martinasobotkova5/my_data_projects/README.md

# my_data_projects
## List of my projects
- Spotify music
- Hockey scrapping
- E6 – infiltrace do zmrzlé zeminy: revize schématu, výpočty a výkresy (`e6_frozen_infiltration/`)
- E7 – zatěžovací zkoušky při mrznutí a tání: dvě varianty, rám, cela PETG-CF (`e7_frost_heave_load/`)
