martinasobotkova5/my_data_projects/e7_frost_heave_load/README.md

# E7: zatěžovací zkoušky zeminy při mrznutí a tání

Vzorek ⌀100 × 100 mm (vnitřní) v plné cele z PETG-CF vytištěné 3D tiskem v jednom kuse, v truhlicovém mrazáku z E6 s programovatelným regulátorem. V obou variantách je **stejný vzorek** (nenasycený písek) a stejná cela. Varianta A má přitížení **závažím** (ocelové kotouče, max. 25 kPa) a měří tlaky uvnitř písku. Varianta B je **bez zatížení** a měří zdvih, sednutí a deformace po vrstvách mezi mrznutím a táním.

## ★ Aktuální návrh: varianta C, měření deformace 1 + 2 (výkresy V01–V05)

**Statika, CR850 a postup (9. 11. 2026):** rám ověřen na únosnost (rezerva > 20×), rozhoduje stabilita → podélníky 320 mm, nohy ±140 (`vypocty.md` §17); datalogger CR850 – plán kanálů §18; rizika měření a postup přípravy, vložení a výměny vzorku v `postup_zkousky.md` (nové tištěné pomůcky P09 středicí víčko, P10 stěrka, P11 parkovací vidlice); poptávka rámu u ENPRAG v `poptavka_ramu.md`.

**Revize B3 (9. 11. 2026):** celý rám z hliníkových T-profilů drážka 8 řezaných na délku – 2 podélníky 40×40, příčka 40×80 (nese 3 podložky G10), 2 sloupy 40×80, horní příčník 40×80 s jediným otvorem ⌀14; pouzdro ložiska visí pod příčníkem, spoje úhelníky a vkládací T-matice. Laserem řezané desky L01/L02 odpadly. Výkresy profilů T01–T04 ve `vyroba/vykresy`.

**Revize B2 (27. 10. 2026):** sestava jen z koupených, laserem řezaných a 3D tištěných dílů (bez obrábění) – objednávka po obchodech a postup sestavení v `objednavka.md`, výrobní list V06, DXF v `vyroba/laser`, STL v `vyroba/tisk`.

**Revize B (27. 10. 2026, podle posudku měření `E7_review.pdf`):** cela tištěná vcelku ⌀240 × 200 s izolací (+40 mm stěna a dno z nízké výplně,
3 podložky G10 v kapsách dna → mrznutí shora), LVDT a referenční terčík kamery na sloupku z Invaru, vodicí tyč z Invaru v kluzném pouzdře
igus drylin, laser pod 66° vedle horního příčníku, 200 mm od povrchu (DOE253 3,1°/31°: čáry po 11,9 mm, 111 mm dlouhé, bez stínu límce), RPi 5 v boxu kamery (snímky podle hodin NTP),
čidlo vzduchu 109 povinně, ventilátor, SHT45, vážení cely. Mezera pod příčníkem 200 → 160 mm, celková výška beze změny.
Pt100 jde ze stejné strany jako TDR a nasedá uprostřed přímo nad horní tyčku (bod M v jednom místě, povrch volný).
Rozhodnuto 9. 11. 2026: nasycení vzorku Sr = 0,5 (θ ≈ 0,19) → zdvih nanejvýš desítky µm, měří se hlavně sednutí při tání; Pt100 osa 3,5 mm nad horní tyčkou, hrot 30 mm od stěny. Výpočty §15 v `vypocty.md`,
simulace `src/sim_thaw.py` (`--bare` = původní cela pro srovnání), nákup `purchase_list.md` / `nakup_cidel.md`.

| list | obsah |
|---|---|
| **V01** | sestava C: Al rám jen vede mrtvou váhu na částečném pístu ⌀50, volný povrch, tabulka zatížení, díly |
| **V02** | měření deformace: (1) kamera + vícečárový laser 11 čar → mapa výšek **celého povrchu**, (2) LVDT na zátěži; vyhodnocení a postup |
| **V03** | tištěná cela ⌀160 s bodem M (CS645, vlákno, Pt100 v mezikruží mimo laser) |
| **V04** | čidla ke koupi, zapojení CR850, ceny (≈ 1,3–2,1 tis. €) |
| **V05** | rig C v mrazáku, kontrola výšky |

- Žádné tlakové snímače ani kotvy – zatížení je známá mrtvá váha, deformace se měří jen (1) a (2).
- 3D: `3d/E7_V01_variant_C.step` (+ díly `3d/parts_V01_variant_C/`), `3d/E7_V03_cell.step`, `3d/E7_V05_freezer_layout.step`; CAD cely `cad/E7_V04_cell.dxf`.
- Starší varianty A a B: `vykresy/archiv/`, `3d/archiv/` (kapitoly 1a–8 níže popisují i je).

Regenerace výkresů: `cd src && python vykresy_c.py` (aktuální sada), `python vykresy.py` (archiv).

| soubor | obsah |
|---|---|
| `vykresy/E7_drawings.pdf` | 9 listů A3, anglicky (V09 = varianta C, kombinace): V01 přehled A a B · V02 A s víkem na táhlech · V03 A s Al rámem · V04 tištěná cela + bod M · V05 B s kotvami · V06 B otevřený povrch (kamera + laser) · V07 čidla a CR1000 · V08 mrazák |
| `cad/E7_V04_cell.dxf` | **CAD výkres cely ⌀160 se všemi kótami** (DXF, kóty jako DIMENSION, vrstvy OUTLINE/DIM/SENSOR…; tisk A3 1 : 1,5) + PDF/PNG náhled |
| `3d/*.step` | 3D sestavy pro Onshape: varianta A, varianta B, samotná cela, obě v mrazáku (+ STL a PNG náhledy) |
| `vypocty.md` | zatížení, očekávané deformace, rozlišení LVDT, teplotní chyba stojanu, napětí v cele, závaží |
| `src/params.py` | všechny rozměry a předpoklady |
| `src/sensors.py` | výběr čidel a plán kanálů (varianta C: CR850, §18 v `vypocty.md`) |
| `src/vykresy.py`, `src/vypocty.py`, `src/model3d.py`, `src/render3d.py` | generátory |

> Kapitoly 2–3 a 6–8 popisují i starší řešení varianty A (závaží, vícekroužková/plná cela); aktuální návrh je v kap. 1a–1c, 4a, 5, 5a a na výkresech V01–V08.

Regenerace: `cd src && python cad_cell.py && python vykresy.py && python vypocty.py > ../vypocty.md && python model3d.py && python render3d.py`

---

### 3D animace mrznutí a tání (web/)

`web/E7_thaw_3d.html` – hýbající se 3D model sestavy C (otevřít v prohlížeči): teplota na řezu vzorkem a na volném
povrchu kolem pístu, fronta tání (0 °C), podíl ledu, zdvih povrchu a pístu (zvětšeně), pohled kamery RPi.
Data z `src/sim_thaw.py` (osově souměrné vedení tepla, entalpická metoda; vlastnosti písku a cely odhadnuté, viz hlavička
skriptu). Program: +10 °C → 0 h vzduch −10 °C → 24 h vzduch +10 °C. Výsledek modelu: vzorek zmrzne za ≈ 9 h, roztaje
≈ 9 h po přepnutí na +10 °C; píst (Al, ≈ 95 J/K) zpožďuje tání písku pod sebou. Zdvih = jen 9 % objemu ledu → horní odhad.
Znovu vytvořit: `python src/sim_thaw.py` (šablona `web/thaw_3d_template.html`).

## 1. Dvě varianty

| | **A – konstantní přitížení** (E7-V01) | **B – bez zatížení** (E7-V05) |
|---|---|---|
| vzorek | nenasycený písek ⌀100 × 100 (Sr ≈ 0,3–0,5) | **stejný** |
| cela | plná, 3D tisk PETG-CF v jednom kuse, PTFE fólie 0,5 mm + silikonový tuk | **stejná** |
| zatížení | **závaží** 5–25 kPa (ocelové kotouče ⌀150 na nosné desce s vodicí tyčí) | **žádné** – jen lehká horní deska PETG-CF (≈ 0,08 kPa) |
| co se měří | tlaky uvnitř písku, u dna a na stěně; LVDT kontrolují, že se vzorek nehýbe | zdvih při mrznutí, sednutí při tání, nevratná deformace za cyklus, poměrné deformace 4 vrstev po 25 mm |
| snímače posunu | 2× LVDT ±10 mm s pružinou | 6× LVDT ±5 mm s **volným jádrem**: S1–S3 na horní desce, E1–E3 na kotvách v hloubce 25/50/75 mm |
| rám | lehký 40×40, sloupy 410 mm, příčka s lineárním ložiskem | **žádný** – jen 3 Invarové sloupky a Al můstek s LVDT |
| termistory | T1–T5 v písku, Ttop, Tbot, Tw, Tframe, Tair | T1–T5 v písku, Ttop, Tbot, Tstand, Tair |
| **bod M** | **TDR + Pt100 + optické čidlo (FBG)** v jednom místě | **stejně** |

Obě varianty sdílejí základovou desku, Al distanční kus, mezikus G10, podstavec s porézním kamenem, tištěnou celu, termistory T1–T5 a bod M (TDR + Pt100 + optické čidlo). Výsledky A a B jsou tak přímo srovnatelné: rozdíl je jen v přitížení.

**Proč závaží (A):**
- Gravitace dává přesně konstantní přitížení. Nezávisí na posunu vzorku ani na smrštění rámu v mrazu.
- Není potřeba siloměr ani dotahování. Rám jen vede tyč a nese LVDT, takže nic nezatěžuje.
- Do 25 kPa je to 20 kg, tedy 3 plné a 1 poloviční kotouč (výška 126 mm). To se do mrazáku vejde.

## 1a. Varianta A-min – zjednodušená varianta A s nehybným víkem (E7-V02, `vypocty.md` §9)

Stejný písek a stejná tištěná cela jako A. Vzorek je nahoře **pevně sevřený**, takže se nemůže zvednout ani posunout; při mrznutí se měří tlak, který přitom vznikne. TDR, teplotní čidlo a optické vlákno už v laboratoři máte – jsou v bodě M a v ceně nejsou.

**Sestava (zdola nahoru):**
1. Al deska 230 × 230 × 20 na vaně mrazáku; nese 3 táhla a sloupek LVDT.
2. PB1 zapuštěný do tištěného dna cely (dno 26 mm).
4. **Tištěná cela ⌀160 podle vašeho výkresu** (Column_one_body_version_1, kap. 1c) – plášť s 10 % výplní je zároveň izolace, Kaiflex ani G10 už nejsou potřeba.
5. Písek ⌀100 × 100: bod M v hloubce 36–54 mm (TDR CS645 + optické vlákno + Pt100), PV1 na ose v hloubce 75 mm (pod TDR), volitelně T1 (20 mm) a T2 (80 mm).
6. Plný Al píst ⌀99,5 × 40 – zajede do límce cely (34 mm volného místa nad pískem).
7. **Ocelové víko ⌀240 × 15 na 3 nerezových táhlech M10** (r 92, 45/165/285°, vně těla ⌀160).
8. **Středový šroub M16 × 1,5 s pojistnou maticí:** dotáhnout, až PV1 ukáže ≈ 5 kPa (dosednutí), a zajistit. Pak se už nic nehýbe.
9. Jeden LVDT na víku (na sloupku v rohu desky) – dokládá, že se víko opravdu nepohnulo.

**Je to opravdu nehybné? (`vypocty.md` §9)**
- Při 1 MPa (horní mez) se táhla protáhnou o ≈ 49 µm a víko prohne o ≈ 60 µm → píst se posune o ≈ 0,1 mm. Při 200 kPa jen ≈ 20 µm.
- Nerezová táhla a vnitřní sestava se při ochlazení o 20 K zkrátí skoro stejně (rozdíl ≈ 16 µm), takže teplota sama vzorek nestlačí ani neuvolní.
- Napětí: táhla 45 MPa, víko ≈ 70 MPa – velká rezerva.

**Co odpadá proti variantě A:** rám, závaží, nosná deska, vodicí tyč, kulička, terčík, Invarové sloupky, druhý LVDT, 4 ze 6 tlakových snímačů, porézní kameny, podstavec a oba multiplexery.

**Co je potřeba koupit (EUR bez DPH, orientačně):**

| tag | měří | typ | ks | cena | zdroj ceny | CR1000 |
|---|---|---|---|---|---|---|
| PV1, PB1 | tlak v písku a u dna | **TML PDA-PA 500 kPa** (⌀6,5 × 1 mm), PV1 na disku ⌀20 × 2 | 2 | 1 200–2 000 | odhad – poptat Althen / Elkome | DIFF1, DIFF2, BrFull, VX1 |
| LVDT | kontrola, že se víko nehýbe | **RDP DCTH400AG** (±10 mm) | 1 | 581 | web: Elkome 581 € | SE9 |
| | zdroj pro LVDT | zdroj na DIN lištu | 1 | 40–80 | odhad | – |
| T1, T2, Tair | teplota 20/80 mm, vzduch – **volitelně** | **Campbell 109SS-L** | 3 | 540–780 | odhad | SE11–13, Therm109, VX3 |
| | mechanika | cela, fólie, izolace, Al díly, víko, táhla, šroub, sloupek | – | 340–690 | odhad | – |
| | **celkem** | | | **≈ 2 700–4 100 € (≈ 68–103 tis. Kč)** | | |

Bez termistorů T1/T2/Tair je to ≈ 2 200–3 400 €.

**Už máte (bez ceny):** TDR Campbell CS645 s reflektometrem, Pt100 (37 mm) a optické vlákno v bodě M a datalogger CR1000.

- **Rozsah tlakových snímačů:** při zamezeném zdvihu může tlak v písku překročit 200 kPa, proto PDA-PA 500 kPa (rozsah ověřit u TML – řada má 200 kPa až 3 MPa). Rozlišení na CR1000 je i tak ≈ 0,2 kPa.
- **Ceny jsou orientační.** Výrobci (TML, Campbell) ceny nezveřejňují; „web“ = cena nalezená u prodejce v říjnu 2026. Před objednávkou poptat TML přes Althen Sensors nebo Elkome, Campbell přes Campbell Scientific Europe, RDP přes Elkome.

**Zdroje cen:**
- [Elkome – RDP DCTH400AG, 581 €](https://shop.elkome.com/en/sensors/lvdt-sensors/lvdtanturi)
- [Bestech – TML PDA-PA (parametry, rozsah 2–30 bar, bez ceny)](https://www.bestech.com.au/product/pda-pa-waterproof-miniature-pressure-gauge/)
- [Campbell Scientific – 109SS (cena po přihlášení)](https://www.campbellsci.com/order/109)

## 1b. Varianta A-rám – nehybný píst v rámu z Al profilů (E7-V03, `vypocty.md` §10)

Stejný vzorek, cela, čidla a bod M jako A-min. Rozdíl je jen v tom, co drží píst: místo víka na táhlech je to **rám z Al profilů**.

**Sestava:**
- Al deska 260 × 200 × 25 na 3 stavitelných nožkách, 2 sloupy 40×80 × 245 mm (osově 220 mm), příčník 80×80 × 260 mm; spoje šrouby do čela profilů, žádné úhelníky.
- Uvnitř stejně jako A-min: tištěná cela ⌀160 s PB1 ve dně, písek s bodem M a PV1, Al píst ⌀99,5 × 40.
- Na pístu Al sloupek ⌀40 × 51 a **vložka POM-C ⌀40 × 8**, nad ní šroub M16 × 1,5 v příčníku s pojistnou maticí a ručním kolem.
- LVDT stojí na sloupku pod úhlem 300° (mimo sloupy rámu i kanál cely) a měří přímo horní okraj pístu.

**Jak to funguje:** šroubem se píst dotáhne, až PV1 ukáže ≈ 5 kPa, a matice se zajistí. Rám pak píst drží na místě a při mrznutí se měří tlak (PV1, PB1), teplota a nezamrzlá voda (bod M). LVDT ukazuje, že se píst nepohnul.

**Je to nehybné?**
- Při 1 MPa: příčník 18 µm, sloupy 13 µm, sloupek + POM 36 µm, spoje profilů 10–80 µm → celkem ≈ 0,08–0,15 mm. Při 200 kPa pětkrát méně. Rozhodují spoje – šrouby do čela dotáhnout momentem.
- **Teplota:** Al sloupy se v mrazu zkrátí víc než vnitřní sestava (písek má menší roztažnost) a bez úpravy by vzorek stlačily falešným tlakem několika desítek kPa. Vložka POM-C 8 mm (roztažnost ≈ 110·10⁻⁶ 1/K) to vyrovná na ≈ 0 µm (`vypocty.md` §10). Odhad roztažnosti zmrzlého písku ověří slepá zkouška s Al náhradou vzorku.

**Srovnání s A-min:**

| | A-rám | A-min (táhla) |
|---|---|---|
| co drží píst | rám 40×80 + 80×80, šroub | ocelové víko na 3 táhlech M10 |
| posun pístu při 1 MPa | ≈ 0,08–0,15 mm | ≈ 0,11 mm |
| teplotní chyba (20 K) | ≈ 0 (vložka POM-C) | ≈ 16 µm |
| přístup ke vzorku | otevřené boky, šroub shora | víko se musí sundat |
| mechanika | ≈ 385–780 € | ≈ 340–690 € |
| čidla ke koupi | 2 360–3 440 € (stejná) | 2 360–3 440 € |
| **celkem** | **≈ 2 750–4 220 € (≈ 69–106 tis. Kč)** | **≈ 2 700–4 130 €** |

Čidla ke koupi jsou stejná jako v A-min (2× TML PDA-PA, LVDT RDP DCTH400AG se zdrojem, volitelně 3× 109SS-L); TDR, teplotní čidlo, optické vlákno a CR1000 už máte. Ceny jsou orientační – viz kap. 1a.

## 1c. Tištěná cela A – podle výkresu Column_one_body_version_1 (E7-V04, `vypocty.md` §11)

Podle výkresu M. Vrány (23. 6. 2026) a náčrtu čidel:

- **Tělo** ⌀160 × 130 mm, nahoře **límec** ⌀106 (stěna 3 mm) do výšky 160 mm, **dutina** ⌀100, dno 26 mm (zaoblení dna ⌀10).
- **Písek** 100 mm (z = 26–126), nad ním 34–35 mm pro píst.
- **Boční kanál** 13 mm široký ve výšce 67,5–94,5 mm – vede jím TDR a optické vlákno.
- Plášť s 10 % výplní je zároveň tepelná izolace (tisk PrusaSlicer, MK4S, ≈ 600 g, 21 h).

**Bod M (vaše čidla):**
- **TDR Campbell CS645** vodorovně kanálem: 3 tyčky ⌀3,2 × 75 mm (naměřeno 77), rozteč 8,9 mm, hlava 19 mm v kanálu; hlava vyplňuje kanál (horní hrana ≈ 66 mm pod límcem), tyčky jsou symetricky uprostřed kanálu, tj. v hloubce ≈ 36 / 45 / 54 mm pod povrchem písku. Tyčky procházejí osou vzorku.
- **Optické vlákno** vodorovně v úrovni horní tyčky, hrot 37,5 mm od stěny.
- **Pt100** svisle shora, 37 mm (25 mm kov), 15 mm od osy – kabel vede drážkou pod pístem a otvorem ⌀4 ve stěně.
- Všechna tři tedy měří vrstvu 35–55 mm pod povrchem. **Otevřené:** měří Pt100 ve špičce, nebo po celé délce (poznámka 7. 7. 26)?

**Co se kvůli tomu změnilo ve variantě A:** PV1 je přesunutý do hloubky 75 mm (TDR prochází osou v 36–54 mm), G10 a Kaiflex odpadly, táhla jsou na r 92 (vně těla ⌀160), vložka POM-C v rámu je 8 mm.

**Doporučení k tisku (`vypocty.md` §11):**
- pod dutinou (z 0–26) **100 % výplň** – dno nese celý tlak z mrznutí; 10 % gyroid by se při ≈ 1–2 MPa promáčkl;
- kolem dutiny stěnu **≈ 5 mm (≈ 8 perimetrů)** – samotná 3mm stěna má při 200 kPa ≈ 3 MPa, při 1 MPa ≈ 17 MPa obvodového napětí;
- uvnitř epoxid + PTFE sprej + silikonový tuk (tření o stěnu).
- Otvory: PV1 kabel ⌀3,5 (z = 51, 90°), PB1 drážka ve dně + otvor ⌀3,5 (288°), Pt100 kabel ⌀4 (z ≈ 125, 0°), volitelně T1/T2 ⌀2.

## 1d. Varianta C – kombinace A + B: mrtvá váha na částečném pístu, volný povrch, kamera (E7-V09, `vypocty.md` §14)

Spojuje hliníkový rám z varianty A a kameru s laserem z varianty B. Zatížení je **gravitační a konstantní**: celá zátěž leží na písku a s povrchem se volně pohybuje nahoru (zdvih) i dolů (tání).

- **Rám** (deska 260 × 200 × 25, sloupy 40×80 × 326, příčník 80×80) zátěž **jen vede**: kuličkové pouzdro LM12UU v příčníku drží tyč ⌀12 svisle, nic nezamyká. Tření < 0,05 kPa.
- **Částečný píst** Al ⌀50 × 20 uprostřed (25 % plochy) přes kuličku ⌀8 nese tyč, nosnou desku a ocelové kotouče ⌀120 nad příčníkem (volný zdvih ±25 mm). Pevná část ≈ 0,6 kg ≈ 3 kPa; 5 / 10 / 15 / 20 / 25 kPa = 1 / 2 / 3 / 4 / 5 kg (0–4 kotouče po 1 kg + doladění).
- **Volný povrch:** mezikruží 25 mm kolem pístu nic nezatěžuje.
- **Kamera** (RPi HQ, vyhřívaný box) visí pod příčníkem na straně −y, skloněná o 27°; **čárový laser** z +y pod 45° promítá jednu čáru napříč: límec – volný písek – píst – volný písek – límec. V jednom snímku je tak zdvih zatížené části (horní plocha pístu) i volného povrchu, límec je reference.
- **Tlak pod patkou:** PV1 na ose v hloubce 75 mm, PB1 ve dně. **Bod M** jako dřív, Pt100 přesunut do mezikruží (r 37,5). Volitelně LVDT na nosné desce.
- Výška sestavy ≈ 520 mm nad spodkem desky (mrazák ≈ 650 – změřit).
- 3D: `3d/E7_V09_variant_C_combined.step` (+ díly v `3d/parts_V09_variant_C_combined/`).

## 2. Přitížení závažím (varianta A, E7-V01, `vypocty.md` §7)

**Sestava shora dolů:**
- vodicí tyč ⌀16 v lineárním kuličkovém ložisku v příčce rámu (jen vedení, žádná síla);
- ocelové kotouče ⌀150 se středovým otvorem ⌀18: plný 36 mm ≈ 4,92 kg, poloviční 18 mm ≈ 2,46 kg;
- nosná deska ⌀150 × 10 (1,39 kg) s pevně spojenou tyčí ⌀16 × 230 (0,36 kg);
- tepelný mezikus G10 ⌀60 × 10;
- kulička v kuželových sedlech a píst s porézním kamenem (≈ 1 kg, zvážit).

Pevná část (píst, nosná deska, tyč) ≈ 2,75 kg ≈ **3,4 kPa**, to je nejmenší možné přitížení.

| přitížení [kPa] | celkem [kg] | plné kotouče | poloviční | doladit [kg] |
|---|---|---|---|---|
| 5 | 4,0 | 0 | 0 | 1,25 |
| 10 | 8,0 | 1 | 0 | 0,33 |
| 15 | 12,0 | 1 | 1 | 1,88 |
| 20 | 16,0 | 2 | 1 | 0,96 |
| 25 | 20,0 | 3 | 1 | 0,04 |

**Postup:** všechno, co leží na vzorku, zvážit na váze (±10 g ≈ ±0,01 kPa) a doladit tenkými kotouči nebo podložkami. Kotouče pokládat na nosnou desku pomalu, bez rázu.

**Tepelná setrvačnost:**
- Závaží 20 kg má tepelnou kapacitu ≈ 8,7 kJ/K, vzorek jen ≈ 1,6 kJ/K. Časová konstanta je ≈ 5,5 h.
- Program regulátoru mění teplotu jen o ≈ 0,1 K/h, takže závaží za vzduchem zaostává jen o ≈ 0,6 K.
- G10 mezikus omezí tok tepla ze závaží do pístu. Volitelně obalit kotouče izolací 10 mm. Teplotu závaží logovat (Tw).

**Kdy závaží nestačí:** nad ≈ 25 kPa (max. ≈ 50 kPa = 40 kg) roste výška i tepelná hmota. Pro 50–200 kPa je náhradou předepnutá pružina se šroubem a siloměrem (ISO 10243, 20 nebo 80 N/mm), viz historie repozitáře.

## 3. Tlaky uvnitř vzorku (varianta A)

| značka | co měří | umístění | čidlo |
|---|---|---|---|
| PV1 | svislé napětí v písku | na ose, hloubka 40 mm | TML PDA-PA 200 kPa vlepený do nerezového disku ⌀20 × 2 mm |
| PH1 | radiální napětí v písku (volitelné) | r 25, hloubka 62 mm, disk na výšku | totéž |
| PB1 | svislé napětí u dna | v patce, lícem s porézním kamenem, r 25 | TML PDA-PA v pouzdře ⌀8, zapuštěný |
| PW1–PW3 | boční tlak na stěnu | v kroužcích, hloubky ≈ 20 / 42 / 64 mm | TML PDA-PA v pouzdře ⌀8, lícem s vnitřní stěnou |

O kolik tlak při mrznutí vzroste nad přitížení, tolik vytváří led v pórech.

**Proč TML PDA-PA:**
- Jako jediný miniaturní snímač má podle katalogu kompenzaci do −10 °C (provoz −20 … +70 °C). Je to destička ⌀6,5 × 1 mm, 0,8 mV/V, 350 Ω.
- Kyowa BEC-A (⌀30 mm) je alternativa jen pro jednu buňku. Tloušťku a teplotní rozsah se nepodařilo potvrdit.
- TML KDE/KDF (⌀50 mm) jsou na vzorek ⌀100 mm příliš velké.
- Údaje jsou z katalogových stránek podle vyhledávání. Datasheety jsem nemohl otevřít, před objednáním ověřit.

**Zásady z literatury** (Weiler & Kulhawy 1982; Labuz & Theroux 2005, doi:10.1520/GTJ12089; Talesnick 2005):
- **Málo malých inkluzí:** poměr průměr/tloušťka ≥ 10 a průměr / d50 ≥ 20 (disk ⌀20 v písku d50 0,3 mm → ≈ 65). Proto jen 2 vložené disky a ostatní snímače v lícu stěny a dna.
- **Kalibrace v písku:** ve stejném písku a cele, pod známým přitížením 5–25 kPa (závaží), zatížení i odlehčení, při +10 a −10 °C.
- **Teplota:** u každého snímače termistor a korekce nuly podle teploty. Zeng et al. (2022, doi:10.6052/1000-0879-21-231) ukázali při cyklech mrznutí a tání teplotní posun a degradaci miniaturních buněk.
- **Led na snímačích:** snímače utěsnit silikonem nebo epoxidem.
- **Sání v nenasyceném písku:** tenziometry v mrazu zamrznou. Před zmrazením změřit sání (tenziometr nebo filtrační papír) a pak ho odhadovat z teploty (Clapeyron) nebo z obsahu nezamrzlé vody (TDR).

## 4. Cela – plná, 3D tisk z PETG-CF (obě varianty, E7-V04)

- **Tvar:** trubka ⌀117/101, výška 125 mm, patka ⌀150 × 8 se zaoblením R4, tištěno nastojato v jednom kuse. Nad vzorkem zůstává 25 mm pro píst (A) nebo horní desku (B).
- **Vnitřek:** stěna utěsněná tenkou vrstvou epoxidu, pak PTFE fólie 0,5 mm (spoj natupo na 180°) a silikonový tuk → vnitřní ⌀100.
- **Termistory:** 5 nálitků 8 × 10 mm s otvorem ⌀1,7 v hloubkách 10/30/50/70/90 mm pod úhly 0/72/144/216/288°. Hroty v obou variantách na r 40 mm (mimo bod M a tyčky kotev).
- **Snímače na stěně PW1–3:** pouzdra ⌀8 v nálitcích, líc se snímačem zarovnaný s fólií (fólie má v těch místech výřezy ⌀8). Ve variantě B jsou volitelné.
- **Izolace:** Kaiflex 25 mm (vnější r 83,5) s výřezy pro nálitky. Vejde se mezi sloupy rámu A (r 90) i dovnitř Invarových sloupků B (r 100).
- **Bod M:** jeden širší nálitek 34 × 22 mm v hloubce 54 mm pod úhlem 108° pro TDR, Pt100 a optické čidlo (kap. 4a).
- **Cela není přišroubovaná**, jen leží patkou na podstavci. Tření pak stěnu tlačí, ale netrhá vrstvy tisku od sebe.

**Tření o stěnu (`vypocty.md` §5):** u plné cely odnese část přitížení stěna. To vícekroužková cela řešila, plná cela ne, proto je fólie s tukem povinná.

| rozhraní | μ | σv u dna / na povrchu |
|---|---|---|
| PTFE fólie + silikonový tuk | ≈ 0,05 | 0,89–0,92 |
| PTFE fólie nasucho | ≈ 0,10 | 0,79–0,85 |
| bez fólie (písek–PETG) | ≈ 0,5 | 0,30–0,45 |

- **A:** PV1 (40 mm) a PB1 (dno) vyhodnocovat jako profil σv(z), ne jako jednu hodnotu. Rozdíl mezi nimi přímo ukáže tření.
- **B:** přitížení je nulové, takže tření je malé. Zmrzlá horní vrstva ale může přimrznout ke stěně a brzdit zdvih. PTFE má ze všech běžných materiálů nejmenší adhezi ledu.

## 4a. Bod M – TDR, Pt100 a optické čidlo ve stejném místě (obě varianty, E7-V04 detail M, `vypocty.md` §8)

Všechna tři čidla vstupují vodorovně **jedním nálitkem** ve stěně cely, rovnoběžně, a měří stejnou vrstvu písku ve stejném okamžiku promrzání. Poloha je v obou variantách stejná: **hloubka 54 mm pod povrchem, r ≈ 25 mm, úhel 108°** (mezi termistory T2 a T3, mimo kotvy B a tlakové snímače A; kolize zkontrolované v 3D).

| čidlo | provedení | poloha v bodě M | měří | připojení |
|---|---|---|---|---|
| **TDR** | mini 3-tyčková sonda, nerez ⌀1,6 × 40 mm, tyčky nad sebou po 5 mm (hloubky 49/54/59), epoxidová hlava v nálitku | od stěny (r 50) po r 10 | objemová vlhkost, ve zmrzlém stavu **nezamrzlá voda** | koax → SDMX50SP → **TDR200** (SDM C1–C3) |
| **Pt100** | 1/10 DIN, 4vodičové, plášť ⌀3, element 10 mm u hrotu | 12 mm vedle roviny TDR, element r 20–30 | referenční teplota (±0,03 °C při 0 °C) | **4WPB100** → MUX-1 (BrHalf4W) |
| **optické čidlo** | FBG (Braggova mřížka) v nerezové kapiláře ⌀1, mřížka 10 mm u hrotu (bez vlivu deformace) | 12 mm na druhé straně, mřížka r 20–30 | teplota optickou cestou | vlákno ven z mrazáku → interrogátor (HBM FS22 / Luna si155 [ověřit]) na PC |

- **Proč takhle:** kovový plášť Pt100 a kapilára FBG jsou 12 mm od tyček TDR, tj. mimo jeho citlivý objem (≈ 1–1,5× rozteč 5 mm). Přitom všechna tři čidla leží ve stejné hloubce a ve stejném pásu ±12 mm.
- **Co z toho vznikne:**
  - Pt100 je **teplotní reference**: v cele přes ni zkalibrujete FBG i termistor T3 (ledový bod při tání);
  - TDR proti teplotě Pt100 dá **křivku nezamrzlé vody θu(T)**, tedy charakteristiku mrznutí písku;
  - totéž ve variantě A (přitížení 25 kPa) a B (bez zatížení) → vliv přitížení na mrznutí ve stejném bodě.
- **TDR v malém vzorku:** tyčky 40 mm jsou na hranici (dvojí doba běhu jen ≈ 0,5–0,8 ns). Rozlišení vlhkosti je i tak ≈ 0,005, ale je potřeba průměrovat průběhy a sondu kalibrovat přímo v tomto písku. Campbell CS645 (75 mm) je na ⌀100 příliš dlouhá.
- **Montáž:** tyčky TDR a Pt100/FBG se zasunou otvory ve stěně a ve fólii do už uloženého písku (nebo se písek ukládá kolem nich). Hlava TDR zalepená v nálitku, Pt100 a FBG utěsněné silikonem.
- **Optické čidlo:** předpokládám teplotní FBG. Pokud máte jiný typ (fluorescenční sonda, např. Opsens OTG-F s analogovým výstupem do CR1000, nebo distribuované měření DTS), poloha zůstane stejná, změní se jen průměr otvoru a připojení.

## 5. Varianta B – posuny a deformace mezi mrznutím a táním (E7-V05, `vypocty.md` §1–4)

**Sestava (aktualizováno – stejná tištěná cela ⌀160 a bod M jako varianta A):**
- **Cela:** tištěné tělo ⌀160 podle výkresu Column_one_body_version_1 (kap. 1c, E7-V04) stojí přímo na Al desce 260 × 200 × 20; tištěné dno 26 mm izoluje, G10 ani podstavec nejsou potřeba.
- **Bod M:** stejně jako v A – TDR CS645 kanálem (tyčky v hloubce 36 / 45 / 54 mm), optické vlákno v úrovni horní tyčky, Pt100 svisle 15 mm od osy; jeho kabel vede otvorem ⌀6 v horní desce.
- **Horní deska** PETG-CF ⌀99 × 6 (≈ 65 g, 0,08 kPa) leží na písku uvnitř límce – jen terč pro LVDT.
- **3 povrchová LVDT S1–S3** (r 40, úhly 0/120/240°) → průměrný zdvih/sednutí + náklon.
- **3 kotvy E1–E3** v hloubce 25 / 50 / 75 mm (r 25, úhly 150/30/210°): nerezový kotouček ⌀16, Invarová tyčka ⌀2 v PTFE trubičce, nahoře LVDT. Úhly jsou zvolené tak, aby kotvy a tyčky byly ≥ 14 mm od tyček TDR, vlákna a Pt100 (zkontrolováno v 3D).
- **LVDT s volným jádrem** (bez pružiny) – na vzorek netlačí.
- **Reference:** Al můstek ⌀220 × 10 na 3 Invarových sloupcích ⌀12 (r 100, vně těla ⌀160), délka 196 mm. Tlakové snímače na stěně (PW) ve variantě B odpadly.

**Co se vyhodnocuje v každém cyklu:**

| veličina | výpočet |
|---|---|
| zdvih povrchu při mrznutí | S̄ = (S1 + S2 + S3)/3, od začátku mrznutí do konce |
| sednutí při tání | pokles S̄ během tání |
| nevratná deformace za cyklus | S̄ na konci tání − S̄ na začátku cyklu |
| deformace vrstev 0–25 / 25–50 / 50–75 / 75–100 mm | Δh₁ = S̄ − E1, Δh₂ = E1 − E2, Δh₃ = E2 − E3, Δh₄ = E3 (dno pevné); εᵢ = Δhᵢ / 25 mm |
| hloubka promrzání | izoterma 0 °C z T1–T5 → deformace zmrzlé vs. nezmrzlé vrstvy v čase |
| po posledním cyklu | výška vzorku (posuvka), hmotnost, vlhkost 5 plátků po 20 mm (přesun vody) |

**Co čekat (`vypocty.md` §2):**
- Horní mez zdvihu z rozpínání vody je 1,0–1,7 mm, ale v nenasyceném písku má led dost místa ve vzduchových pórech. Celkový zdvih bude spíš v desetinách mm.
- Voda se ale může přesouvat k čelu promrzání: horní vrstva nabobtná, spodní se vysuší a smrští. Povrchové LVDT by to nerozlišilo, proto kotvy po vrstvách.
- Při tání se ukáže nevratné zhutnění. To je hlavní výsledek pro porovnání cyklů.

**Přesnost (`vypocty.md` §3–4):**
- LVDT ±5 mm na CR1000: rozlišení ≈ 0,7 µm, poměrná deformace vrstvy 25 mm ≈ 4·10⁻⁵.
- Teplotní chyba stojanu: tištěné dno a tělo LVDT proti Invaru ≈ 40 µm na 20 K. Odstraní se **slepou zkouškou** s Al náhradou vzorku ve stejném programu (korekce podle Tbot a Tstand). Chyba je společná všem LVDT, takže v rozdílech mezi kotvami se z velké části odečte.
- Linearita LVDT ±0,25 % FS → každý LVDT zkalibrovat mikrometrem.

**Příprava vzorku B:**
1. Vložit TDR CS645 kanálem a vlákno, pak do cely (epoxid + PTFE sprej + tuk) uložit písek po vrstvách 12,5 mm na cílovou hustotu a vlhkost.
2. Po dosažení hloubky 75, 50 a 25 mm pod budoucím povrchem položit kotvu, na ní nasadit tyčku s trubičkou a pokračovat v hutnění (tyčky drží ve svislé poloze šablona nad celou).
3. Zarovnat povrch, položit horní desku přes trubičky, nasadit můstek s LVDT a vynulovat.
4. Mezeru mezi deskou a stěnou cely překrýt volnou PE fólií, aby písek během týdnů nevysychal sublimací.

**Siloměry** nejsou potřeba v žádné variantě. A je zatížená závažím (síla = hmotnost), B není zatížená vůbec.

## 5a. Varianta B-open – otevřený povrch, bezkontaktně: kamera + čárový laser (E7-V06, `vypocty.md` §13)

- Tištěná cela ⌀160 na Al desce 320 × 220 × 10; **na povrchu písku nic neleží** (žádné víko, deska ani terčík).
- **Kamera** (Raspberry Pi HQ + objektiv 12 mm, zorné pole ≈ 115 mm) visí na rameni ≈ 220 mm nad povrchem a dívá se dolů; **čárový laser** 650 nm svítí šikmo pod 45° přes celý povrch i přes horní hranu límce. Oba ve vyhřívaném boxu (+5 °C, dvojité okénko).
- **Laserová triangulace:** když povrch stoupne o Δh, čára se v obraze posune do strany o Δh (při 45°). ≈ 28 µm/px, těžiště čáry na 0,1–0,3 px → ≈ 3–9 µm, reálně ≈ 10 µm. Výsledkem je **celý profil povrchu** napříč vzorkem, ne jen jeden bod; druhý laser otočený o 90° přidá druhý profil.
- **Reference:** část čáry na horní hraně límce ve stejném snímku ruší pohyb kamery a laseru. Límec se sám posune o ≈ 120 µm na 20 K → slepá zkouška s Al náhradou.
- Laser zapínat jen na snímek (každých 10 min), čas synchronizovat s CR1000. Box nad vzorkem přidá ≈ 1 W – vliv ověřit ve slepé zkoušce; lepší je kamera mimo mrazák s okénkem ve víku, pokud to víko dovolí.
- Bod M stejně jako dřív. Otevřený povrch vysychá – celu vážit před a po cyklu.
- **Koupit:** Raspberry Pi 5, HQ kamera, objektiv 12 mm, čárový laser, vyhřívaný box, Al deska a rameno → **≈ 460–770 € bez DPH (≈ 11–19 tis. Kč)**.

**Deformace po vrstvách kamerou (rozšíření):** do stěny cely vytisknout svislé okénko ≈ 20 × 100 mm z PMMA/PC; kamera z boku snímá zrna písku a metodou **DIC/PIV** (např. open-source GeoPIV-RG) se z posunu zrn spočítá svislý posun v každé hloubce → poměrná deformace vrstev bez kotev. Okénko zvyšuje tepelný únik (mezi snímky zakrýt izolační zátkou) a tření o stěnu je u něj jiné; druhá kamera ≈ +150 €.

## 6. Rám A a stojan B (E7-V03)

- **Základ:** v obou variantách základová deska Al 260 × 200 × 25 na 3 stavitelných nožkách.
- **Rám A:** 2 sloupy 40×40 × 410 mm a příčka 40×40 s lineárním kuličkovým ložiskem ⌀16 pro vodicí tyč závaží. Rám nenese zatížení, jen vede tyč a nese Invarové sloupky LVDT.
- **Stojan B:** 3 Invarové sloupky ⌀12 × 250 mm (r 100, 60/180/300°, mimo izolaci), nahoře Al můstek ⌀220 × 10 s děleným upnutím pro 5 LVDT (+1 rezerva). Žádný rám, nic se nezatěžuje.
- **Výška:** nejvyšší bod je vodicí tyč A (≈ 590 mm nad podlahou mrazáku, vč. vany). Sestava B je vysoká ≈ 330 mm vč. desky.
- **Teplota:** rám A přitížení nemění. Stojan B je reference posunu, jeho chyba ≈ 50 µm / 20 K se koriguje slepou zkouškou.

## 7. Vydrží PETG-CF? (E7-V04, `vypocty.md` §5)

**Ano, pro obě varianty.** Pevnost PETG-CF z katalogových listů a literatury: ≈ 40–55 MPa ve směru vlákna nebo vrstvy, jen 15–30 MPa kolmo na vrstvy. Dlouhodobě počítám s ≈ 30 % pevnosti.

| zatěžovací stav (obvodové napětí ve stěně) | napětí | bezpečnost krátkodobě | dlouhodobě |
|---|---|---|---|
| A: přitížení 25 kPa, K0 = 1 | 0,16 MPa | > 250 | > 75 |
| B: tlak ledu na stěnu 200 kPa (horní odhad) | 1,3 MPa | 32–44 | 9–13 |
| extrém 1 MPa | 6,3 MPa | 6–9 | 1,9–2,6 |

Osové napětí přes vrstvy od tření je i bez fólie < 0,05 MPa (A, 25 kPa), tedy zanedbatelné. Cela je volně položená, takže tření stěnu tlačí, netáhne.

Podmínky:
- **Tisk:** nastojato v jednom kuse, stěna 8 mm, pouze soustředné perimetry, 100 % výplň, nálitky se zkosením 45° zespodu (bez podpor). Vrtání ⌀101 ± 0,1 zkontrolovat ve 3 výškách.
- **Vnitřek:** utěsnit tenkou vrstvou epoxidu, aby voda nevnikla do mezer v tisku.
- **Vruby:** žádné tištěné závity ani ostré rohy.
- **Před použitím:**
  1. 10 cyklů mrznutí a tání nasycených vzorků materiálu a pak tahová zkouška;
  2. kontrola průměru ⌀101 při +20 a −10 °C (smrštění 0,06–0,12 mm, píst A má vůli 0,25 mm).

## 8. Čidla a zapojení na CR1000 (E7-V07, `src/sensors.py`)

| měření | doporučeno | alternativy |
|---|---|---|
| posun A (2×) | **RDP DCTH400** – DC-LVDT ±10 mm, výstup ±5 V, −40 … +80 °C | Micro-Epsilon DTA-10D, Solartron AX/10/S, HBM WA-L |
| posun B (6×, volné jádro) | **RDP DCTH200** s volným (unguided) jádrem, ±5 mm [ověřit u RDP] | Micro-Epsilon DTA-5G8, Solartron AX/5/F |
| tlak (A 6×, B 3× volitelně) | **TML PDA-PA 200 kPa** | Kyowa BEC-A (jen 1 buňka), TE EPL (stěna) |
| vlhkost, bod M (2×) | **mini 3-tyčková TDR 40 mm** + Campbell TDR200 + SDMX50SP [ověřit] | Easy Test LP/ms; CS645 je příliš dlouhá |
| referenční teplota, bod M (2×) | **Pt100 1/10 DIN, 4vodič, ⌀3** + Campbell 4WPB100 | – |
| optická teplota, bod M (2×) | **FBG v kapiláře ⌀1** + interrogátor HBM FS22 / Luna si155 [ověřit] | fluorescenční Opsens OTG-F (analogově do CR1000) |
| teplota (≈ 20×) | **Campbell 109SS** – ⌀1,6 mm, ±0,38 °C při 0 °C | Campbell 107 (vzduch, stojan) |

**Nevhodné kvůli mrazu:** TE DC-EC/HCD (provoz od 0 °C), laserové snímače optoNCDT (provoz od 0 °C, námraza na okénku).

| svorky CR1000 | připojeno | poznámka |
|---|---|---|
| SE1–2 | LVDT-A1, A2 | ±5000 mV, vlastní zdroj ±15 V |
| SE3–5 | LVDT S1–S3 (B, povrch) | ±5000 mV |
| SE6–8 | LVDT E1–E3 (B, kotvy) | ±5000 mV |
| DIFF6 + DIFF5 + VX3 + C4/C5 | multiplexer AM16/32B č. 1 (4×16) | 9 tlakových můstků (A 6, B 3) + 2× Pt100 přes 4WPB100 |
| C1–C3 (SDM) + 12V | TDR200 → SDMX50SP | 2 sondy TDR (bod M, A i B) |
| SE13 + VX2 + C6/C7 | multiplexer AM16/32B č. 2 (2×32) | ≈ 20 termistorů |
| – | FBG interrogátor (oba body M na jednom vlákně) | vlastní PC, hodiny synchronizované s CR1000 |
| SE14–16 | rezerva | |

- **Rozlišení:** posun ≈ 1,3 µm (A) a ≈ 0,7 µm (B). Absolutní linearita LVDT → kalibrovat mikrometrem.
- **CR1000:** se už nevyrábí (nástupce CR1000X / CR1000Xe). Stávající stačí, ale musí zůstat mimo mrazák.

## 9. 3D modely pro Onshape (`3d/`)

Číslování odpovídá výkresům V01–V08. Jednotky mm, osa z nahoru.

| soubor | obsah |
|---|---|
| `E7_V02_variant_A_tie_rods.step` | A – víko na 3 táhlech M10 (V02) |
| **`E7_V03_variant_A_frame.step`** | **A – píst držený Al rámem** (V03): deska, 2 sloupy 40×80, příčník 80×80, šroub M16, Al sloupek + POM, píst, cela ⌀160, písek, PV1/PB1, bod M, LVDT |
| `E7_V04_cell.step` | samotná tištěná cela ⌀160 s kanálem, CS645, vláknem a Pt100 (V04) |
| `E7_V05_variant_B_anchors.step` | B – kotvy E1–E3, 6 LVDT na Invarovém stojanu (V05) |
| **`E7_V06_variant_B_open.step`** | **B – otevřený povrch** (V06): deska, cela, bod M, sloupek + rameno 20×20, vyhřívaný box s kamerou a objektivem, čárový laser s držákem |
| **`E7_V09_variant_C_combined.step`** | **C – rám vede mrtvou váhu na částečném pístu ⌀50, volný povrch, kamera + laser** (V09) |
| `E7_V08_freezer_layout.step` | obě sestavy (V03 + V06) na vaně v mrazáku (V08) |
| `parts_V03_variant_A_frame/`, `parts_V06_variant_B_open/` | **každý díl zvlášť** jako STEP – pro výrobní výkresy jednotlivých dílů |

Náhledy: `3d/E7_V0x_*.png` (pohled a řez).

**Import do Onshape a výkresy:**
1. V Onshape *Create → Document*, pak *Import* (ikona šipky) a vybrat `E7_V03_variant_A_frame.step` (a `E7_V06_variant_B_open.step`).
2. V dialogu importu zaškrtnout **„Import as assembly“** – vznikne Part Studio s díly a Assembly se sestavou; názvy dílů zůstanou.
3. Výkres sestavy: na záložce Assembly *+ → Create drawing* (A3, šablona ISO), vložit pohledy (přední, boční, půdorys, řez), kusovník (*Insert BOM*).
4. Výkres dílu: v Part Studiu pravým tlačítkem na díl → *Create drawing of …* a okótovat. Případně importovat jednotlivé STEP ze složky `parts_*`.
5. Barvy a průhlednost (písek, izolace) se přenesou; čidla mají obalové rozměry, závity a drážky profilů nejsou modelované.

## 10. Literatura (ověřeno vyhledáním; DOI jen kde potvrzeno)

- **Konrad & Morgenstern (1980)**, *Can. Geotech. J.* 17: 473–486. Segregační potenciál klesá s přitížením, proto zkoušet více úrovní přitížení.
- **ASTM D5918**: malé přitížení, dva cykly mrznutí a tání, LVDT; norma doporučuje vícekroužkovou celu – u plné cely proto PTFE fólie a vyhodnocení tření.
- **Nixon & Nixon (2015)**, GeoQuébec: tření o stěnu působí jako přitížení až ≈ 35 kPa.
- **Srovnání cel (TRB/CRREL)**: vícekroužkové cely mají menší tření o stěnu než plné; u plné cely je proto nutné tření snížit (fólie, tuk) a změřit (PV1 vs. PB1).
- **Jin et al. (2019)**, *Cold Reg. Sci. Technol.* 157: 119–132, doi:10.1016/j.coldregions.2018.09.011. Cela s vlastní regulací teploty.
- **Hoekstra, Chamberlain & Frate (1965)**, CRREL RR 176: siloměr nad vzorkem měří tlak a zároveň brání zdvihu.
- **Ji et al. (2019)**, *Bull. Eng. Geol. Environ.*, doi:10.1007/s10064-018-1345-z: tlak z mrazového zdvihu závisí na tuhosti omezení.
- **Tlakové buňky:**
  - Weiler & Kulhawy (1982), JGED 108(GT12);
  - Labuz & Theroux (2005), doi:10.1520/GTJ12089;
  - Talesnick (2005), doi:10.1520/GTJ12484;
  - Zeng et al. (2022), doi:10.6052/1000-0879-21-231.
- **PETG v mrazu a vlhku:**
  - Ultimaker PETG TDS;
  - Stan et al. (2019);
  - Economides et al. (2024), doi:10.3390/polym16233336;
  - UMaine MS thesis (2024).

## 11. Otevřené otázky

1. **Program regulátoru:** „Set A“ (rampy 192 h mezi −10 a +10 °C) lze použít přímo. Pro jasné kroky zvážit výdrže na −10 °C a +10 °C.
2. **Směr promrzání:** izolace stěn a G10 pod podstavcem vedou k promrzání hlavně shora. Termostatované koncové desky (Jin et al. 2019) jsou možné rozšíření.
3. **Písek:** zrnitost (d50) a cílová vlhkost / stupeň nasycení určí velikost tlakových disků a rozsah snímačů (200 kPa).
4. **Přitížení A:** stačí 5–25 kPa (závaží)? Pro vyšší přitížení je připravená varianta s pružinou.
5. **Varianta B – uzavřený, nebo otevřený systém?** Návrh je uzavřený (bez přítoku vody). Přívod vody zespodu přes porézní kámen (Mariottova láhev) lze doplnit, zdvih pak bude větší a LVDT ±5 mm může být málo.
6. **Optické čidlo:** jaký typ máte (FBG, fluorescenční sonda, DTS)? Návrh počítá s teplotním FBG v kapiláře ⌀1.
7. **TDR:** máte TDR100/TDR200, nebo jiný přístroj (např. Easy Test)? Podle toho se upraví sonda.
8. **Kotvy:** stačí 3 hloubky (25/50/75 mm), nebo chcete hustší profil (např. 5 kotev po 15 mm s menšími kotoučky)?
9. **Rozměry mrazáku a vany:** prosím změřit. Nejvyšší bod (vodicí tyč A) je ≈ 590 mm nad podlahou mrazáku.

> Výkresy jsou NÁVRH. Profilové hodnoty, hmotnosti závaží a údaje o čidlech jsou katalogové odhady. Ověřit u dodavatele a nechat zkontrolovat konstruktérem.
