martinasobotkova5/my_data_projects/e7_frost_heave_load/sdileni/README.txt

Experiment E7 – variant C rev. B

Unzip the package first, then open E7_overview.html in any web browser (double-click).
3D model of freezing and thawing: E7_3D_model.html (works without internet).
One-page measurement review: E7_review.pdf (also E7_review.html).
Drawings: E7_drawings.pdf (rev. B3, sheets V01–V06). Purchase list: E7_purchase_list.md;
order by shop + assembly (Czech): E7_objednavka_CZ.md. Manufacturing files: vyroba/laser (DXF), vyroba/tisk (STL).
CAD: cad/E7_V04_cell.dxf, 3D: 3d/*.step (Onshape, SolidWorks, FreeCAD).
