martinasobotkova5/my_data_projects/e7_frost_heave_load/poptavky_laser.md

# E7 – poptávky laseru (TME, Picotronic)

**Stav 13. 11. 2026:** Picotronic odpověděl nabídkou A2627918 – DOE253: 3,1° mezi čarami, vějíř 31°; pozice 10 = 1 mW (98,24 €), pozice 20 = 5 mW s nastavitelným ohniskem (104,96 €, doporučeno), doprava 11 €. Sestava upravena: laser 200 mm od povrchu, 66° (`vypocty.md` §19).

Doplňte údaje v hranatých závorkách. Parametry odpovídají sestavě rev. B3 (laser 124 mm nad pískem, 50 mm od osy,
68° k povrchu → vzdálenost k povrchu ≈ 134 mm; 11 čar po 9,6 mm přes celý povrch ⌀100).

---

## 1 · TME (česky) – Laser Components FLEXPOINT s DOE 11 čar

**Komu:** TME Czech Republic s.r.o., Ostrava (IČ 27789021) – e-mail **tme@tme.cz** (uveden v obchodních podmínkách z r. 2019, ověřit), jinak kontaktní formulář / chat na [tme.eu/cz](https://www.tme.eu/cz/)
**Předmět:** Poptávka – laserový modul Laser Components FLEXPOINT FP-DOE, 11 rovnoběžných čar

Dobrý den,

pro laboratorní měření deformace povrchu vzorku zeminy (laserová triangulace s kamerou) poptáváme laserový modul
Laser Components řady FLEXPOINT s difrakční optikou pro 11 rovnoběžných čar (podle katalogového listu FLEXPOINT DOE
Series, DOE-233), 1 ks.

Požadované parametry:
- vzor: 11 rovnoběžných čar (DOE-233 nebo ekvivalent), úhel mezi sousedními čarami ≈ 3,8–4°, celkový rozptyl ≈ 40°;
- délka každé čáry (vějíř) alespoň 45° – na vzdálenost 134 mm musí čára pokrýt ≥ 110 mm;
- vlnová délka 635–660 nm (červená), výkon ≤ 1 mW (laserová třída 2);
- zaostřitelný, ostrost na vzdálenost ≈ 130–140 mm;
- průměr pouzdra 11,5 mm (standardní FLEXPOINT), napájení 5 V DC nebo 4,5–30 V DC;
- provoz v mrazicím boxu −10 až +10 °C, vlhký vzduch – prosíme o potvrzení rozsahu provozních teplot.

Prosíme o:
1. potvrzení, zda je tato konfigurace dostupná, a objednací kód;
2. cenu za 1 ks bez DPH a cenu dopravy do ČR;
3. dodací lhůtu;
4. katalogový list s přesnými úhly DOE (úhel mezi čarami, délka čáry) a s rozsahem provozních teplot;
5. případně nabídku nejbližší alternativy z Vašeho sortimentu, pokud DOE 11 čar nevedete.

Fakturační údaje: [Fakulta stavební ČVUT v Praze, katedra …, Thákurova 7, 166 29 Praha 6; IČO …, DIČ …]
Kontakt: [jméno a příjmení, telefon, e-mail]

Děkuji a s pozdravem
[jméno a příjmení]
[katedra], Fakulta stavební ČVUT v Praze

---

## 2 · Picotronic GmbH (anglicky) – DOE253, 11 čar

**To:** Picotronic GmbH, Rudolf-Diesel-Str. 2a, 56070 Koblenz, Germany – **info@picotronic.de**, tel. +49 261 983497-0 ([imprint](https://www.picotronic.de/picopage/en/index/imprint))
**Subject:** Request for quotation – DOE laser module 11 lines, DOE253-635-1-6(10x22), order no. 70111842

Dear Sir or Madam,

for a laboratory test (laser triangulation of a soil sample surface with a camera inside a chest freezer) we would like
to order the following laser module:

- **DOE253-635-1-6(10x22), order no. 70111842** – 11 parallel lines, 635 nm, 1 mW, 5 V, housing ⌀10 × 22 mm;
- quantity: 1 pc (please quote 2 pcs as well – one spare).

Our geometry: the laser is 134 mm from the surface at 68° to it; we need 11 lines about 9.6 mm apart on the surface
(angle between adjacent lines ≈ 3.8–4°) and each line at least 110 mm long at 134 mm (fan angle ≥ 45°).

Could you please confirm:
1. the exact angle between adjacent lines and the fan angle (line length) of DOE253, and whether the focus can be
   set to ≈ 130–140 mm (or which focus distance you would recommend / preset at the factory);
2. the operating temperature range – the module will run at −10 °C to +10 °C in humid air;
3. the price excluding VAT, shipping costs to the Czech Republic and the delivery time;
4. whether you accept an order from a public university in the EU with VAT ID (reverse charge) and payment by invoice.

Invoice address: [Czech Technical University in Prague, Faculty of Civil Engineering, Department …,
Thákurova 7, 166 29 Prague 6, Czech Republic; VAT ID CZ…]
Contact: [name, phone, e-mail]

If DOE253 is not suitable for this geometry, we would be grateful for a recommendation of another module from your
range (11 parallel lines, red, ≤ 1 mW, ⌀10–12 mm housing).

Thank you in advance and kind regards,
[name]
[Department], Faculty of Civil Engineering, Czech Technical University in Prague

---

## 3 · LASER COMPONENTS Germany GmbH (anglicky) – výrobce FLEXPOINT, DOE 11 čar

**To:** LASER COMPONENTS Germany GmbH, Werner-von-Siemens-Str. 15, 82140 Olching, Germany – **info@lasercomponents.com**,
tel. +49 8142 2864-0 ([FLEXPOINT](https://lasercomponents.com/de-en/products/emitters/laser-modules/flexpoint-laser-modules))
**Subject:** Request for quotation – FLEXPOINT FP-DOE laser module, 11 parallel lines (DOE-233), 1 pc

Dear Sir or Madam,

for a laboratory test at a university (laser triangulation of a soil sample surface with a camera inside a chest
freezer) we would like to request a quotation for one FLEXPOINT laser module with a diffractive optical element for
11 parallel lines (DOE-233 according to your FLEXPOINT DOE Series datasheet, or an equivalent pattern).

Requirements:
- pattern: 11 parallel lines, angle between adjacent lines ≈ 3.8–4°, total spread ≈ 40°;
- each line at least 110 mm long at a distance of 134 mm (fan angle ≥ 45°);
- wavelength 635–660 nm (red), output ≤ 1 mW (laser class 2);
- focusable, focus set to ≈ 130–140 mm (the laser is 134 mm from the surface at 68° to it);
- standard housing ⌀11.5 mm, supply 5 V DC (or a wide-range input);
- operation at −10 °C to +10 °C in humid air.

Could you please send:
1. the exact order code of the suitable configuration;
2. the price for 1 pc (and for 2 pcs) excluding VAT, shipping costs to the Czech Republic and the delivery time;
3. the datasheet with the DOE angles (line spacing, line length) and the operating temperature range;
4. the name of your distributor for the Czech Republic, if orders from the Czech Republic are handled by a distributor.

Invoice address: [Czech Technical University in Prague, Faculty of Civil Engineering, Department …,
Thákurova 7, 166 29 Prague 6, Czech Republic; VAT ID CZ…]
Contact: [name, phone, e-mail]

Thank you in advance and kind regards,
[name]
[Department], Faculty of Civil Engineering, Czech Technical University in Prague
