martinasobotkova5/my_data_projects/e7_frost_heave_load/sdileni/E7_drawings.pdf

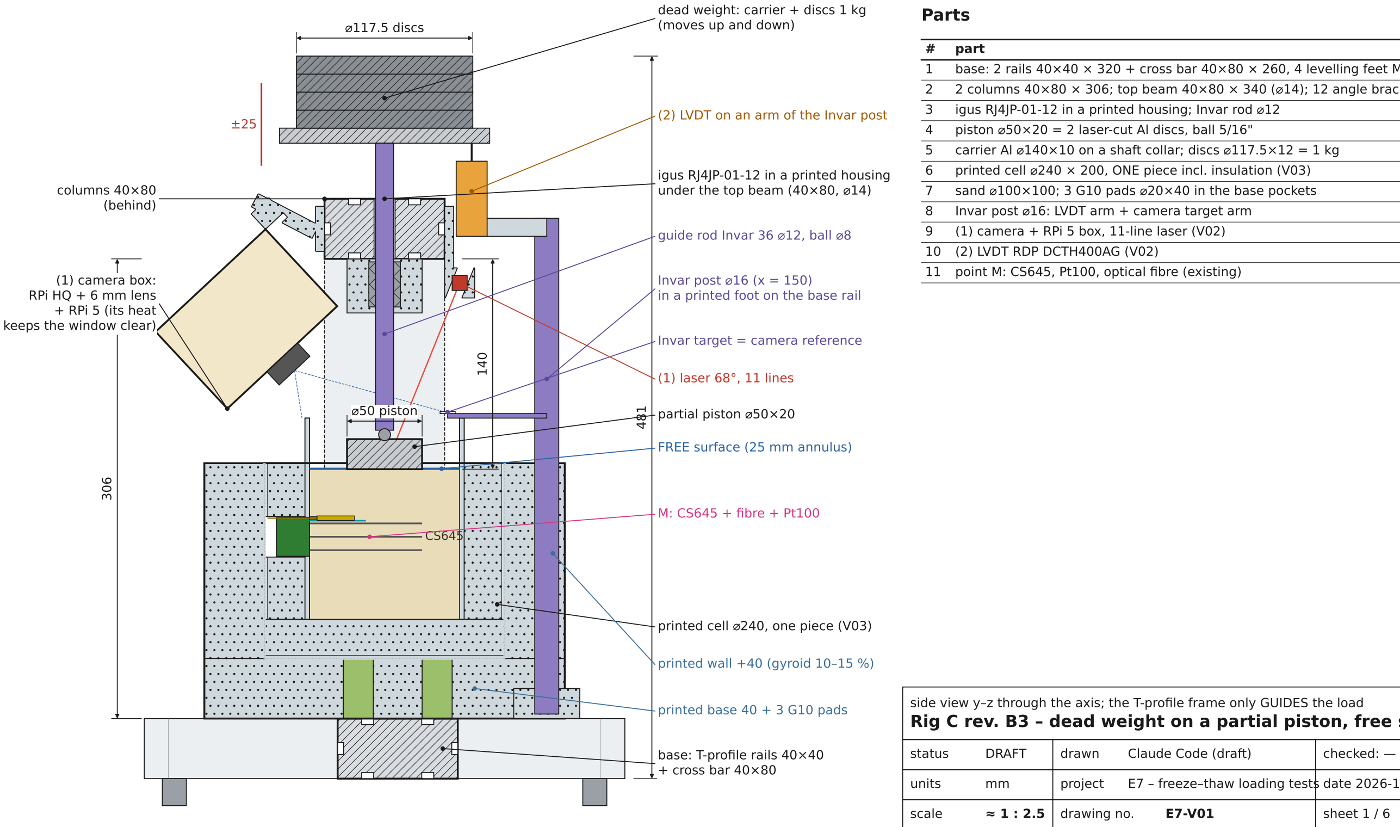
[picture p10: figure]
scale; drawing no.; sheet 1 / 6; status; DRAFT; drawn; Claude Code (draft); checked: —; Parts; part; 10 (2) LVDT RDP DCTH400AG (V02); ⌀50 piston; ⌀117.5 discs; dead weight: carrier + discs 1 kg (moves up and down); igus RJ4JP-01-12 in a printed housing under the top beam (40×80, ⌀14); (2) LVDT on an arm of the Invar post; guide rod Invar 36 ⌀12, ball ⌀8; Invar post ⌀16 (x = 150); in a printed foot on the base rail; Invar target = camera reference; (1) laser 68°, 11 lines; partial piston ⌀50×20; FREE surface (25 mm annulus); M: CS645 + fibre + Pt100; printed cell ⌀240, one piece (V03)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

units | mm | project | E7 – freeze–thaw loading tests date 2026-11-09

## Rig C rev. B3 – dead weight on a partial piston, free surface

side view y–z through the axis; the T-profile frame only GUIDES the load

## Load under the piston (⌀50 = 1963 mm²)

kPa | total kg | 1 kg discs | trim kg
5 | 1.00 | 0 | 0.31
10 | 2.00 | 1 | 0.31
15 | 3.00 | 2 | 0.31
20 | 4.00 | 3 | 0.31
25 | 5.00 | 4 | 0.31
moving part without discs ≈ 0.69 kg ≈ 3.5 kPa (minimum)
1 | base: 2 rails 40×40 × 320 + cross bar 40×80 × 260, 4 levelling feet M8
2 | 2 columns 40×80 × 306; top beam 40×80 × 340 (⌀14); 12 angle brackets
3 | igus RJ4JP-01-12 in a printed housing; Invar rod ⌀12
4 | piston ⌀50×20 = 2 laser-cut Al discs, ball 5/16"
5 | carrier Al ⌀140×10 on a shaft collar; discs ⌀117.5×12 = 1 kg
6 | printed cell ⌀240 × 200, ONE piece incl. insulation (V03)
7 | sand ⌀100×100; 3 G10 pads ⌀20×40 in the base pockets
8 | Invar post ⌀16: LVDT arm + camera target arm
9 | (1) camera + RPi 5 box, 11-line laser (V02)

11 point M: CS645, Pt100, optical fibre (existing)

scale | various | drawing no. | E7-V02 | sheet 2 / 6
status | DRAFT | drawn | Claude Code (draft) | checked: —

## Deformation measurement – (1) camera + laser, (2) LVDT

heave while freezing, settlement while thawing, residual per cycle

### (a) LASER TRIANGULATION – section y–z 1 : 1.25

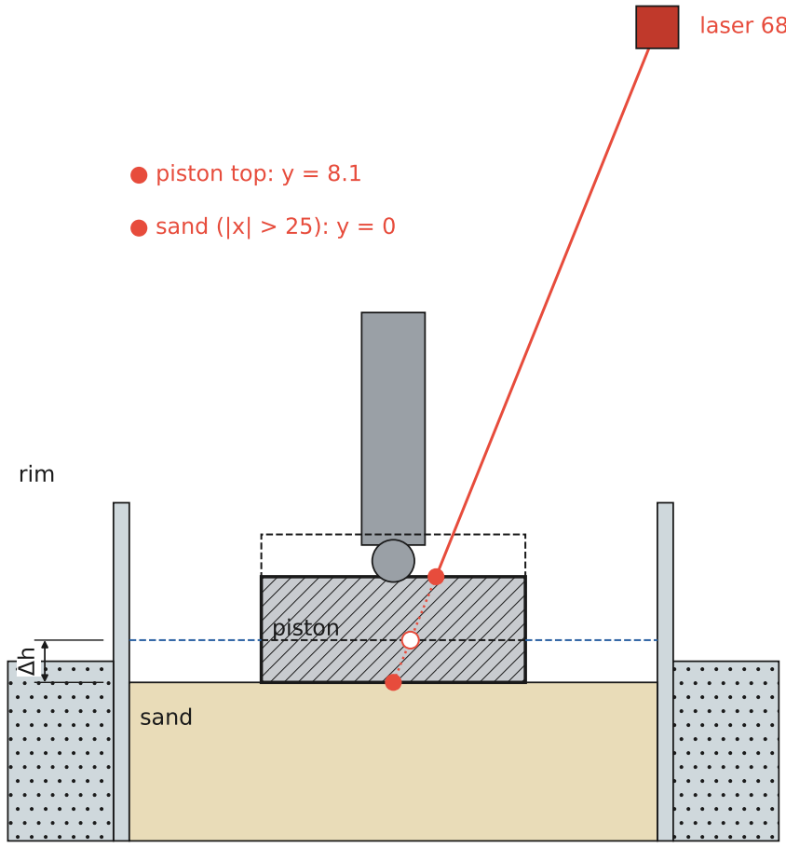
[picture p11: figure]
● sand (|x| > 25): y = 0; ● piston top: y = 8.1; sand; piston; rim

### (b) CAMERA VIEW – 11 laser lines, whole surface

### (c) LVDT ON INVAR POST 1 : 2.6

## What is measured

method | signal | resolution interval
(1) camera + 11 lines map h(x, y) of the whole surface ≈ 10 µm | every 10 / 1 min
(2) LVDT | carrier = piston | ≈ 1 µm | CR850, 10 / 1 min
Invar target | camera / frame drift | ≈ 10 µm | every photo

12 (±10 range); collar; LVDT DCTH400AG ⌀20.6 in a; printed clamp arm; Invar post ⌀16 from the base rail; (frame and rod drift bypassed); carrier on a; shaft collar (Invar rod); top beam T-profile 40×80, ⌀14;; printed housing + igus RJ4JP-01-12 hangs below it (4× M5 in T-nuts)

## Evaluation per freeze–thaw cycle

quantity | how
surface map | Δh(x, y) on 11 profiles → contour map, whole ⌀100
heave, free surface | mean Δh over the annulus (minus rim)
heave under load | Δh_load = LVDT (check: (1) on the piston)
settlement on thawing | drop from the maximum to the end of thaw
residual per cycle | height at end of thaw − start of cycle
effect of the load | Δh_free − Δh_load
strain | Δh / 100 mm
frost depth | 0 °C isotherm from Pt100 / fibre / CS645 (M)

Procedure
1 blank run, Al dummy instead of sand, full cycle: drift of (1) and (2) vs cell temperature (≈ 50 µm / 20 K, smooth) → fit and subtract
2 calibrate (1): shims 0.1 / 0.5 / 1.0 mm under a flat plate,
camera px → mm for free sand and piston top

3 load, 24 h at +10 °C, then zero (1) and (2)
4 cycle 24 h −10 °C / 24 h +10 °C (fan on); RPi photo timer

(NTP); laser on only for the photo
5 weigh a witness dish each cycle (not the cell); log air RH
6 Sr = 0.5 (θ 0.19): expected heave tens of µm, upper bound 1.7 mm;

the main signal is the thaw settlement under the load

laser 68° (bracket on the beam)

heave Δh moves the hit point by Δy = Δh / tan 68° = 0.40 Δh (open circle);

no collar shadow: the laser sits above the cavity edge

+y (laser) ↑ pitch 9.6 mm

Invar target = reference

rim: PETG, moves ≈ 100 µm / 20 K

free sand: 11 profiles

piston top (light red)

heave Δh: lines shift by 0.40 Δh

scale | 1 : 1.67 | drawing no. | E7-V03 | sheet 3 / 6
status | DRAFT | drawn | Claude Code (draft) | checked: —

## Printed cell rev. B – one piece ⌀240 × 200 with insulation, point M

core per M. Vrána 23.06.2026 + 40 mm printed insulation; z = 0 at the underside

### SECTION A–A 1 : 1.67 (along the TDR axis)

## Point M (existing sensors)

PLAN 1 : 3.3; 100 sand 34; CS645: 3 rods; ⌀3.2 × 75, pitch 8.9; port 13 × 27 through the whole wall (TDR head 19 at the inner wall); G10 pad ⌀20 × 40 in a pocket ⌀20.4,; 3× at r 35, 0.5 mm proud; printed together with the core

| sensor | position
TDR | Campbell CS645 | 3 rods 75, pitch 8.9, in the port, depth 36/45/54
OF | optical fibre | at the top rod, tip 37.5 from the wall
Pt100 | Pt100, 4-wire | from the port, +3.5 above the top rod, tip 30 from wall

## Print (one piece)

item | value
size | ⌀240 × 200 mm – bed ≥ 250 × 250, Z ≥ 200
material | PETG or PETG-CF, 0.2 mm layers, ≈ 1.3–1.6 kg
walls | cavity wall ≈ 5 mm (≈ 8 perimeters), outer 3 perimeters
floor | z 40–66 under the cavity: 100 % (stiff, flat)
insulation | base z 0–40 and wall r 80–120: gyroid 10–15 %
pockets | 3× ⌀20.4 × 40 from below, r 35
time | ≈ 40–60 h (one job)
- Sand 100 mm (z 66–166), 34 mm free above (piston 20 + travel).
- The cell stands on the 3 G10 pads only (0.5 mm proud): the low-infill
base insulates but carries no load → no creep in the LVDT chain.
- Heat model: λ infill ≈ 0.06 W/mK → freezes from the top, last unfrozen
≈ 13 mm above the floor; at Sr 0.5: 95 % frozen in ≈ 15 h, thawed in ≈ 15 h.
- Inside: epoxy coat + PTFE spray + silicone grease.
- Cables: TDR head, Pt100 and fibre all through the port;

the sand surface stays completely free (camera + laser).
- Full dimensions: cad/E7_V04_cell.dxf.


port 13 wide (TDR axis, camera side); pads dashed (underneath)

optical fibre, tip 37.5 from the wall | Pt100 horizontal from the port (metal 25), centred on the top rod (+3.5), tip 30 from the wall

low infill (gyroid 10–15 %) = insulation,

scale | – | drawing no. | E7-V04 | sheet 4 / 6
status | DRAFT | drawn | Claude Code (draft) | checked: —

## Sensors, CR850 wiring and costs

existing = already in the lab; prices ≈ EUR excl. VAT, * = dealer price found, rest estimated

## To buy

tag | item | EUR | CR850
CAM | Raspberry Pi 5 4 GB + PSU, SD, camera cable (RPishop) | 105–120 * | – (Ethernet, NTP)
+ | Raspberry Pi HQ Camera C/CS, IMX477 (RPishop OFI060) | 50–62 * | – (NTP timer)
+ | Raspberry Pi 6 mm CS wide-angle lens (RPishop / Pi Hut) | 20–30 | –
+ | camera box XPS 30, double glass; houses the RPi 5 (no heater) | 20–40 | –
+ | SHT45 RH/T sensor on the RPi (I2C), freezer air | 15–25 | – (RPi)
LAS | Picotronic DOE253-635-1-6(10x22), 11 lines, 635 nm, 1 mW, 5 V 92 * | – (RPi GPIO)
LVDT | RDP DCTH400AG ±10 mm, spring (Elkome) | 581 * | DIFF1, ±5000 mV
+ | Mean Well HDR-15-24, 24 V DIN (floating supply) (TME) | 11–14 * | always on
+ | Campbell 4WPB100 (for the existing Pt100) (Ekotechnika) | 60–120 | DIFF2
Tair | Campbell 109-L, REQUIRED: air = boundary condition | 150–220 | MUX ch 1
+ | fan 80 mm 12 V, air mixing in the freezer | 10–20 | 12 V, always on
T | NTC 10k thermistors + 10k 0.1 % resistors (rig, cell, air; 4 optional in sand) 30–80 | MUX ch 2–11
CAL | shims 0.1 / 0.5 / 1.0 mm (feeler gauge set) for camera px → mm | 10–25 | –

## Mechanics (estimate)

item | | EUR
laser: carrier ⌀140, 2 piston discs; steel discs ⌀117.5 | 70–140
T-profiles slot 8 cut (ENPRAG), 12 brackets, 44 T-nuts, 4 feet | 100–170
igus RJ4JP-01-12, shaft collar 12, ball 5/16", screws M3–M8 | 25–50
Invar 36: rod ⌀12 × 265 + post ⌀16 × 330 (Evek, cut to length) | 80–160
cell ⌀240 × 200 printed in one piece + 3 G10 pads | 45–90
printed parts P01–P11 (holders, camera box, sample aids) | 12–30

Total ≈ 1486–2069 EUR excl. VAT (≈ 37–52 tis. Kč). Already available: printed cell, CS645 + TDR100/200, Pt100, optical fibre, CR850.

## CR850 + AM16/32B channel plan

terminal | connected to | measurement
DIFF1 | (2) LVDT | VoltDiff ±5000 mV, avg 20–50
DIFF2 | Pt100 via 4WPB100 | BrHalf4W, VX2 2500 mV
SE5+VX2 | MUX COM (2×32): thermistors | Tair 109 + rig / cell temps
C1–C3 | TDR100/200 → CS645 | SDM
C4 / VX1 | MUX RES / MUX CLK | PortSet / ExciteV pulse
12 V | MUX, fan; LVDT own 24 V | always on
– | (1) camera + RH sensor | RPi 5 in the camera box
– | optical fibre | own reader

Notes
- CR850 and TDR outside; RPi 5 inside the camera box (no CSI ribbon through the seal, its ≈ 5 W heat the box).

Through the lid seal: Ethernet, 5 V, LVDT, sensor cables.
- Scan 10 min, 1 min around 0 °C; the RPi takes the photo

on its NTP clock (no free port on the CR850).
- MUX: Tair, air at surface, cell base + wall, Invar post, beams → drift correction; option: 4 probes in the sand.
- Fan in the freezer evens out the on/off air swings.
- No pressure cells: the load is a known dead weight.

scale | 1 : 5 | drawing no. | E7-V05 | sheet 5 / 6
status | DRAFT | drawn | Claude Code (draft) | checked: —

## Rig C rev. B3 in the chest freezer

same freezer as E6 (≈ 900 × 550 × 650, to be measured); CR850 outside the freezer

## Fit check

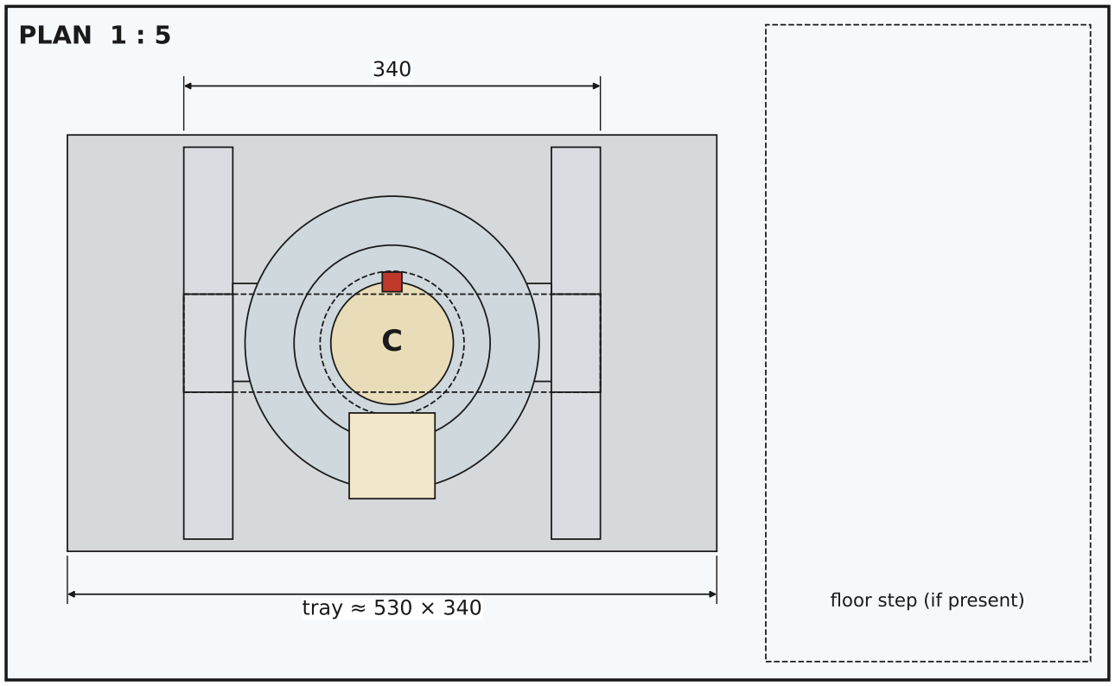
[picture p12: figure]
PLAN 1 : 5

item | size | value | status
base frame | 340 × 320 | tray ≈ 530 × 340 | OK
rig height | frame + discs | 499 above tray | check
highest point | above freezer floor | 559 | ≈ 91 spare
load travel | ± 25 mm above the beam | max 584 | lid closes?

Notes
- The free end of the freezer stays empty (cable bundle, a second rig).
- Highest point is the disc stack; with 4 discs ≈ 91 mm under the lid – measure the freezer and the tray before ordering the profiles.
- Camera box and laser hang inside the frame – nothing outside the base.
- Rev. B3: frame of T-slot profiles; the bearing housing hangs under the top beam, beam gap 140 mm above the sand → the rig is lower than rev. B.
- 80 mm fan on the free end mixes the air; run the blank test first.

C

floor step (if present) tray ≈ 530 × 340

ELEVATION 1 : 5 | lid 559

≈ 650

### T04 TOP BEAM 40×80 × 340, 1×, lies flat

## T-slot profiles slot 8 (cut to length, item/Bosch compatible)

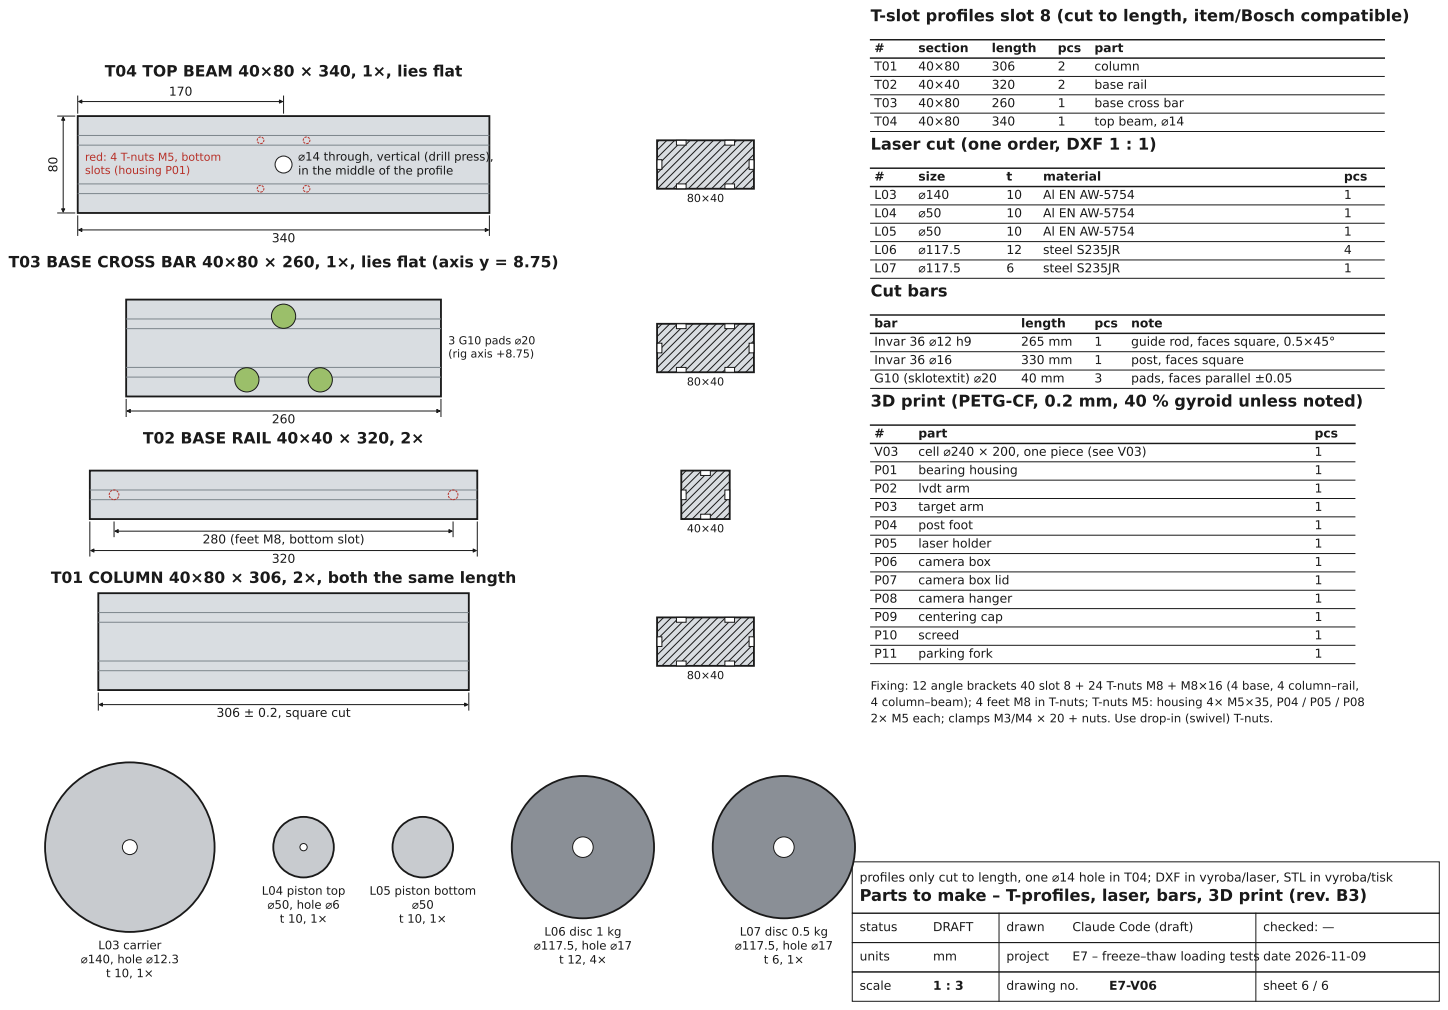
[picture p13: page 6]

Laser cut (one order, DXF 1 : 1)

⌀14 through, vertical (drill press),
in the middle of the profile

T03 BASE CROSS BAR 40×80 × 260, 1×, lies flat (axis y = 8.75)

3D print (PETG-CF, 0.2 mm, 40 % gyroid unless noted)

T01 COLUMN 40×80 × 306, 2×, both the same length

Fixing: 12 angle brackets 40 slot 8 + 24 T-nuts M8 + M8×16 (4 base, 4 column–rail,
4 column–beam); 4 feet M8 in T-nuts; T-nuts M5: housing 4× M5×35, P04 / P05 / P08

2× M5 each; clamps M3/M4 × 20 + nuts. Use drop-in (swivel) T-nuts.

profiles only cut to length, one ⌀14 hole in T04; DXF in vyroba/laser, STL in vyroba/tisk
Parts to make – T-profiles, laser, bars, 3D print (rev. B3)
