martinasobotkova5/my_data_projects/e7_frost_heave_load/sdileni/E7_literatura_CZ.md

# Měření deformací válcových vzorků zeminy při mrznutí a tání – výpisky z literatury

Sestaveno 13. 11. 2026 z vyhledávání (abstrakty, výňatky, popisy norem). Plné texty článků nebyly v tomto prostředí
dostupné, údaje označené „(ověřit)“ je třeba zkontrolovat v originále.

## 1 · Hlavní poznatky

1. **Nejčastější uspořádání:** válcový vzorek v plexisklové (akrylátové) cele, mrznutí **shora nebo zdola** přes
   teplotně řízené desky (cirkulující kapalina z kryostatu), boky izolované, **deformace = posun horní desky**
   měřený **LVDT nebo úchylkoměrem**; teploty termočlánky / termistory / Pt100 po výšce vzorku; v otevřeném systému
   se měří i **přítok vody** (byreta, diferenciální tlakový snímač).
2. **Bezkontaktní metody:** laserový snímač vzdálenosti nad vzorkem (≈ 0,01 mm), obrazové metody **PIV / DIC**
   přes průhlednou stěnu (lokální deformace po výšce, chyba < 0,5 mm), **rentgenová μ-CT** a **MRI** (vnitřek vzorku,
   ledové čočky), **optická vlákna** (FBG, distribuované) v modelech podloží.
3. **Se zatížením i bez něj:** normové zkoušky namrzavosti mají jen malé přitížení (ASTM 3,5 kPa) nebo žádné
   (BS 812-124); výzkumné přístroje zatěžují **0–130 kPa** (Hokkaido), **30–500 kPa** (ICSMGE 2026), oedometrické
   cely i výš. Všechny práce se zatížením se shodují: **zatížení zdvih při mrznutí zmenšuje, ale sedání při tání
   zvětšuje**; po několika cyklech (≈ 5–9) se trvalá deformace ustálí.
4. **Nenasycený písek:** sloupcové zkoušky (Watanabe et al. 2011) **zdvih ani ledové čočky nezaznamenaly** – souhlasí
   s naším odhadem pro Sr = 0,5 (zdvih nanejvýš desítky µm). Zdvih nenasycených zemin roste s počátečním nasycením
   a klesá s přitížením a rychlostí ochlazování (Wu & Ishikawa 2022).
5. **Pro E7:** naše sestava odpovídá běžné praxi (mrtvá váha + LVDT na pístu, mrznutí shora, izolované boky, plexi
   nahradila tištěná cela). Neobvyklé a podle nalezených prací nové je **současné měření zatížené a volné části
   povrchu** (píst + laserová triangulace mezikruží) v jednom vzorku.

## 2 · Přehled experimentů a norem

| zkouška / práce | vzorek a cela | mrznutí | měření deformace | další čidla | zatížení | voda |
|---|---|---|---|---|---|---|
| **ASTM D5918** (namrzavost a oslabení táním, vozovky) | ⌀146 × 150 mm ve sloupci 6 akrylátových prstenců ⌀146 × 25 mm (stažené tyčemi) – prstence omezují tření o stěnu | shora, 2 cykly mrznutí–tání | zdvih horní desky v čase (rychlost zdvihu); po tání CBR | 8 teplotních čidel po výšce | **přitížení 3,5 kPa** (ověřit v aktuálním vydání) | otevřený systém, voda zdola |
| **BS 812-124** (TRRL, kamenivo, UK) | válce v samochlazené jednotce (SRU) | shora, vzduch −17 °C, vodní lázeň +4 °C, 96 h | **zvětšení výšky** vzorků odečítané v intervalech; limit 13 mm (Anglie) / 18 mm (Skotsko) | – | bez zatížení | otevřený |
| **JGS 0171 / 0172** (Japonsko) | např. ⌀70 × 50 mm v akrylátové cele | jednosměrně, krokové teploty | posun horní desky (snímač posunu) | teploty; přítok vody diferenciálním snímačem s dvojitou byretou | volitelné přitížení | otevřený |
| **Konrad & Morgenstern 1980–82** (segregační potenciál) | válec v plexi cele s mazanými stěnami | krokové mrznutí | LVDT na horní desce | termistory po výšce, přítok vody | různé **přitížení** → empirická závislost SP na tlaku | otevřený |
| **Ishikawa & Tokoro, Hokkaido 2015** (nenasycené zeminy) | cela v izolované tlakové komoře | řízená rychlost mrznutí | posun horní desky | 3 plášťové termočlánky skrz celu | **0–130 kPa elektropneumaticky** | otevřený i uzavřený; různé Sr |
| **ICSMGE 2026 (č. 390)** | vlastní heave cell | 1 cyklus mrznutí–tání | **LVDT nad zatěžovací sestavou** | teploty | **30 / 100 / 500 kPa**; zdvih 7,45 % → 3,0 % | otevřený i uzavřený |
| **Viglianti et al. 2023, Tor Vergata** (oedometr pod nulou) | ⌀50 × 20 mm v oedometru, lázeň voda–glykol z kryostatu | celý oedometr v lázni, cykly | **LVDT na hlavě oedometru** | objem vytlačené vody | **stlačený vzduch**, konstantní v cyklu; trvalé sednutí po cyklech | drénovaný |
| **EYGEC 2025** (umělé zmrazování, prachovitý písek) | upravený tepelný oedometr, válcová komora, píst | 1 cyklus | snímač posunu na pístu | teploty, vodní komora | **10–100 kPa**: zdvih o 43 % menší | otevřený |
| **Niggemann, Ziegler, Fuentes 2024** (RWTH, umělé zmrazování) | nový přístroj, 62 zkoušek | **shora i zdola** (srovnání směru) | posun (ověřit typ) | teploty | zatížení shora (ověřit rozsah) | otevřený |
| **Huang et al. 2022** (hrubozrnné zeminy) | válec v klimatické komoře (±0,5 °C) | jednosměrně | **snímač posunu ±0,01 mm** (1 ks) | 3 teplotní čidla ±0,1 °C | bez | otevřený i uzavřený |
| **J. Cold Reg. Eng. 2008** („Improvements in frost heave laboratory testing“) | cela v upravené lednici, 5 jemnozrnných zemin | jednosměrně | **laser** měří zdvih | Pt100 desek, **diferenciální tlakový snímač** = přítok vody | ? | otevřený |
| **Pol. J. Environ. Stud. 2022** (zasolený prach) | válec v mrazicím zařízení | cykly | **snímač posunu YWD-50 uprostřed vzorku** | Pt100 | ? | ? |
| **Thaw-consolidation, Morgenstern & Smith 1973; Nixon & Morgenstern 1974** | speciální oedometr („permode“) | **tání shora** skokovou změnou teploty | **sednutí při tání pod zatížením** | pórové tlaky, postup tání | ano – konstantní svislé zatížení | drénovaný |
| **Cyklické zkoušky (Čína, 2015–2021)** – prachovité a bobtnavé zeminy | oedometrické / uzavřené cely | 9–30 cyklů | LVDT | teploty | zatížení vs. bez: zatížení zdvih tlumí, sedání při tání zvětšuje; existuje „neutrální“ zatížení bez objemové změny | uzavřený |
| **Watanabe et al. 2011** (nenasycený písek, hlína, prachovitá hlína) | sloupec | jednosměrně | deformace se neměřila – **zdvih ani čočky nevznikly** | termočlánky, **TDR**, tenziometry | bez | uzavřený |
| **PIV / DIC** (Wang et al. 2020; DIC 2023) | průhledná cela, boční pohled | jednosměrně | **pole posunů po výšce**, chyba < 0,5 mm; stopovací částice (písek) | – | obvykle bez | různé |
| **μ-CT** (Guida et al. 2025/26, jílovitý písek; jíl 2018) | malý vzorek v CT skeneru | 2 cykly | vnitřní lokální deformace, póry, led | – | bez | nasycené |
| **Distribuovaná vlákna** (model podloží 2024) | velký sloupec / model | mrznutí a tání | body + **distribuované optické vlákno** | teplota, vlhkost | bez | – |

## 3 · Jak se deformace měří – srovnání

| metoda | co měří | přesnost (uváděná) | výhody | nevýhody | v E7 |
|---|---|---|---|---|---|
| **LVDT / úchylkoměr na horní desce** | průměrný zdvih celé plochy | ≈ 1 µm (LVDT), 10 µm (úchylkoměr) | jednoduché, normové | jen jedno číslo, deska ovlivní povrch, drift rámu | ✓ LVDT na pístu, invarový sloupek proti driftu |
| **laserový snímač vzdálenosti** | výška jednoho bodu, bezkontaktně | ≈ 0,01 mm | bez kontaktu | jeden bod, odrazivost povrchu | – |
| **laserová triangulace + kamera** | výšková mapa celého povrchu | ≈ 10 µm (náš odhad) | celý volný povrch | kalibrace, odrazivost, rosa | ✓ 11 čar + kamera |
| **PIV / DIC přes stěnu** | posuny po výšce vzorku | < 0,5 mm | vidí, kde vznikají čočky | potřebuje průhlednou celu a stopovací částice | ne (neprůhledná izolovaná cela) |
| **μ-CT / MRI** | vnitřní struktura, led | voxely desítky µm | vnitřní mechanismus | malé vzorky, drahé, ne v mrazáku | ne |
| **FBG / distribuovaná vlákna** | poměrná deformace uvnitř | µε | vnitřní profil | interakce vlákno–zemina, kalibrace | (vlákno máme jen na teplotu) |
| **přítok / výtok vody** | objem nasáté vody | 0,01 ml | odhad segregace ledu | jen otevřený systém | ne (uzavřený systém) |

## 4 · Konstrukce cel – opakující se prvky

- **Tření o stěnu:** dělené prstence (ASTM), mazané stěny (Konrad), teflon / silikonový tuk. *E7: epoxid + PTFE
  sprej + silikonová vazelína.*
- **Jednosměrné mrznutí:** horní a dolní deska s cirkulující kapalinou z kryostatu, boky izolované nebo v komoře
  s vodou 2 °C (Hokkaido). *E7: mrznutí shora vzduchem v truhle, izolace tištěnou stěnou a dnem 40 mm.*
- **Zatížení:** závaží (oedometr), stlačený vzduch / elektropneumatický válec (Hokkaido, Tor Vergata), šroubový lis.
  *E7: mrtvá váha na částečném pístu ⌀50 (5–25 kPa).*
- **Teploty:** 3–8 čidel po výšce vzorku → čára 0 °C (hloubka promrznutí). *E7: Pt100 + TDR v bodě M; navrženo
  4 termistory po výšce přes multiplexor.*
- **Voda:** otevřený systém (voda zdola, měří se přítok) pro namrzavost; uzavřený pro chování při daném nasycení.
  *E7: uzavřený, Sr = 0,5.*

## 5 · Se zatížením a bez něj – shrnutí

- **Bez zatížení (nebo symbolické):** normové zkoušky namrzavosti (BS 812-124, ASTM D5918 s 3,5 kPa), obrazové a CT
  studie, Watanabe 2011 (nenasycený písek), hrubozrnné zeminy (Huang 2022).
- **Se zatížením:** Konrad & Morgenstern (segregační potenciál vs. tlak), Ishikawa & Tokoro (0–130 kPa, nenasycené),
  ICSMGE 2026 (30–500 kPa), Tor Vergata (oedometr), EYGEC 2025 (10–100 kPa), thaw-consolidation testy (sednutí při
  tání), čínské cyklické zkoušky.
- **Výsledky se zatížením:** zdvih klesá s rostoucím zatížením (např. 7,45 % → 3,0 % mezi 30 a 500 kPa; −43 % mezi
  10 a 100 kPa), **sedání při tání roste**, trvalé sednutí se hromadí a po ≈ 5–9 cyklech ustálí; u bobtnavých zemin
  existuje zatížení, při kterém je objemová změna nulová.
- **Obojí v jednom vzorku současně** (zatížená a volná část povrchu) jsem v nalezených pracích nenašla – E7 to
  dělá pístem ⌀50 a kamerou s laserem na mezikruží.

## 6 · Zdroje

- ASTM D5918 – [ASTM store](https://store.astm.org/d5918-13.html), [text D5918-96](https://softbank.iust.ac.ir/Railway/Codes/ASTM-standard/ASTM_2004_Standards/ASTM%202004%20PART%20IB/ASTM%202004%20Volume%2004.09%20Soil%20and%20Rock%20(II)%20D%20571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), [Geocomp – freeze-thaw backfill](https://geocomp.com/wp-content/uploads/2024/04/Freeze-ThawEffectsGasPermeabilityofUtilityLineBackfill2004_WEB.pdf)
- BS 812-124 – [BSI](https://knowledge.bsigroup.com/products/testing-aggregates-method-for-determination-of-frost-heave), [TRRL SRU](https://trid.trb.org/View/173829)
- Konrad & Morgenstern 1981 – [The segregation potential of a freezing soil](https://next.sciencegate.app/document/10.1139/t81-059), [odhad SP](https://www.sciencegate.app/document/10.1139/t04-080)
- Ishikawa & Tokoro 2015 – [GeoQuébec 2015, paper 792](https://members.cgs.ca/documents/conference2015/GeoQuebec/papers/792.pdf); Tokoro – [ISSMGE](https://www.issmge.org/uploads/publications/1/141/2386.pdf)
- ICSMGE 2026 č. 390 – [ISSMGE PDF](https://www.issmge.org/uploads/publications/1/141/390.pdf)
- Viglianti et al. 2023 – [Tor Vergata PDF](https://art.torvergata.it/retrieve/ef0ced9d-559d-4df4-a4cb-f2760655a7cc/2023_Viglianti_et_al.pdf), [ISSMGE](https://www.issmge.org/uploads/publications/121/122/isdcg2023-117-1-c.pdf), [E3S 2024](https://doaj.org/article/50cd009e4bdf4ccb95d016f6df746d0b)
- EYGEC 2025 – [umělé zmrazování, prachovitý písek](https://eygec2025.uniri.hr/wp-content/uploads/2025/09/ARTIFICIAL-GROUND-FREEZING_-ROLE-OF-OVERBURDEN-PRESSURE-IN-THE-THERMO-HYDRO-MECHANICAL-BEHAVIOR-OF-SILTY-SAND-D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)
- Niggemann, Ziegler, Fuentes 2024 – [Acta Geotechnica](https://link.springer.com/article/10.1007/s11440-024-02259-2), [RWTH](https://publications.rwth-aachen.de/record/978032)
- Huang et al. 2022 – [Frontiers in Earth Science](https://www.frontiersin.org/articles/10.3389/feart.2022.854586)
- J. Cold Reg. Eng. 2008 – [Improvements in Frost Heave Laboratory Testing](https://ascelibrary.com/doi/10.1061/%28ASCE%290887-381X%282008%2922%3A3%2865%29)
- Pol. J. Environ. Stud. 2022 – [zasolený prach](https://www.pjoes.com/pdf-148188-78057?filename=Experiment+Study+of.pdf)
- Thaw-consolidation – [permafrost 1974](https://openpolar.no/Record/crcansciencepubl:10.1139%2Ft74-012), [přetvarované jíly 1973](https://scilit.com/publications/d14cee0697d1ecb7aefb2d4ffba1ec50), [Laval – oedometrický jádrovák](https://www.arquluk.gci.ulaval.ca/fileadmin/arquluk/documents/Product_Sheet/Arquluk_ProjectSheet_CoreBarrel.pdf)
- Cyklické zkoušky – [bobtnavá zemina se zatížením](https://www.sciencedirect.com/science/article/abs/pii/S0165232X21001749), [prachovité zeminy 2015](https://www.sciencedirect.com/science/article/abs/pii/S0165232X15000051), [měkké jemnozrnné zeminy](https://www.researchgate.net/publication/237380392_Effects_of_cyclic_freezing_and_thawing_on_volume_changes_and_permeabilities_of_soft_fine-gained_soils), [sloupec THM](https://www.researchgate.net/publication/384431981_Volumetric_behavior_of_a_soil_column_subjected_to_freeze-thaw_cycles_under_coupled_thermo-hydro-mechanical_conditi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)
- Watanabe et al. 2011 – [Annals of Glaciology](https://www.cambridge.org/core/journals/annals-of-glaciology/article/freezing-experiments-on-unsaturated-sand-loam-and-silt-loam/C90B7E59A2DC1AE9F41CD1CA013FA656)
- PIV / DIC – [PIV nenasycené zeminy (ASCE)](https://ascelibrary.org/doi/10.1061/(ASCE)CR.1943-5495.0000216), [PIV 2018](https://www.researchgate.net/publication/327682176_Application_of_PIV_in_model_tests_on_frozen_unsaturated_soils_and_grayscale_correlation_analysis), [DIC 2023](https://www.sciencedirect.com/science/article/abs/pii/S0165232X23000514), [obrazová analýza 2017](https://www.sciencedirect.com/science/article/abs/pii/S0165232X17301544)
- μ-CT – [jílovitý písek, CRST](https://www.sciencedirect.com/science/article/pii/S0165232X25002824), [jíl 2018](https://www.researchgate.net/publication/323570398_Characterization_of_freeze-thaw_effects_within_clay_by_3D_X-ray_Computed_Tomography); MRI – [IP Paris](https://researchportal.ip-paris.fr/en/publications/magnetic-resonance-imaging-as-a-tool-for-investigating-frost-heav/)
- Optická vlákna – [FBG senzor](https://www.aminer.org/pub/65e144cc13fb2c6cf60f2998/six-dimensional-strain-sensor-based-on-fiber-bragg-gratings-for-frozen-soil), [model podloží 2024](https://tjxb.ijournals.cn/jtunsen/article/pdf/202404011)
- Přehled přístrojů – [Zeinali et al., NGM 2016](https://www.issmge.org/publications/publication/freezing-thawing-laboratory-testing-of-frost-susceptible-soils), [Dagli 2017, LTU](https://www.diva-portal.org/smash/get/diva2:1111664/FULLTEXT01.pdf)
