martinasobotkova5/my_data_projects/e7_frost_heave_load/sdileni/E7_poptavka_ramu_CZ.md

# E7 – poptávka rámu z T-profilů (ENPRAG, s.r.o.)

**Komu:** ENPRAG, s.r.o., K Holyni 833/42, 154 00 Praha 5 (IČO 62743741) – tel. +420 224 942 663, zdarma 800 888 868,
poptávkový formulář na [enprag.cz](https://www.enprag.cz/hlinikove-profily/c-6027)
**Přílohy:** výkresy `vyroba/vykresy/E7-T01…T04` (PDF/DXF), sestava `vykresy/E7-V01_rig_C.png`, 3D `3d/E7_V01_variant_C.step`
**Předmět:** Poptávka – rám z hliníkových profilů drážka 8 podle výkresů, řez na míru + spojovací materiál

Dobrý den,

pro laboratorní zkoušku zeminy (zatěžovací rám v mrazicím boxu, −10 až +10 °C) poptáváme rám z hliníkových
konstrukčních profilů s drážkou 8 (kompatibilní s item / Bosch Rexroth) podle přiložených výkresů – nařezané profily
a veškerý spojovací materiál tak, abychom rám mohli rovnou složit. Prosíme o nabídku ve dvou variantách:
**A)** sada dílů (profily nařezané, otvor vyvrtaný, spojovací materiál), **B)** rám sestavený (základna, sloupy, příčník).

**Profily (řez kolmý ±0,2 mm, konce odjehlené):**

| díl | profil | délka [mm] | ks | poznámka |
|---|---|---|---|---|
| E7-T01 | 40×80 drážka 8 | 306 | 2 | sloup |
| E7-T02 | 40×40 drážka 8 | 320 | 2 | podélník základny |
| E7-T03 | 40×80 drážka 8 | 260 | 1 | příčka základny |
| E7-T04 | 40×80 drážka 8 | 340 | 1 | horní příčník – **svislý otvor ⌀14 skrz uprostřed** (výkres E7-T04) |

**Spojovací materiál:**

| položka | ks | použití |
|---|---|---|
| úhelník 40×40 drážka 8 (Zn) s krytkou | 12 | 4× příčka T03 ↔ podélníky, 4× sloupy ↔ podélníky, 4× sloupy ↔ příčník T04 |
| šroub M8×16 (ISO 4762 nebo dle Vašeho systému) + podložka | 24 | úhelníky |
| T-matice drážka 8, M8, vkládací (otočná) | 32 | úhelníky (24) + nohy (4) + 4 rezerva |
| T-matice drážka 8, M5, vkládací (otočná) | 12 | připevnění tištěných dílů (10) + 2 rezerva |
| šroub M5×35 + podložka | 4 | pouzdro ložiska pod příčníkem T04 |
| šroub M5×20 + podložka | 2 | patka sloupku na podélníku |
| šroub M5×12 + podložka | 4 | držák laseru a závěs kamery na boku T04 |
| stavitelná noha M8 (talíř ⌀30–40) | 4 | do spodní drážky podélníků T02 (y ±140 mm) |
| krytka čela 40×80 a 40×40 | 6 | konce příčky, příčníku a podélníků |
| příchytka kabelů do drážky 8 | 4 | kabely čidel |

Prosíme o:
1. cenu sady (A) a sestaveného rámu (B) bez DPH, včetně řezu, vrtání ⌀14 a dopravy (nebo osobního odběru v Praze);
2. potvrzení, že vyvrtáte otvor ⌀14 v příčníku T04 podle výkresu (případně jaký průměr středového otvoru profil má);
3. typ profilů (lehký / těžký) a jejich průřezové charakteristiky (I, W) – pro statický výpočet;
4. dodací lhůtu.

Pokud byste některý díl řešili jinak (např. jiný typ spojky místo úhelníků), uvítáme Váš návrh.

Fakturační údaje: [Fakulta stavební ČVUT v Praze, katedra …, Thákurova 7, 166 29 Praha 6; IČO …, DIČ …]
Kontakt: [jméno a příjmení, telefon, e-mail]

Děkuji a s pozdravem
[jméno a příjmení]
[katedra], Fakulta stavební ČVUT v Praze
