martinasobotkova5/my_data_projects/e6_frozen_infiltration/vykresy/E6-V02_sensor_layout.png

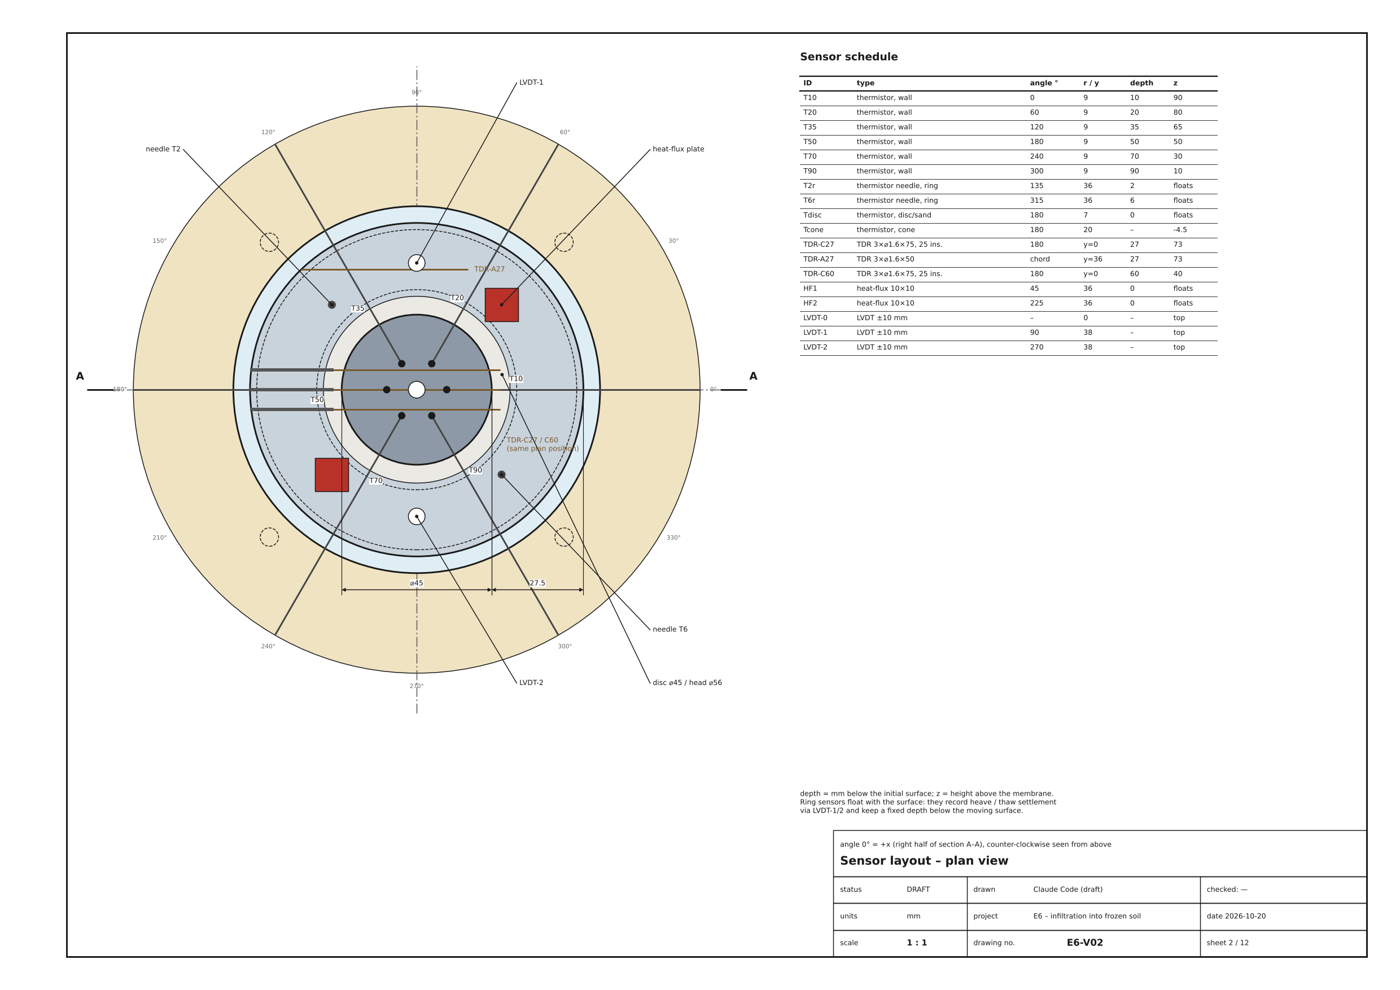
e6_frozen_infiltration/vykresy/E6-V02_sensor_layout.png
