martinasobotkova5/my_data_projects/e6_frozen_infiltration/vykresy/E6-V03_tube_developed.png

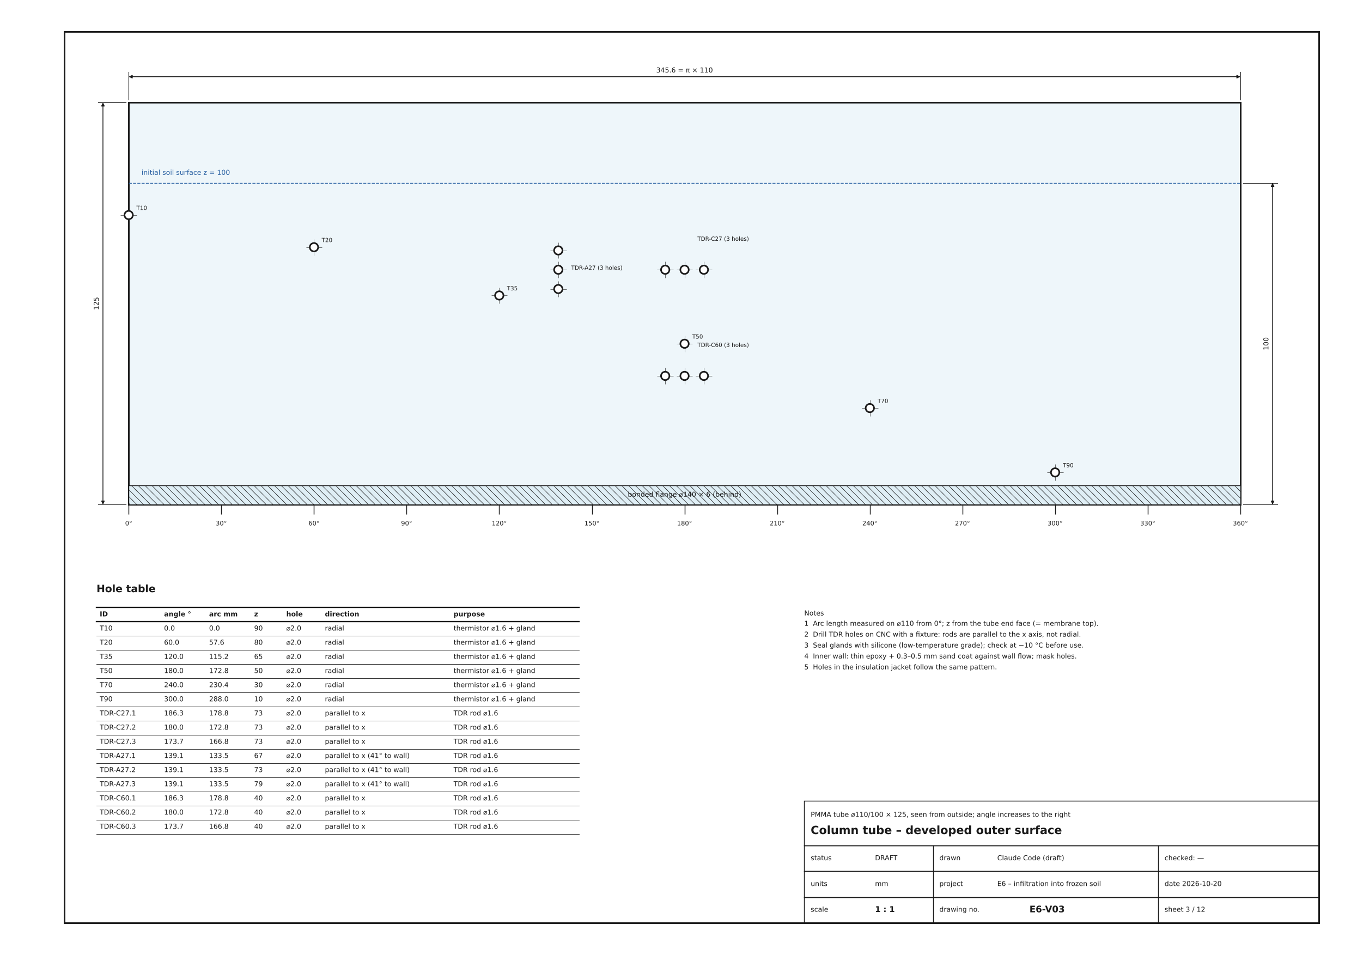
e6_frozen_infiltration/vykresy/E6-V03_tube_developed.png
