martinasobotkova5/my_data_projects/e6_frozen_infiltration/vykresy/E6-V04_cone_outlet.png

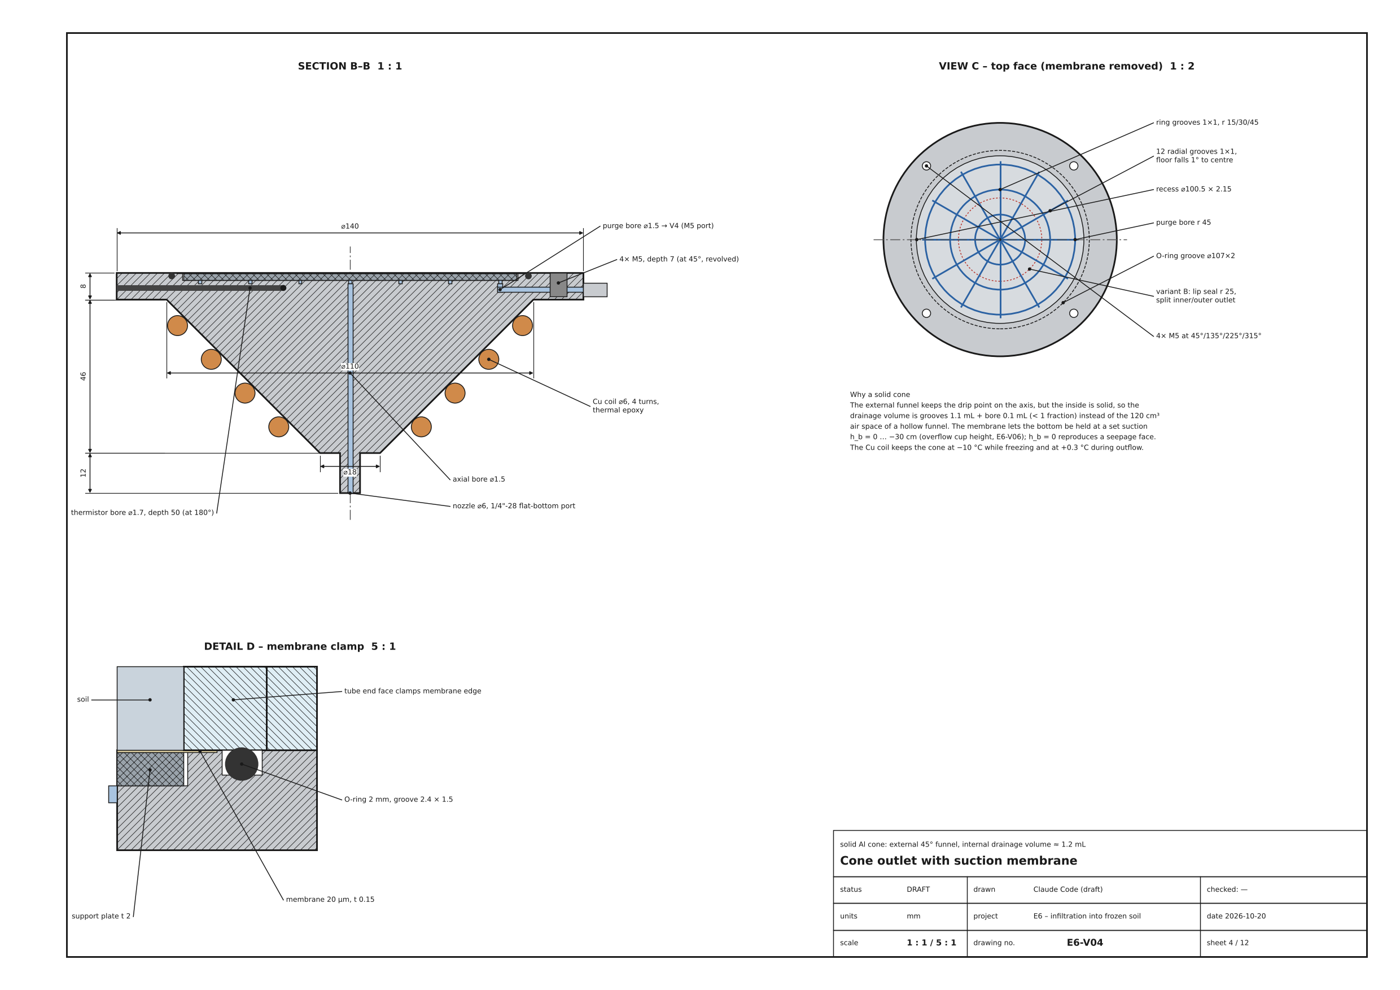
e6_frozen_infiltration/vykresy/E6-V04_cone_outlet.png
