martinasobotkova5/my_data_projects/e6_frozen_infiltration/vykresy/E6-V05_disc_interface.png

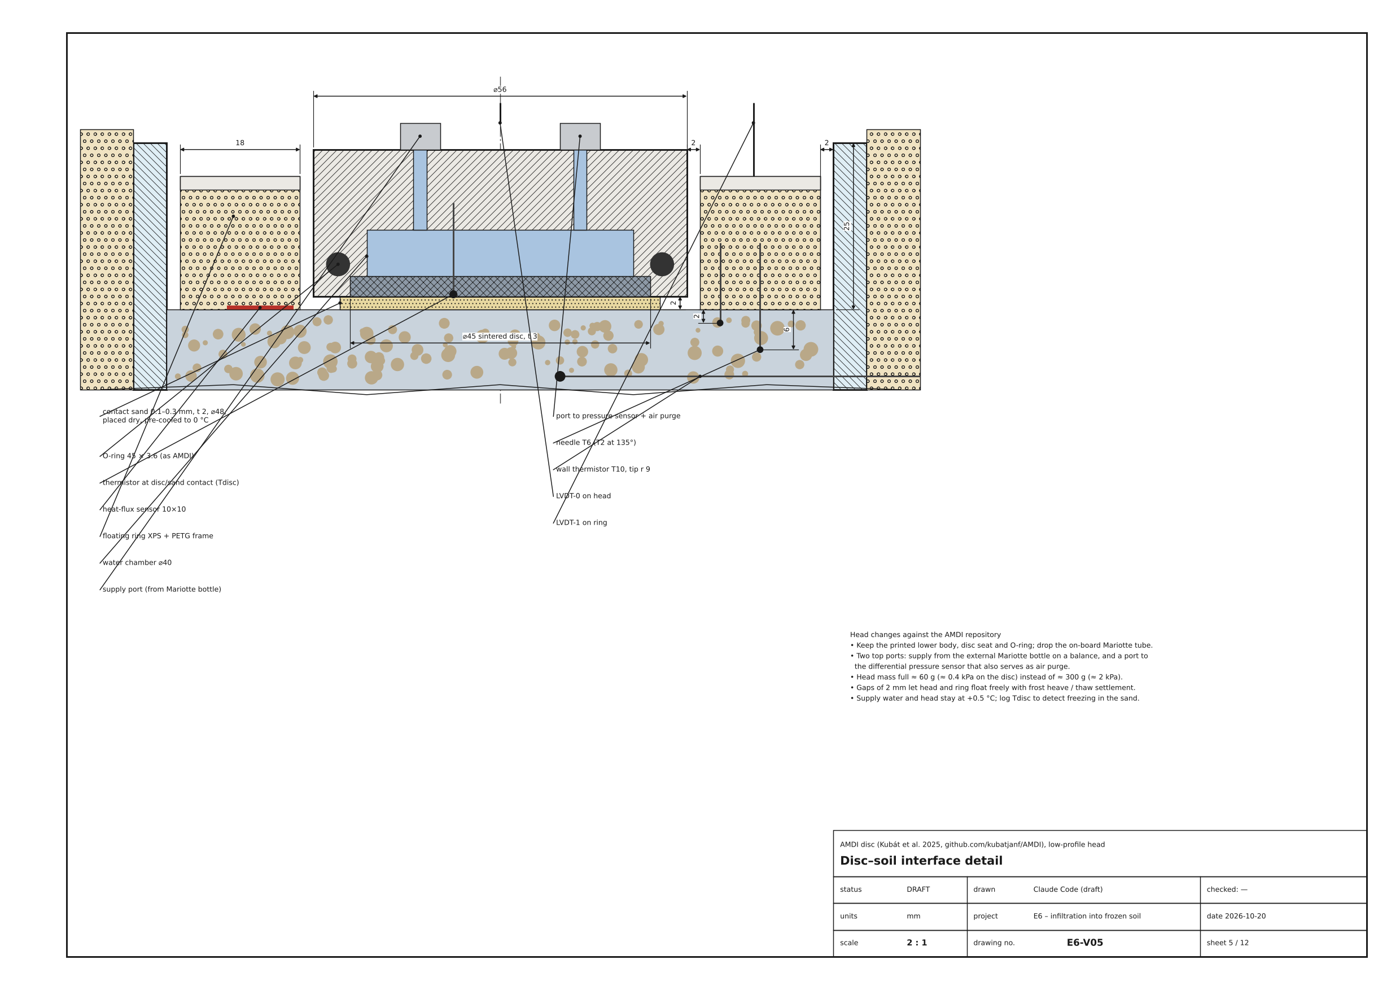
e6_frozen_infiltration/vykresy/E6-V05_disc_interface.png
