martinasobotkova5/my_data_projects/e6_frozen_infiltration/vykresy/E6-V06_hydraulic_scheme.png

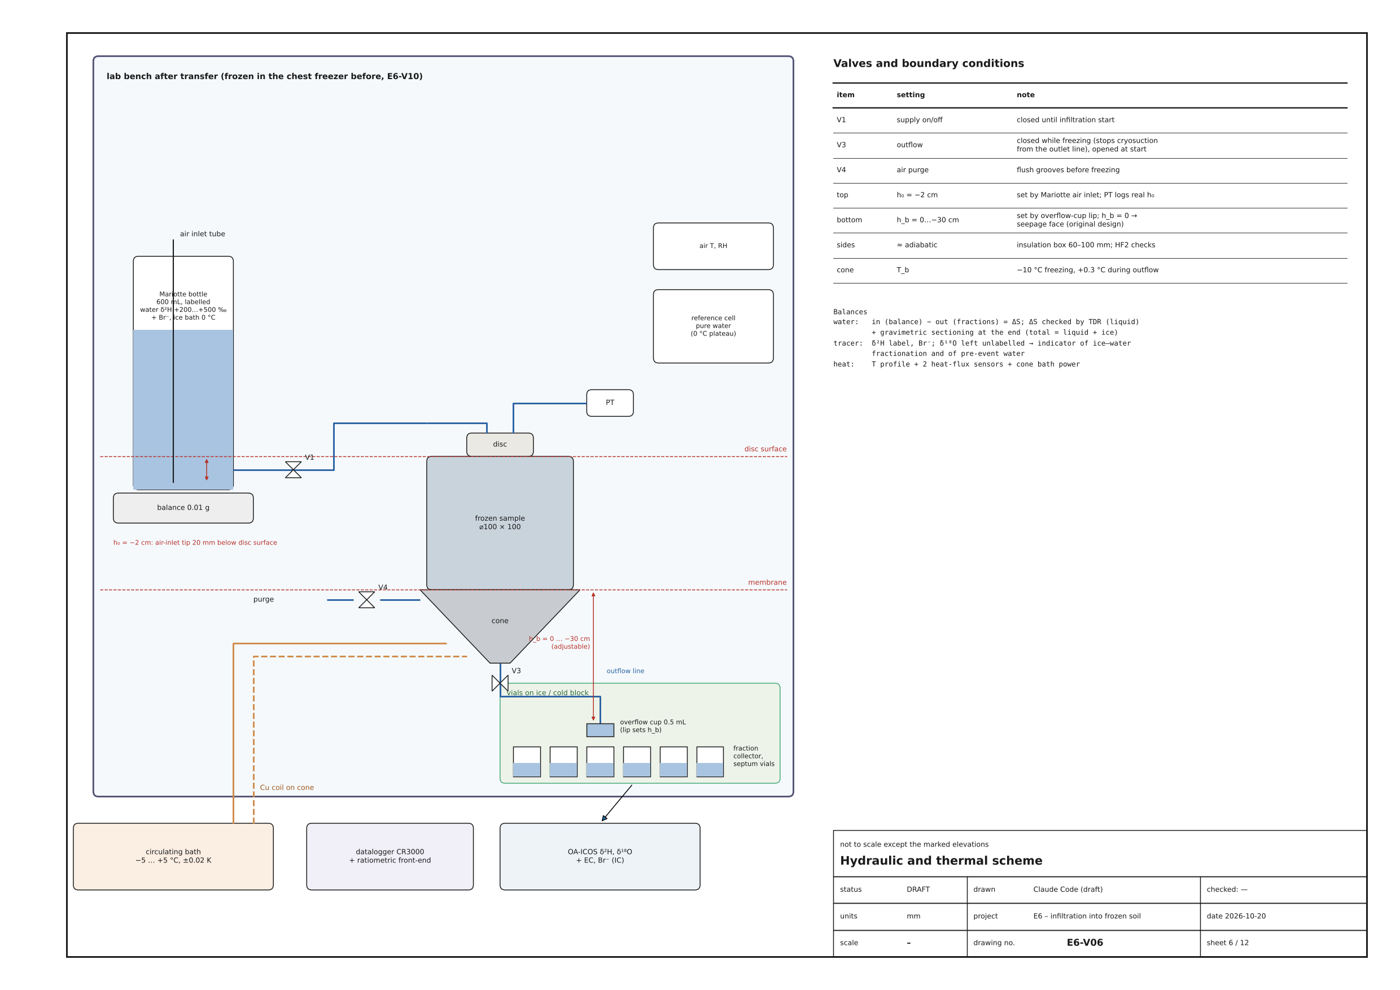
e6_frozen_infiltration/vykresy/E6-V06_hydraulic_scheme.png
