martinasobotkova5/my_data_projects/e6_frozen_infiltration/vykresy/E6-V07_protocol.png

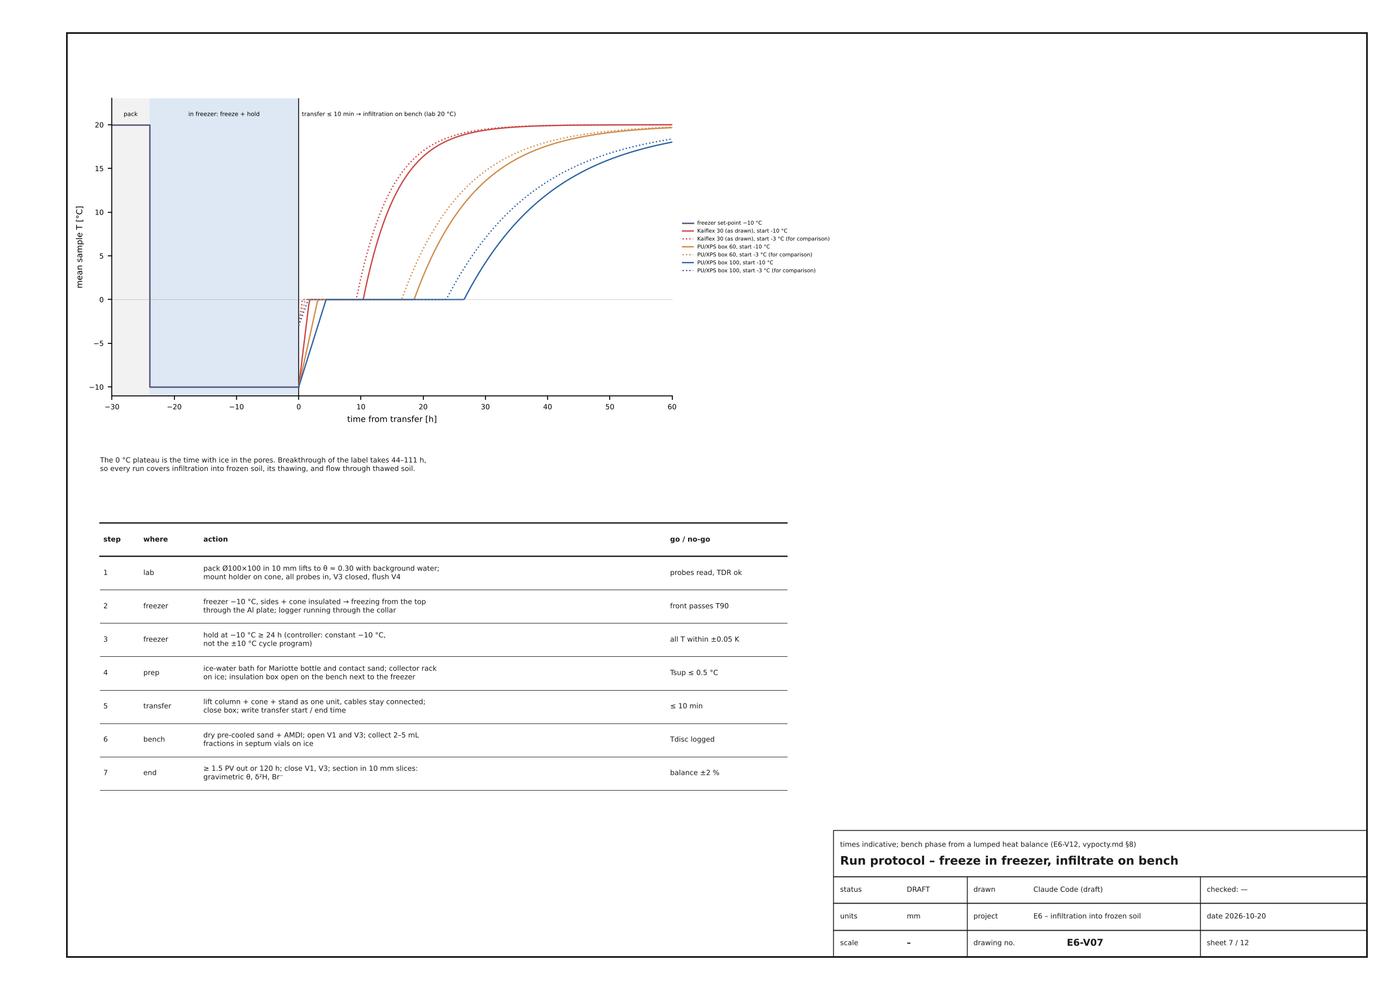
e6_frozen_infiltration/vykresy/E6-V07_protocol.png
