martinasobotkova5/my_data_projects/e6_frozen_infiltration/vykresy/E6-V08_thermometry_layout.png

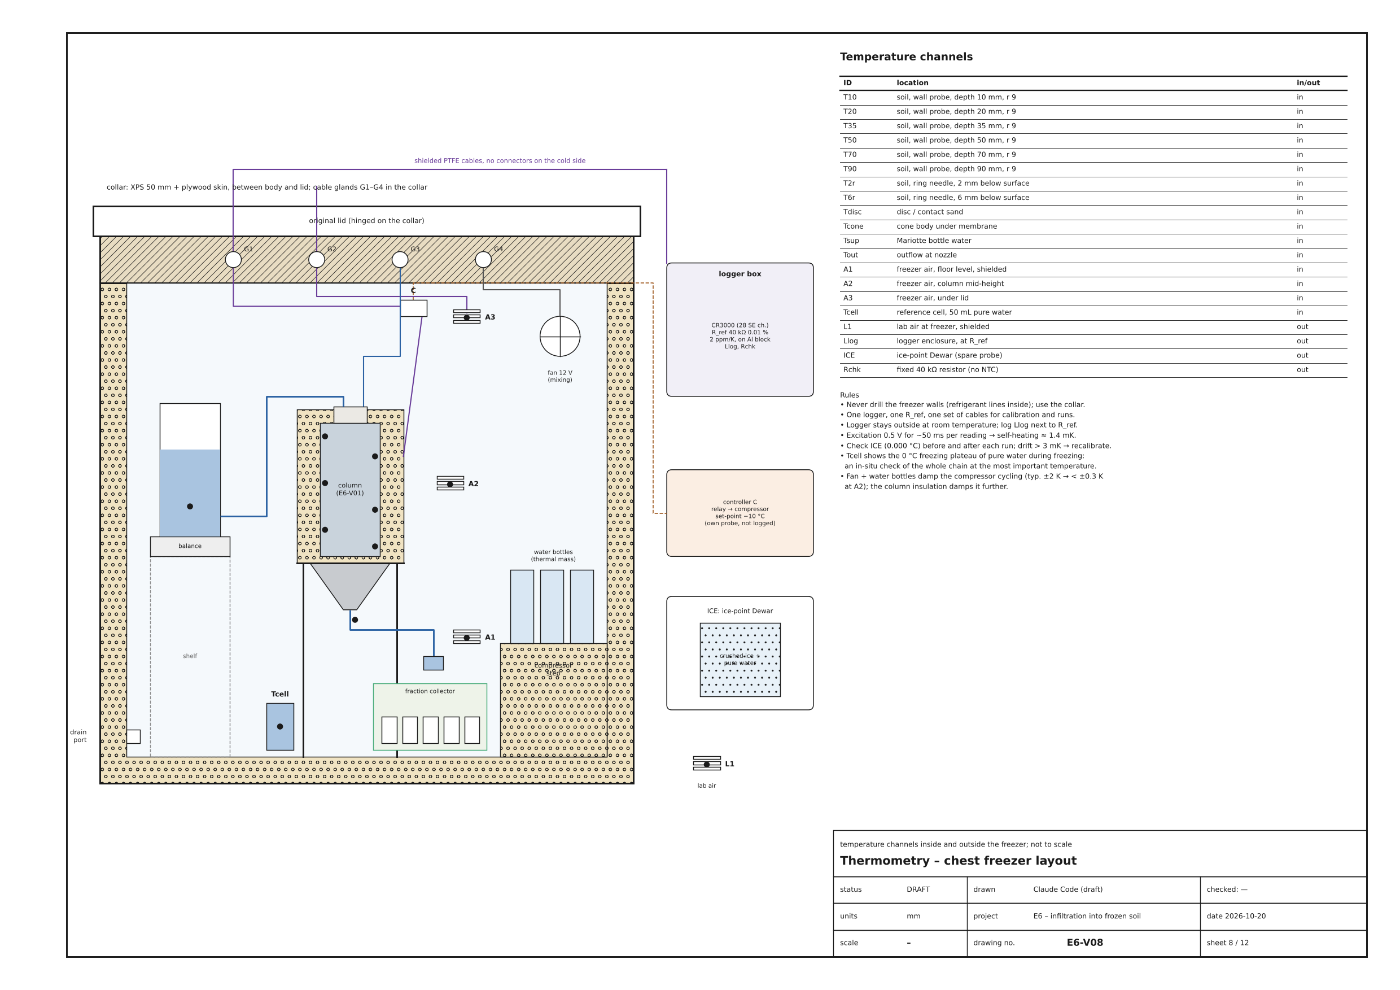
e6_frozen_infiltration/vykresy/E6-V08_thermometry_layout.png
