martinasobotkova5/my_data_projects/e6_frozen_infiltration/vykresy/E6-V09_thermistor_probe.png

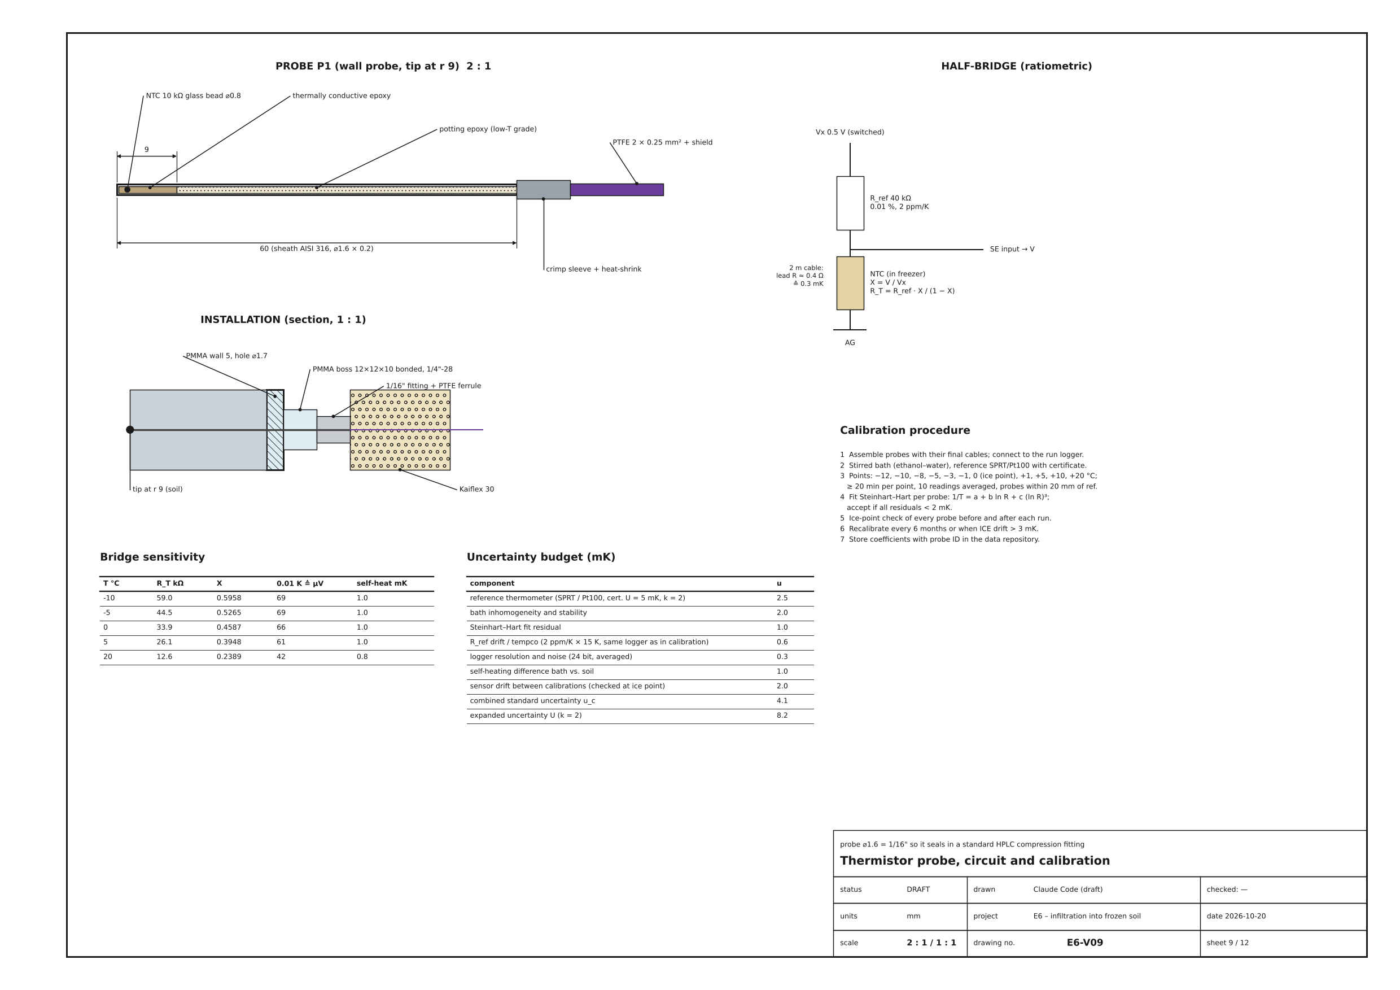
e6_frozen_infiltration/vykresy/E6-V09_thermistor_probe.png
