martinasobotkova5/my_data_projects/e6_frozen_infiltration/vykresy/E6-V10_asbuilt_freezer.png

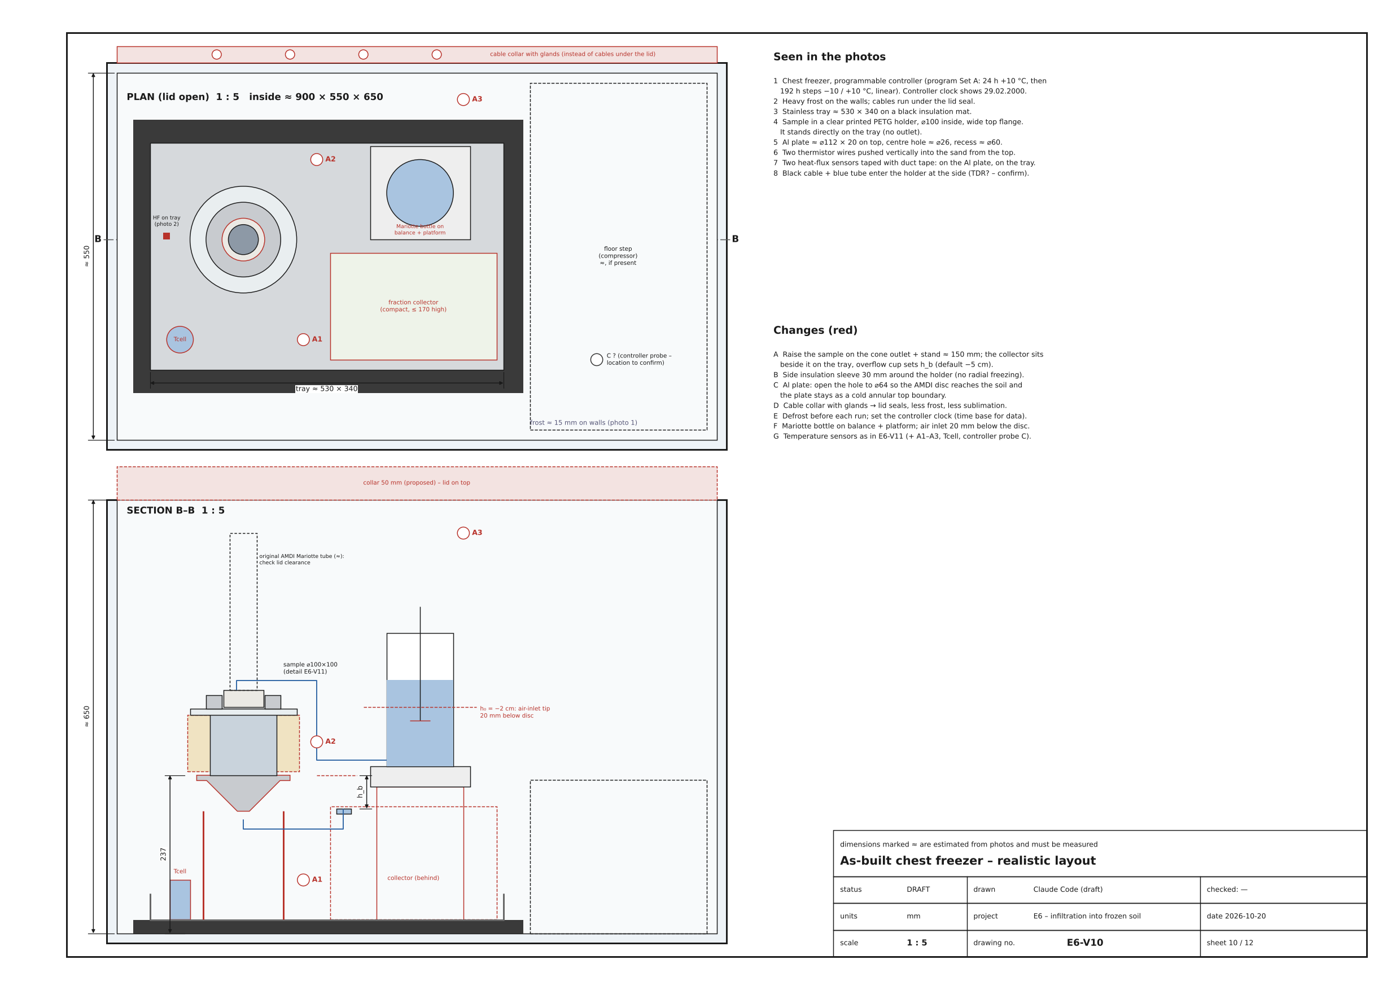
e6_frozen_infiltration/vykresy/E6-V10_asbuilt_freezer.png
