martinasobotkova5/my_data_projects/e6_frozen_infiltration/vykresy/E6-V11_holder_sensors.png

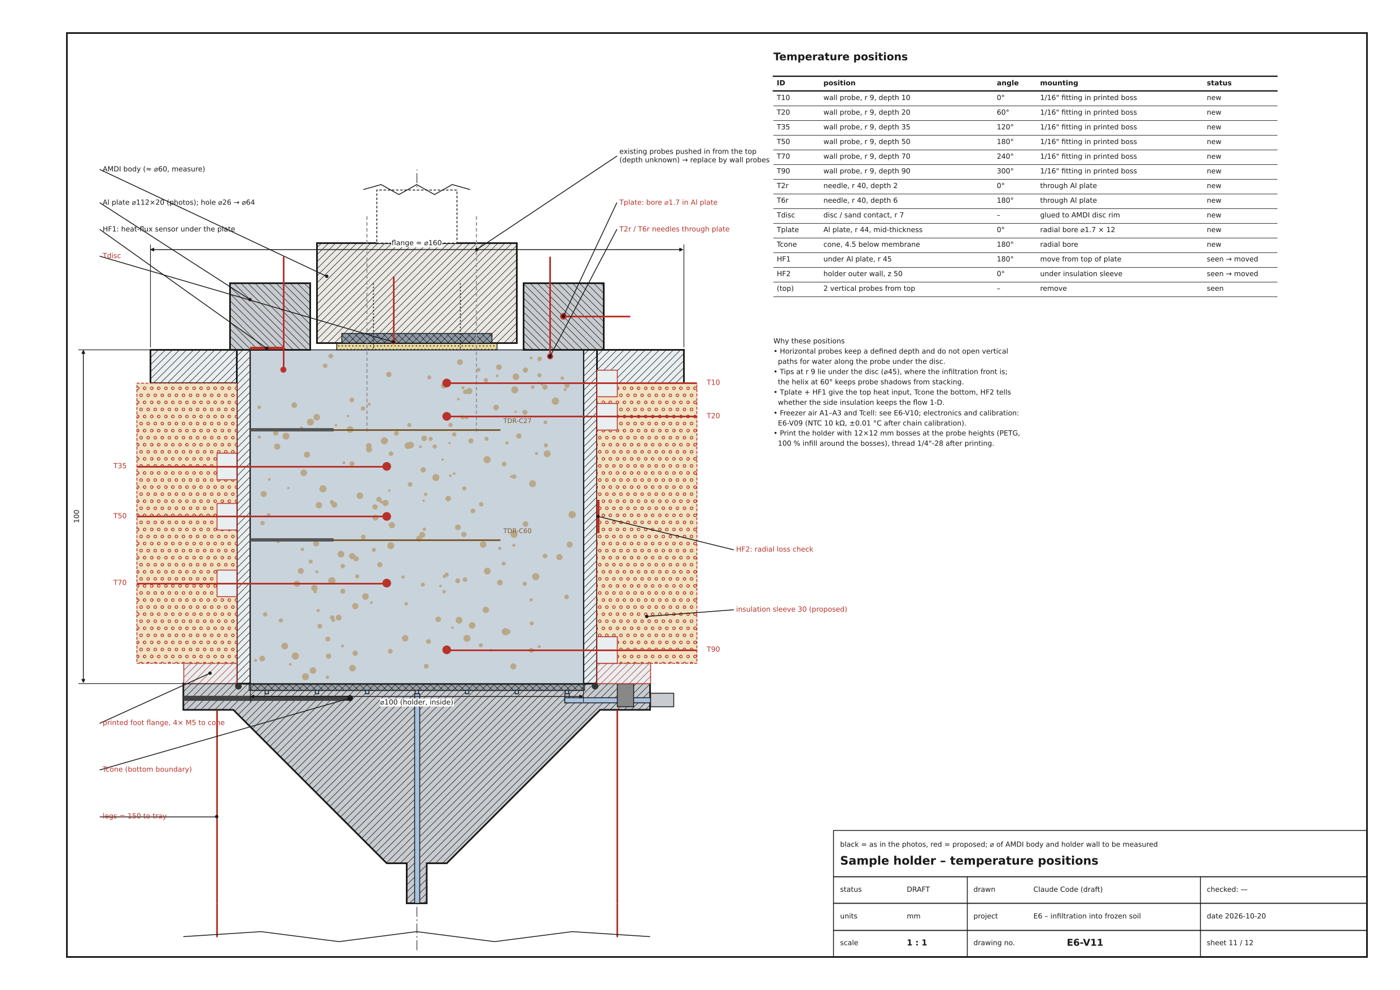
e6_frozen_infiltration/vykresy/E6-V11_holder_sensors.png
