martinasobotkova5/my_data_projects/e7_frost_heave_load/3d/E7_V02_variant_A_tie_rods_section.png

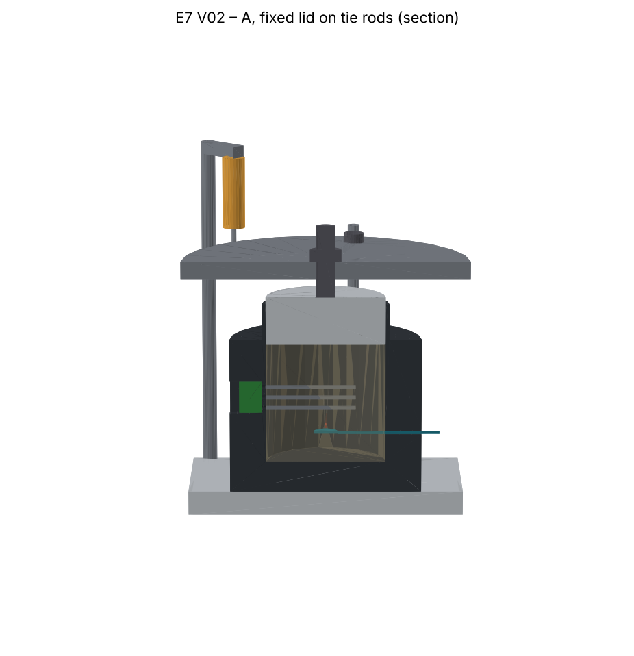
e7_frost_heave_load/3d/E7_V02_variant_A_tie_rods_section.png
