martinasobotkova5/my_data_projects/e7_frost_heave_load/3d/E7_V03_variant_A_frame.png

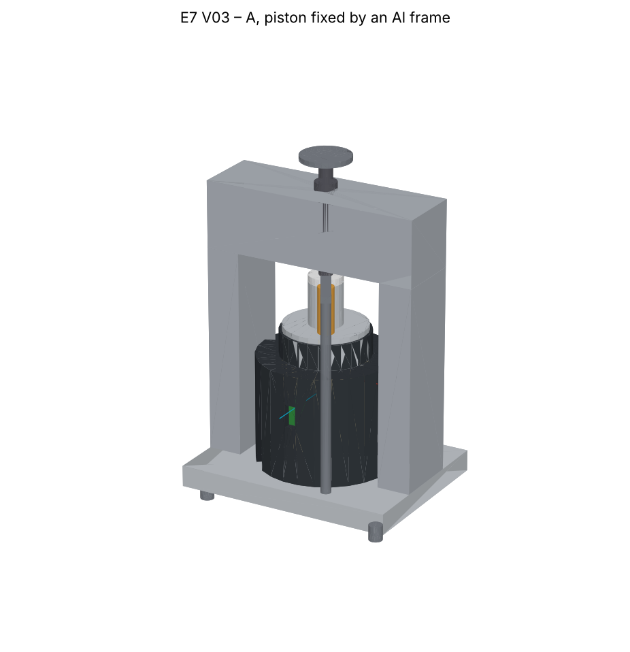
e7_frost_heave_load/3d/E7_V03_variant_A_frame.png
