martinasobotkova5/my_data_projects/e7_frost_heave_load/3d/E7_V05_variant_B_anchors.png

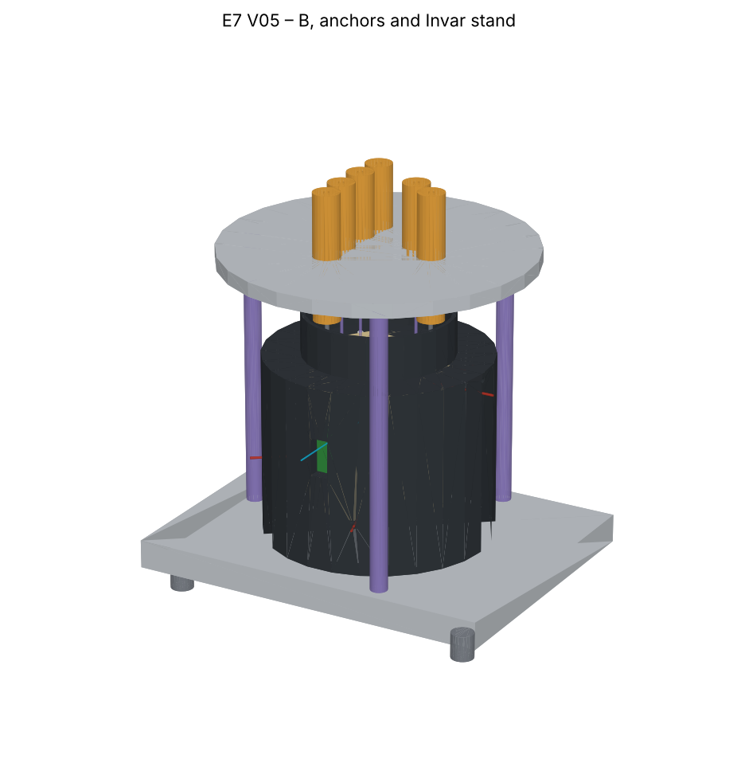
e7_frost_heave_load/3d/E7_V05_variant_B_anchors.png
