martinasobotkova5/my_data_projects/e7_frost_heave_load/cad/E7_V04_cell.png

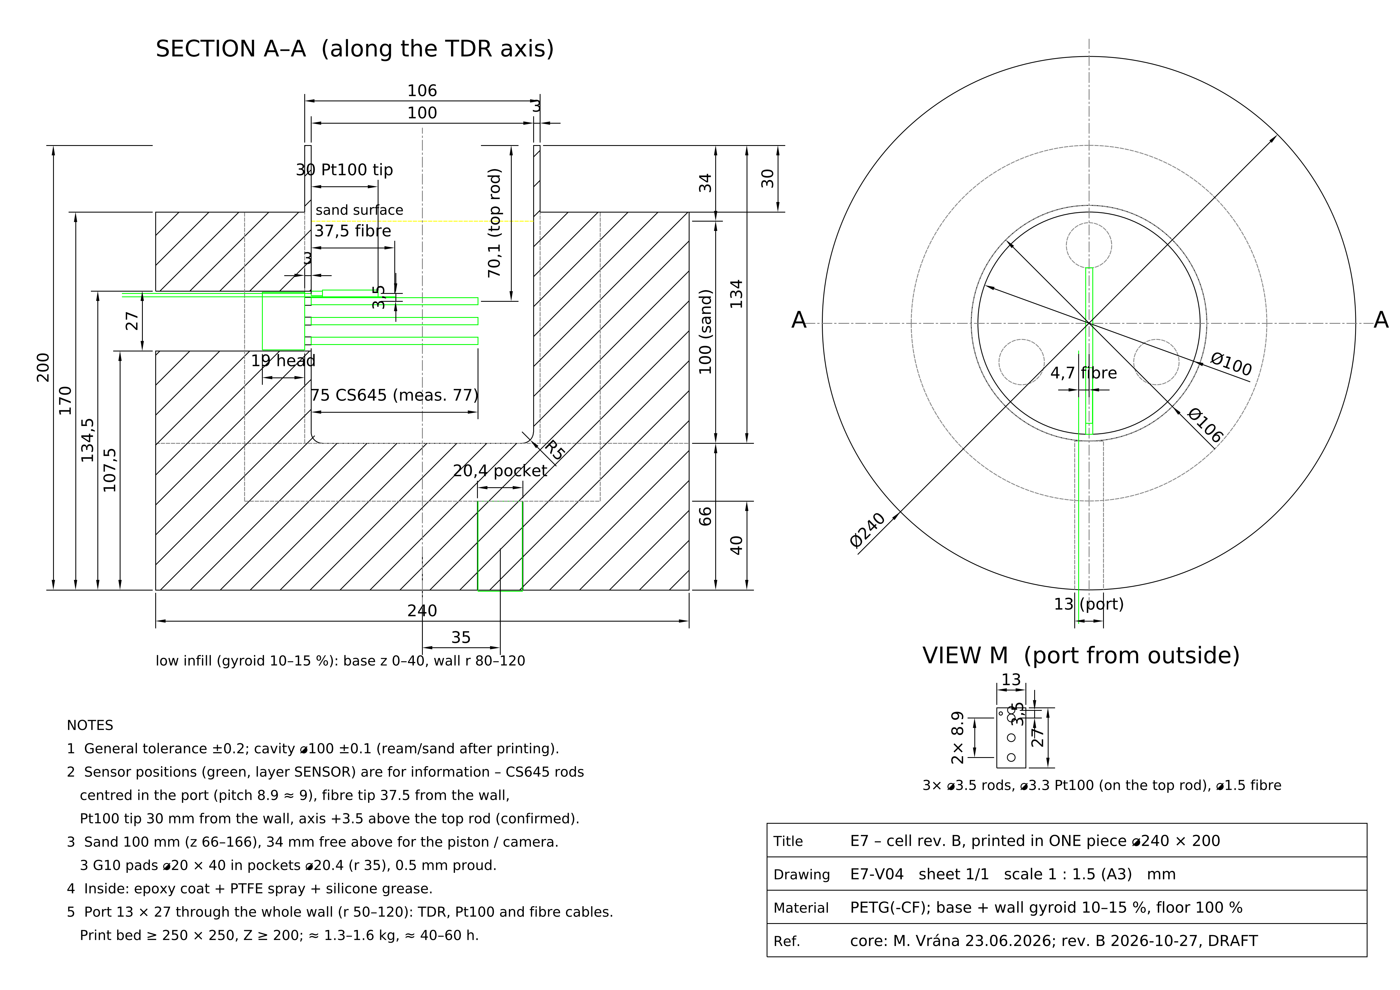
e7_frost_heave_load/cad/E7_V04_cell.png
