martinasobotkova5/my_data_projects/e7_frost_heave_load/sdileni/vyroba/vykresy/E7-B01_invar_rod.png

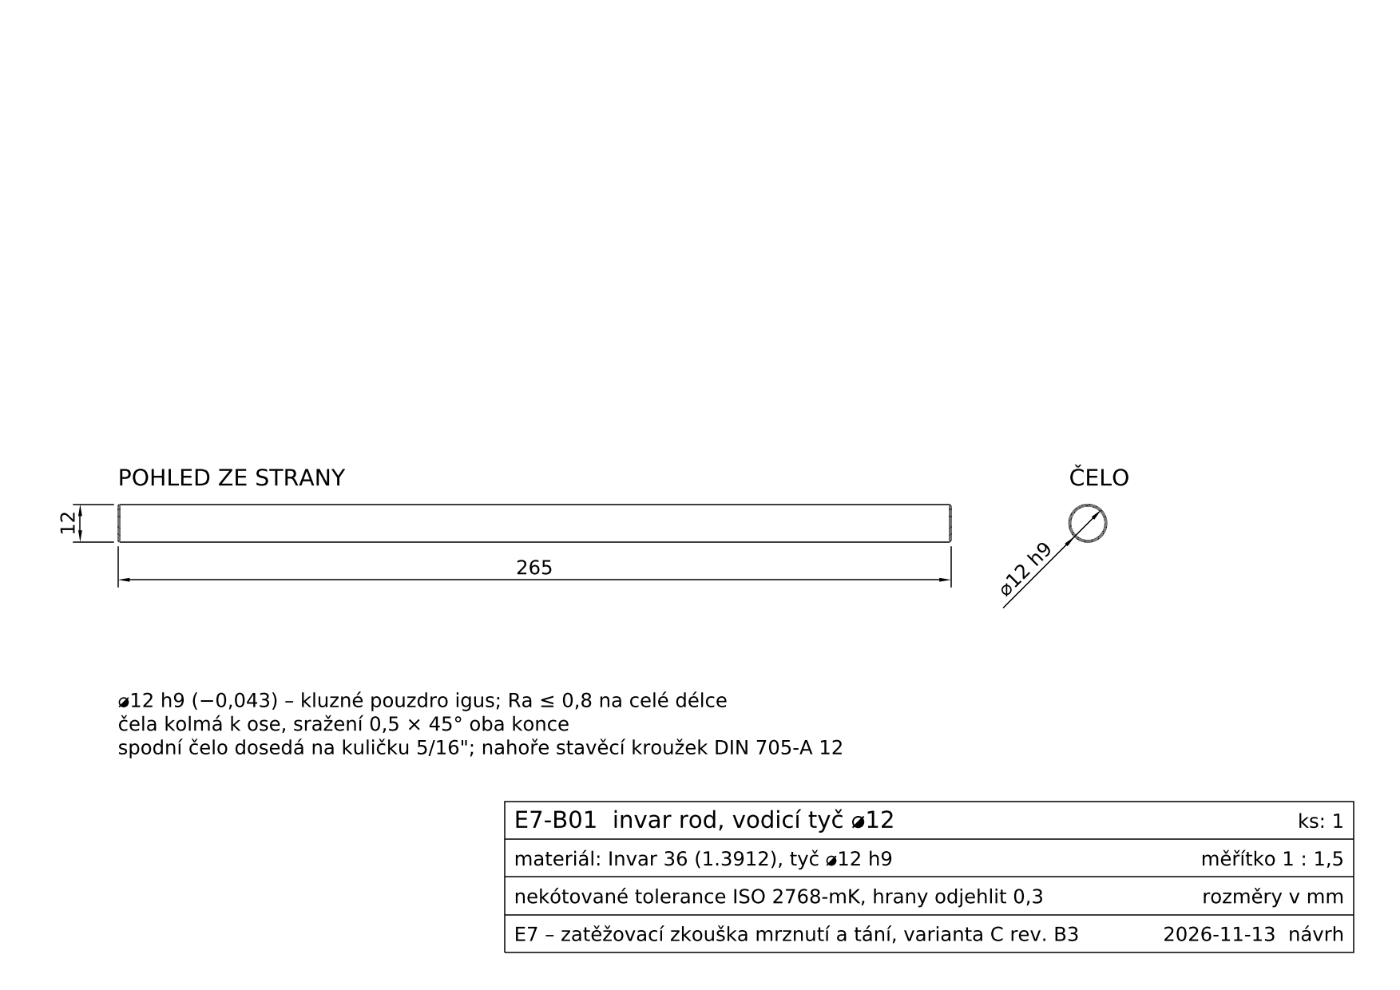
e7_frost_heave_load/sdileni/vyroba/vykresy/E7-B01_invar_rod.png
