martinasobotkova5/my_data_projects/e7_frost_heave_load/sdileni/vyroba/vykresy/E7-L01_base_plate.png

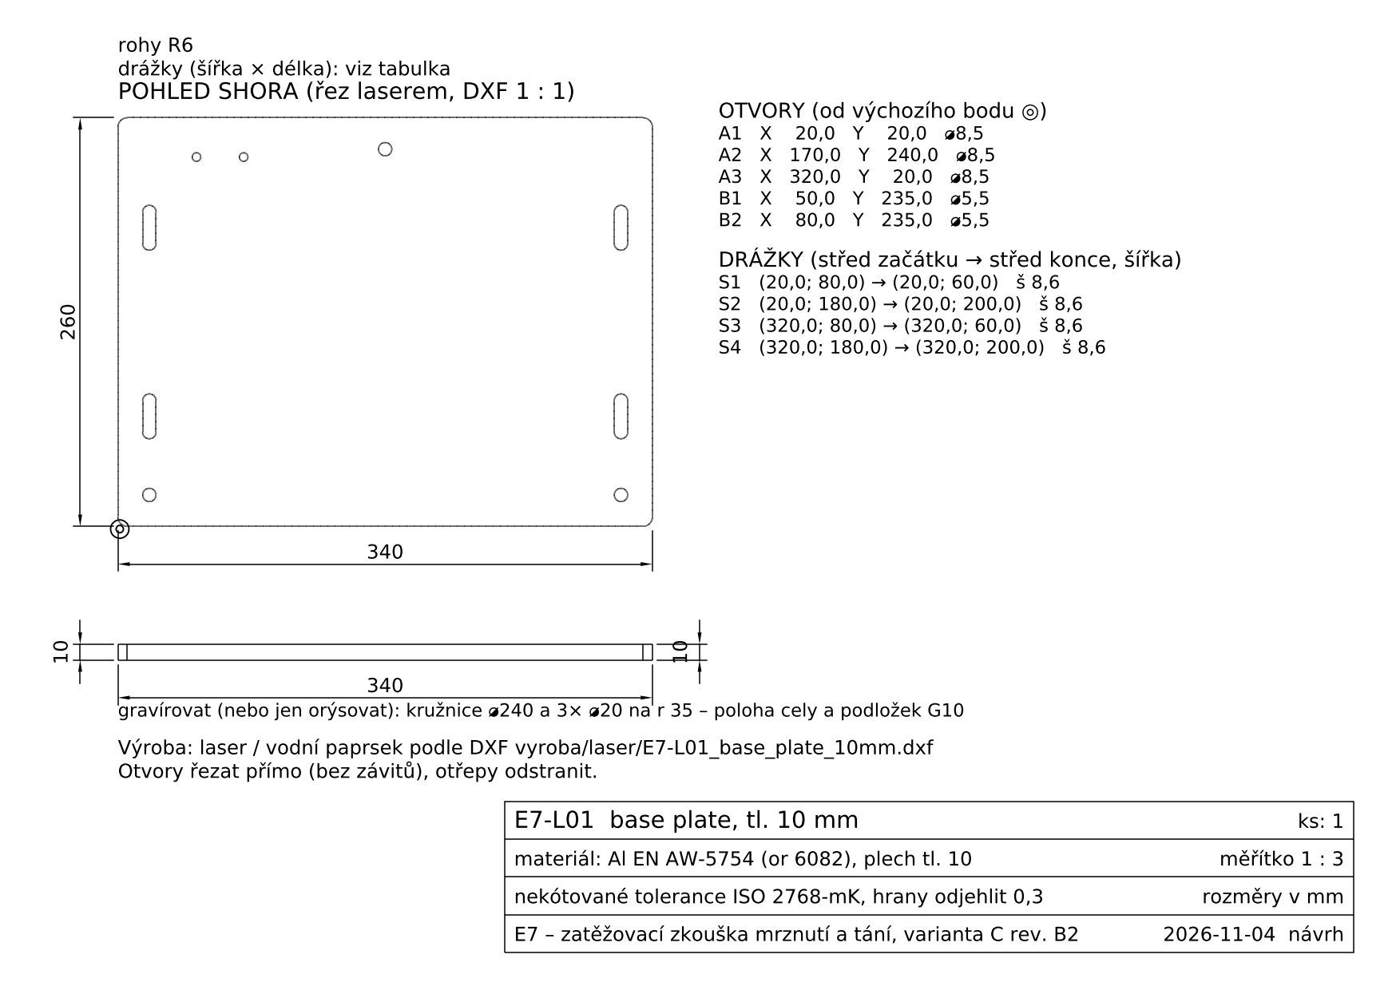
e7_frost_heave_load/sdileni/vyroba/vykresy/E7-L01_base_plate.png
