martinasobotkova5/my_data_projects/e7_frost_heave_load/sdileni/vyroba/vykresy/E7-P01_bearing_housing.png

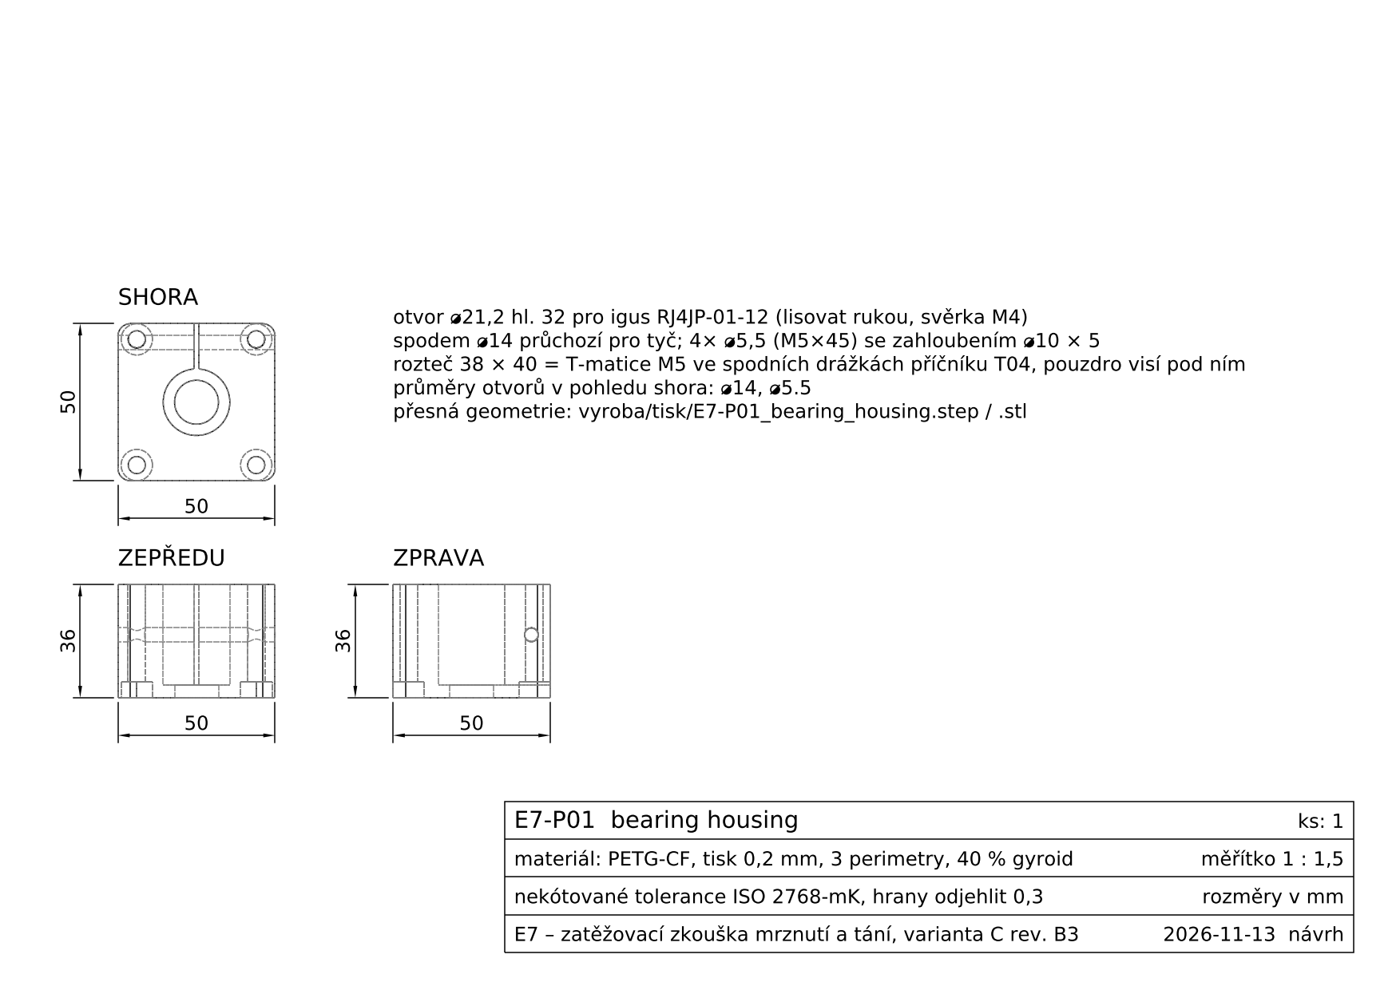
e7_frost_heave_load/sdileni/vyroba/vykresy/E7-P01_bearing_housing.png
