martinasobotkova5/my_data_projects/e7_frost_heave_load/sdileni/vyroba/vykresy/E7-T04_top_beam.png

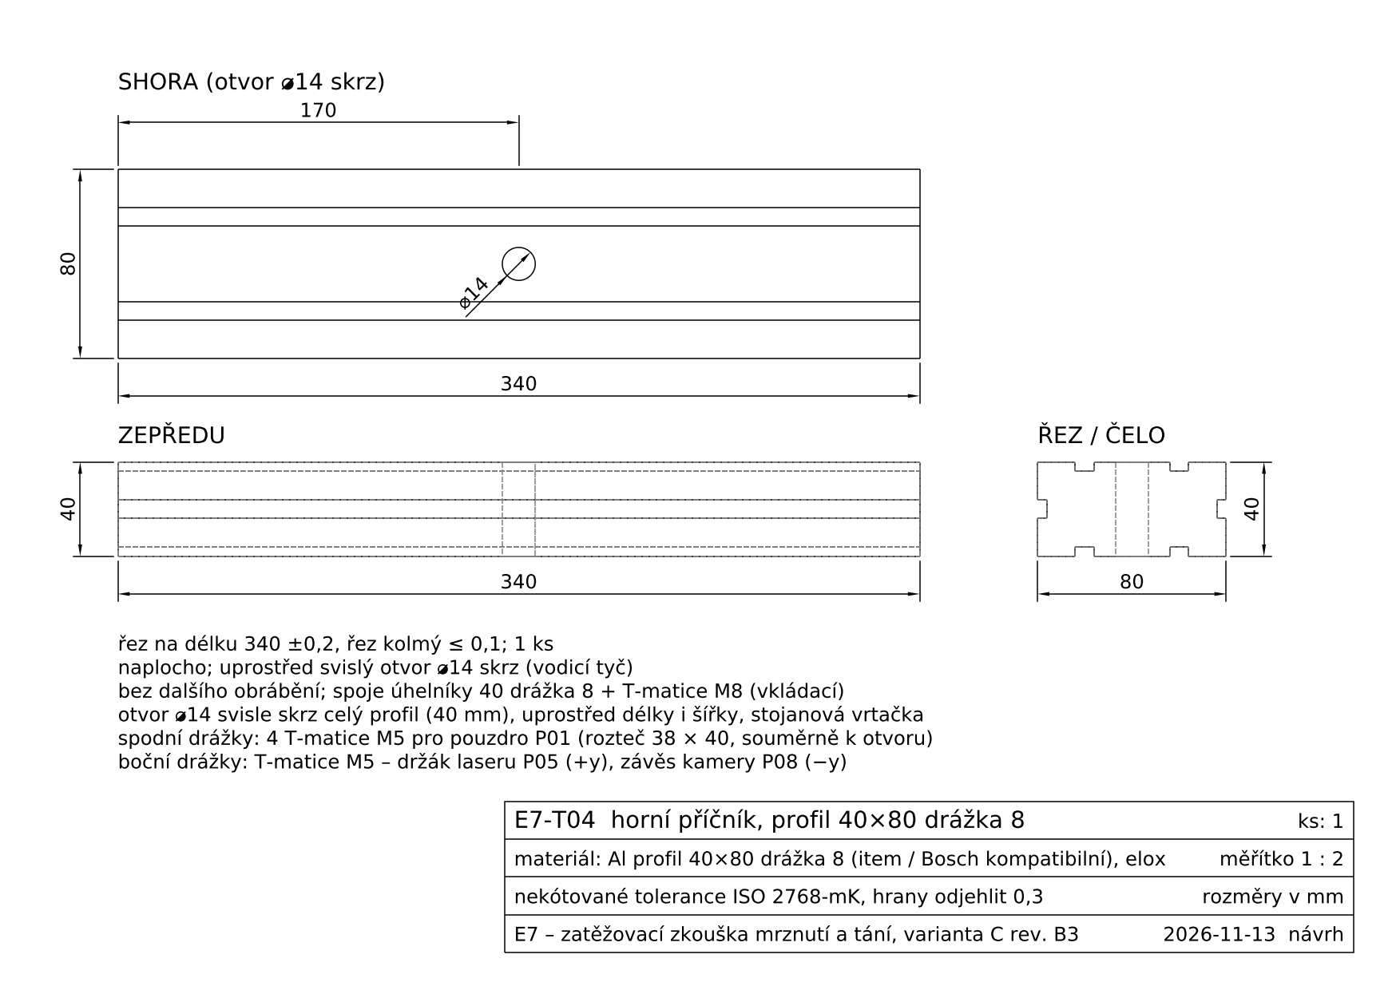
e7_frost_heave_load/sdileni/vyroba/vykresy/E7-T04_top_beam.png
