martinasobotkova5/my_data_projects/e7_frost_heave_load/vykresy/E7-V01_rig_C.png

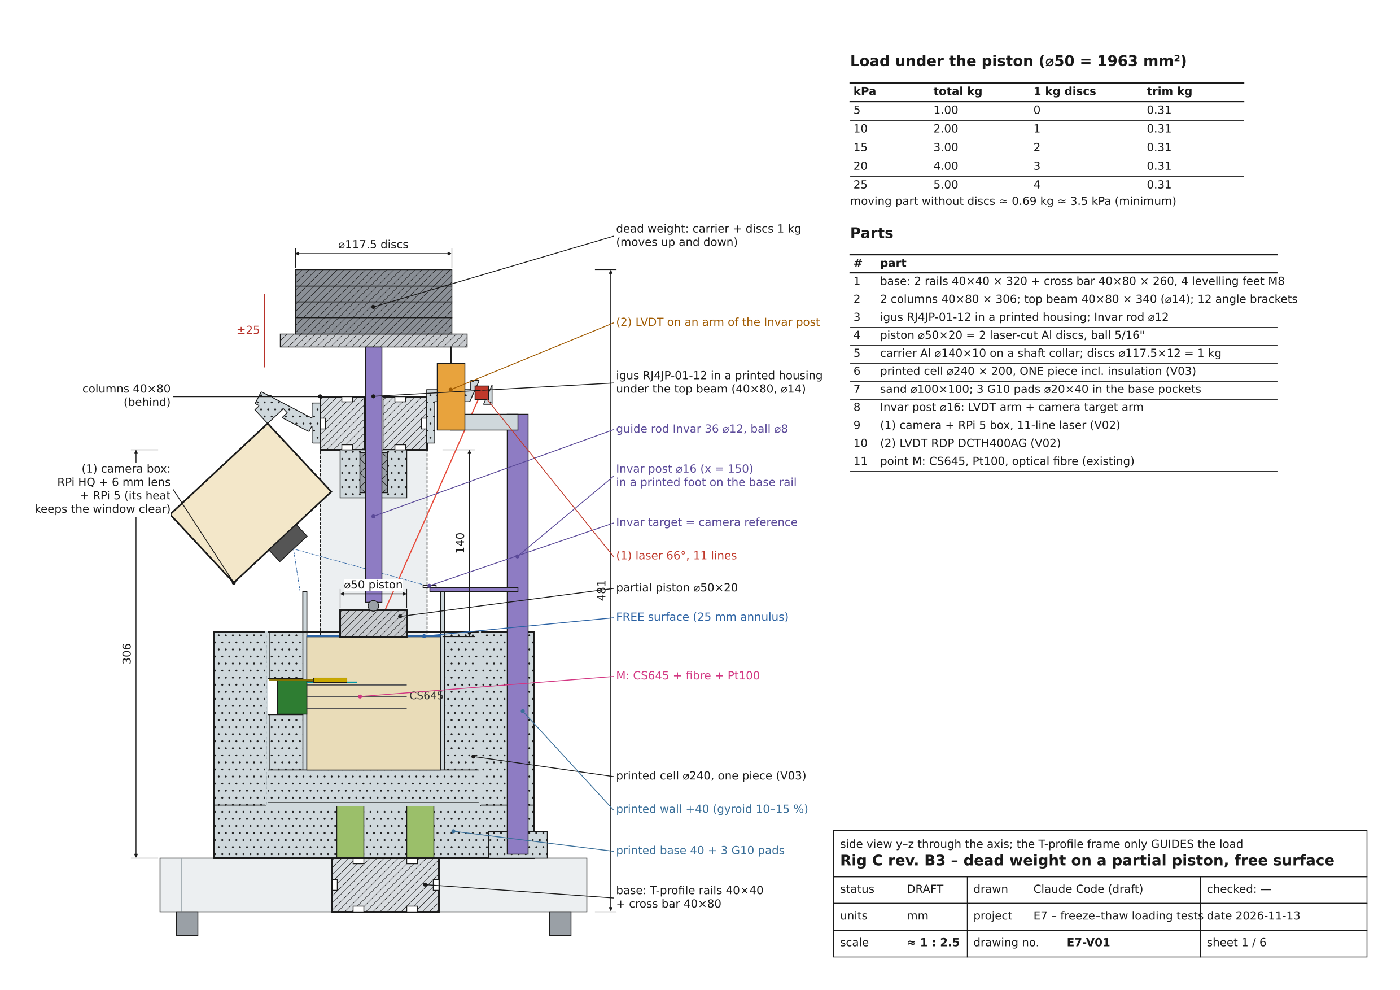
e7_frost_heave_load/vykresy/E7-V01_rig_C.png
