martinasobotkova5/my_data_projects/e7_frost_heave_load/vykresy/E7-V01_variant_A_constant_load.png

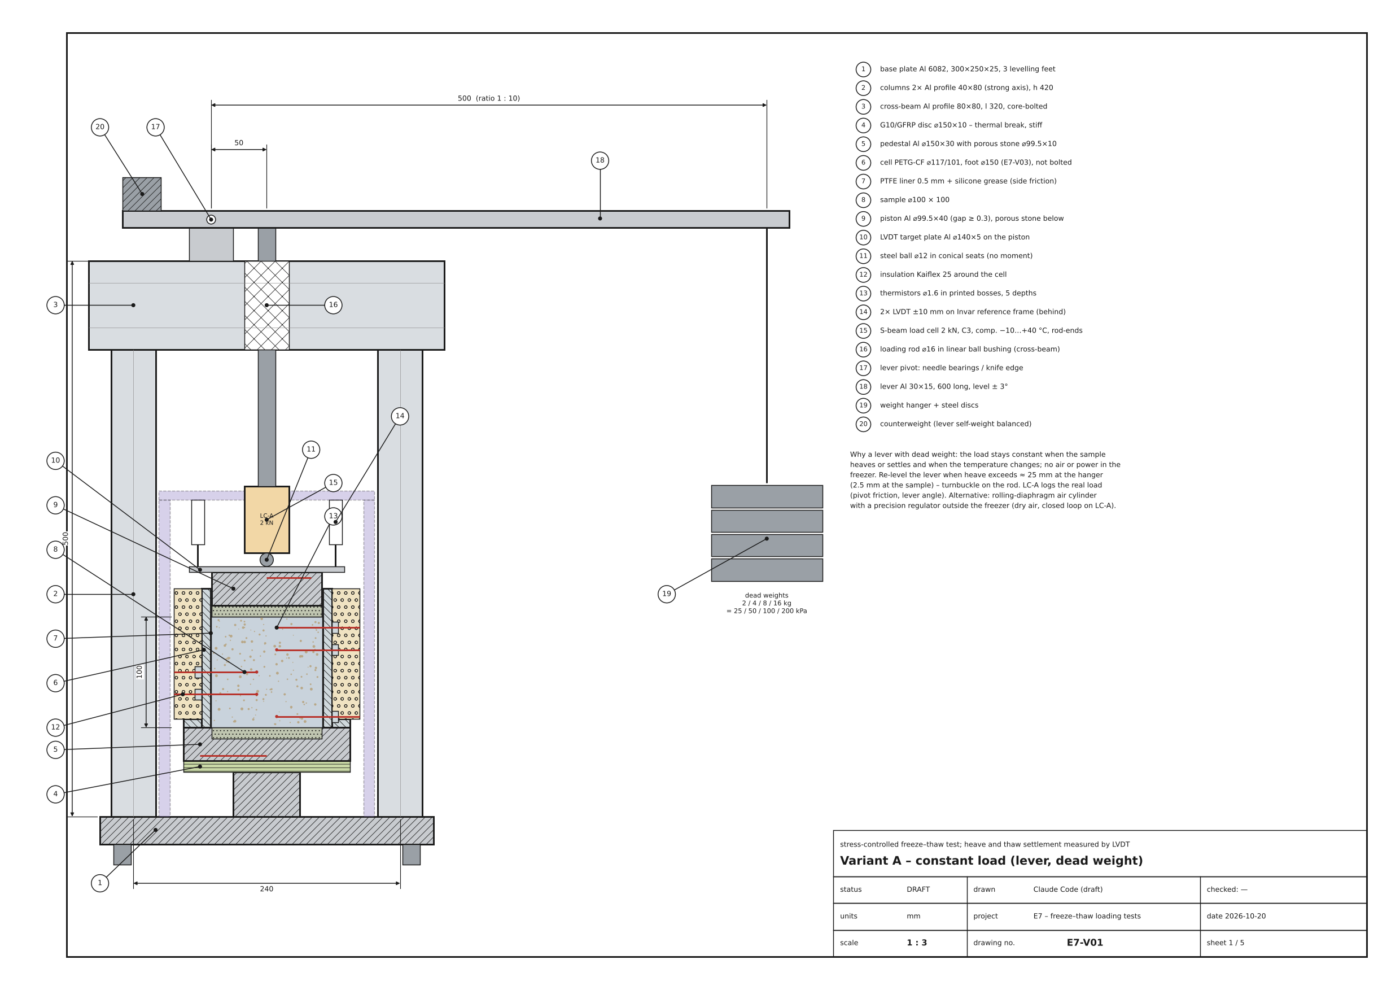
e7_frost_heave_load/vykresy/E7-V01_variant_A_constant_load.png
