martinasobotkova5/my_data_projects/e7_frost_heave_load/vykresy/E7-V02_variant_A_min.png

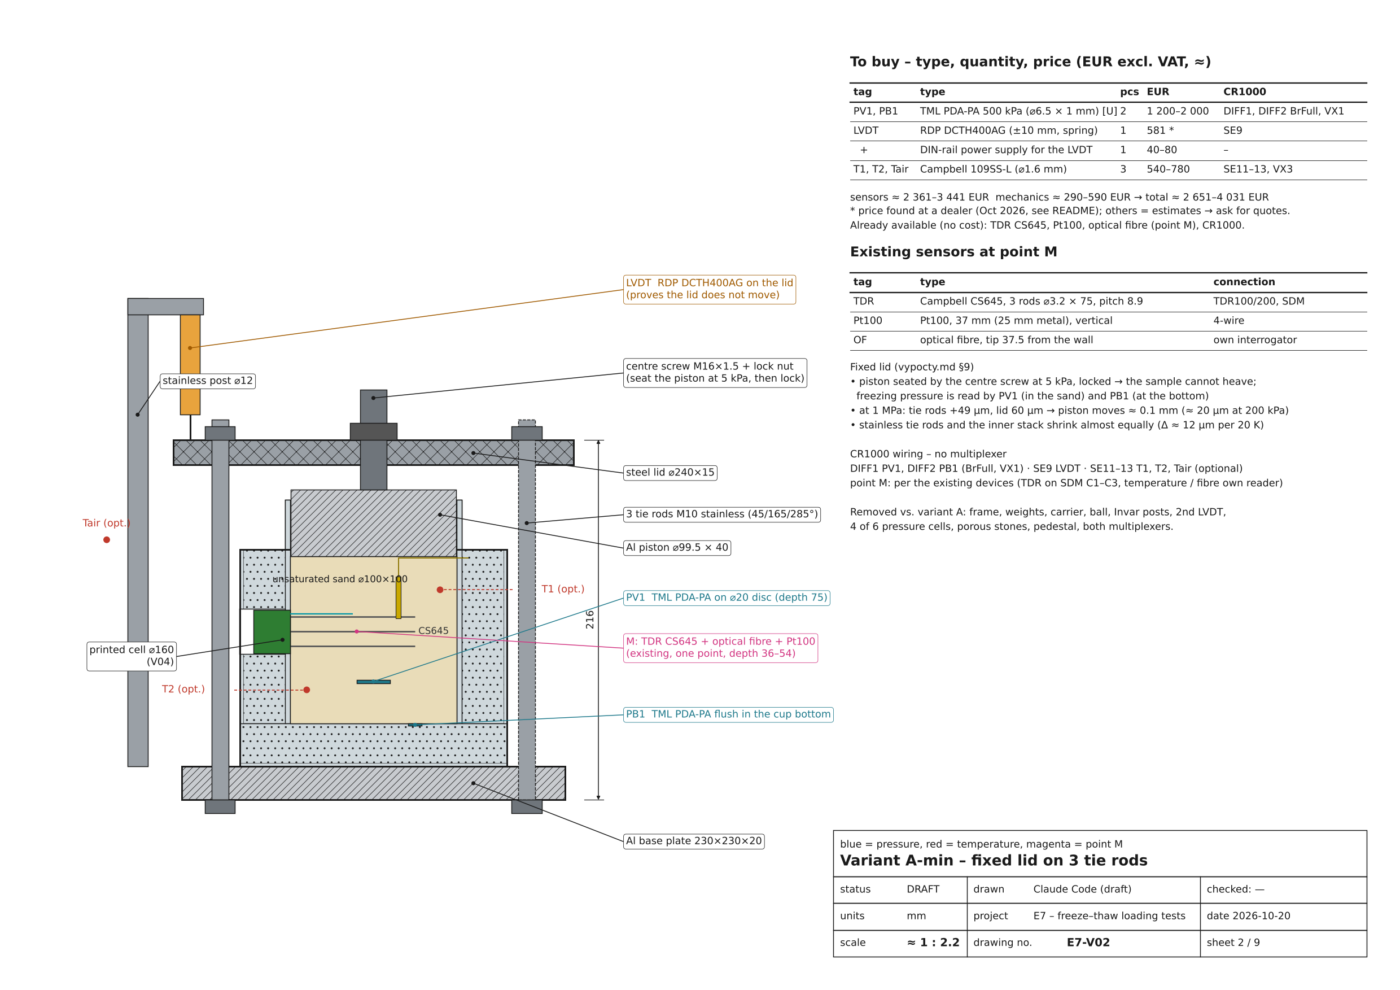
e7_frost_heave_load/vykresy/E7-V02_variant_A_min.png
