martinasobotkova5/my_data_projects/e7_frost_heave_load/vykresy/E7-V02_variant_B_scheme.png

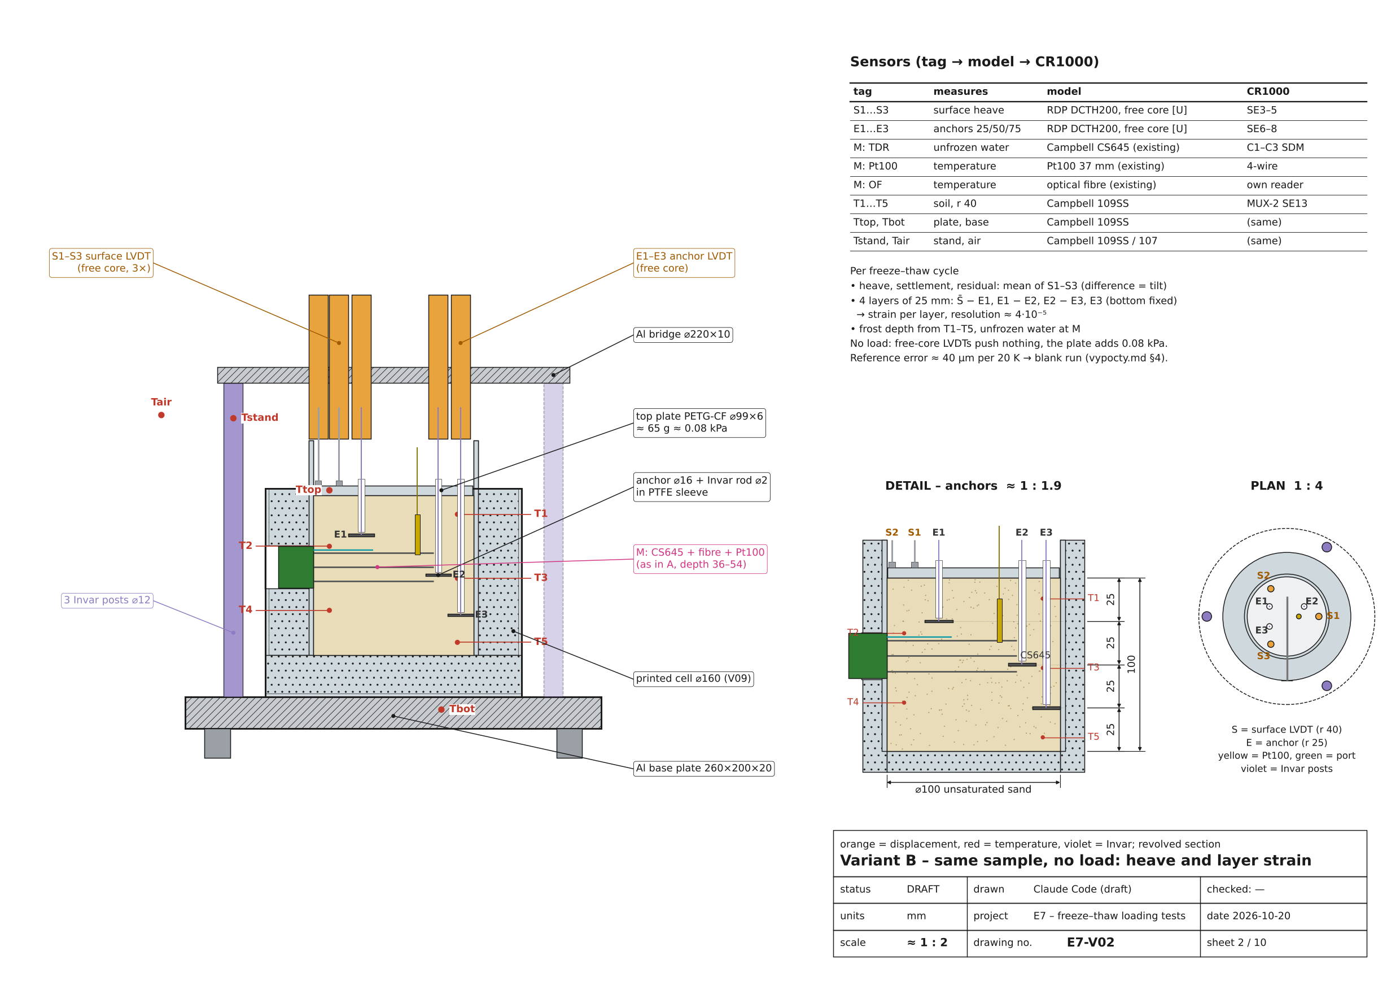
e7_frost_heave_load/vykresy/E7-V02_variant_B_scheme.png
