martinasobotkova5/my_data_projects/e7_frost_heave_load/vykresy/E7-V03_cell_PETG-CF.png

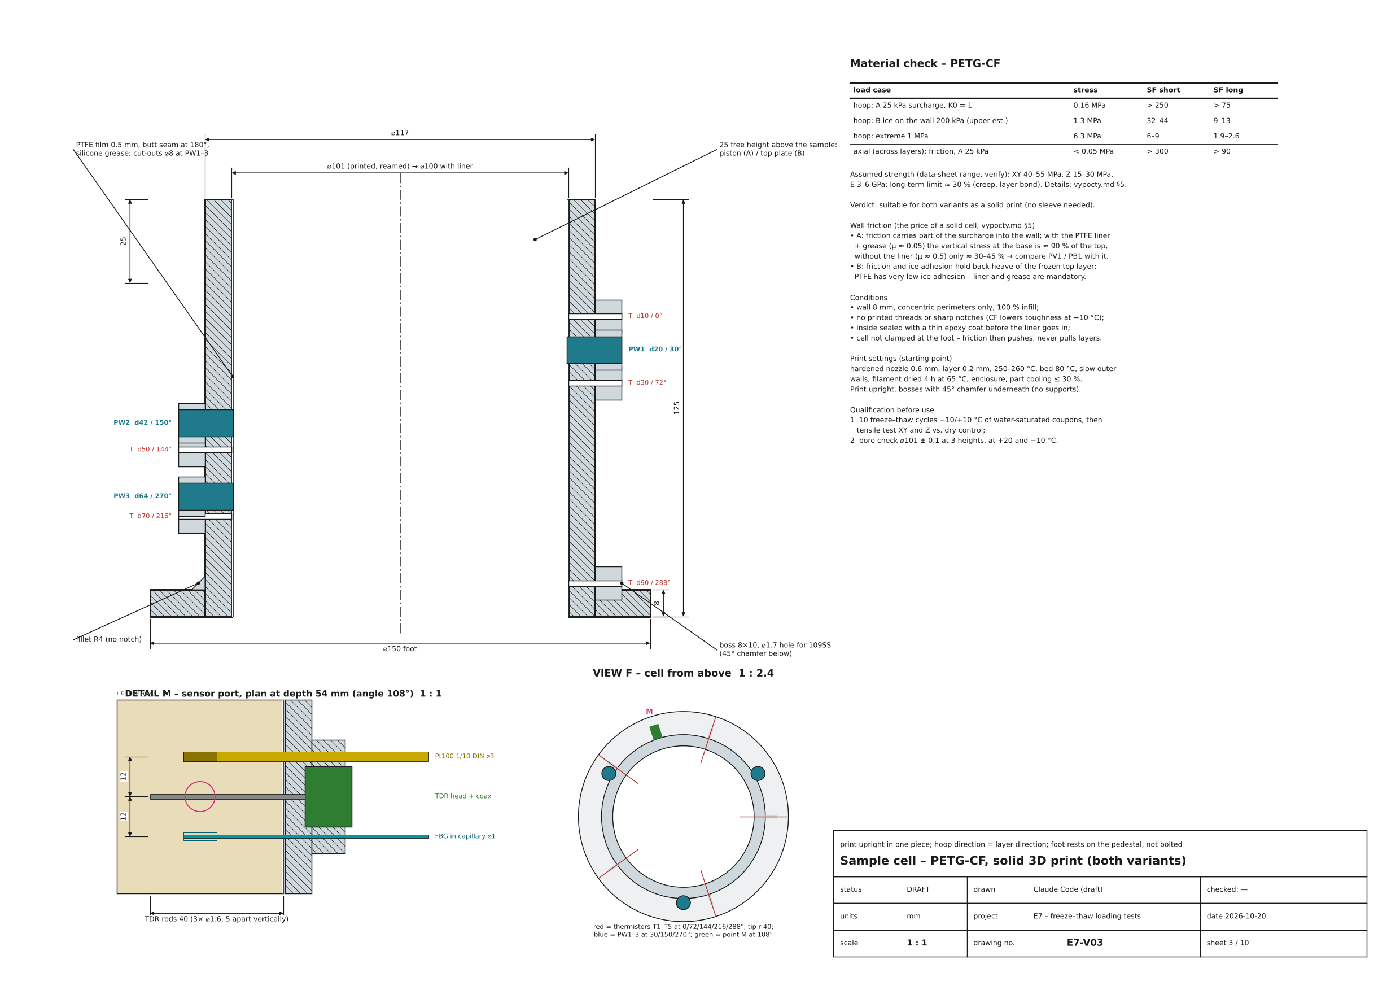
e7_frost_heave_load/vykresy/E7-V03_cell_PETG-CF.png
