martinasobotkova5/my_data_projects/e7_frost_heave_load/vykresy/E7-V03_variant_A_frame.png

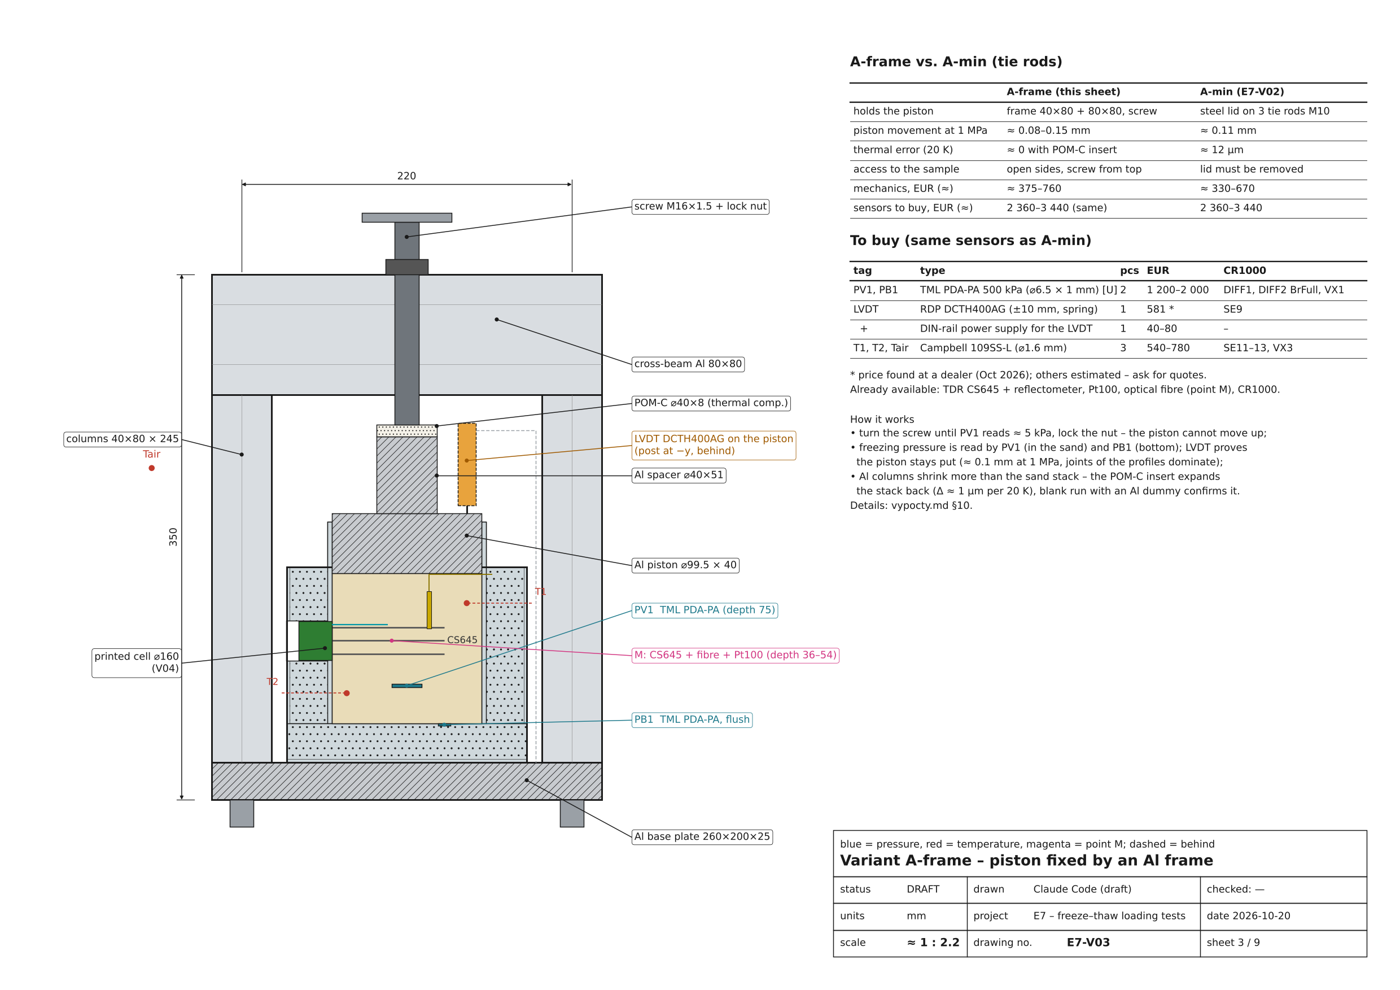
e7_frost_heave_load/vykresy/E7-V03_variant_A_frame.png
