martinasobotkova5/my_data_projects/e7_frost_heave_load/vykresy/E7-V04_cup_A.png

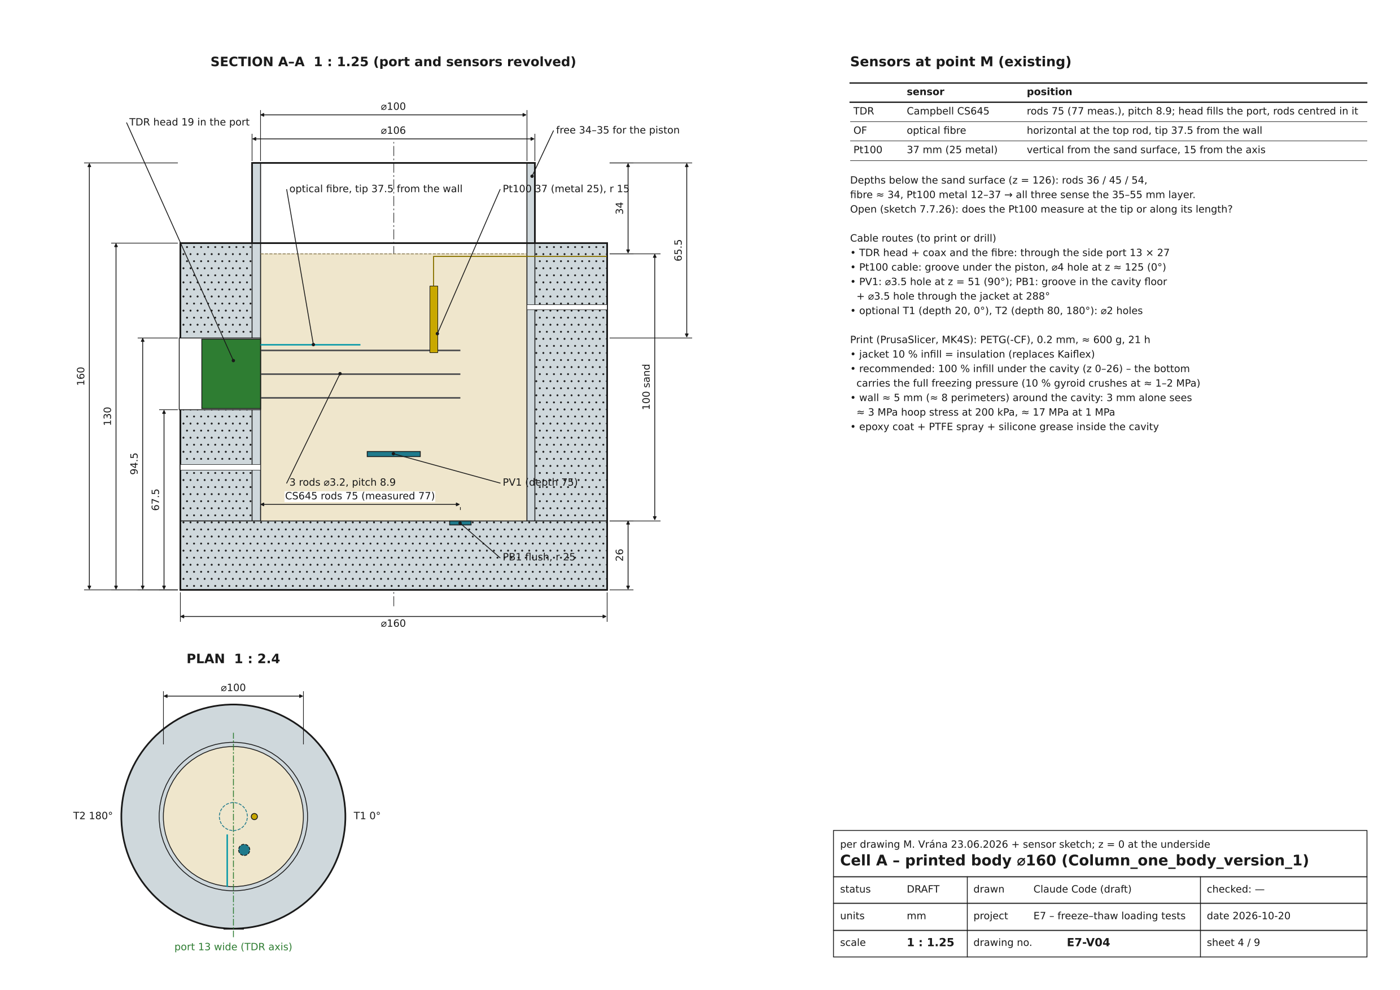
e7_frost_heave_load/vykresy/E7-V04_cup_A.png
