martinasobotkova5/my_data_projects/e7_frost_heave_load/vykresy/E7-V05_instrumentation.png

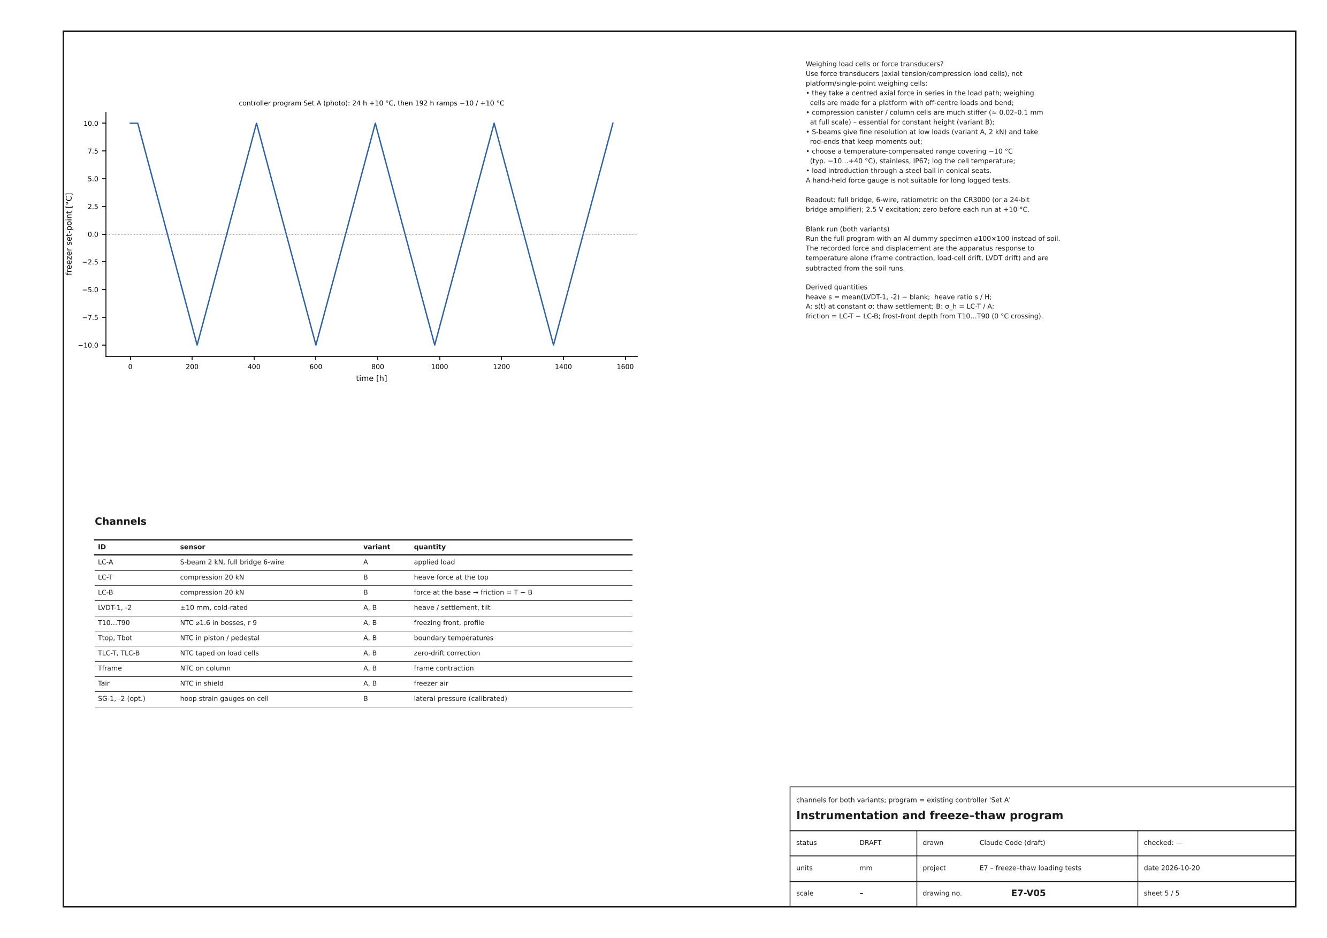
e7_frost_heave_load/vykresy/E7-V05_instrumentation.png
