martinasobotkova5/my_data_projects/e7_frost_heave_load/vykresy/E7-V07_variant_A2_spring.png

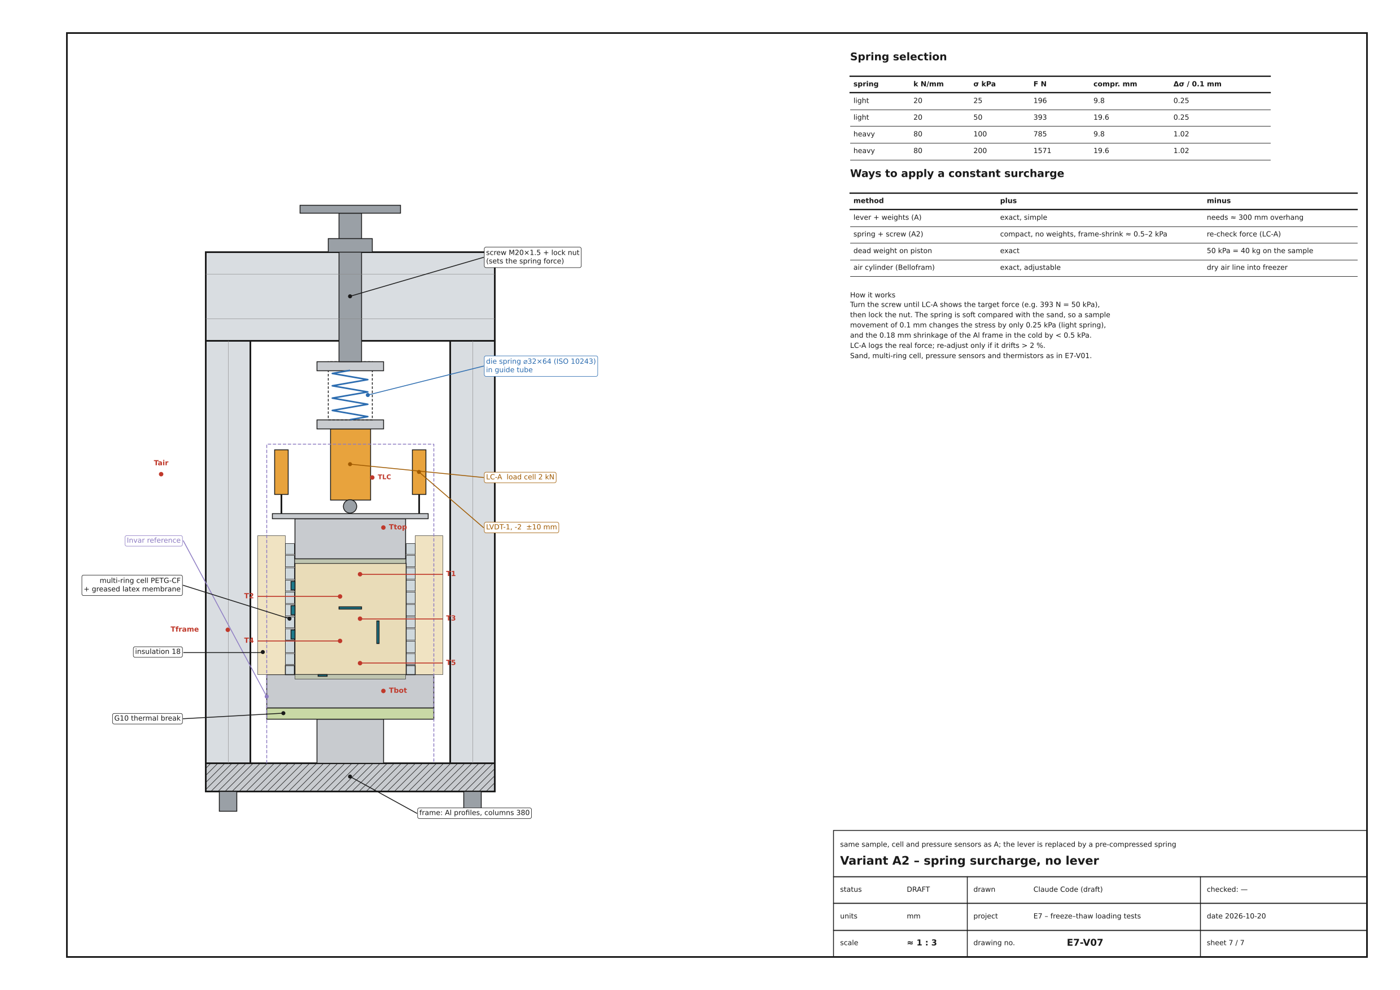
e7_frost_heave_load/vykresy/E7-V07_variant_A2_spring.png
