martinasobotkova5/my_data_projects/e7_frost_heave_load/vykresy/E7-V08_freezer_layout.png

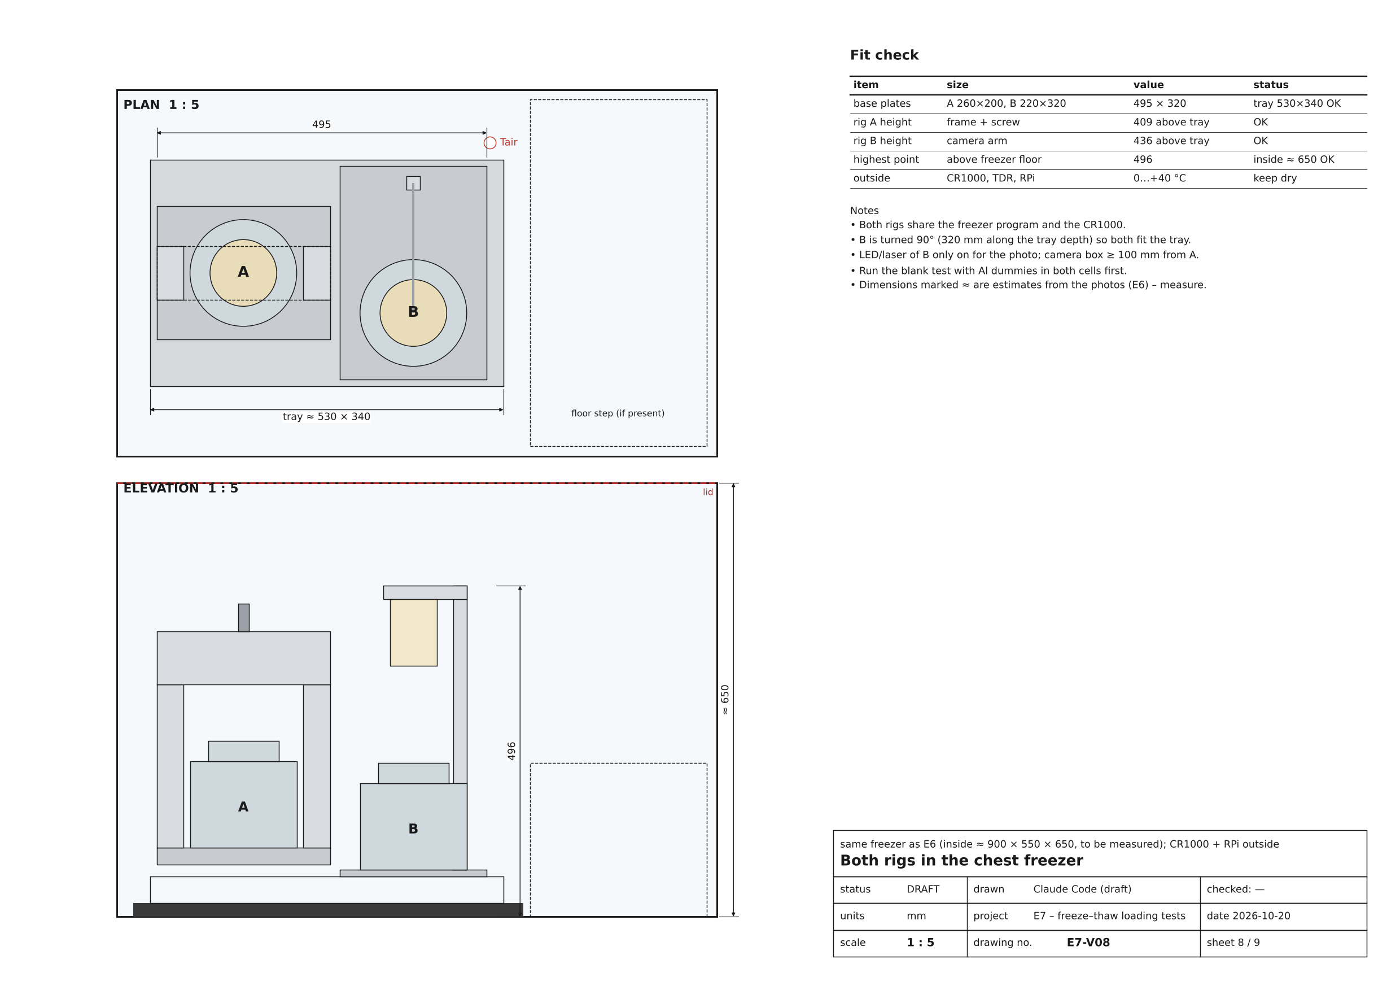
e7_frost_heave_load/vykresy/E7-V08_freezer_layout.png
