martinasobotkova5/my_data_projects/e7_frost_heave_load/vykresy/E7-V09_variant_C_combined.png

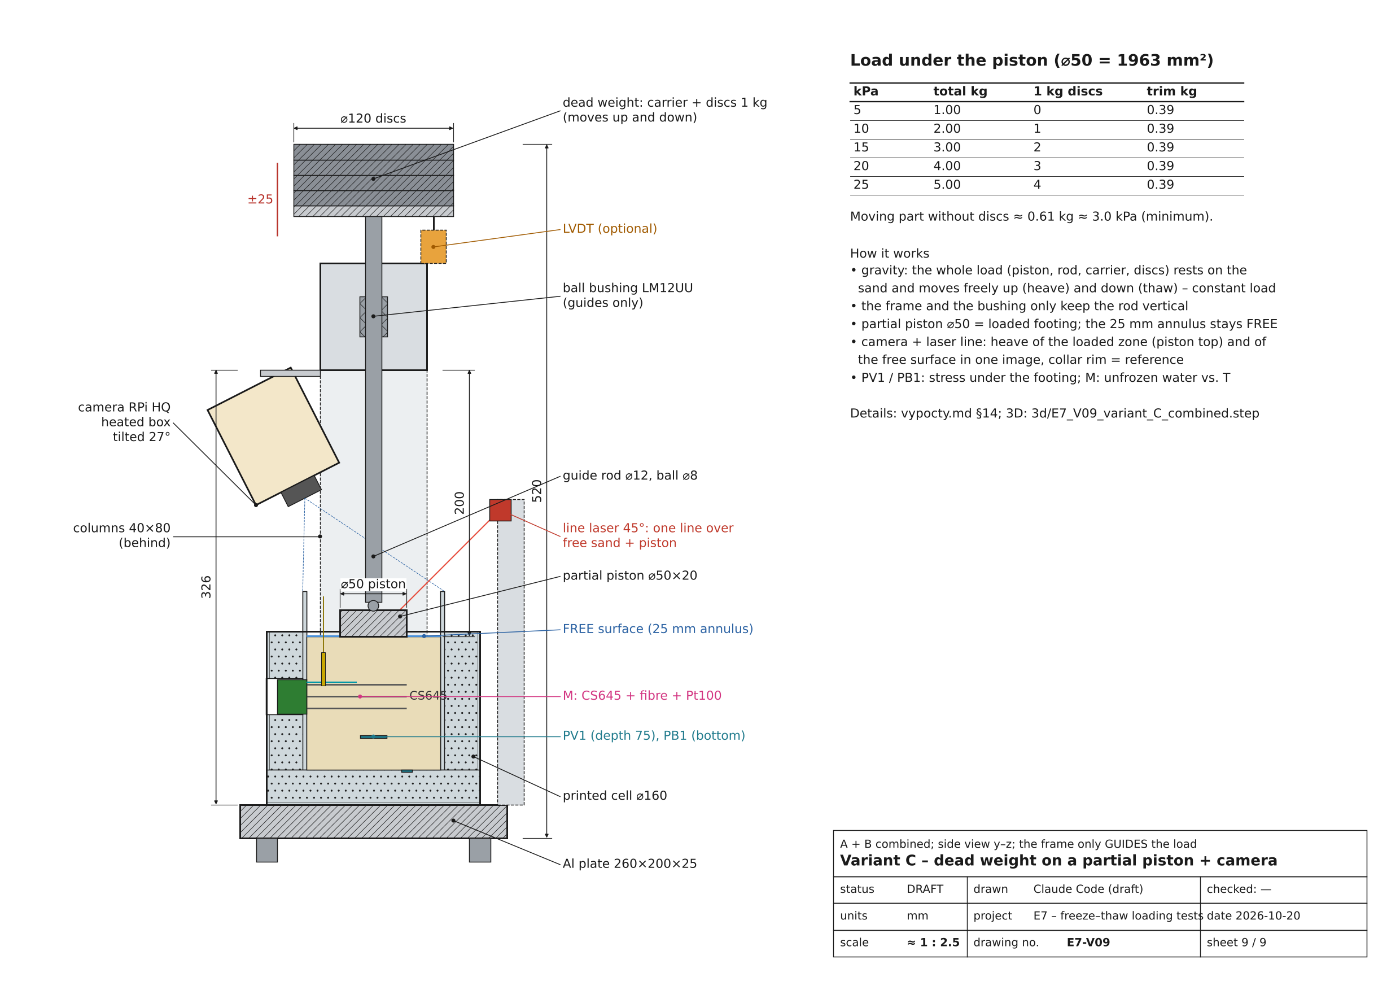
e7_frost_heave_load/vykresy/E7-V09_variant_C_combined.png
