martinasobotkova5/my_data_projects/e7_frost_heave_load/3d/parts_V01_variant_C/G10_pad_D20x40_2.step

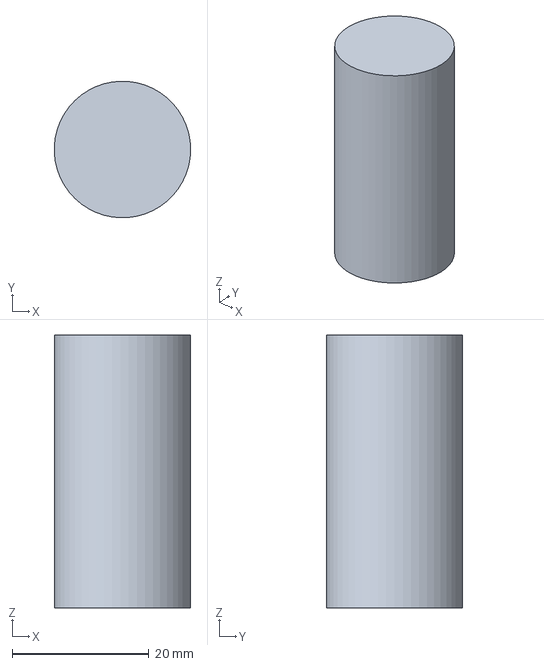
[picture p81: CAD file, 2026-11-13]
e7_frost_heave_load/3d/parts_V01_variant_C/G10_pad_D20x40_2.step
20.0 x 20.0 x 40.0 mm
