martinasobotkova5/my_data_projects/e7_frost_heave_load/3d/parts_V03_variant_A_frame/LVDT_RDP_DCTH400AG.step

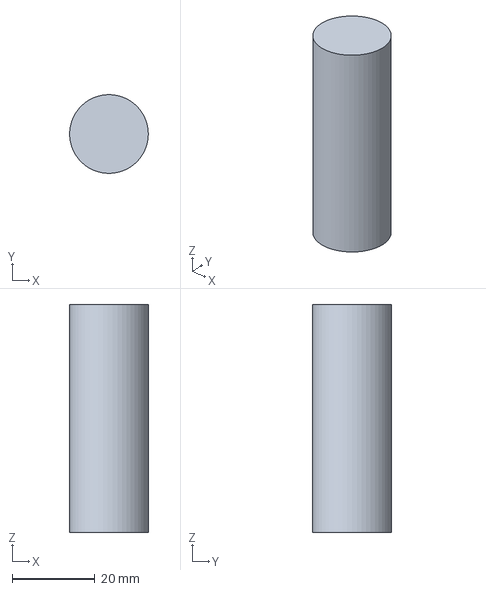
[picture p82: CAD file, 2026-10-26]
e7_frost_heave_load/3d/parts_V03_variant_A_frame/LVDT_RDP_DCTH400AG.step
19.0 x 19.0 x 55.0 mm
