martinasobotkova5/my_data_projects/e7_frost_heave_load/3d/parts_V06_variant_B_open/cell_body_PETG_D160__Column_one_body_version_1.step

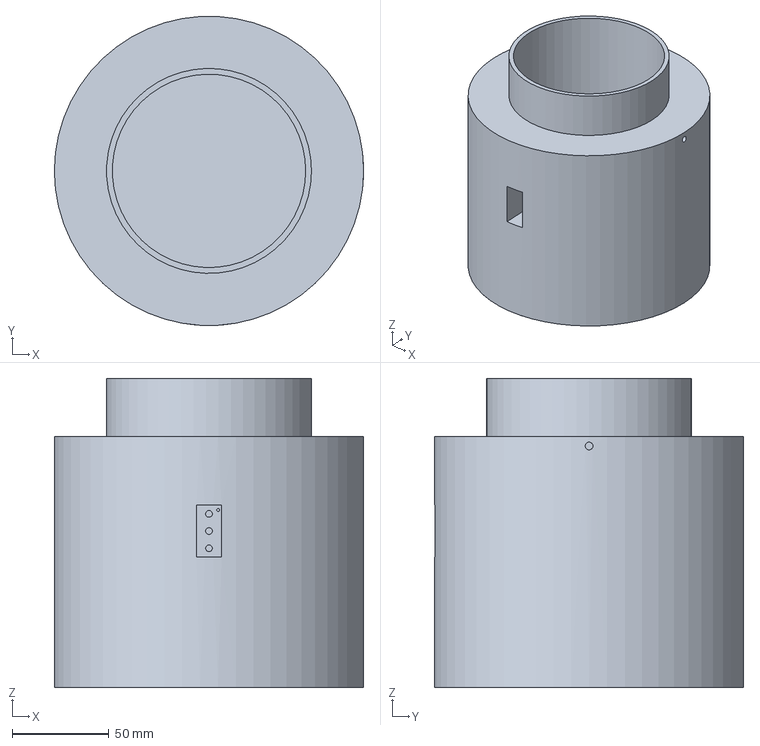
[picture p83: CAD file, 2026-10-26]
e7_frost_heave_load/3d/parts_V06_variant_B_open/cell_body_PETG_D160__Column_one_body_version_1.step
160.0 x 159.8 x 160.0 mm
