martinasobotkova5/my_data_projects/e7_frost_heave_load/sdileni/3d/E7_V03_cell.step

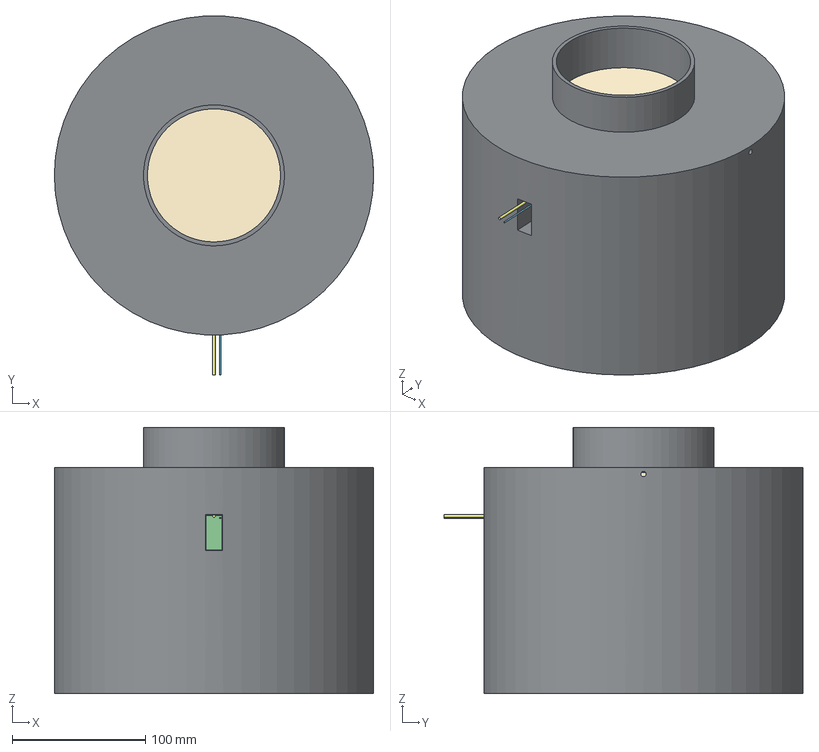
[picture p84: CAD file, 2026-11-09]
e7_frost_heave_load/sdileni/3d/E7_V03_cell.step
240.0 x 269.8 x 200.0 mm
cell PETG D240x200 one piece, rev. B (core Column_one_body_version_1)
unsaturated sand D100x100
M TDR CS645 head
M TDR CS645 rod 1
M TDR CS645 rod 2
M TDR CS645 rod 3
M optical fibre
M Pt100 metal part
M Pt100 cable
