martinasobotkova5/my_data_projects/e7_frost_heave_load/sdileni/cad/E7_V04_cell.dxf

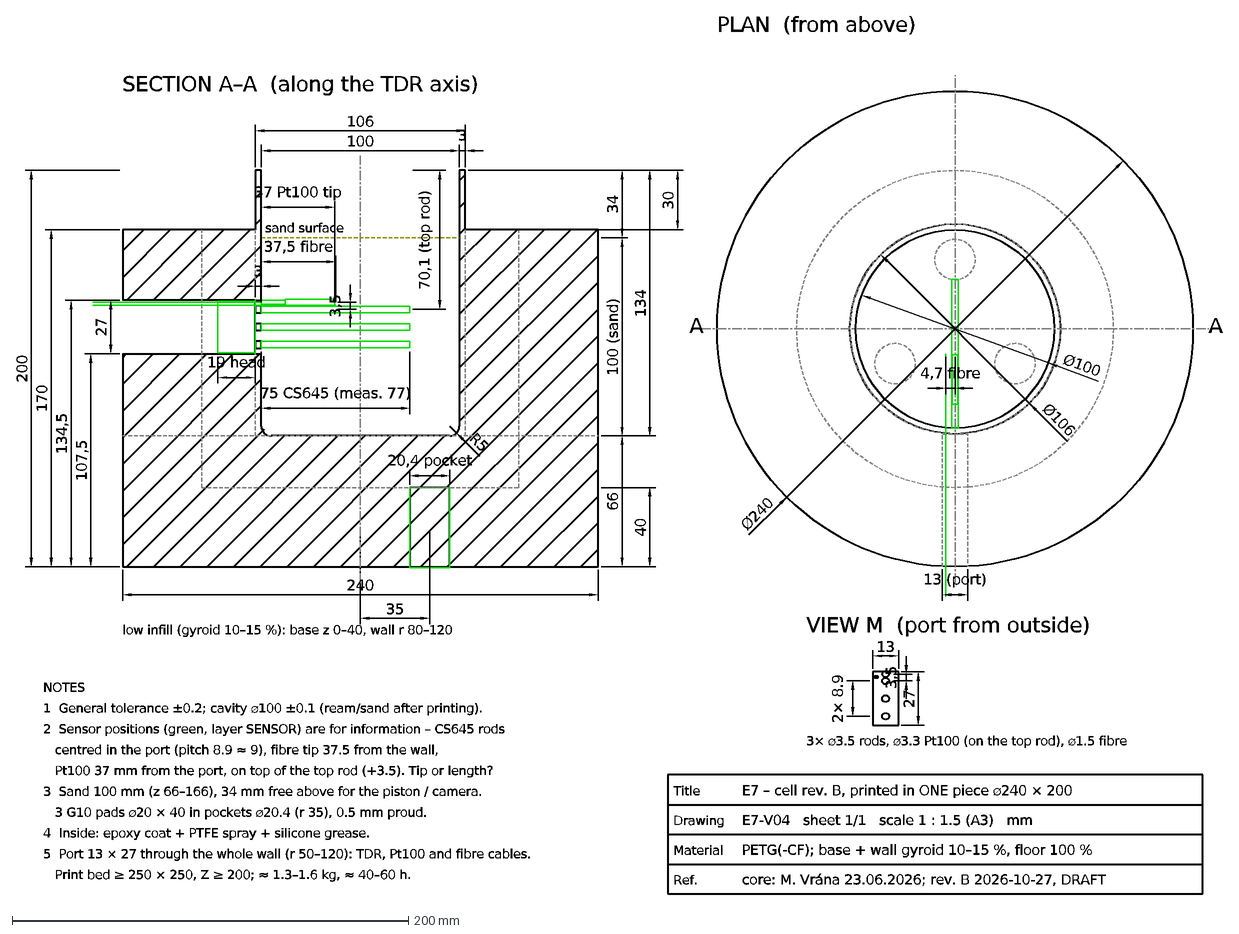
[picture p85: CAD file, 2026-10-27]
e7_frost_heave_load/sdileni/cad/E7_V04_cell.dxf
Title
E7 – cell rev. B, printed in ONE piece ⌀240 × 200
Drawing
E7-V04 sheet 1/1 scale 1 : 1.5 (A3) mm
Material
PETG(-CF); base + wall gyroid 10–15 %, floor 100 %
Ref.
core: M. Vrána 23.06.2026; rev. B 2026-10-27, DRAFT
NOTES
1 General tolerance ±0.2; cavity ⌀100 ±0.1 (ream/sand after printing).
2 Sensor positions (green, layer SENSOR) are for information – CS645 rods
centred in the port (pitch 8.9 ≈ 9), fibre tip 37.5 from the wall,
Pt100 37 mm from the port, on top of the top rod (+3.5). Tip or length?
3 Sand 100 mm (z 66–166), 34 mm free above for the piston / camera.
3 G10 pads ⌀20 × 40 in pockets ⌀20.4 (r 35), 0.5 mm proud.
4 Inside: epoxy coat + PTFE spray + silicone grease.
5 Port 13 × 27 through the whole wall (r 50–120): TDR, Pt100 and fibre cables.
Print bed ≥ 250 × 250, Z ≥ 200; ≈ 1.3–1.6 kg, ≈ 40–60 h.
40
35
20,4 pocket
low infill (gyroid 10–15 %): base z 0–40, wall r 80–120
sand surface
200
170
134,5
107,5
66
100 (sand)
34
134
30
27
70,1 (top rod)
100
106
3
240
75 CS645 (meas. 77)
37,5 fibre
37 Pt100 tip
3,5
19 head
R5
SECTION A–A (along the TDR axis)
Ø240
Ø106
Ø100
13 (port)
4,7 fibre
PLAN (from above)
A
13
2× 8.9
VIEW M (port from outside)
3× ⌀3.5 rods, ⌀3.3 Pt100 (on the top rod), ⌀1.5 fibre
