martinasobotkova5/my_data_projects/e7_frost_heave_load/sdileni/vyroba/tisk/E7-P08_camera_hanger.step

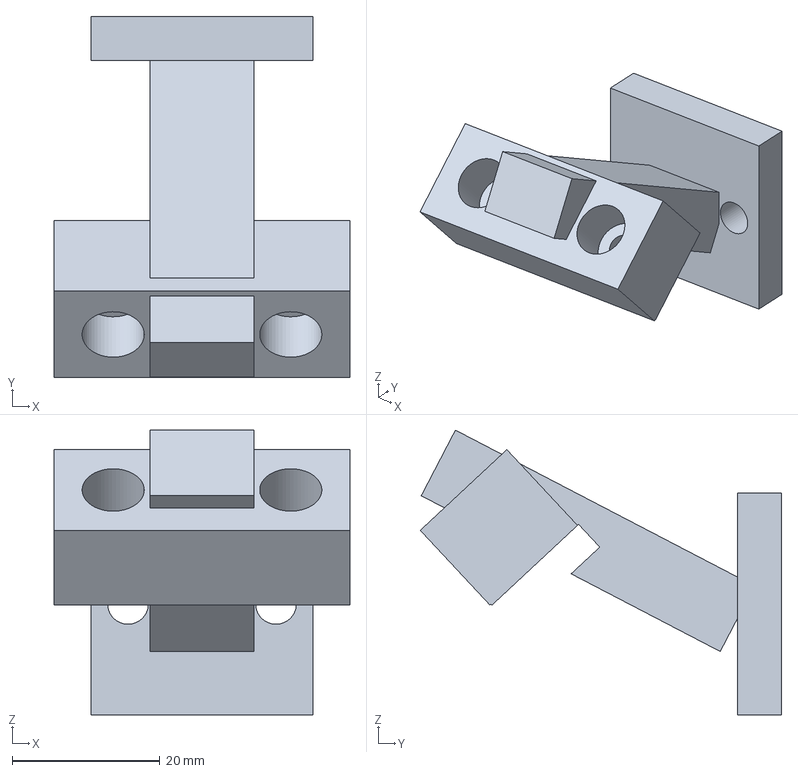
[picture p87: CAD file, 2026-11-13]
e7_frost_heave_load/sdileni/vyroba/tisk/E7-P08_camera_hanger.step
40.0 x 48.9 x 38.5 mm
