martinasobotkova5/my_data_projects/e7_frost_heave_load/vyroba/laser/E7-L07_disc_0.5kg_6mm.step

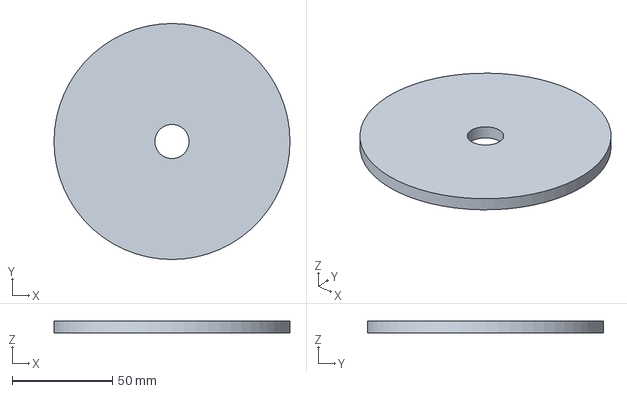
[picture p89: CAD file, 2026-11-13]
e7_frost_heave_load/vyroba/laser/E7-L07_disc_0.5kg_6mm.step
117.5 x 117.5 x 6.00 mm
