martinasobotkova5/my_data_projects/e7_frost_heave_load/vyroba/tisk/E7-P10_screed.step

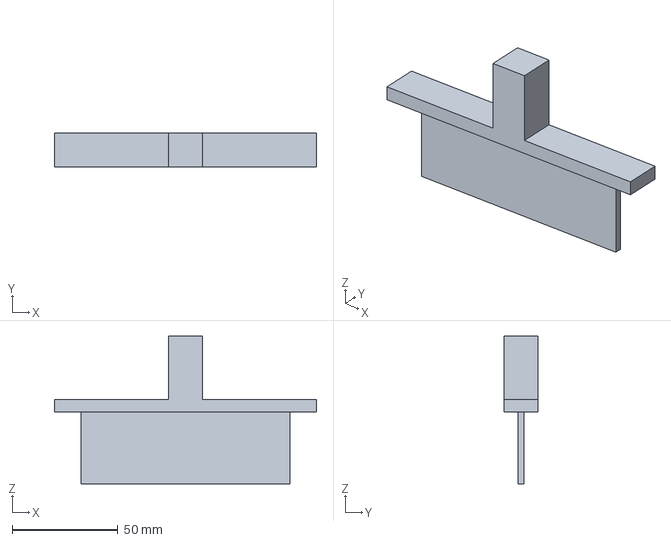
[picture p90: CAD file, 2026-11-13]
e7_frost_heave_load/vyroba/tisk/E7-P10_screed.step
124.0 x 16.0 x 70.0 mm
