martinasobotkova5/my_data_projects/e7_frost_heave_load/vyroba/vykresy/E7-L03_carrier.dxf

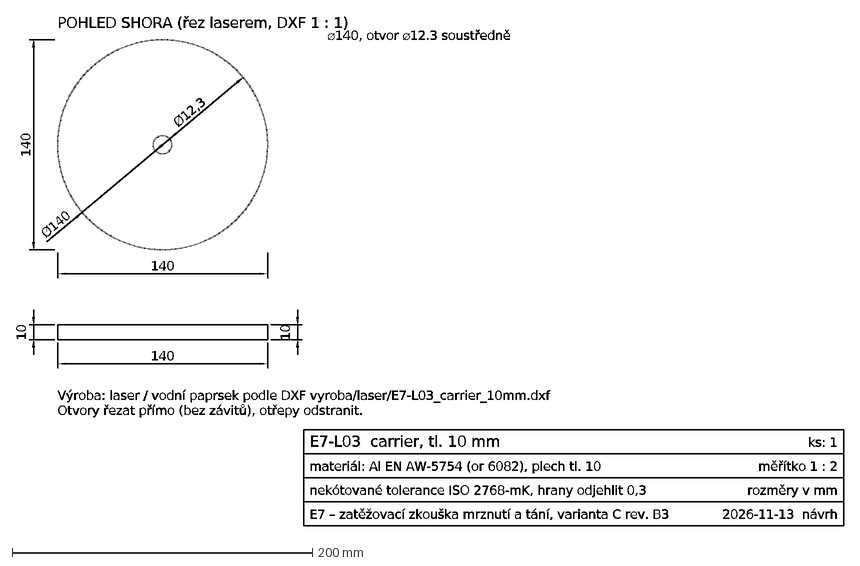
[picture p91: CAD file, 2026-11-13]
e7_frost_heave_load/vyroba/vykresy/E7-L03_carrier.dxf
140
POHLED SHORA (řez laserem, DXF 1 : 1)
10
Ø140
Ø12,3
⌀140, otvor ⌀12.3 soustředně
Výroba: laser / vodní paprsek podle DXF vyroba/laser/E7-L03_carrier_10mm.dxf
Otvory řezat přímo (bez závitů), otřepy odstranit.
E7-L03 carrier, tl. 10 mm
ks: 1
materiál: Al EN AW-5754 (or 6082), plech tl. 10
měřítko 1 : 2
nekótované tolerance ISO 2768-mK, hrany odjehlit 0,3
rozměry v mm
E7 – zatěžovací zkouška mrznutí a tání, varianta C rev. B3
2026-11-13 návrh
