martinasobotkova5/my_data_projects/e7_frost_heave_load/3d/parts_V03_variant_A_frame/Al_spacer_D40x51.step

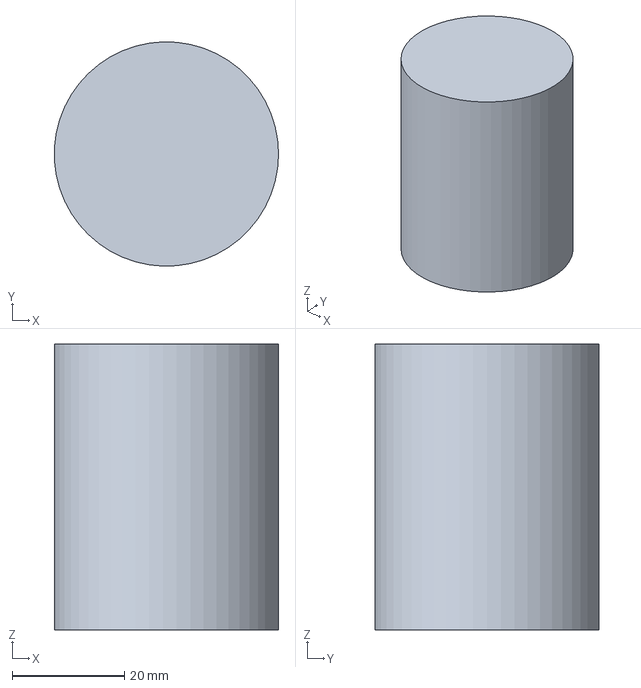
[picture p92: CAD file, 2026-10-26]
e7_frost_heave_load/3d/parts_V03_variant_A_frame/Al_spacer_D40x51.step
40.0 x 40.0 x 51.0 mm
