martinasobotkova5/my_data_projects/e7_frost_heave_load/3d/parts_V06_variant_B_open/Raspberry_Pi_HQ_camera.step

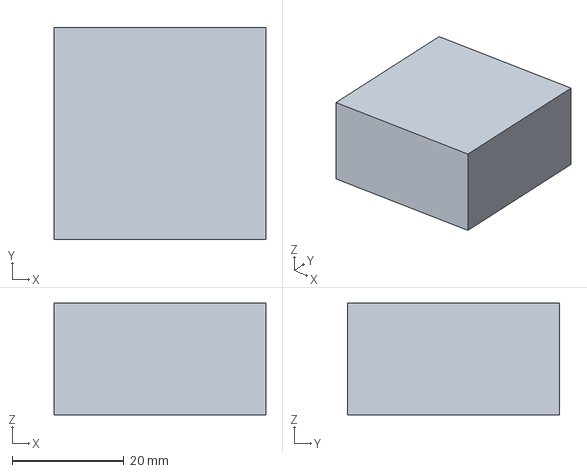
[picture p93: CAD file, 2026-10-26]
e7_frost_heave_load/3d/parts_V06_variant_B_open/Raspberry_Pi_HQ_camera.step
38.0 x 38.0 x 20.0 mm
