martinasobotkova5/my_data_projects/e7_frost_heave_load/3d/parts_V09_variant_C_combined/LVDT_DCTH400AG__optional.step

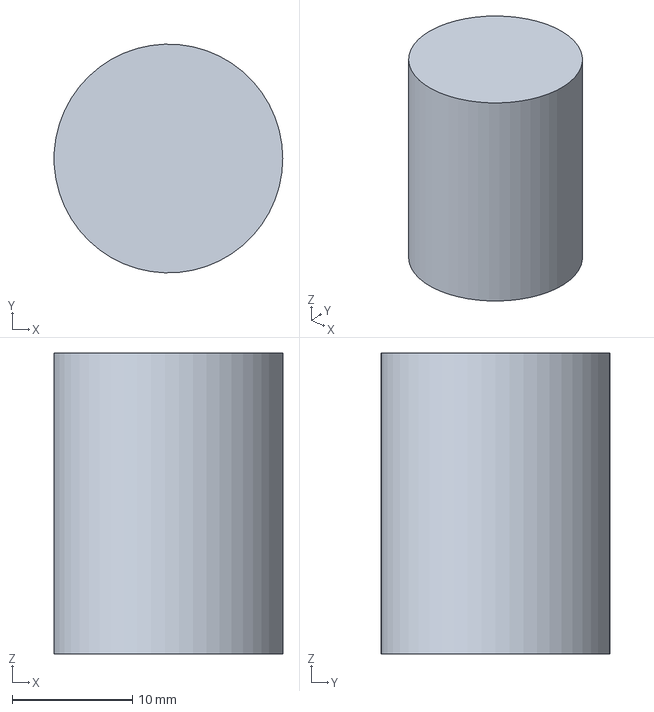
[picture p94: CAD file, 2026-10-26]
e7_frost_heave_load/3d/parts_V09_variant_C_combined/LVDT_DCTH400AG__optional.step
19.0 x 19.0 x 25.0 mm
