martinasobotkova5/my_data_projects/e7_frost_heave_load/sdileni/3d/E7_V01_variant_C.step

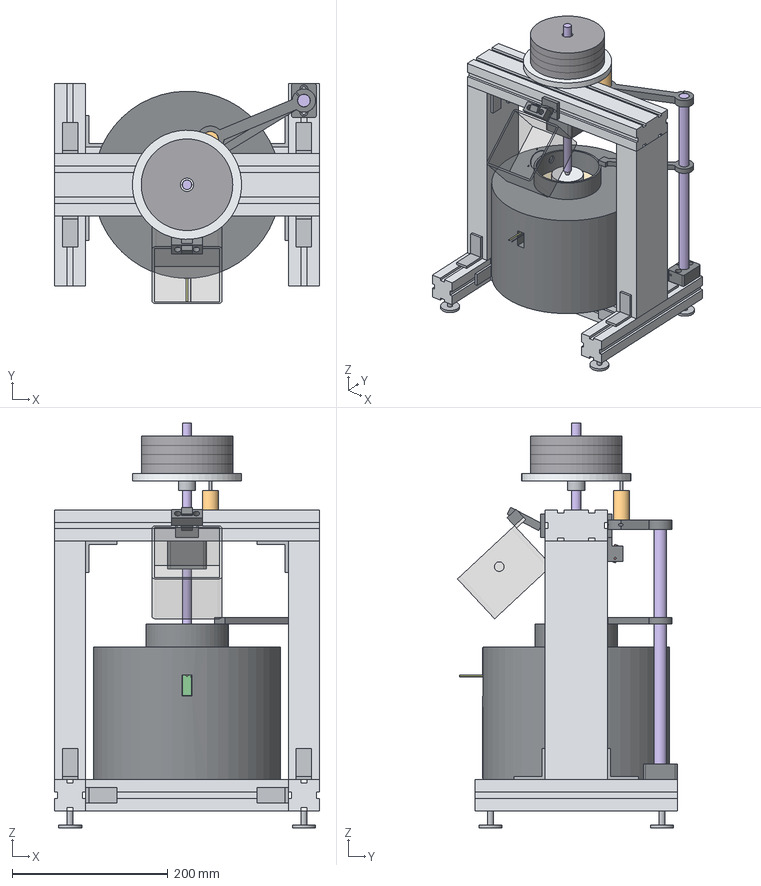
[picture p95: CAD file, 2026-11-09]
e7_frost_heave_load/sdileni/3d/E7_V01_variant_C.step
340.0 x 282.4 x 519.6 mm
T02 base rail 40x40 x260 L
levelling foot M8 L-1
levelling foot M8 L+1
T02 base rail 40x40 x260 R
levelling foot M8 R-1
levelling foot M8 R+1
T03 base cross bar 40x80 x260
angle bracket 40 base L-1
angle bracket 40 base L+1
angle bracket 40 base R-1
angle bracket 40 base R+1
T01 column 40x80 slot 8 x306 L
angle bracket 40 slot 8 Lb-1
angle bracket 40 slot 8 Lb+1
angle bracket 40 slot 8 Lt-20
angle bracket 40 slot 8 Lt+20
T01 column 40x80 slot 8 x306 R
angle bracket 40 slot 8 Rb-1
angle bracket 40 slot 8 Rb+1
angle bracket 40 slot 8 Rt-20
angle bracket 40 slot 8 Rt+20
T04 top beam 40x80 x340, hole D14
P01 bearing housing (print, hangs)
igus drylin RJ4JP-01-12
G10 pad D20x40 1
G10 pad D20x40 2
G10 pad D20x40 3
cell PETG D240x200 one piece, rev. B (core Column_one_body_version_1)
unsaturated sand D100x100
M TDR CS645 head
M TDR CS645 rod 1
M TDR CS645 rod 2
M TDR CS645 rod 3
M optical fibre
M Pt100 metal part
M Pt100 cable
L05 piston bottom
L04 piston top (ball seat)
steel ball 5-16in (7.94)
guide rod Invar 36 D12 x265
shaft collar DIN 705-A 12
L03 carrier Al D140x10
L06 steel disc 1 1 kg
L06 steel disc 2 1 kg
L06 steel disc 3 1 kg
L06 steel disc 4 1 kg
P04 post foot (print)
Invar 36 post D16 x330
P02 LVDT arm (print)
LVDT RDP DCTH400AG
LVDT plunger
P03 target arm (print)
P06 camera box: RPi HQ + 6 mm lens + RPi 5
P08 camera mount (print)
P05 laser holder (print)
line laser Picotronic DOE253 (68 deg)
