martinasobotkova5/my_data_projects/e7_frost_heave_load/sdileni/vyroba/laser/E7-L06_disc_1kg_12mm.step

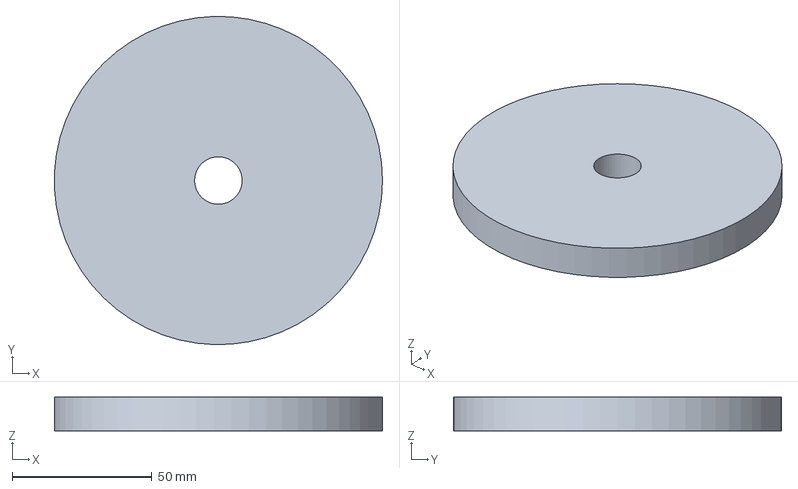
[picture p96: CAD file, 2026-11-13]
e7_frost_heave_load/sdileni/vyroba/laser/E7-L06_disc_1kg_12mm.step
117.4 x 117.5 x 12.0 mm
