martinasobotkova5/my_data_projects/e7_frost_heave_load/sdileni/vyroba/tisk/E7-P11_parking_fork.step

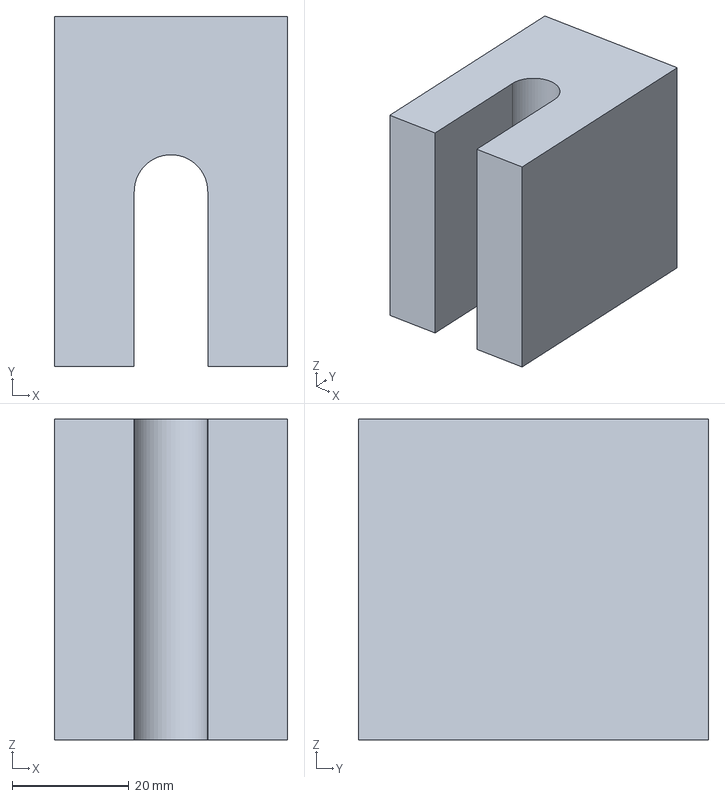
[picture p97: CAD file, 2026-11-13]
e7_frost_heave_load/sdileni/vyroba/tisk/E7-P11_parking_fork.step
40.0 x 60.0 x 55.0 mm
