martinasobotkova5/my_data_projects/e7_frost_heave_load/sdileni/vyroba/vykresy/E7-P10_screed.dxf

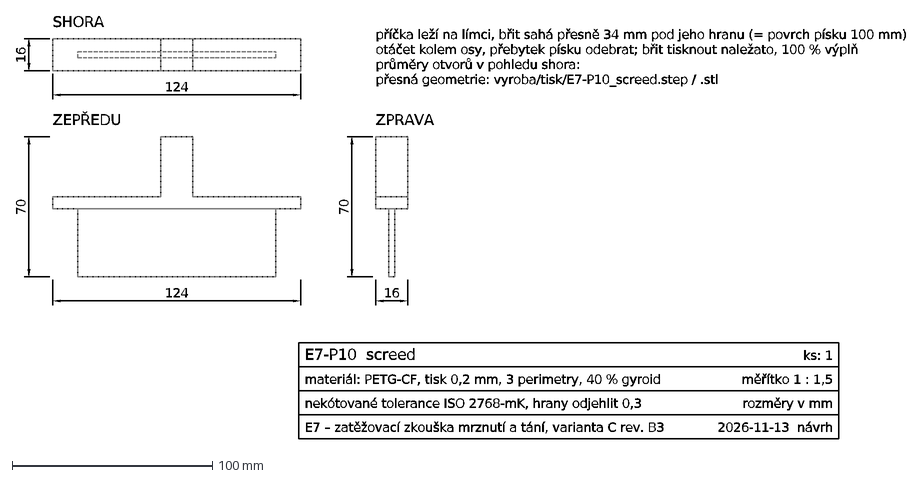
[picture p98: CAD file, 2026-11-13]
e7_frost_heave_load/sdileni/vyroba/vykresy/E7-P10_screed.dxf
124
70
ZEPŘEDU
16
SHORA
ZPRAVA
příčka leží na límci, břit sahá přesně 34 mm pod jeho hranu (= povrch písku 100 mm)
otáčet kolem osy, přebytek písku odebrat; břit tisknout naležato, 100 % výplň
průměry otvorů v pohledu shora:
přesná geometrie: vyroba/tisk/E7-P10_screed.step / .stl
E7-P10 screed
ks: 1
materiál: PETG-CF, tisk 0,2 mm, 3 perimetry, 40 % gyroid
měřítko 1 : 1,5
nekótované tolerance ISO 2768-mK, hrany odjehlit 0,3
rozměry v mm
E7 – zatěžovací zkouška mrznutí a tání, varianta C rev. B3
2026-11-13 návrh
