martinasobotkova5/my_data_projects/e7_frost_heave_load/vyroba/laser/E7-L04_piston_top_10mm.step

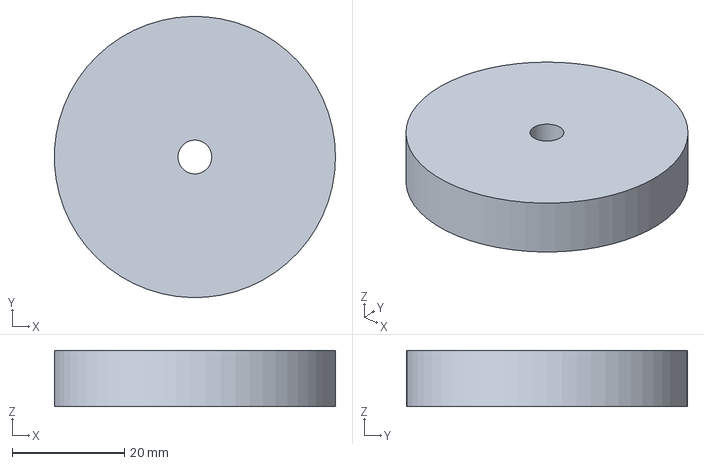
[picture p99: CAD file, 2026-11-13]
e7_frost_heave_load/vyroba/laser/E7-L04_piston_top_10mm.step
50.0 x 50.0 x 10.0 mm
