martinasobotkova5/my_data_projects/e7_frost_heave_load/vyroba/tisk/E7-P01_bearing_housing.step

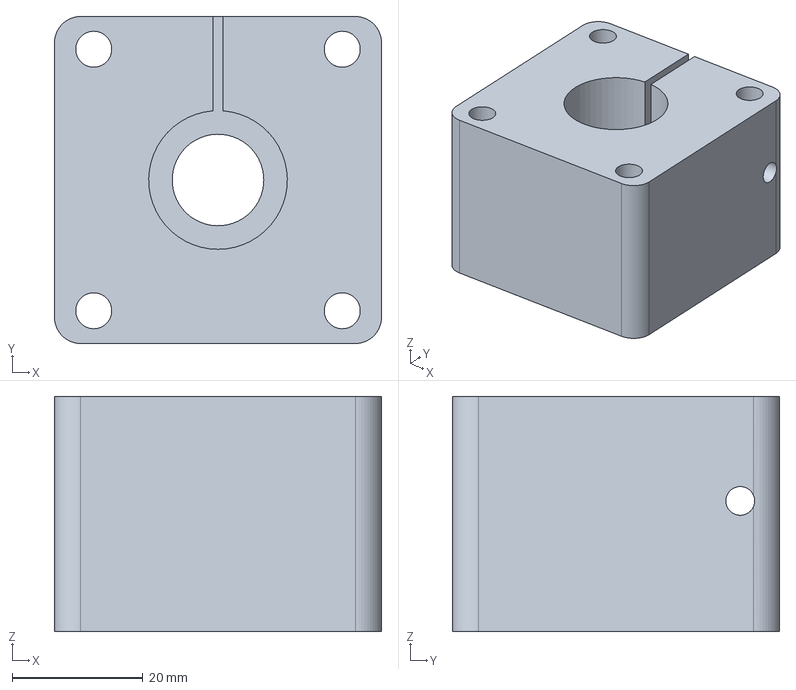
[picture p100: CAD file, 2026-11-13]
e7_frost_heave_load/vyroba/tisk/E7-P01_bearing_housing.step
50.0 x 50.0 x 36.0 mm
