martinasobotkova5/my_data_projects/e7_frost_heave_load/vyroba/vykresy/E7-P06_camera_box.dxf

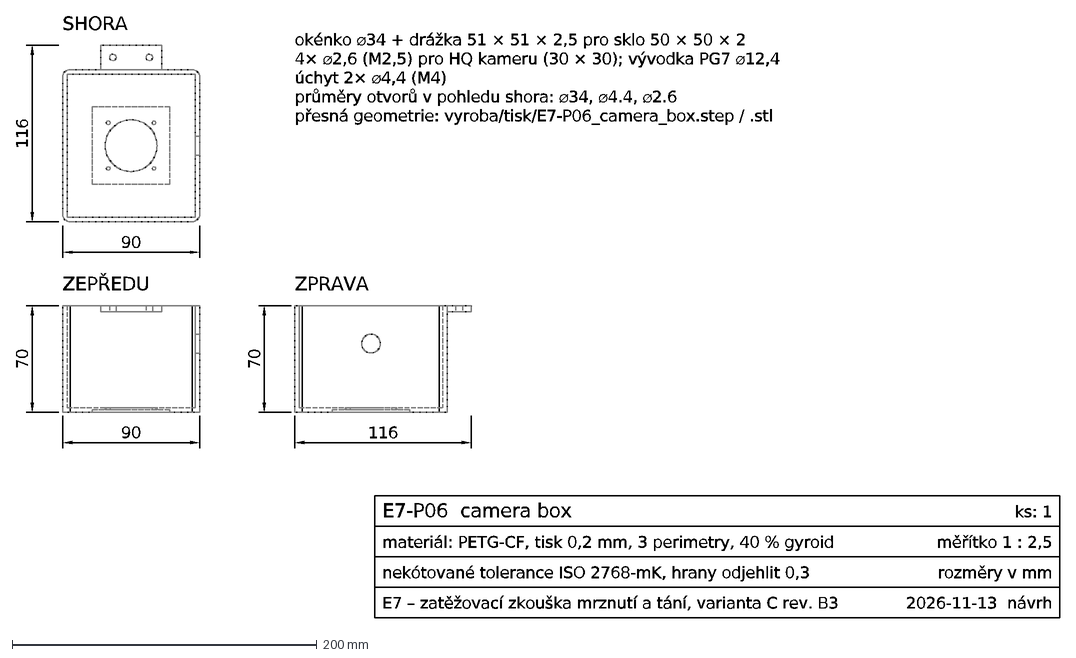
[picture p101: CAD file, 2026-11-13]
e7_frost_heave_load/vyroba/vykresy/E7-P06_camera_box.dxf
90
70
ZEPŘEDU
116
SHORA
ZPRAVA
okénko ⌀34 + drážka 51 × 51 × 2,5 pro sklo 50 × 50 × 2
4× ⌀2,6 (M2,5) pro HQ kameru (30 × 30); vývodka PG7 ⌀12,4
úchyt 2× ⌀4,4 (M4)
průměry otvorů v pohledu shora: ⌀34, ⌀4.4, ⌀2.6
přesná geometrie: vyroba/tisk/E7-P06_camera_box.step / .stl
E7-P06 camera box
ks: 1
materiál: PETG-CF, tisk 0,2 mm, 3 perimetry, 40 % gyroid
měřítko 1 : 2,5
nekótované tolerance ISO 2768-mK, hrany odjehlit 0,3
rozměry v mm
E7 – zatěžovací zkouška mrznutí a tání, varianta C rev. B3
2026-11-13 návrh
