martinasobotkova5/my_data_projects/e7_frost_heave_load/3d/parts_V03_variant_A_frame/stainless_post_D12.step

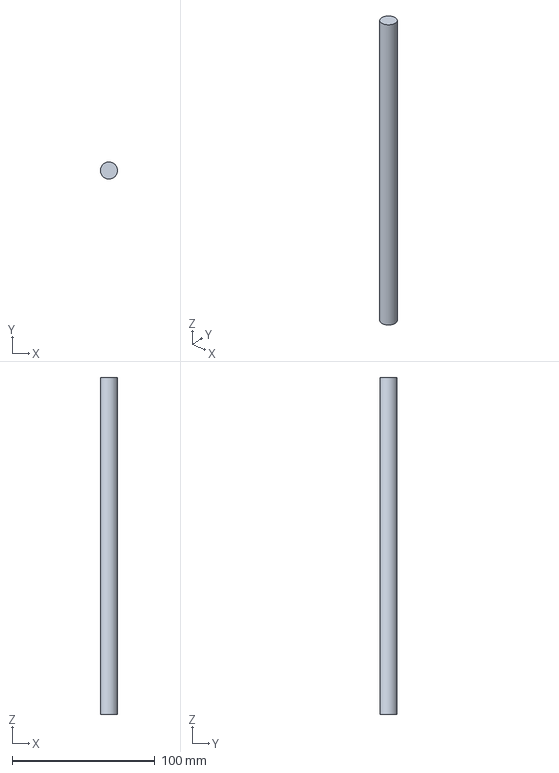
[picture p102: CAD file, 2026-10-26]
e7_frost_heave_load/3d/parts_V03_variant_A_frame/stainless_post_D12.step
12.0 x 12.0 x 236.0 mm
