martinasobotkova5/my_data_projects/e7_frost_heave_load/3d/parts_V06_variant_B_open/lens_12_mm_C-mount.step

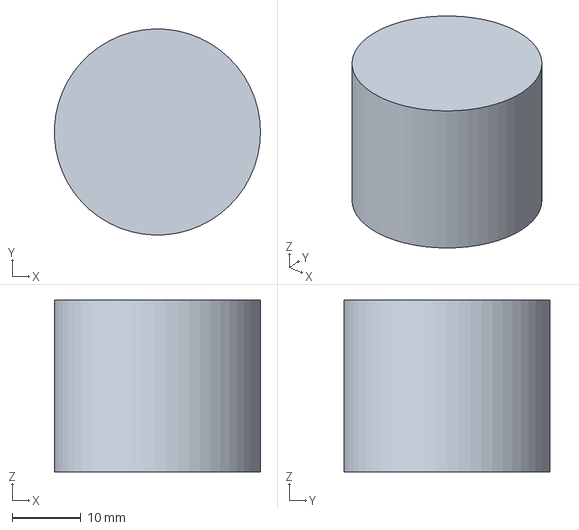
[picture p103: CAD file, 2026-10-26]
e7_frost_heave_load/3d/parts_V06_variant_B_open/lens_12_mm_C-mount.step
30.0 x 30.0 x 25.0 mm
