martinasobotkova5/my_data_projects/e7_frost_heave_load/sdileni/vyroba/laser/E7-L03_carrier_10mm.step

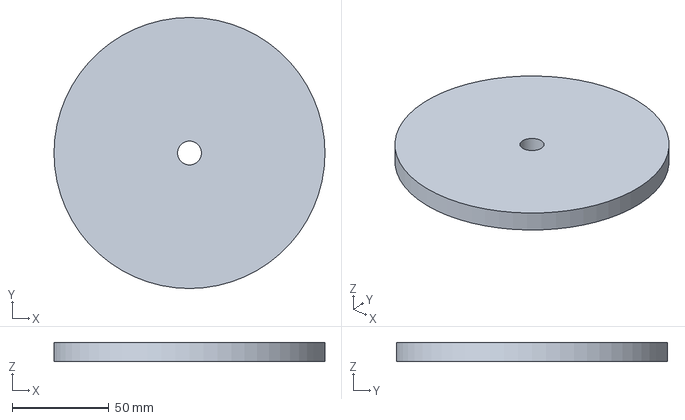
[picture p105: CAD file, 2026-11-13]
e7_frost_heave_load/sdileni/vyroba/laser/E7-L03_carrier_10mm.step
140.0 x 140.0 x 10.0 mm
