martinasobotkova5/my_data_projects/e7_frost_heave_load/sdileni/vyroba/tisk/E7-P03_target_arm.step

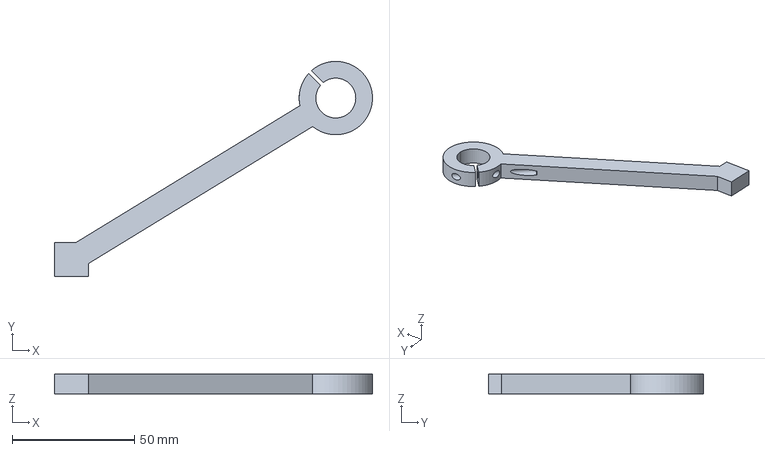
[picture p106: CAD file, 2026-11-13]
e7_frost_heave_load/sdileni/vyroba/tisk/E7-P03_target_arm.step
130.0 x 88.0 x 8.00 mm
