martinasobotkova5/my_data_projects/e7_frost_heave_load/sdileni/vyroba/vykresy/E7-T01_column.dxf

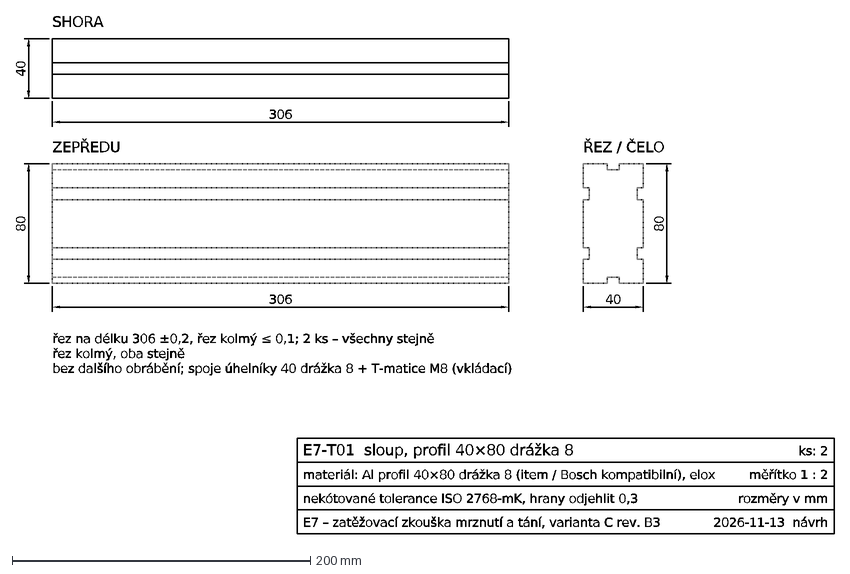
[picture p107: CAD file, 2026-11-13]
e7_frost_heave_load/sdileni/vyroba/vykresy/E7-T01_column.dxf
306
80
ZEPŘEDU
40
SHORA
ŘEZ / ČELO
řez na délku 306 ±0,2, řez kolmý ≤ 0,1; 2 ks – všechny stejně
řez kolmý, oba stejně
bez dalšího obrábění; spoje úhelníky 40 drážka 8 + T-matice M8 (vkládací)
E7-T01 sloup, profil 40×80 drážka 8
ks: 2
materiál: Al profil 40×80 drážka 8 (item / Bosch kompatibilní), elox
měřítko 1 : 2
nekótované tolerance ISO 2768-mK, hrany odjehlit 0,3
rozměry v mm
E7 – zatěžovací zkouška mrznutí a tání, varianta C rev. B3
2026-11-13 návrh
