martinasobotkova5/my_data_projects/e7_frost_heave_load/vyroba/tisk/E7-P02_lvdt_arm.step

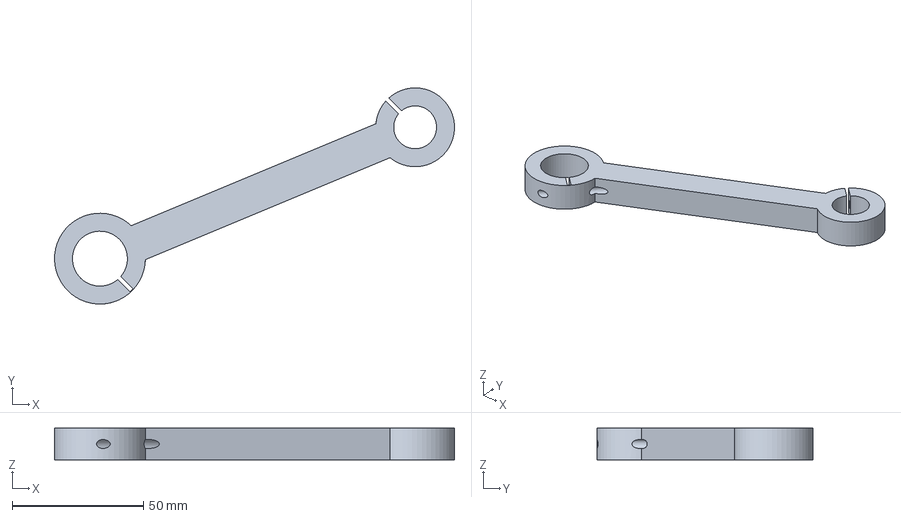
[picture p108: CAD file, 2026-11-13]
e7_frost_heave_load/vyroba/tisk/E7-P02_lvdt_arm.step
152.3 x 82.3 x 12.0 mm
