martinasobotkova5/my_data_projects/e7_frost_heave_load/vyroba/vykresy/E7-T03_base_cross_bar.dxf

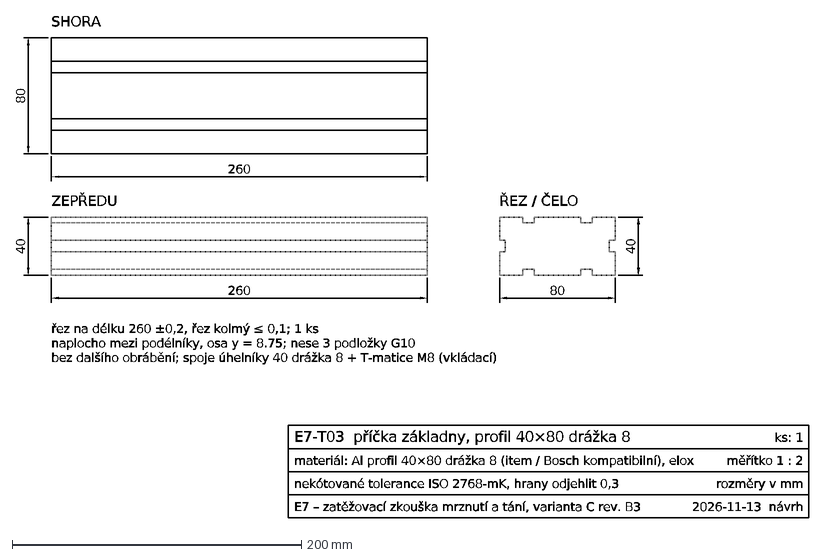
[picture p109: CAD file, 2026-11-13]
e7_frost_heave_load/vyroba/vykresy/E7-T03_base_cross_bar.dxf
260
40
ZEPŘEDU
80
SHORA
ŘEZ / ČELO
řez na délku 260 ±0,2, řez kolmý ≤ 0,1; 1 ks
naplocho mezi podélníky, osa y = 8.75; nese 3 podložky G10
bez dalšího obrábění; spoje úhelníky 40 drážka 8 + T-matice M8 (vkládací)
E7-T03 příčka základny, profil 40×80 drážka 8
ks: 1
materiál: Al profil 40×80 drážka 8 (item / Bosch kompatibilní), elox
měřítko 1 : 2
nekótované tolerance ISO 2768-mK, hrany odjehlit 0,3
rozměry v mm
E7 – zatěžovací zkouška mrznutí a tání, varianta C rev. B3
2026-11-13 návrh
