martinasobotkova5/my_data_projects/e7_frost_heave_load/3d/E7_V03_variant_A_frame.step

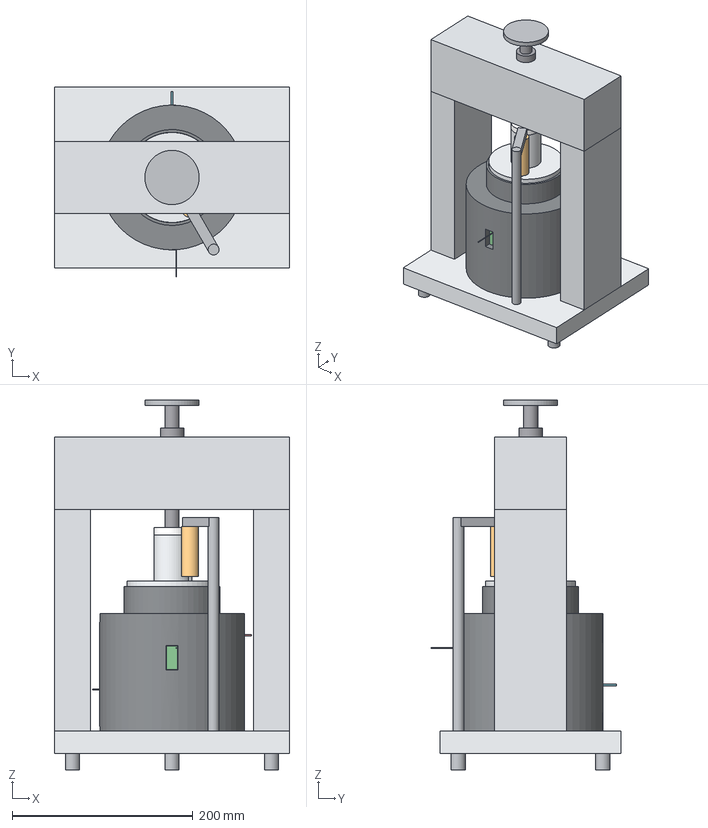
[picture p110: CAD file, 2026-10-26]
e7_frost_heave_load/3d/E7_V03_variant_A_frame.step
260.0 x 210.0 x 409.0 mm
Al base plate 260x200x25
levelling foot 1
levelling foot 2
levelling foot 3
column 40x80 L
column 40x80 R
cross-beam 80x80
cell body PETG D160 (Column_one_body_version_1)
PB1 TML PDA-PA (flush)
unsaturated sand D100x100
M TDR CS645 head
M TDR CS645 rod 1
M TDR CS645 rod 2
M TDR CS645 rod 3
M optical fibre
M Pt100 metal part
M Pt100 cable
T1 109SS (opt.)
T2 109SS (opt.)
PV1 TML PDA-PA on D20 disc
PV1 cable
Al piston D99.5x40
Al spacer D40x51
POM-C thermal insert D40x8
screw M16x1.5
lock nut M16
handwheel
stainless post D12
LVDT clamp arm
LVDT RDP DCTH400AG
LVDT plunger
