martinasobotkova5/my_data_projects/e7_frost_heave_load/3d/parts_V01_variant_C/levelling_foot_M8_L-1.step

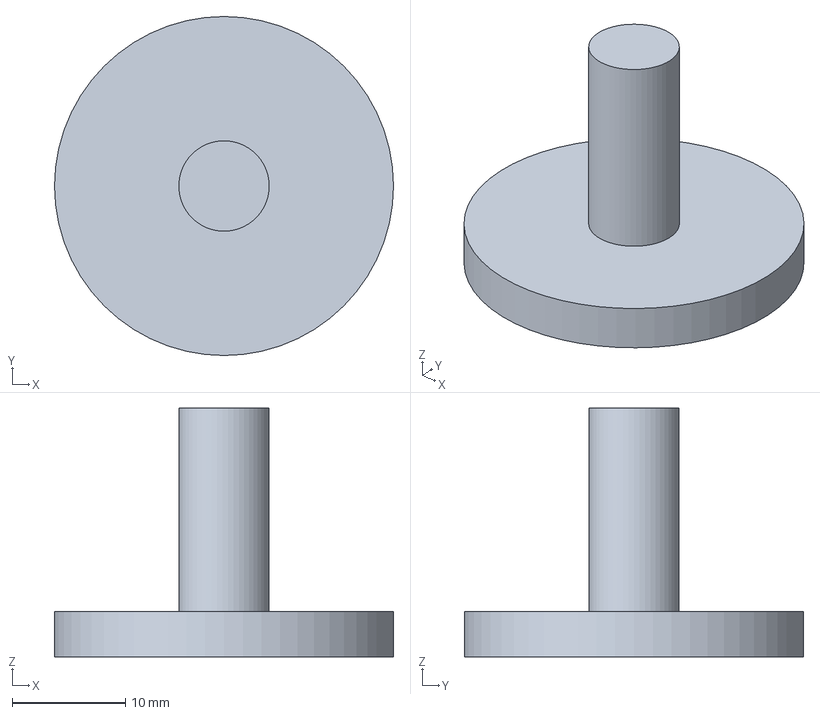
[picture p111: CAD file, 2026-11-13]
e7_frost_heave_load/3d/parts_V01_variant_C/levelling_foot_M8_L-1.step
30.0 x 30.0 x 22.0 mm
