martinasobotkova5/my_data_projects/e7_frost_heave_load/3d/parts_V03_variant_A_frame/PV1_TML_PDA-PA_on_D20_disc.step

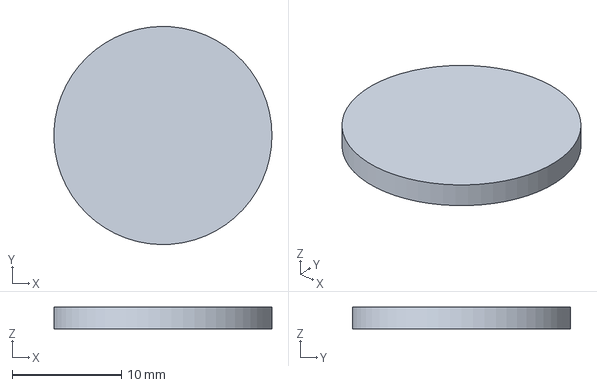
[picture p112: CAD file, 2026-10-26]
e7_frost_heave_load/3d/parts_V03_variant_A_frame/PV1_TML_PDA-PA_on_D20_disc.step
20.0 x 20.0 x 2.00 mm
