martinasobotkova5/my_data_projects/e7_frost_heave_load/3d/parts_V06_variant_B_open/M_TDR_CS645_rod_3.step

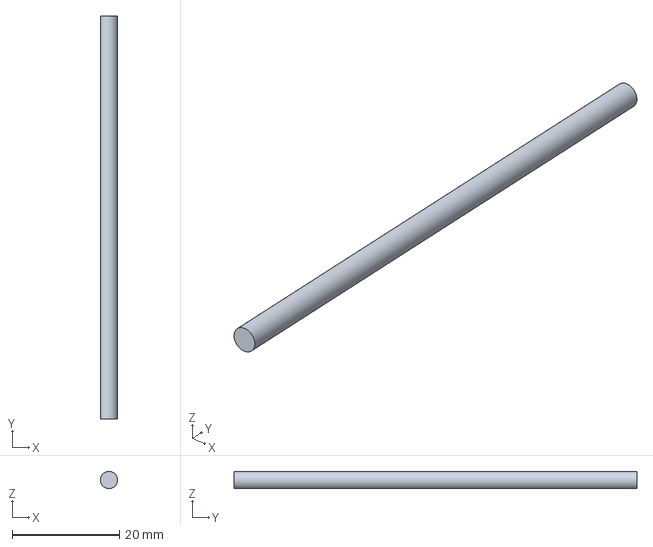
[picture p113: CAD file, 2026-10-26]
e7_frost_heave_load/3d/parts_V06_variant_B_open/M_TDR_CS645_rod_3.step
3.20 x 75.0 x 3.20 mm
