martinasobotkova5/my_data_projects/e7_frost_heave_load/sdileni/vyroba/tisk/E7-P05_laser_holder.step

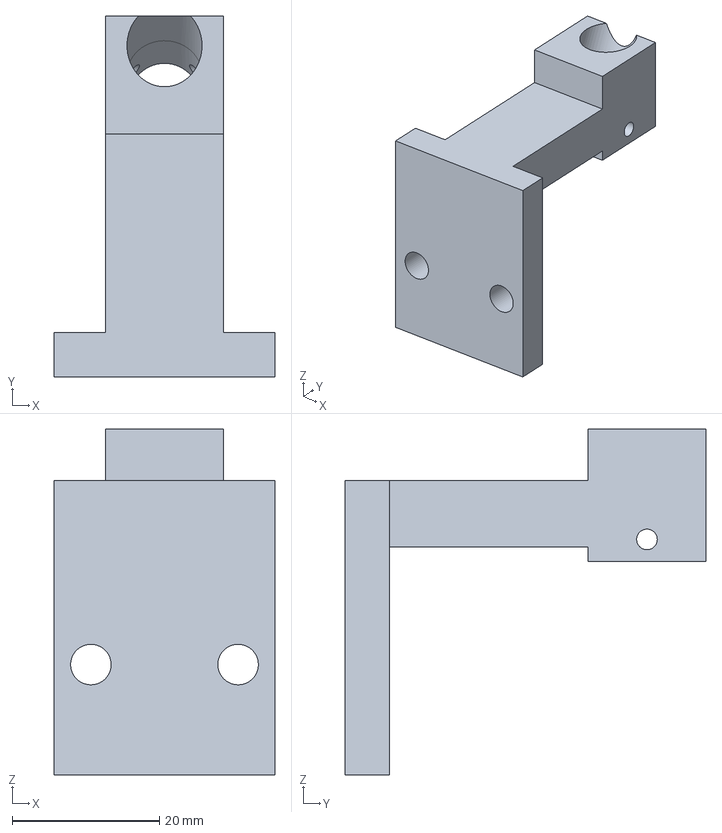
[picture p114: CAD file, 2026-11-13]
e7_frost_heave_load/sdileni/vyroba/tisk/E7-P05_laser_holder.step
30.0 x 49.0 x 47.0 mm
