martinasobotkova5/my_data_projects/e7_frost_heave_load/sdileni/vyroba/vykresy/E7-P08_camera_hanger.dxf

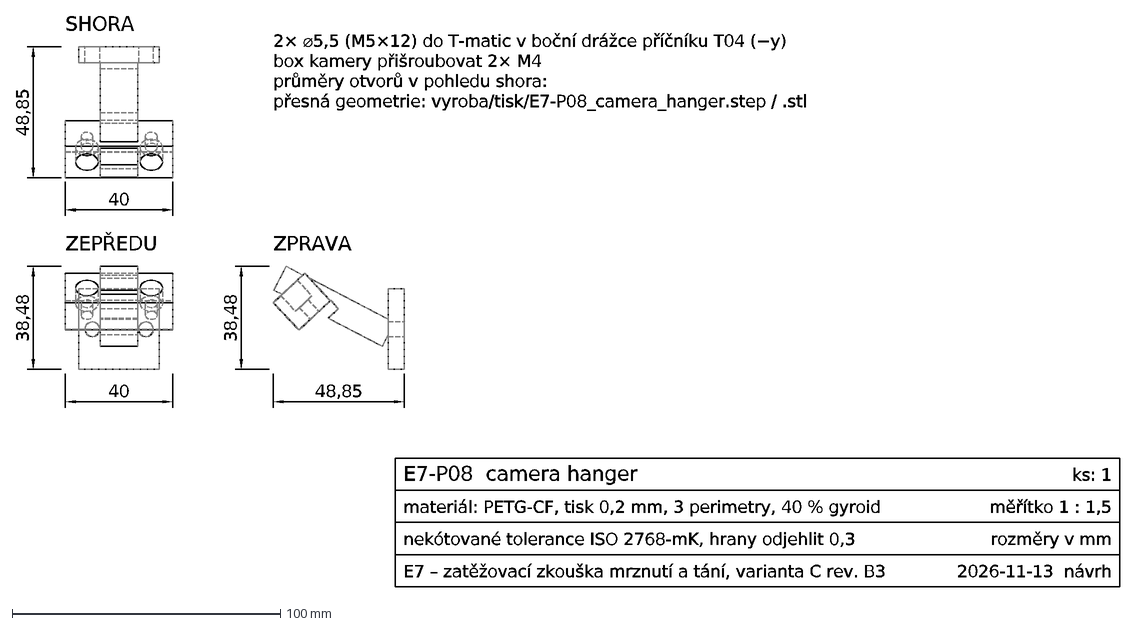
[picture p115: CAD file, 2026-11-13]
e7_frost_heave_load/sdileni/vyroba/vykresy/E7-P08_camera_hanger.dxf
40
38,48
ZEPŘEDU
48,85
SHORA
ZPRAVA
2× ⌀5,5 (M5×12) do T-matic v boční drážce příčníku T04 (−y)
box kamery přišroubovat 2× M4
průměry otvorů v pohledu shora:
přesná geometrie: vyroba/tisk/E7-P08_camera_hanger.step / .stl
E7-P08 camera hanger
ks: 1
materiál: PETG-CF, tisk 0,2 mm, 3 perimetry, 40 % gyroid
měřítko 1 : 1,5
nekótované tolerance ISO 2768-mK, hrany odjehlit 0,3
rozměry v mm
E7 – zatěžovací zkouška mrznutí a tání, varianta C rev. B3
2026-11-13 návrh
