martinasobotkova5/my_data_projects/e7_frost_heave_load/vyroba/tisk/E7-P04_post_foot.step

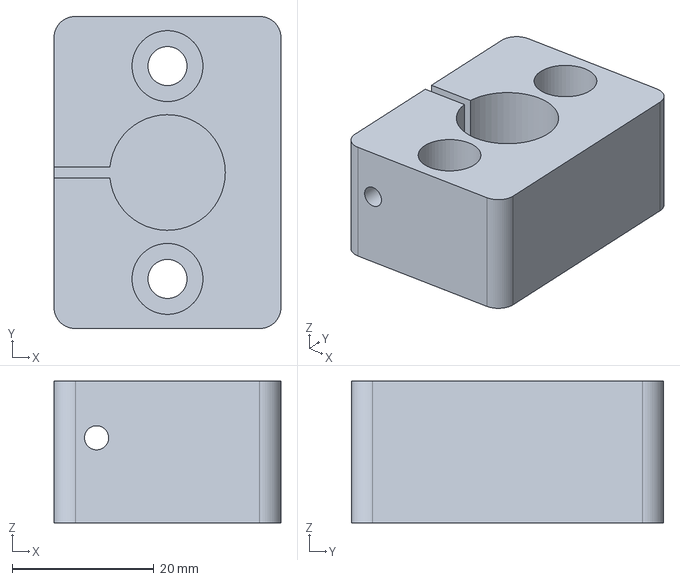
[picture p116: CAD file, 2026-11-13]
e7_frost_heave_load/vyroba/tisk/E7-P04_post_foot.step
32.0 x 44.0 x 20.0 mm
