martinasobotkova5/my_data_projects/e7_frost_heave_load/vyroba/vykresy/E7-P03_target_arm.dxf

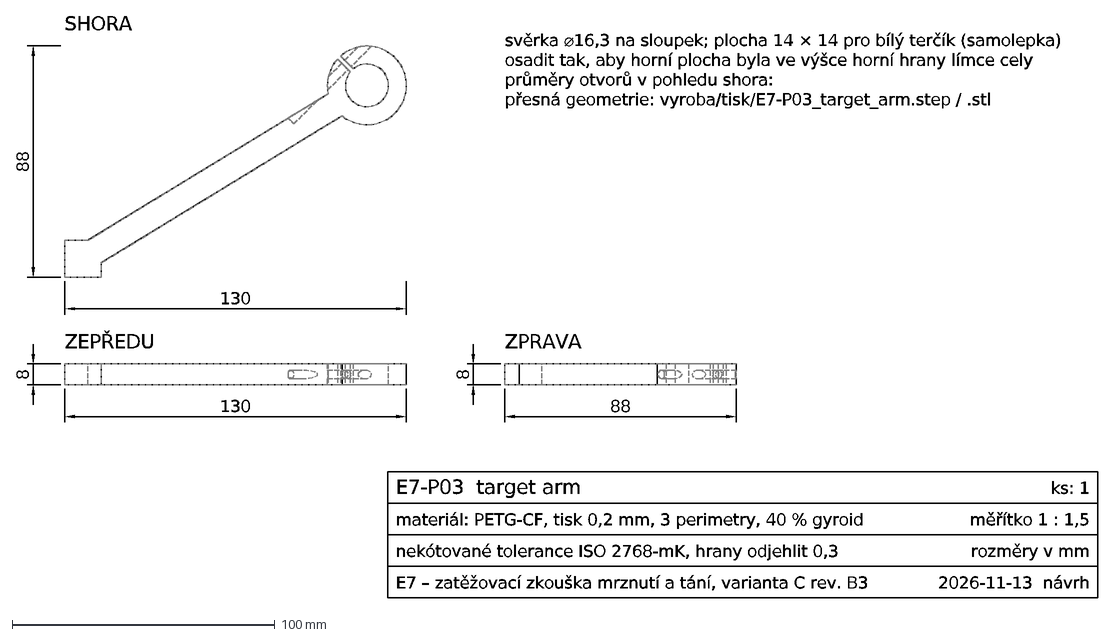
[picture p117: CAD file, 2026-11-13]
e7_frost_heave_load/vyroba/vykresy/E7-P03_target_arm.dxf
130
8
ZEPŘEDU
88
SHORA
ZPRAVA
svěrka ⌀16,3 na sloupek; plocha 14 × 14 pro bílý terčík (samolepka)
osadit tak, aby horní plocha byla ve výšce horní hrany límce cely
průměry otvorů v pohledu shora:
přesná geometrie: vyroba/tisk/E7-P03_target_arm.step / .stl
E7-P03 target arm
ks: 1
materiál: PETG-CF, tisk 0,2 mm, 3 perimetry, 40 % gyroid
měřítko 1 : 1,5
nekótované tolerance ISO 2768-mK, hrany odjehlit 0,3
rozměry v mm
E7 – zatěžovací zkouška mrznutí a tání, varianta C rev. B3
2026-11-13 návrh
