martinasobotkova5/my_data_projects/e7_frost_heave_load/3d/E7_V02_variant_A_tie_rods.step

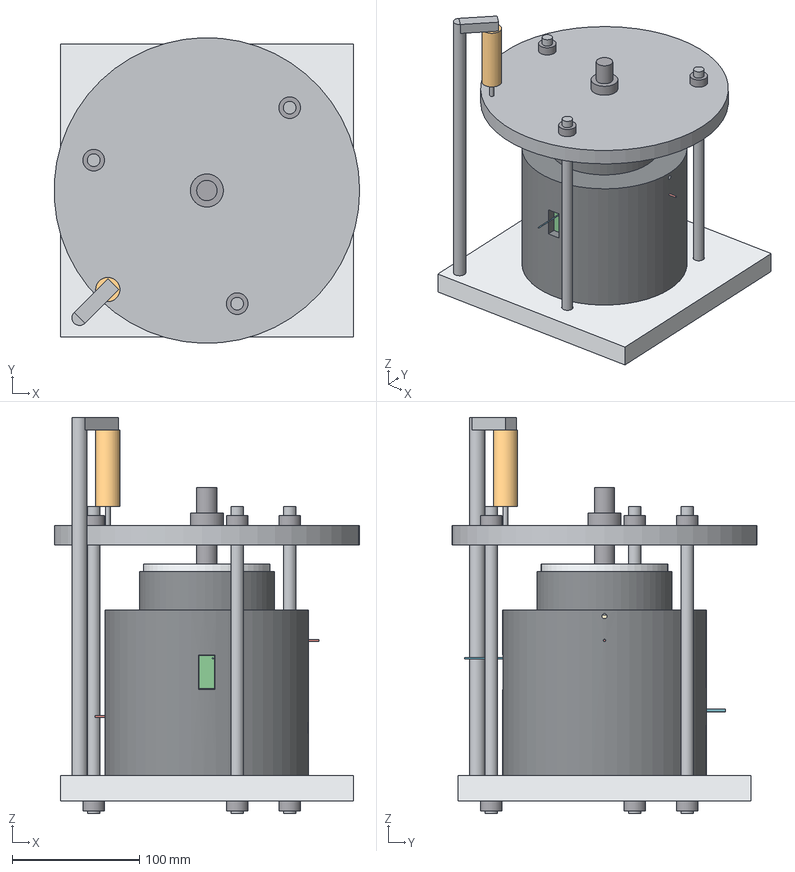
[picture p118: CAD file, 2026-10-26]
e7_frost_heave_load/3d/E7_V02_variant_A_tie_rods.step
239.8 x 239.9 x 311.0 mm
Al base plate 230x230x20
cell body PETG D160 (Column_one_body_version_1)
PB1 TML PDA-PA (flush)
unsaturated sand D100x100
M TDR CS645 head
M TDR CS645 rod 1
M TDR CS645 rod 2
M TDR CS645 rod 3
M optical fibre
M Pt100 metal part
M Pt100 cable
T1 109SS (opt.)
T2 109SS (opt.)
PV1 TML PDA-PA on D20 disc
PV1 cable
Al piston D99.5x40
tie rod M10 1
nut M10 1 top
nut M10 1 bottom
tie rod M10 2
nut M10 2 top
nut M10 2 bottom
tie rod M10 3
nut M10 3 top
nut M10 3 bottom
steel lid D240x15
centre screw M16x1.5
lock nut M16
stainless post D12
LVDT clamp arm
LVDT RDP DCTH400AG
LVDT plunger
