martinasobotkova5/my_data_projects/e7_frost_heave_load/3d/parts_V01_variant_C/igus_drylin_RJ4JP-01-12.step

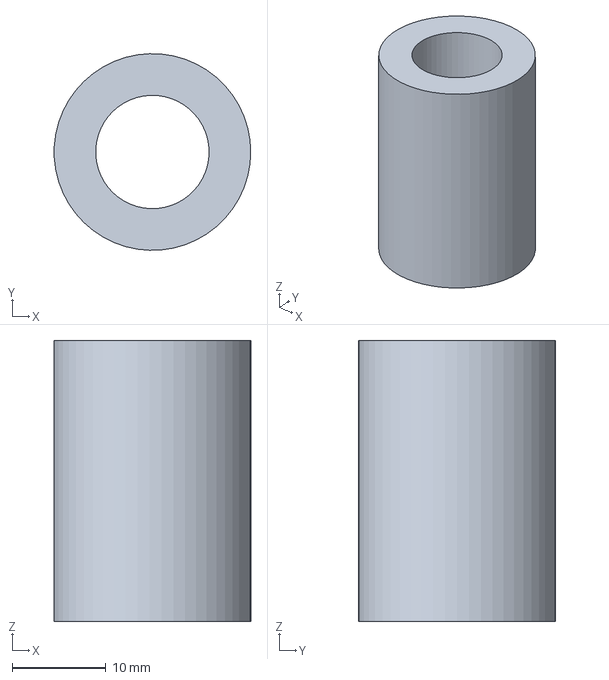
[picture p119: CAD file, 2026-11-13]
e7_frost_heave_load/3d/parts_V01_variant_C/igus_drylin_RJ4JP-01-12.step
21.0 x 21.0 x 30.0 mm
