martinasobotkova5/my_data_projects/e7_frost_heave_load/3d/parts_V06_variant_B_open/M_TDR_CS645_head.step

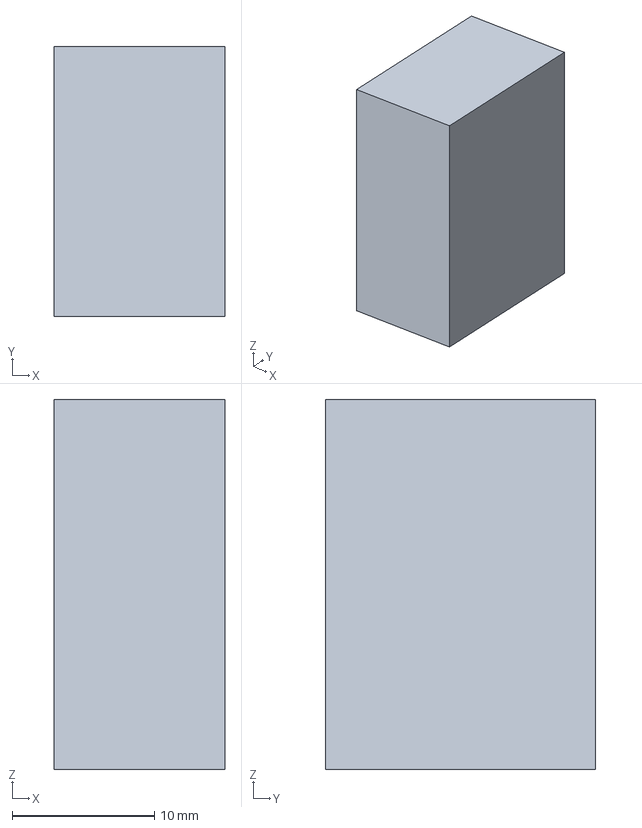
[picture p120: CAD file, 2026-10-26]
e7_frost_heave_load/3d/parts_V06_variant_B_open/M_TDR_CS645_head.step
12.0 x 19.0 x 26.0 mm
