martinasobotkova5/my_data_projects/e7_frost_heave_load/vyroba/laser/E7-L05_piston_bottom_10mm.dxf

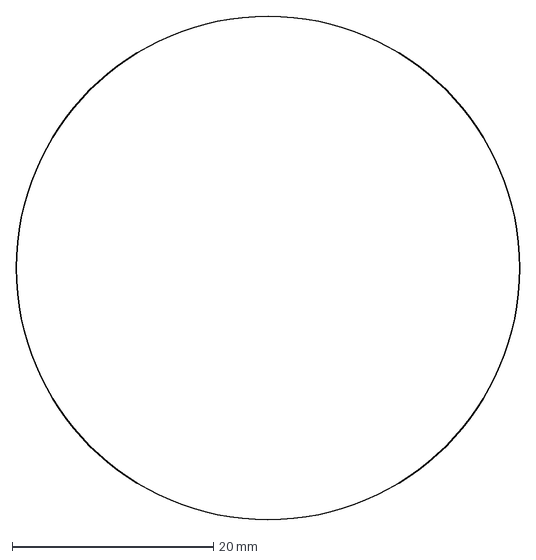
[picture p122: CAD file, 2026-11-09]
e7_frost_heave_load/vyroba/laser/E7-L05_piston_bottom_10mm.dxf
50.0 x 50.0 mm
