martinasobotkova5/my_data_projects/e7_frost_heave_load/vyroba/tisk/E7-P06_camera_box.step

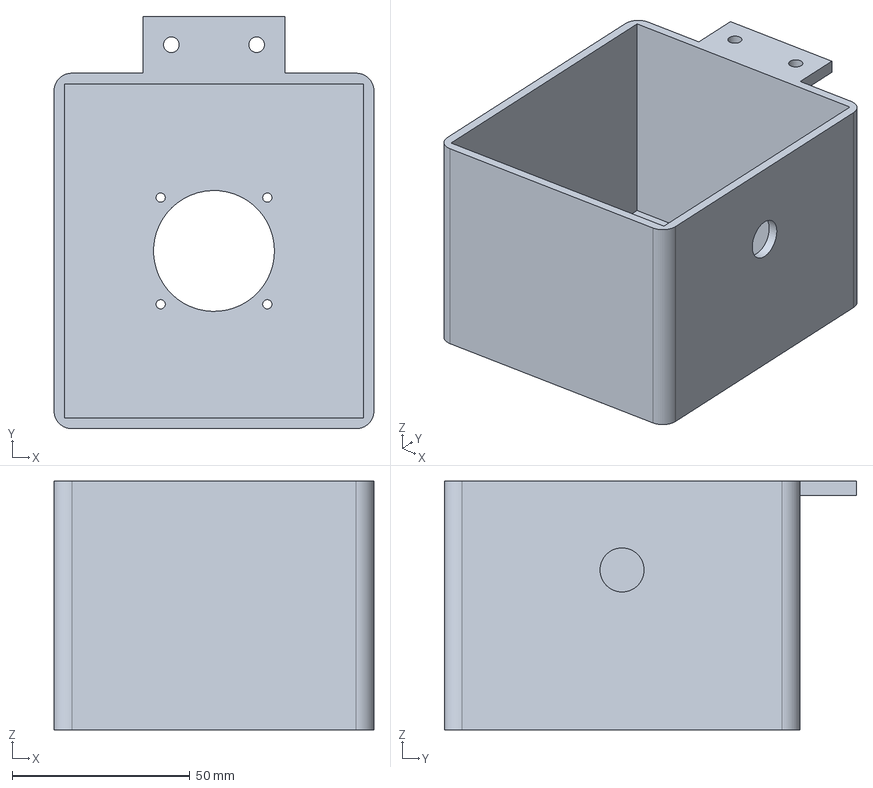
[picture p123: CAD file, 2026-11-13]
e7_frost_heave_load/vyroba/tisk/E7-P06_camera_box.step
90.0 x 116.0 x 70.0 mm
