martinasobotkova5/my_data_projects/e7_frost_heave_load/3d/parts_V03_variant_A_frame/Al_base_plate_260x200x25.step

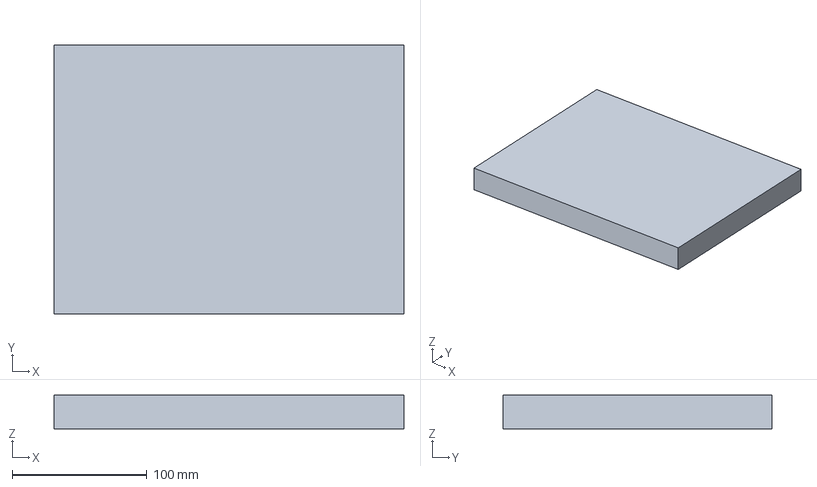
[picture p125: CAD file, 2026-10-26]
e7_frost_heave_load/3d/parts_V03_variant_A_frame/Al_base_plate_260x200x25.step
260.0 x 200.0 x 25.0 mm
