martinasobotkova5/my_data_projects/e7_frost_heave_load/3d/parts_V06_variant_B_open/laser_bracket.step

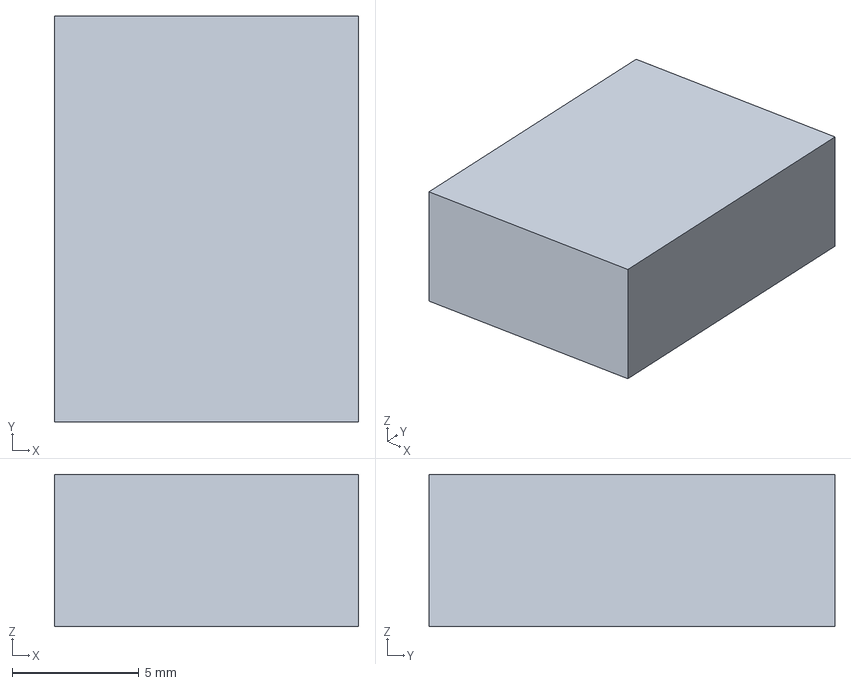
[picture p126: CAD file, 2026-10-26]
e7_frost_heave_load/3d/parts_V06_variant_B_open/laser_bracket.step
12.0 x 16.0 x 6.00 mm
