martinasobotkova5/my_data_projects/e7_frost_heave_load/sdileni/vyroba/laser/E7-L02_top_plate_10mm.step

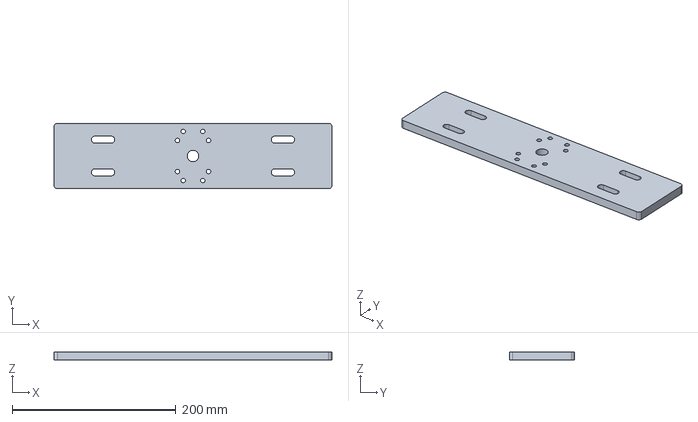
[picture p127: CAD file, 2026-10-27]
e7_frost_heave_load/sdileni/vyroba/laser/E7-L02_top_plate_10mm.step
340.0 x 80.0 x 10.0 mm
