martinasobotkova5/my_data_projects/e7_frost_heave_load/sdileni/vyroba/vykresy/E7-L07_disc_0.5kg.dxf

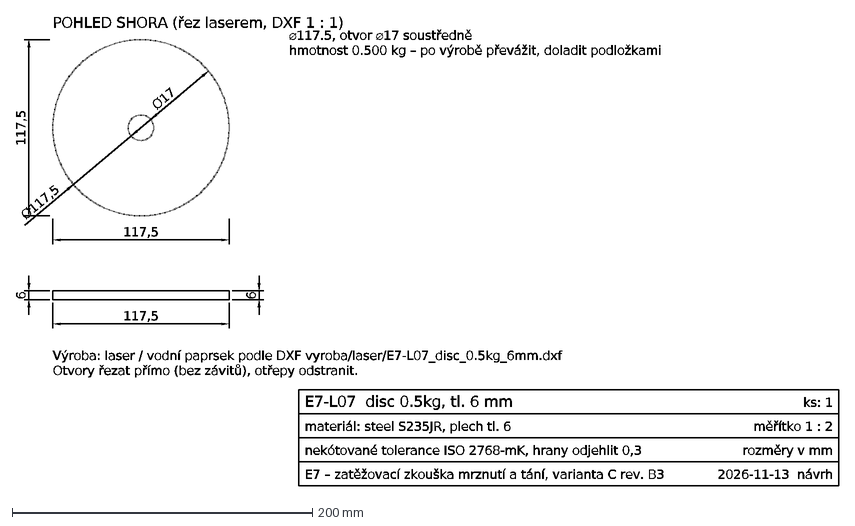
[picture p128: CAD file, 2026-11-13]
e7_frost_heave_load/sdileni/vyroba/vykresy/E7-L07_disc_0.5kg.dxf
117,5
POHLED SHORA (řez laserem, DXF 1 : 1)
6
Ø117,5
Ø17
⌀117.5, otvor ⌀17 soustředně
hmotnost 0.500 kg – po výrobě převážit, doladit podložkami
Výroba: laser / vodní paprsek podle DXF vyroba/laser/E7-L07_disc_0.5kg_6mm.dxf
Otvory řezat přímo (bez závitů), otřepy odstranit.
E7-L07 disc 0.5kg, tl. 6 mm
ks: 1
materiál: steel S235JR, plech tl. 6
měřítko 1 : 2
nekótované tolerance ISO 2768-mK, hrany odjehlit 0,3
rozměry v mm
E7 – zatěžovací zkouška mrznutí a tání, varianta C rev. B3
2026-11-13 návrh
