martinasobotkova5/my_data_projects/e7_frost_heave_load/vyroba/laser/E7-L01_base_plate_10mm.step

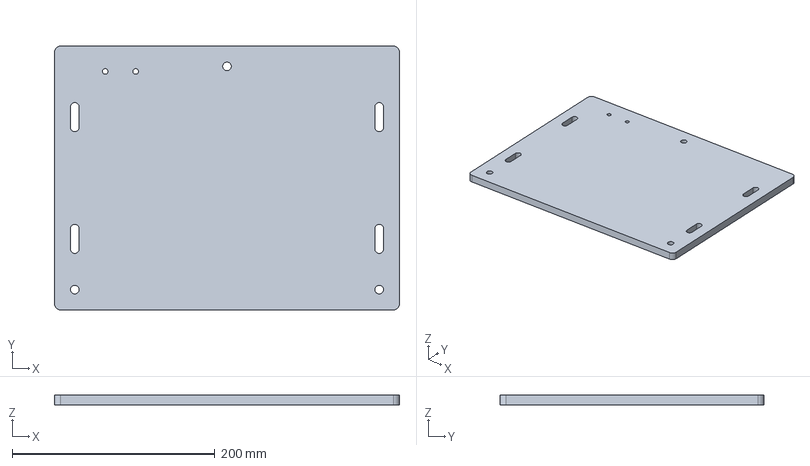
[picture p129: CAD file, 2026-10-27]
e7_frost_heave_load/vyroba/laser/E7-L01_base_plate_10mm.step
340.0 x 260.0 x 10.0 mm
