martinasobotkova5/my_data_projects/e7_frost_heave_load/vyroba/tisk/E7-P07_camera_box_lid.step

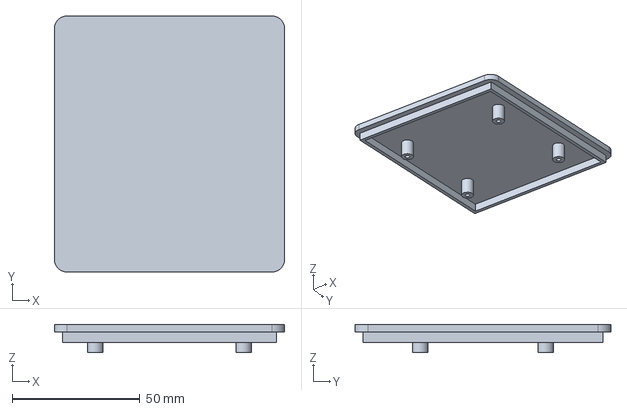
[picture p130: CAD file, 2026-11-13]
e7_frost_heave_load/vyroba/tisk/E7-P07_camera_box_lid.step
90.0 x 100.0 x 11.0 mm
