martinasobotkova5/my_data_projects/e7_frost_heave_load/vyroba/vykresy/E7-L06_disc_1kg.dxf

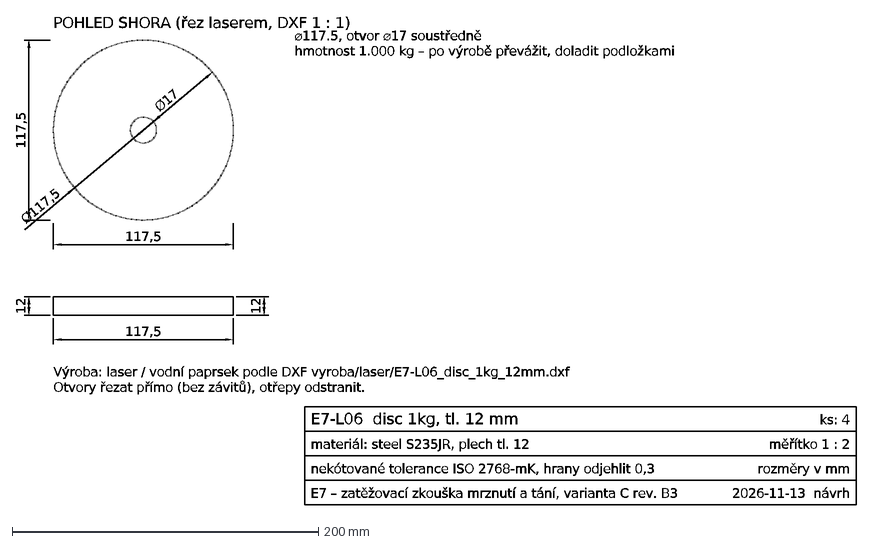
[picture p131: CAD file, 2026-11-13]
e7_frost_heave_load/vyroba/vykresy/E7-L06_disc_1kg.dxf
117,5
POHLED SHORA (řez laserem, DXF 1 : 1)
12
Ø117,5
Ø17
⌀117.5, otvor ⌀17 soustředně
hmotnost 1.000 kg – po výrobě převážit, doladit podložkami
Výroba: laser / vodní paprsek podle DXF vyroba/laser/E7-L06_disc_1kg_12mm.dxf
Otvory řezat přímo (bez závitů), otřepy odstranit.
E7-L06 disc 1kg, tl. 12 mm
ks: 4
materiál: steel S235JR, plech tl. 12
měřítko 1 : 2
nekótované tolerance ISO 2768-mK, hrany odjehlit 0,3
rozměry v mm
E7 – zatěžovací zkouška mrznutí a tání, varianta C rev. B3
2026-11-13 návrh
