martinasobotkova5/my_data_projects/e7_frost_heave_load/3d/E7_V09_variant_C_combined.step

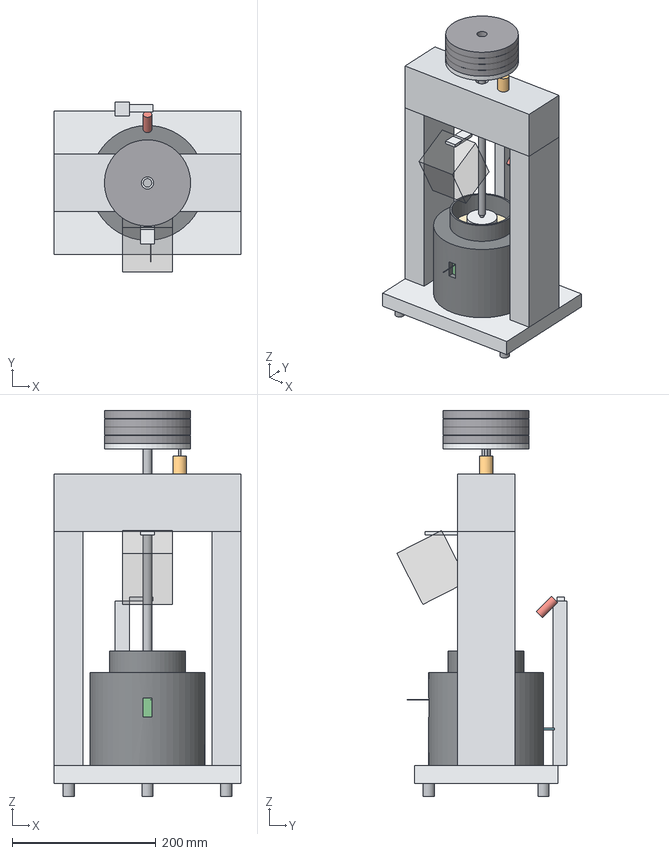
[picture p132: CAD file, 2026-10-26]
e7_frost_heave_load/3d/E7_V09_variant_C_combined.step
260.0 x 237.3 x 537.7 mm
Al base plate 260x200x25
levelling foot 1
levelling foot 2
levelling foot 3
column 40x80 x326 L
column 40x80 x326 R
cross-beam 80x80
linear ball bushing LM12UU
cell body PETG D160 (Column_one_body_version_1)
PB1 TML PDA-PA (flush)
unsaturated sand D100x100
M TDR CS645 head
M TDR CS645 rod 1
M TDR CS645 rod 2
M TDR CS645 rod 3
M optical fibre
M Pt100 metal part
M Pt100 cable
PV1 TML PDA-PA on D20 disc
PV1 cable
partial piston Al D50x20
steel ball D8
guide rod D12 h6 x289
carrier plate Al D120x8
steel disc 1 1 kg D120
steel disc 2 1 kg D120
steel disc 3 1 kg D120
steel disc 4 1 kg D120
LVDT DCTH400AG (optional)
LVDT plunger
heated camera box (RPi HQ + 12 mm lens)
camera bracket
laser post 20x20
laser bracket
line laser 650 nm (45 deg)
