martinasobotkova5/my_data_projects/e7_frost_heave_load/3d/parts_V01_variant_C/shaft_collar_DIN_705-A_12.step

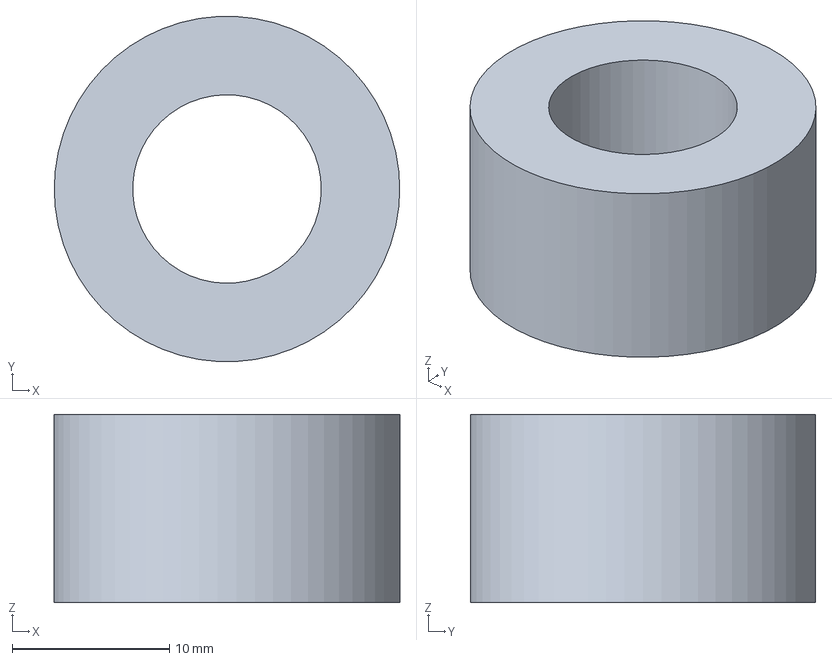
[picture p133: CAD file, 2026-11-13]
e7_frost_heave_load/3d/parts_V01_variant_C/shaft_collar_DIN_705-A_12.step
22.0 x 22.0 x 12.0 mm
