martinasobotkova5/my_data_projects/e7_frost_heave_load/3d/parts_V03_variant_A_frame/handwheel.step

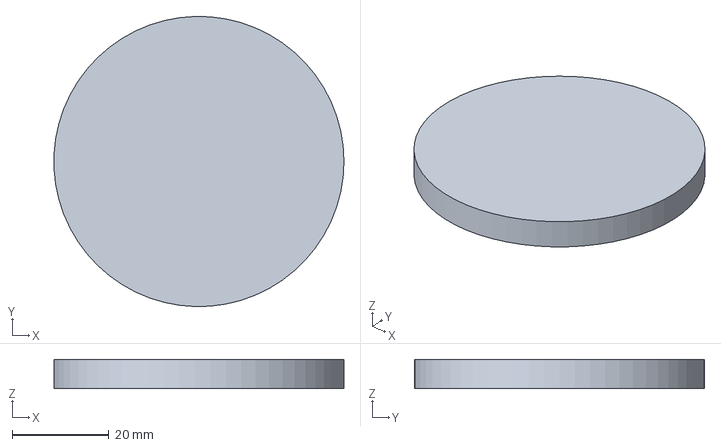
[picture p134: CAD file, 2026-10-26]
e7_frost_heave_load/3d/parts_V03_variant_A_frame/handwheel.step
60.0 x 60.0 x 6.00 mm
