martinasobotkova5/my_data_projects/e7_frost_heave_load/3d/parts_V06_variant_B_open/heated_camera_box_XPS_30.step

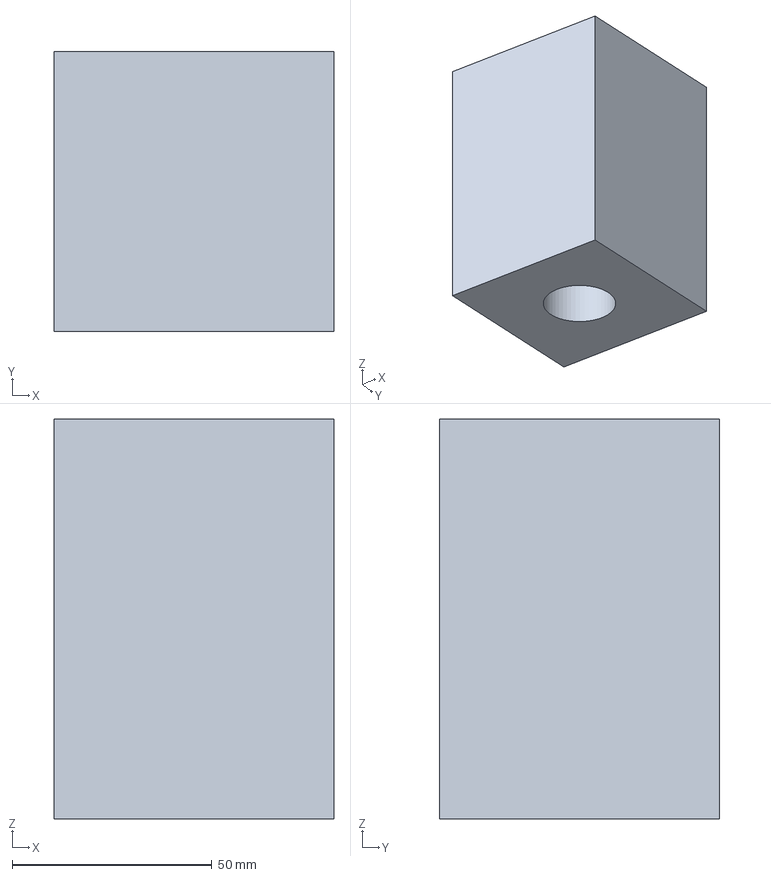
[picture p135: CAD file, 2026-10-26]
e7_frost_heave_load/3d/parts_V06_variant_B_open/heated_camera_box_XPS_30.step
70.0 x 70.0 x 100.0 mm
