martinasobotkova5/my_data_projects/e7_frost_heave_load/sdileni/vyroba/vykresy/E7-T02_base_rail.dxf

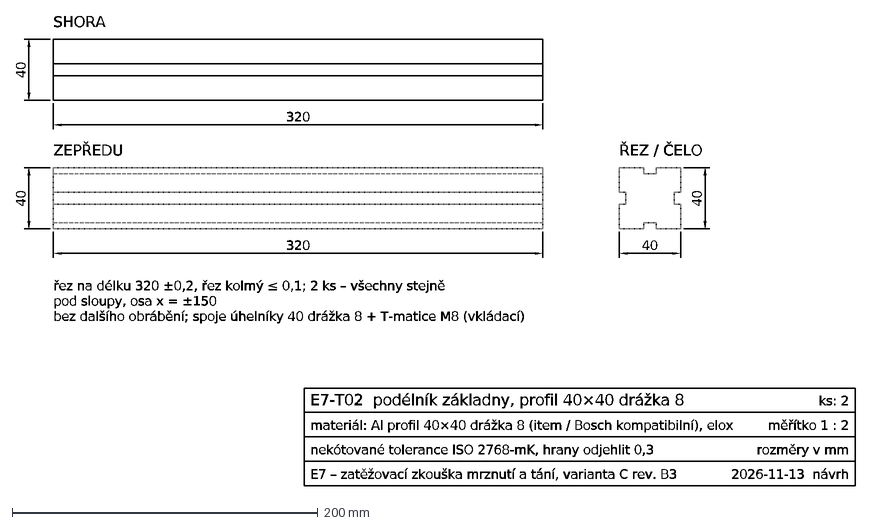
[picture p136: CAD file, 2026-11-13]
e7_frost_heave_load/sdileni/vyroba/vykresy/E7-T02_base_rail.dxf
320
40
ZEPŘEDU
SHORA
ŘEZ / ČELO
řez na délku 320 ±0,2, řez kolmý ≤ 0,1; 2 ks – všechny stejně
pod sloupy, osa x = ±150
bez dalšího obrábění; spoje úhelníky 40 drážka 8 + T-matice M8 (vkládací)
E7-T02 podélník základny, profil 40×40 drážka 8
ks: 2
materiál: Al profil 40×40 drážka 8 (item / Bosch kompatibilní), elox
měřítko 1 : 2
nekótované tolerance ISO 2768-mK, hrany odjehlit 0,3
rozměry v mm
E7 – zatěžovací zkouška mrznutí a tání, varianta C rev. B3
2026-11-13 návrh
