martinasobotkova5/my_data_projects/e7_frost_heave_load/vyroba/tisk/E7-P09_centering_cap.step

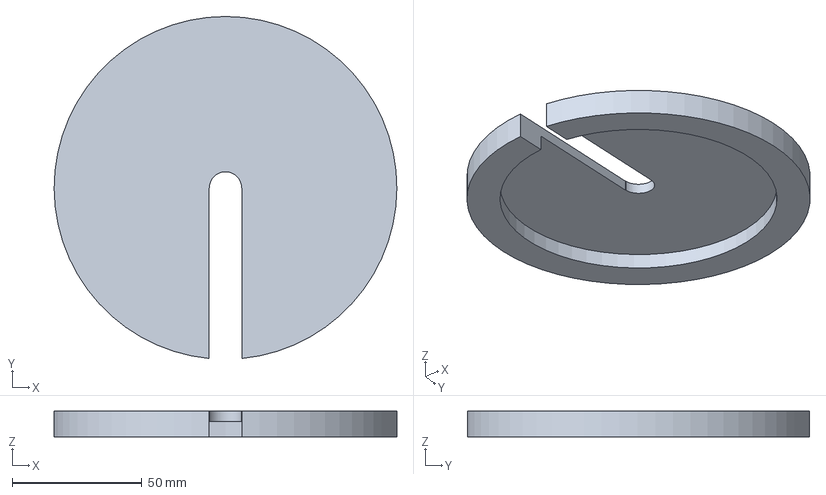
[picture p137: CAD file, 2026-11-13]
e7_frost_heave_load/vyroba/tisk/E7-P09_centering_cap.step
132.0 x 131.7 x 10.0 mm
