martinasobotkova5/my_data_projects/e7_frost_heave_load/vyroba/vykresy/E7-B02_invar_post.dxf

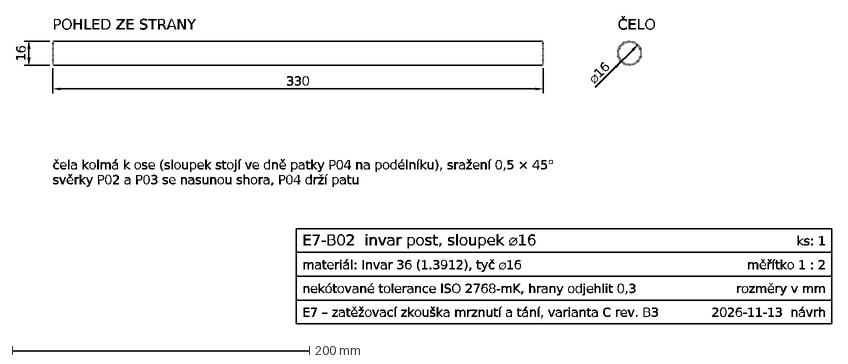
[picture p138: CAD file, 2026-11-13]
e7_frost_heave_load/vyroba/vykresy/E7-B02_invar_post.dxf
330
16
POHLED ZE STRANY
ČELO
⌀16
čela kolmá k ose (sloupek stojí ve dně patky P04 na podélníku), sražení 0,5 × 45°
svěrky P02 a P03 se nasunou shora, P04 drží patu
E7-B02 invar post, sloupek ⌀16
ks: 1
materiál: Invar 36 (1.3912), tyč ⌀16
měřítko 1 : 2
nekótované tolerance ISO 2768-mK, hrany odjehlit 0,3
rozměry v mm
E7 – zatěžovací zkouška mrznutí a tání, varianta C rev. B3
2026-11-13 návrh
