martinasobotkova5/my_data_projects/e7_frost_heave_load/3d/E7_V04_cell.step

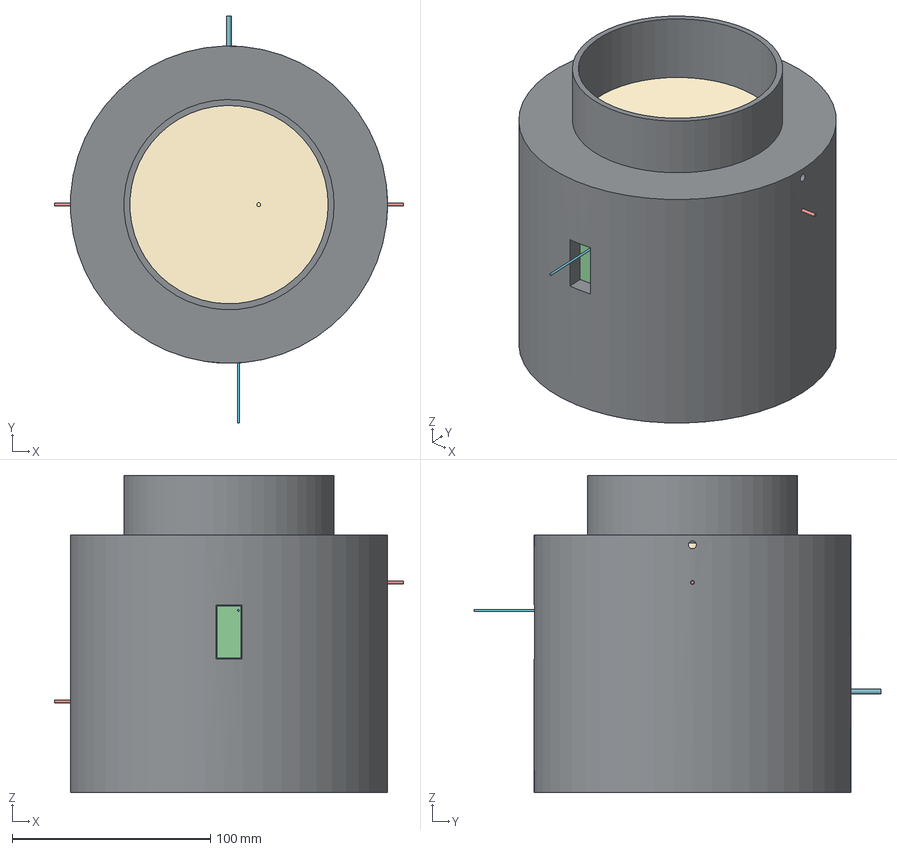
[picture p139: CAD file, 2026-10-26]
e7_frost_heave_load/3d/E7_V04_cell.step
176.0 x 205.0 x 160.0 mm
cell body PETG D160 (Column_one_body_version_1)
PB1 TML PDA-PA (flush)
unsaturated sand D100x100
M TDR CS645 head
M TDR CS645 rod 1
M TDR CS645 rod 2
M TDR CS645 rod 3
M optical fibre
M Pt100 metal part
M Pt100 cable
T1 109SS (opt.)
T2 109SS (opt.)
PV1 TML PDA-PA on D20 disc
PV1 cable
