martinasobotkova5/my_data_projects/e7_frost_heave_load/vyroba/vykresy/E7-P11_parking_fork.dxf

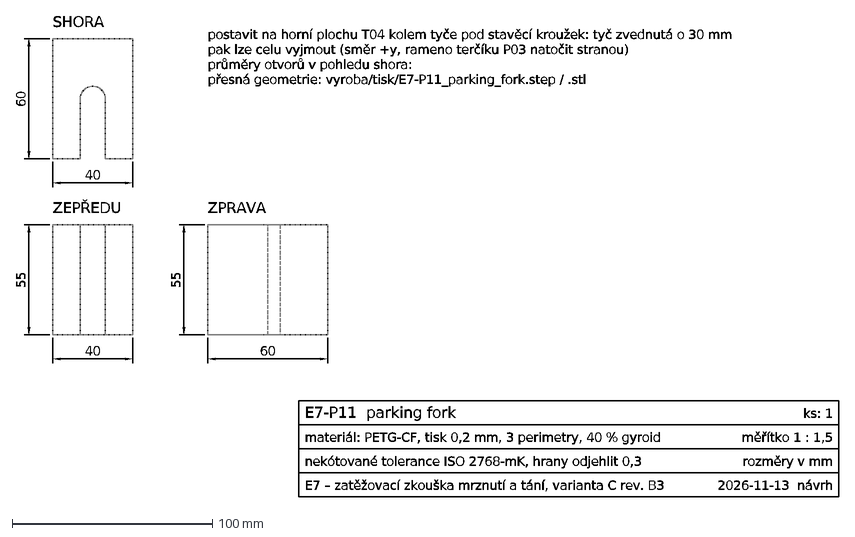
[picture p142: CAD file, 2026-11-13]
e7_frost_heave_load/vyroba/vykresy/E7-P11_parking_fork.dxf
40
55
ZEPŘEDU
60
SHORA
ZPRAVA
postavit na horní plochu T04 kolem tyče pod stavěcí kroužek: tyč zvednutá o 30 mm
pak lze celu vyjmout (směr +y, rameno terčíku P03 natočit stranou)
průměry otvorů v pohledu shora:
přesná geometrie: vyroba/tisk/E7-P11_parking_fork.step / .stl
E7-P11 parking fork
ks: 1
materiál: PETG-CF, tisk 0,2 mm, 3 perimetry, 40 % gyroid
měřítko 1 : 1,5
nekótované tolerance ISO 2768-mK, hrany odjehlit 0,3
rozměry v mm
E7 – zatěžovací zkouška mrznutí a tání, varianta C rev. B3
2026-11-13 návrh
