martinasobotkova5/my_data_projects/e7_frost_heave_load/3d/E7_V05_variant_B_anchors.step

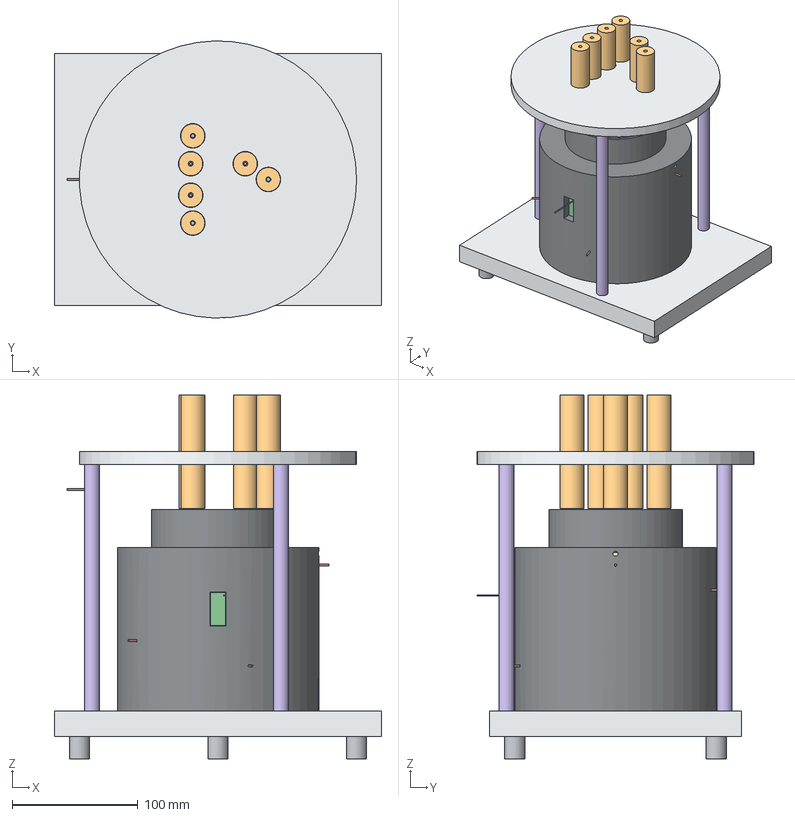
[picture p143: CAD file, 2026-10-26]
e7_frost_heave_load/3d/E7_V05_variant_B_anchors.step
260.0 x 219.9 x 289.0 mm
cell body PETG D160 (Column_one_body_version_1)
unsaturated sand D100x100
M TDR CS645 head
M TDR CS645 rod 1
M TDR CS645 rod 2
M TDR CS645 rod 3
M optical fibre
M Pt100 metal part
M Pt100 cable
T1 109SS
T2 109SS
T3 109SS
T4 109SS
T5 109SS
Al base plate 260x200x20
levelling foot 1
levelling foot 2
levelling foot 3
top plate PETG-CF D99x6
S1 rod seat
S1 core rod D3
S1 LVDT DCTH200 free core
S2 rod seat
S2 core rod D3
S2 LVDT DCTH200 free core
S3 rod seat
S3 core rod D3
S3 LVDT DCTH200 free core
E1 anchor D16 stainless
E1 PTFE sleeve D4
E1 Invar rod D2
E1 LVDT DCTH200 free core
E2 anchor D16 stainless
E2 PTFE sleeve D4
E2 Invar rod D2
E2 LVDT DCTH200 free core
E3 anchor D16 stainless
E3 PTFE sleeve D4
E3 Invar rod D2
E3 LVDT DCTH200 free core
Invar post 1
Invar post 2
Invar post 3
Al bridge D220x10 (LVDT clamps)
Tstand 109SS
