martinasobotkova5/my_data_projects/e7_frost_heave_load/3d/parts_V01_variant_C/angle_bracket_40_slot_8_Lt-20.step

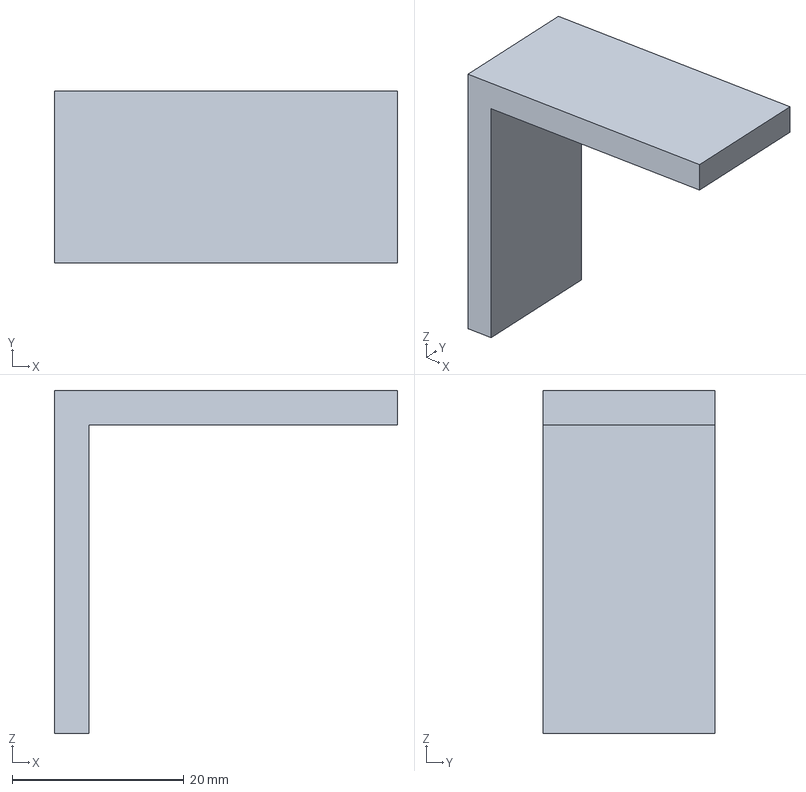
[picture p144: CAD file, 2026-11-13]
e7_frost_heave_load/3d/parts_V01_variant_C/angle_bracket_40_slot_8_Lt-20.step
40.0 x 20.0 x 40.0 mm
