martinasobotkova5/my_data_projects/e7_frost_heave_load/3d/parts_V03_variant_A_frame/M_Pt100_metal_part.step

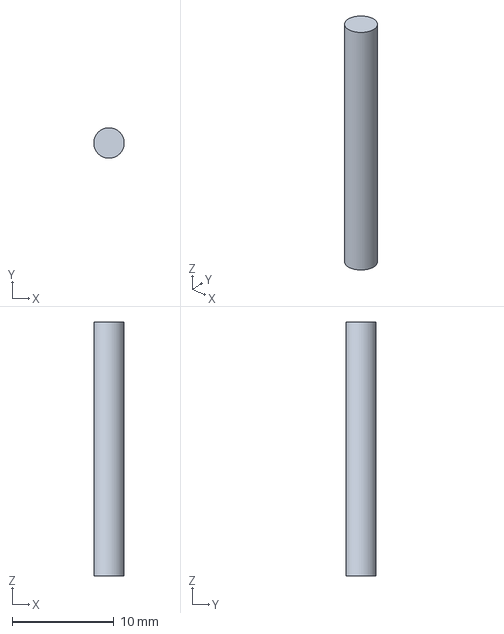
[picture p145: CAD file, 2026-10-26]
e7_frost_heave_load/3d/parts_V03_variant_A_frame/M_Pt100_metal_part.step
3.00 x 3.00 x 25.0 mm
