martinasobotkova5/my_data_projects/e7_frost_heave_load/3d/parts_V06_variant_B_open/unsaturated_sand_D100x100.step

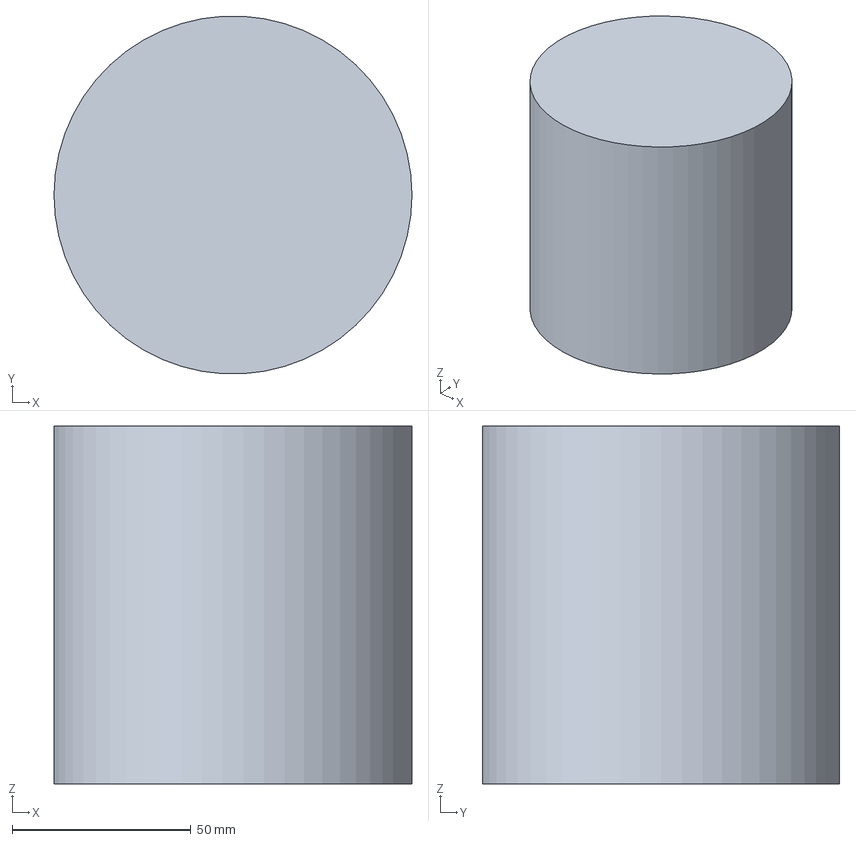
[picture p146: CAD file, 2026-10-26]
e7_frost_heave_load/3d/parts_V06_variant_B_open/unsaturated_sand_D100x100.step
100.0 x 99.8 x 100.0 mm
