martinasobotkova5/my_data_projects/e7_frost_heave_load/3d/parts_V09_variant_C_combined/PV1_cable.step

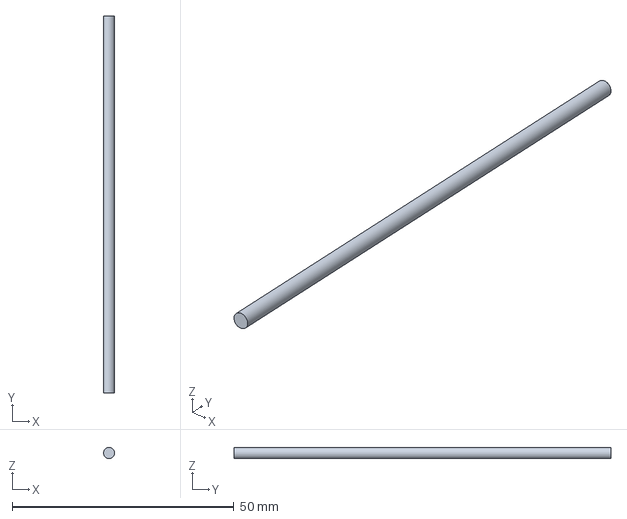
[picture p147: CAD file, 2026-10-26]
e7_frost_heave_load/3d/parts_V09_variant_C_combined/PV1_cable.step
2.50 x 85.0 x 2.50 mm
