martinasobotkova5/my_data_projects/e7_frost_heave_load/sdileni/vyroba/vykresy/E7-P04_post_foot.dxf

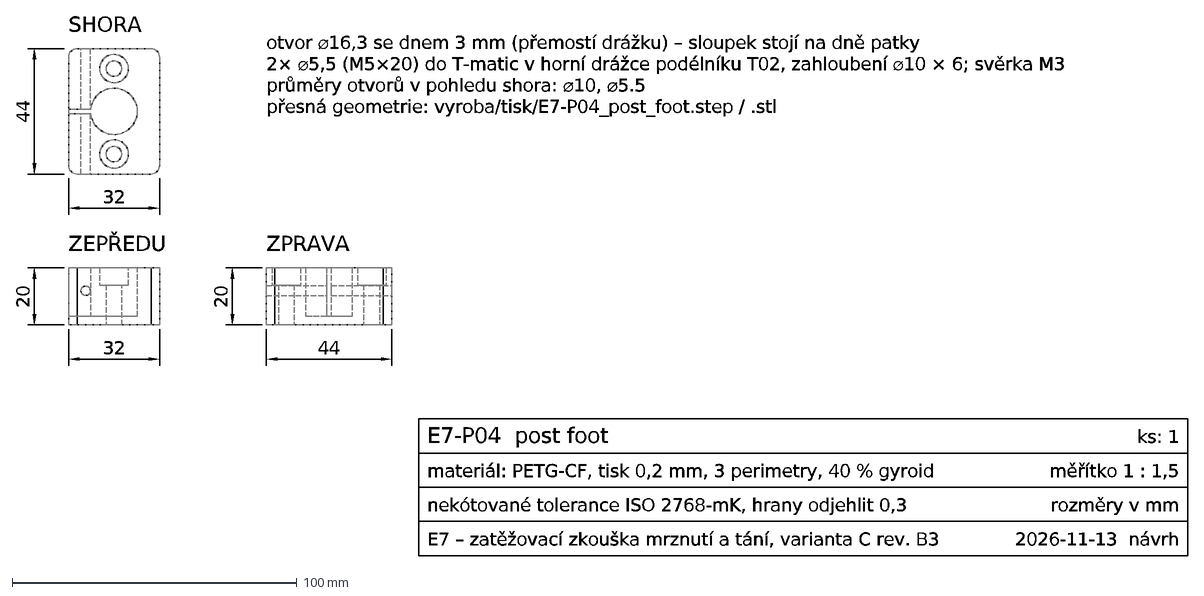
[picture p148: CAD file, 2026-11-13]
e7_frost_heave_load/sdileni/vyroba/vykresy/E7-P04_post_foot.dxf
32
20
ZEPŘEDU
44
SHORA
ZPRAVA
otvor ⌀16,3 se dnem 3 mm (přemostí drážku) – sloupek stojí na dně patky
2× ⌀5,5 (M5×20) do T-matic v horní drážce podélníku T02, zahloubení ⌀10 × 6; svěrka M3
průměry otvorů v pohledu shora: ⌀10, ⌀5.5
přesná geometrie: vyroba/tisk/E7-P04_post_foot.step / .stl
E7-P04 post foot
ks: 1
materiál: PETG-CF, tisk 0,2 mm, 3 perimetry, 40 % gyroid
měřítko 1 : 1,5
nekótované tolerance ISO 2768-mK, hrany odjehlit 0,3
rozměry v mm
E7 – zatěžovací zkouška mrznutí a tání, varianta C rev. B3
2026-11-13 návrh
