martinasobotkova5/my_data_projects/e7_frost_heave_load/3d/E7_V06_variant_B_open.step

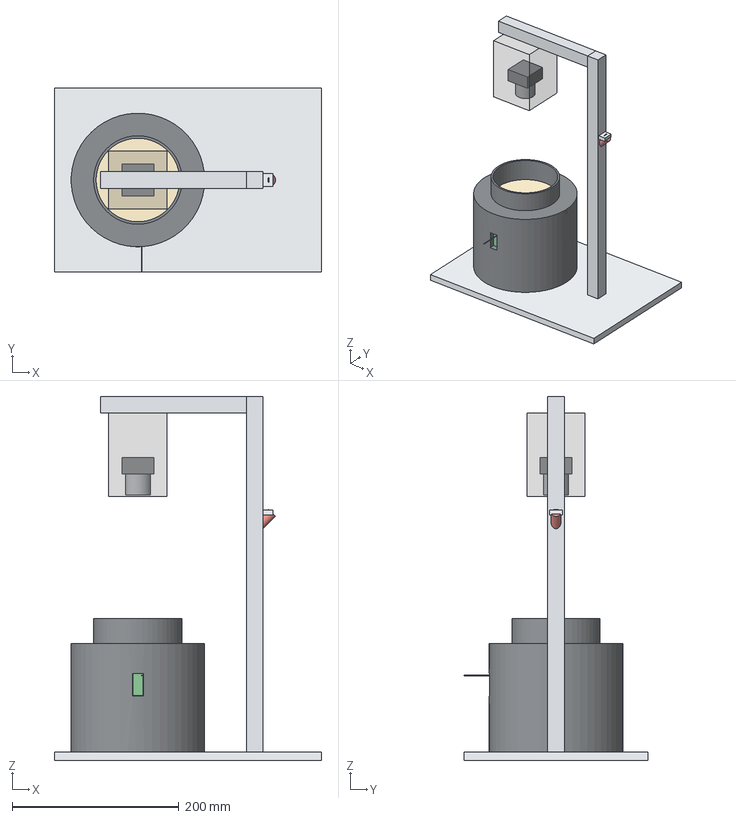
[picture p150: CAD file, 2026-10-26]
e7_frost_heave_load/3d/E7_V06_variant_B_open.step
320.0 x 220.0 x 436.0 mm
cell body PETG D160 (Column_one_body_version_1)
unsaturated sand D100x100
M TDR CS645 head
M TDR CS645 rod 1
M TDR CS645 rod 2
M TDR CS645 rod 3
M optical fibre
M Pt100 metal part
M Pt100 cable
Al base plate 320x220x10
post Al profile 20x20
arm Al profile 20x20
heated camera box XPS 30
double-glass window
lens 12 mm C-mount
Raspberry Pi HQ camera
line laser 650 nm (45 deg)
laser bracket
