martinasobotkova5/my_data_projects/e7_frost_heave_load/3d/parts_V03_variant_A_frame/column_40x80_L.step

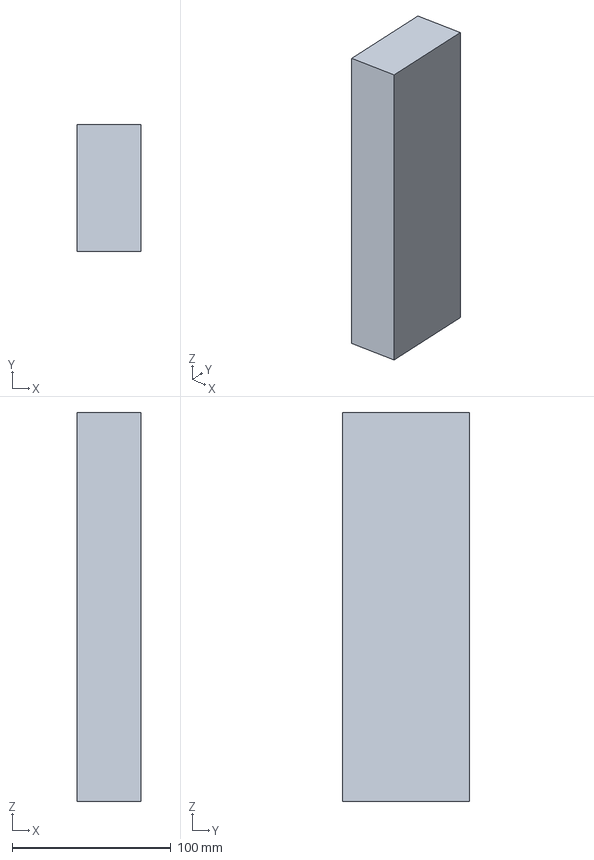
[picture p151: CAD file, 2026-10-26]
e7_frost_heave_load/3d/parts_V03_variant_A_frame/column_40x80_L.step
40.0 x 80.0 x 245.0 mm
