martinasobotkova5/my_data_projects/e7_frost_heave_load/3d/parts_V06_variant_B_open/line_laser_650_nm__45_deg.step

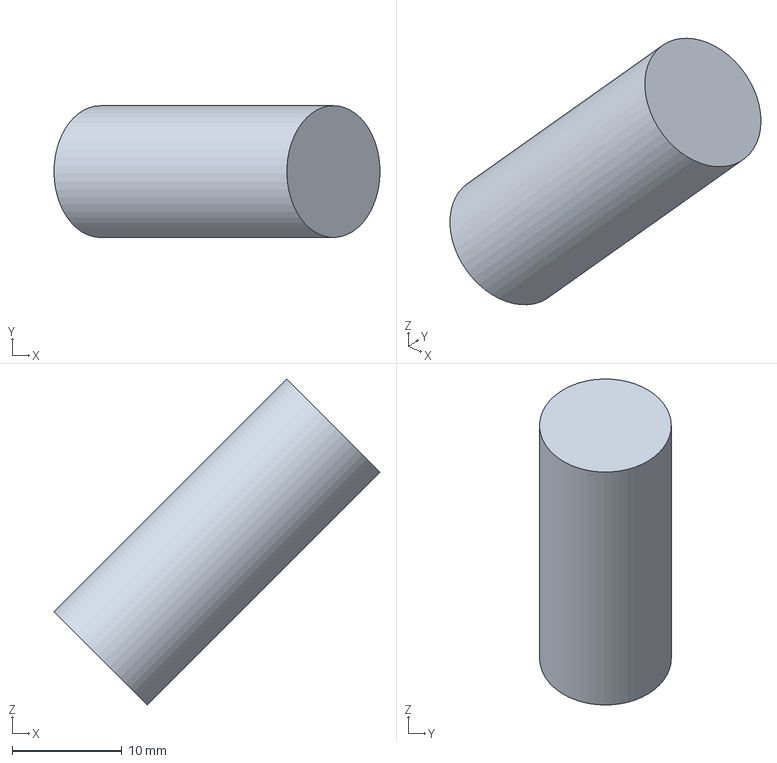
[picture p152: CAD file, 2026-10-26]
e7_frost_heave_load/3d/parts_V06_variant_B_open/line_laser_650_nm__45_deg.step
29.7 x 12.0 x 29.7 mm
