martinasobotkova5/my_data_projects/e7_frost_heave_load/sdileni/vyroba/vykresy/E7-P01_bearing_housing.dxf

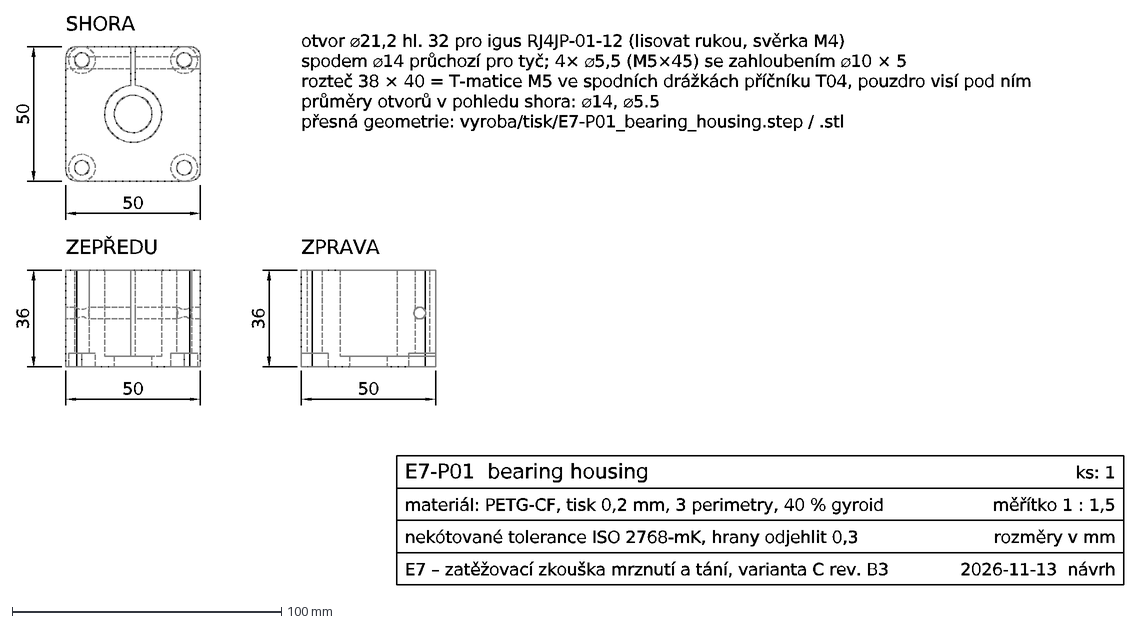
[picture p153: CAD file, 2026-11-13]
e7_frost_heave_load/sdileni/vyroba/vykresy/E7-P01_bearing_housing.dxf
50
36
ZEPŘEDU
SHORA
ZPRAVA
otvor ⌀21,2 hl. 32 pro igus RJ4JP-01-12 (lisovat rukou, svěrka M4)
spodem ⌀14 průchozí pro tyč; 4× ⌀5,5 (M5×45) se zahloubením ⌀10 × 5
rozteč 38 × 40 = T-matice M5 ve spodních drážkách příčníku T04, pouzdro visí pod ním
průměry otvorů v pohledu shora: ⌀14, ⌀5.5
přesná geometrie: vyroba/tisk/E7-P01_bearing_housing.step / .stl
E7-P01 bearing housing
ks: 1
materiál: PETG-CF, tisk 0,2 mm, 3 perimetry, 40 % gyroid
měřítko 1 : 1,5
nekótované tolerance ISO 2768-mK, hrany odjehlit 0,3
rozměry v mm
E7 – zatěžovací zkouška mrznutí a tání, varianta C rev. B3
2026-11-13 návrh
