martinasobotkova5/my_data_projects/e7_frost_heave_load/vyroba/tisk/E7-P05_laser_holder.step

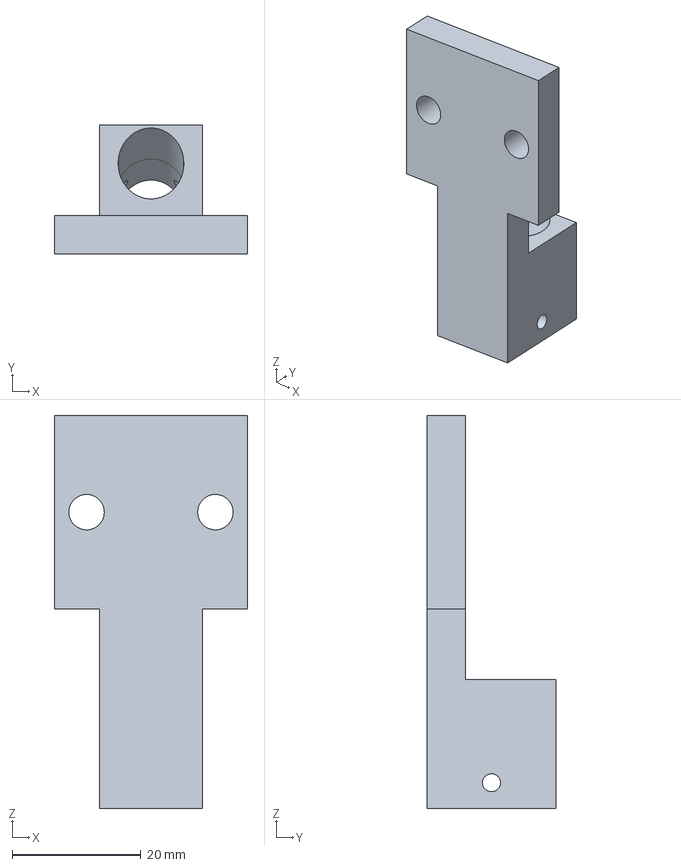
[picture p154: CAD file, 2026-11-09]
e7_frost_heave_load/vyroba/tisk/E7-P05_laser_holder.step
30.0 x 20.0 x 61.0 mm
