martinasobotkova5/my_data_projects/e7_frost_heave_load/vyroba/vykresy/E7-P05_laser_holder.dxf

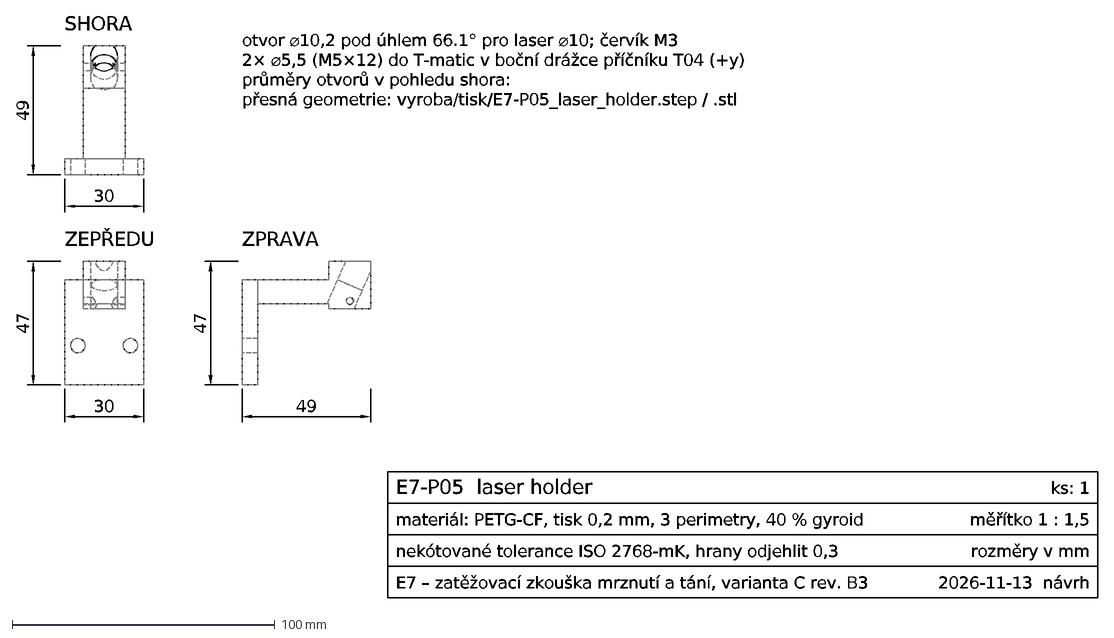
[picture p155: CAD file, 2026-11-13]
e7_frost_heave_load/vyroba/vykresy/E7-P05_laser_holder.dxf
30
47
ZEPŘEDU
49
SHORA
ZPRAVA
otvor ⌀10,2 pod úhlem 66.1° pro laser ⌀10; červík M3
2× ⌀5,5 (M5×12) do T-matic v boční drážce příčníku T04 (+y)
průměry otvorů v pohledu shora:
přesná geometrie: vyroba/tisk/E7-P05_laser_holder.step / .stl
E7-P05 laser holder
ks: 1
materiál: PETG-CF, tisk 0,2 mm, 3 perimetry, 40 % gyroid
měřítko 1 : 1,5
nekótované tolerance ISO 2768-mK, hrany odjehlit 0,3
rozměry v mm
E7 – zatěžovací zkouška mrznutí a tání, varianta C rev. B3
2026-11-13 návrh
