martinasobotkova5/my_data_projects/e7_frost_heave_load/3d/parts_V01_variant_C/M_optical_fibre.step

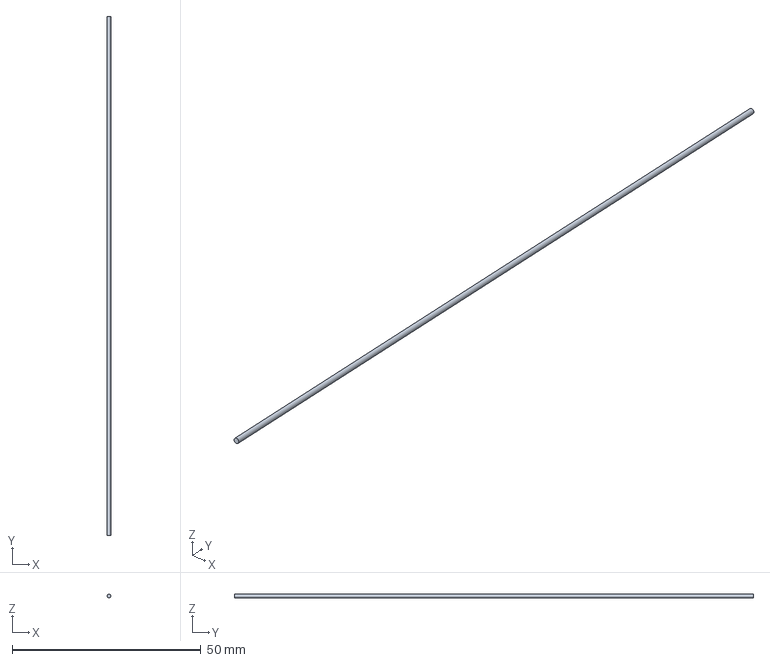
[picture p156: CAD file, 2026-11-13]
e7_frost_heave_load/3d/parts_V01_variant_C/M_optical_fibre.step
0.999 x 137.5 x 1 mm
