martinasobotkova5/my_data_projects/e7_frost_heave_load/3d/parts_V06_variant_B_open/M_optical_fibre.step

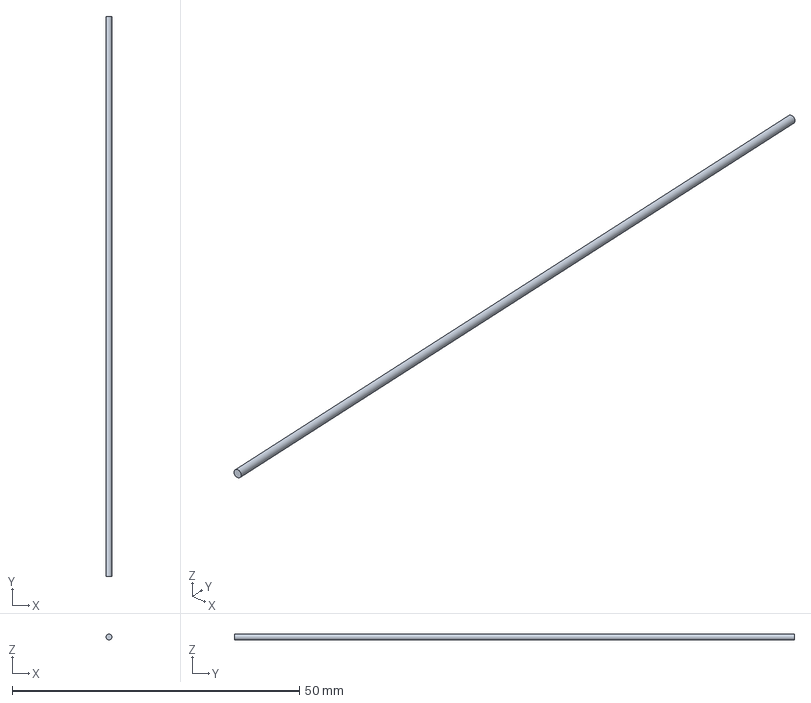
[picture p157: CAD file, 2026-10-26]
e7_frost_heave_load/3d/parts_V06_variant_B_open/M_optical_fibre.step
0.999 x 97.5 x 1 mm
