martinasobotkova5/my_data_projects/e7_frost_heave_load/sdileni/vyroba/vykresy/E7-L05_piston_bottom.dxf

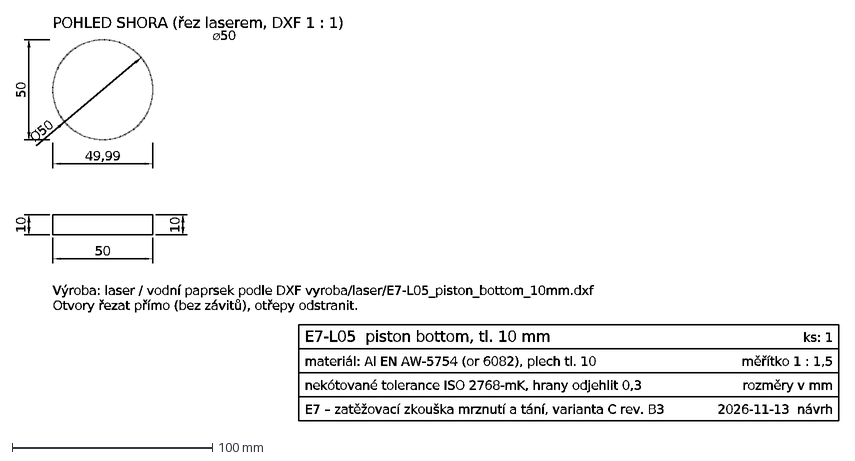
[picture p158: CAD file, 2026-11-13]
e7_frost_heave_load/sdileni/vyroba/vykresy/E7-L05_piston_bottom.dxf
49,99
50
POHLED SHORA (řez laserem, DXF 1 : 1)
10
Ø50
⌀50
Výroba: laser / vodní paprsek podle DXF vyroba/laser/E7-L05_piston_bottom_10mm.dxf
Otvory řezat přímo (bez závitů), otřepy odstranit.
E7-L05 piston bottom, tl. 10 mm
ks: 1
materiál: Al EN AW-5754 (or 6082), plech tl. 10
měřítko 1 : 1,5
nekótované tolerance ISO 2768-mK, hrany odjehlit 0,3
rozměry v mm
E7 – zatěžovací zkouška mrznutí a tání, varianta C rev. B3
2026-11-13 návrh
