martinasobotkova5/my_data_projects/e7_frost_heave_load/3d/E7_variant_A.step

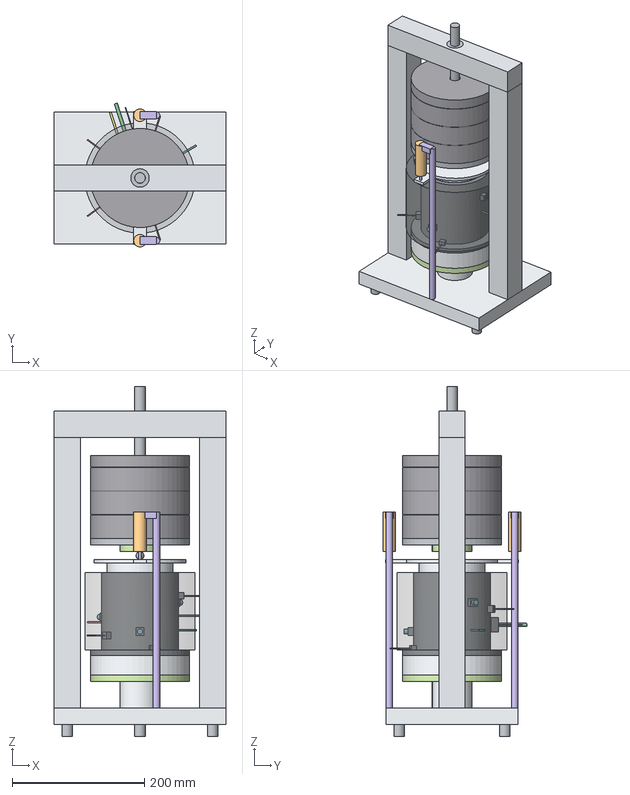
[picture p160: CAD file, 2026-10-21]
e7_frost_heave_load/3d/E7_variant_A.step
260.0 x 218.0 x 530.0 mm
base plate Al 6082
levelling foot 1
levelling foot 2
levelling foot 3
column 40x40 L
column 40x40 R
cross-bar 40x40 (guide only)
linear ball bushing D16
Al spacer (bottom)
G10 thermal break
pedestal Al
porous stone bottom
PW1 wall pressure sensor
PW2 wall pressure sensor
PW3 wall pressure sensor
M TDR probe head (epoxy)
M TDR rod 1 D1.6
M TDR rod 2 D1.6
M TDR rod 3 D1.6
M TDR coax cable
M Pt100 1/10 DIN D3
M FBG temperature sensor (capillary D1)
cell PETG-CF (solid print)
PTFE liner 0.5
insulation Kaiflex 25
T1 109SS
T2 109SS
T3 109SS
T4 109SS
T5 109SS
unsaturated sand D100x100
porous stone top
piston Al
LVDT target plate
steel ball D12
Tbot 109SS
Ttop 109SS
target tab -y
LVDT-1 DCTH400
LVDT-1 plunger
Invar post 1
LVDT clamp arm 1
target tab +y
LVDT-2 DCTH400
LVDT-2 plunger
Invar post 2
LVDT clamp arm 2
PV1 earth pressure cell (vertical stress)
PV1 cable
PH1 earth pressure cell (radial stress)
PH1 cable
PB1 base pressure sensor (flush)
G10 thermal break D60x10
carrier plate steel D150x10
guide rod D16
steel disc 1 D150x36
steel disc 2 D150x36
steel disc 3 D150x36
steel disc 4 D150x18
Tw 109SS (weights)
