martinasobotkova5/my_data_projects/e7_frost_heave_load/sdileni/vyroba/vykresy/E7-P02_lvdt_arm.dxf

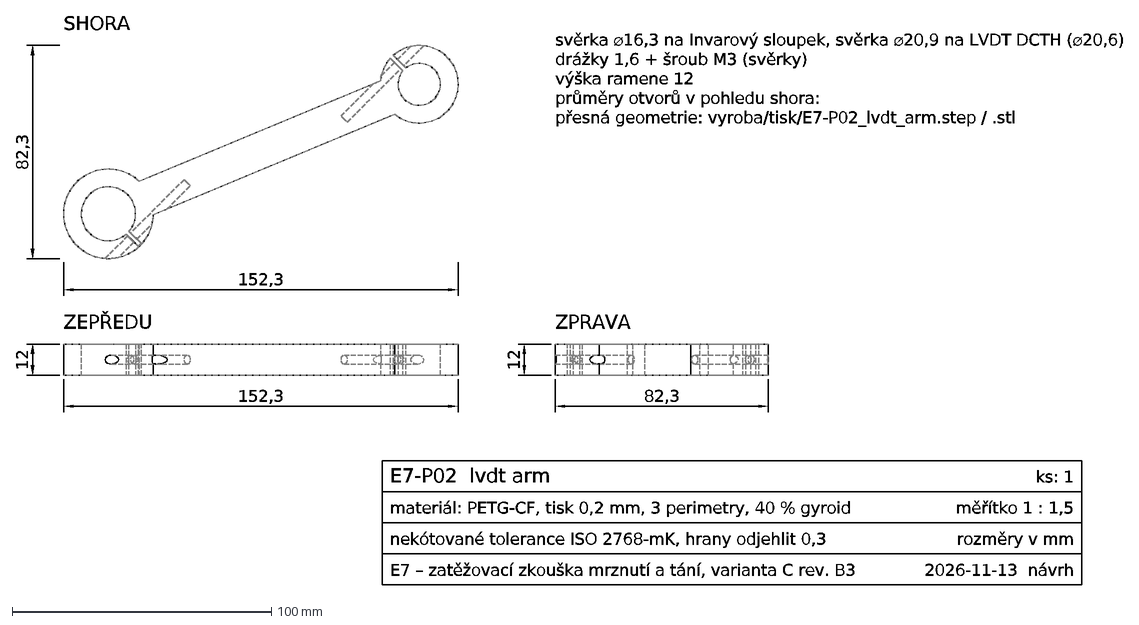
[picture p161: CAD file, 2026-11-13]
e7_frost_heave_load/sdileni/vyroba/vykresy/E7-P02_lvdt_arm.dxf
152,3
12
ZEPŘEDU
82,3
SHORA
ZPRAVA
svěrka ⌀16,3 na Invarový sloupek, svěrka ⌀20,9 na LVDT DCTH (⌀20,6)
drážky 1,6 + šroub M3 (svěrky)
výška ramene 12
průměry otvorů v pohledu shora:
přesná geometrie: vyroba/tisk/E7-P02_lvdt_arm.step / .stl
E7-P02 lvdt arm
ks: 1
materiál: PETG-CF, tisk 0,2 mm, 3 perimetry, 40 % gyroid
měřítko 1 : 1,5
nekótované tolerance ISO 2768-mK, hrany odjehlit 0,3
rozměry v mm
E7 – zatěžovací zkouška mrznutí a tání, varianta C rev. B3
2026-11-13 návrh
