martinasobotkova5/my_data_projects/e7_frost_heave_load/sdileni/vyroba/vykresy/E7-B03_G10_pad.dxf

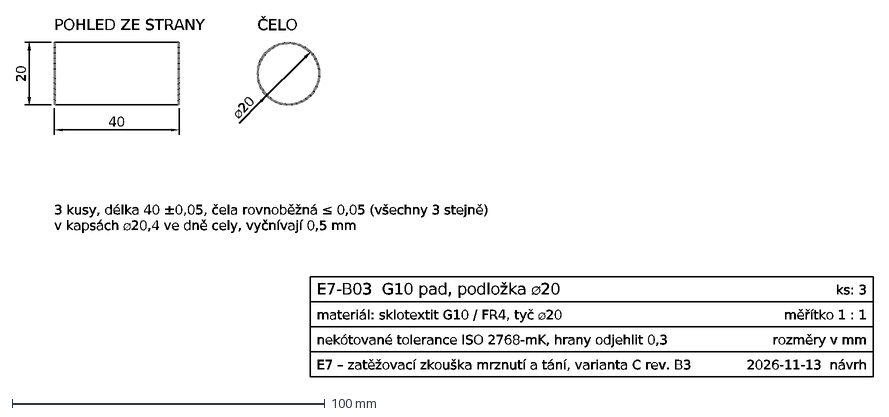
[picture p163: CAD file, 2026-11-13]
e7_frost_heave_load/sdileni/vyroba/vykresy/E7-B03_G10_pad.dxf
40
20
POHLED ZE STRANY
ČELO
⌀20
3 kusy, délka 40 ±0,05, čela rovnoběžná ≤ 0,05 (všechny 3 stejně)
v kapsách ⌀20,4 ve dně cely, vyčnívají 0,5 mm
E7-B03 G10 pad, podložka ⌀20
ks: 3
materiál: sklotextit G10 / FR4, tyč ⌀20
měřítko 1 : 1
nekótované tolerance ISO 2768-mK, hrany odjehlit 0,3
rozměry v mm
E7 – zatěžovací zkouška mrznutí a tání, varianta C rev. B3
2026-11-13 návrh
