martinasobotkova5/my_data_projects/e7_frost_heave_load/3d/parts_V01_variant_C/Invar_36_post_D16_x330.step

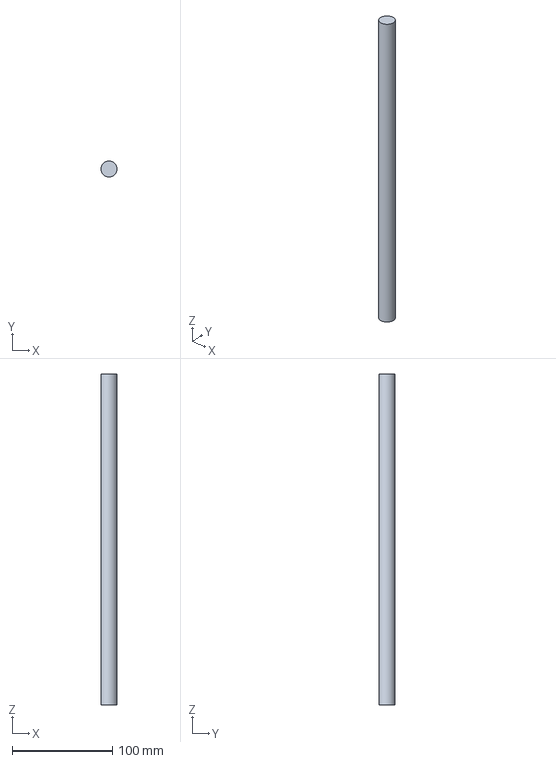
[picture p165: CAD file, 2026-11-13]
e7_frost_heave_load/3d/parts_V01_variant_C/Invar_36_post_D16_x330.step
16.0 x 16.0 x 330.0 mm
