martinasobotkova5/my_data_projects/e7_frost_heave_load/3d/parts_V06_variant_B_open/M_Pt100_cable.step

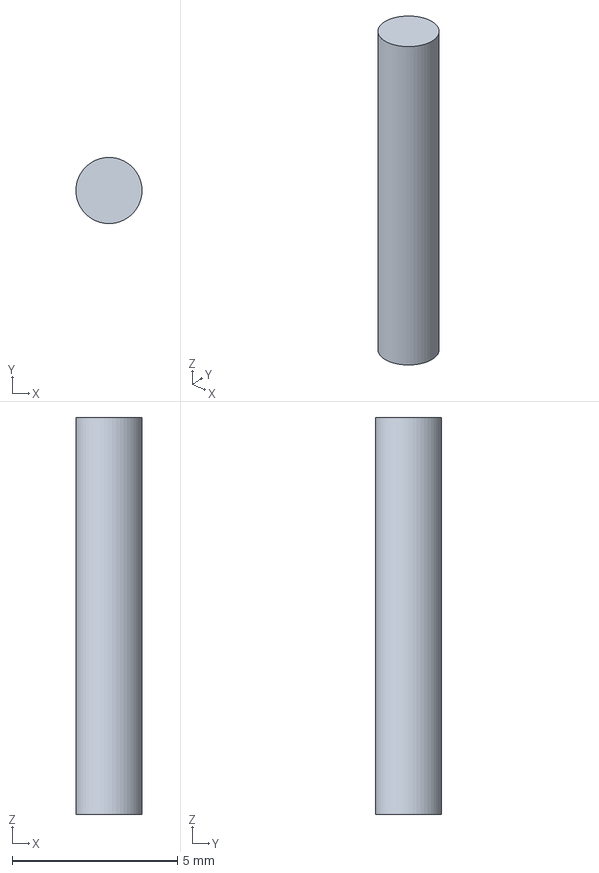
[picture p166: CAD file, 2026-10-26]
e7_frost_heave_load/3d/parts_V06_variant_B_open/M_Pt100_cable.step
2.00 x 2.00 x 12.0 mm
