martinasobotkova5/my_data_projects/e7_frost_heave_load/sdileni/vyroba/vykresy/E7-P07_camera_box_lid.dxf

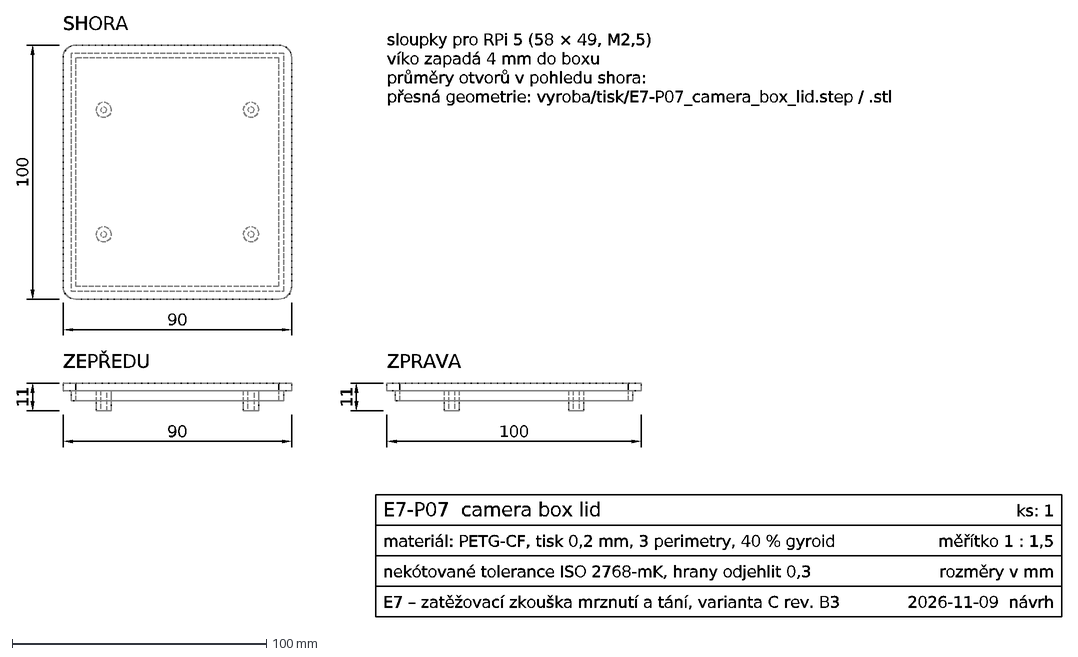
[picture p167: CAD file, 2026-11-09]
e7_frost_heave_load/sdileni/vyroba/vykresy/E7-P07_camera_box_lid.dxf
90
11
ZEPŘEDU
100
SHORA
ZPRAVA
sloupky pro RPi 5 (58 × 49, M2,5)
víko zapadá 4 mm do boxu
průměry otvorů v pohledu shora:
přesná geometrie: vyroba/tisk/E7-P07_camera_box_lid.step / .stl
E7-P07 camera box lid
ks: 1
materiál: PETG-CF, tisk 0,2 mm, 3 perimetry, 40 % gyroid
měřítko 1 : 1,5
nekótované tolerance ISO 2768-mK, hrany odjehlit 0,3
rozměry v mm
E7 – zatěžovací zkouška mrznutí a tání, varianta C rev. B3
2026-11-09 návrh
