martinasobotkova5/my_data_projects/e7_frost_heave_load/3d/parts_V06_variant_B_open/double-glass_window.step

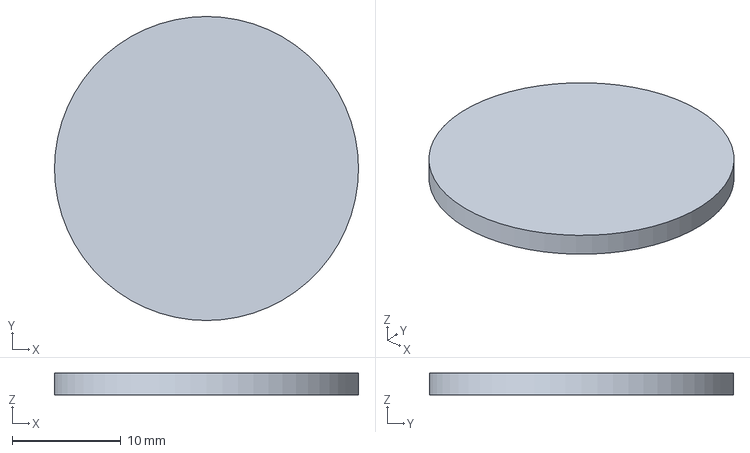
[picture p169: CAD file, 2026-10-26]
e7_frost_heave_load/3d/parts_V06_variant_B_open/double-glass_window.step
28.0 x 28.0 x 2.00 mm
