martinasobotkova5/my_data_projects/e7_frost_heave_load/vyroba/vykresy/E7-B01_invar_rod.dxf

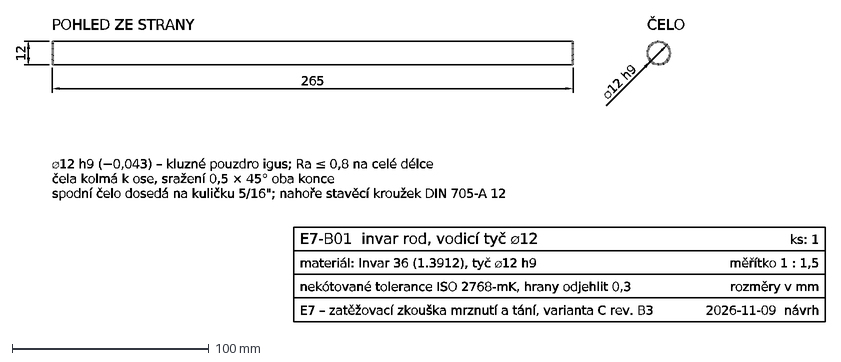
[picture p171: CAD file, 2026-11-09]
e7_frost_heave_load/vyroba/vykresy/E7-B01_invar_rod.dxf
265
12
POHLED ZE STRANY
ČELO
⌀12 h9
⌀12 h9 (−0,043) – kluzné pouzdro igus; Ra ≤ 0,8 na celé délce
čela kolmá k ose, sražení 0,5 × 45° oba konce
spodní čelo dosedá na kuličku 5/16"; nahoře stavěcí kroužek DIN 705-A 12
E7-B01 invar rod, vodicí tyč ⌀12
ks: 1
materiál: Invar 36 (1.3912), tyč ⌀12 h9
měřítko 1 : 1,5
nekótované tolerance ISO 2768-mK, hrany odjehlit 0,3
rozměry v mm
E7 – zatěžovací zkouška mrznutí a tání, varianta C rev. B3
2026-11-09 návrh
