martinasobotkova5/my_data_projects/e7_frost_heave_load/3d/parts_V01_variant_C/T01_column_40x80_slot_8_x306_R.step

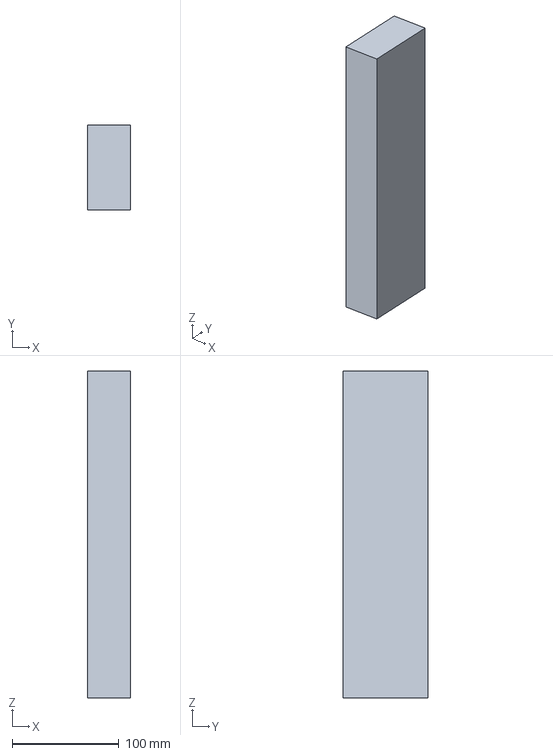
[picture p172: CAD file, 2026-11-13]
e7_frost_heave_load/3d/parts_V01_variant_C/T01_column_40x80_slot_8_x306_R.step
40.0 x 80.0 x 306.0 mm
