martinasobotkova5/my_data_projects/e7_frost_heave_load/3d/parts_V03_variant_A_frame/POM-C_thermal_insert_D40x8.step

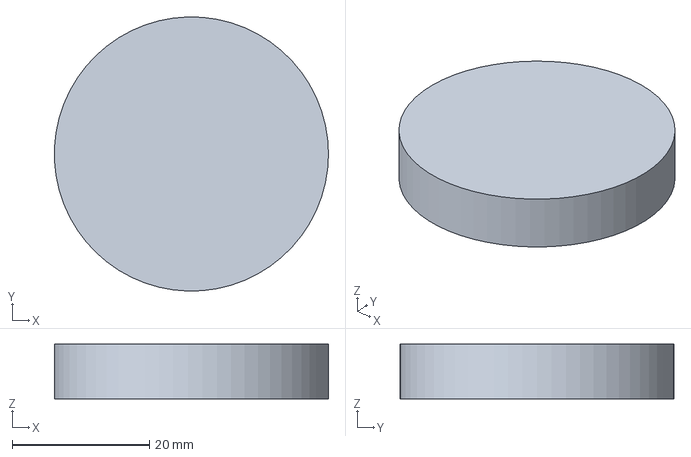
[picture p173: CAD file, 2026-10-26]
e7_frost_heave_load/3d/parts_V03_variant_A_frame/POM-C_thermal_insert_D40x8.step
40.0 x 40.0 x 8.00 mm
