martinasobotkova5/my_data_projects/e7_frost_heave_load/3d/parts_V06_variant_B_open/arm_Al_profile_20x20.step

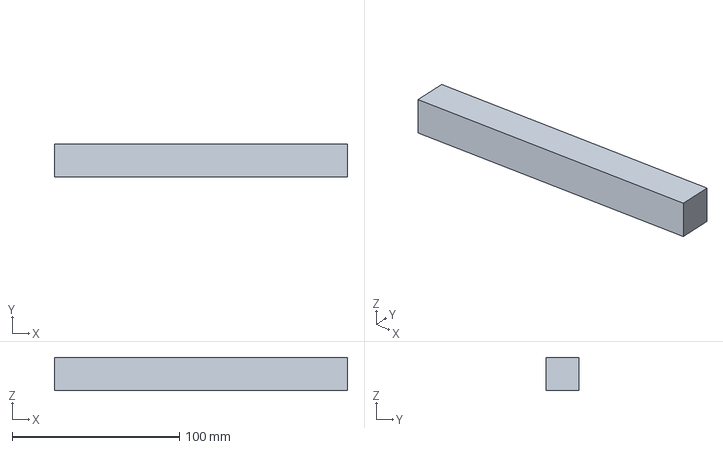
[picture p174: CAD file, 2026-10-26]
e7_frost_heave_load/3d/parts_V06_variant_B_open/arm_Al_profile_20x20.step
175.0 x 20.0 x 20.0 mm
