martinasobotkova5/my_data_projects/e7_frost_heave_load/sdileni/vyroba/vykresy/E7-P09_centering_cap.dxf

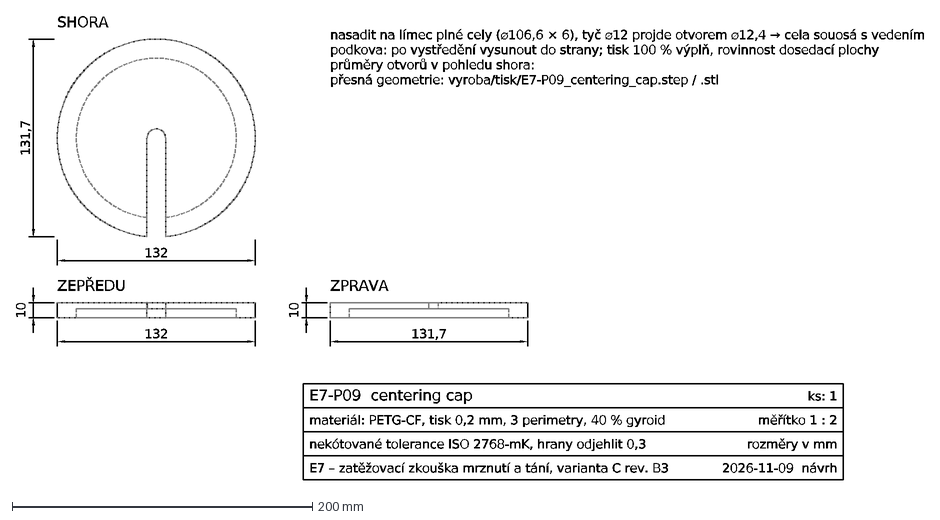
[picture p175: CAD file, 2026-11-09]
e7_frost_heave_load/sdileni/vyroba/vykresy/E7-P09_centering_cap.dxf
132
10
ZEPŘEDU
131,7
SHORA
ZPRAVA
nasadit na límec plné cely (⌀106,6 × 6), tyč ⌀12 projde otvorem ⌀12,4 → cela souosá s vedením
podkova: po vystředění vysunout do strany; tisk 100 % výplň, rovinnost dosedací plochy
průměry otvorů v pohledu shora:
přesná geometrie: vyroba/tisk/E7-P09_centering_cap.step / .stl
E7-P09 centering cap
ks: 1
materiál: PETG-CF, tisk 0,2 mm, 3 perimetry, 40 % gyroid
měřítko 1 : 2
nekótované tolerance ISO 2768-mK, hrany odjehlit 0,3
rozměry v mm
E7 – zatěžovací zkouška mrznutí a tání, varianta C rev. B3
2026-11-09 návrh
