martinasobotkova5/my_data_projects/e7_frost_heave_load/vyroba/vykresy/E7-T04_top_beam.dxf

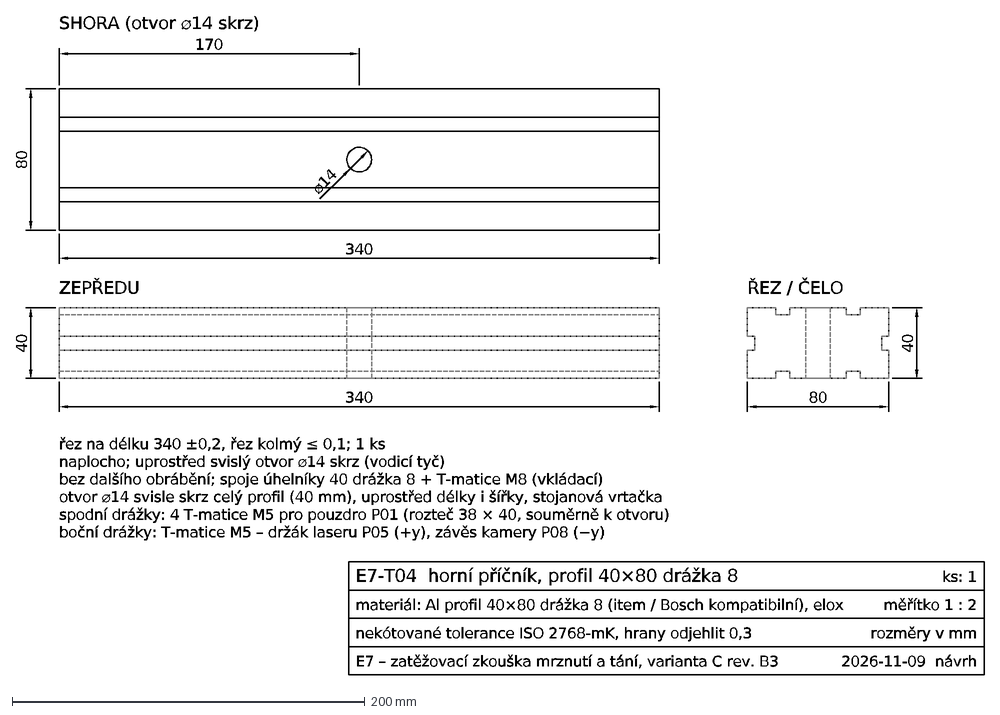
[picture p176: CAD file, 2026-11-09]
e7_frost_heave_load/vyroba/vykresy/E7-T04_top_beam.dxf
340
40
ZEPŘEDU
80
SHORA (otvor ⌀14 skrz)
ŘEZ / ČELO
170
⌀14
řez na délku 340 ±0,2, řez kolmý ≤ 0,1; 1 ks
naplocho; uprostřed svislý otvor ⌀14 skrz (vodicí tyč)
bez dalšího obrábění; spoje úhelníky 40 drážka 8 + T-matice M8 (vkládací)
otvor ⌀14 svisle skrz celý profil (40 mm), uprostřed délky i šířky, stojanová vrtačka
spodní drážky: 4 T-matice M5 pro pouzdro P01 (rozteč 38 × 40, souměrně k otvoru)
boční drážky: T-matice M5 – držák laseru P05 (+y), závěs kamery P08 (−y)
E7-T04 horní příčník, profil 40×80 drážka 8
ks: 1
materiál: Al profil 40×80 drážka 8 (item / Bosch kompatibilní), elox
měřítko 1 : 2
nekótované tolerance ISO 2768-mK, hrany odjehlit 0,3
rozměry v mm
E7 – zatěžovací zkouška mrznutí a tání, varianta C rev. B3
2026-11-09 návrh
