martinasobotkova5/my_data_projects/e7_frost_heave_load/3d/E7_multiring_cell.step

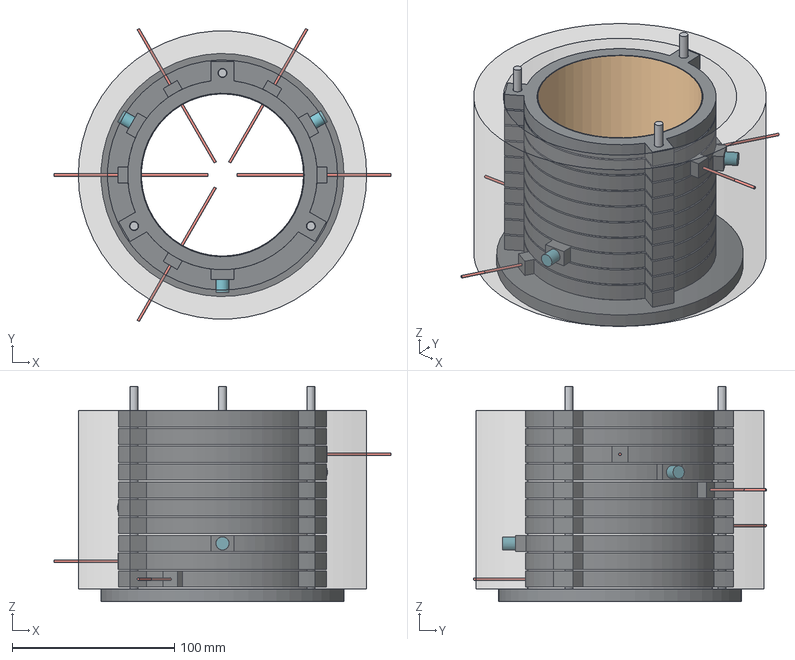
[picture p177: CAD file, 2026-10-20]
e7_frost_heave_load/3d/E7_multiring_cell.step
208.0 x 180.9 x 133.0 mm
multi-ring base ring PETG-CF
ring 01 PETG-CF
PTFE washer 01
ring 02 PETG-CF
PTFE washer 02
PW3 wall pressure sensor
ring 03 PETG-CF
PTFE washer 03
ring 04 PETG-CF
PTFE washer 04
PW2 wall pressure sensor
ring 05 PETG-CF
PTFE washer 05
ring 06 PETG-CF
PTFE washer 06
PW1 wall pressure sensor
ring 07 PETG-CF
PTFE washer 07
ring 08 PETG-CF
PTFE washer 08
ring 09 PETG-CF
PTFE washer 09
ring 10 PETG-CF
PTFE washer 10
guide rod 1 (PTFE-coated)
guide rod 2 (PTFE-coated)
guide rod 3 (PTFE-coated)
latex membrane 0.3 (greased)
insulation Kaiflex 18
T1 109SS
T2 109SS
T3 109SS
T4 109SS
T5 109SS
