martinasobotkova5/my_data_projects/e7_frost_heave_load/3d/parts_V03_variant_A_frame/cross-beam_80x80.step

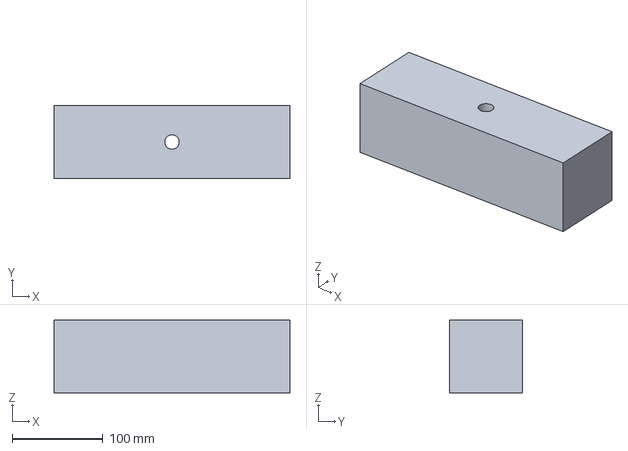
[picture p178: CAD file, 2026-10-26]
e7_frost_heave_load/3d/parts_V03_variant_A_frame/cross-beam_80x80.step
260.0 x 80.0 x 80.0 mm
