martinasobotkova5/my_data_projects/e7_frost_heave_load/3d/parts_V06_variant_B_open/Al_base_plate_320x220x10.step

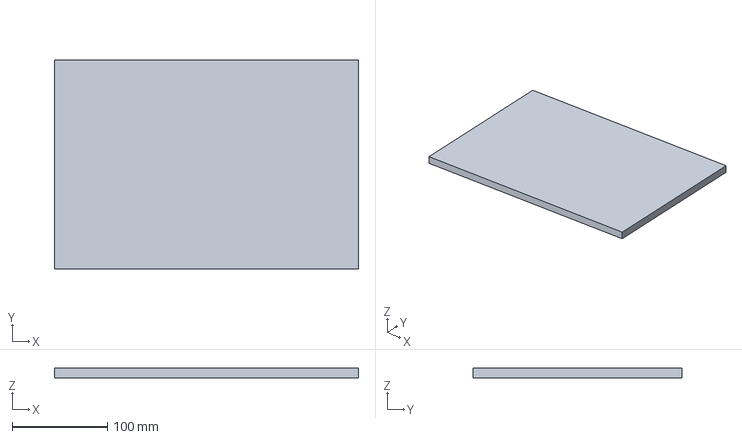
[picture p179: CAD file, 2026-10-26]
e7_frost_heave_load/3d/parts_V06_variant_B_open/Al_base_plate_320x220x10.step
320.0 x 220.0 x 10.0 mm
