martinasobotkova5/my_data_projects/e7_frost_heave_load/vyroba/vykresy/E7-L04_piston_top.dxf

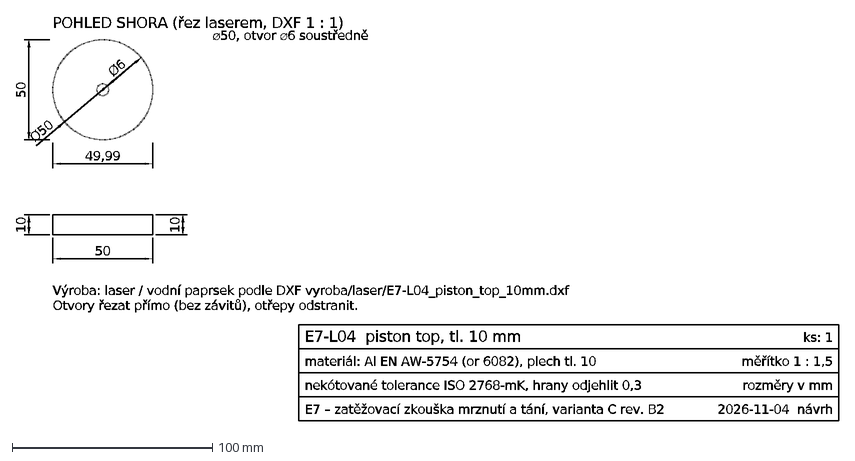
[picture p181: CAD file, 2026-11-04]
e7_frost_heave_load/vyroba/vykresy/E7-L04_piston_top.dxf
49,99
50
POHLED SHORA (řez laserem, DXF 1 : 1)
10
Ø50
Ø6
⌀50, otvor ⌀6 soustředně
Výroba: laser / vodní paprsek podle DXF vyroba/laser/E7-L04_piston_top_10mm.dxf
Otvory řezat přímo (bez závitů), otřepy odstranit.
E7-L04 piston top, tl. 10 mm
ks: 1
materiál: Al EN AW-5754 (or 6082), plech tl. 10
měřítko 1 : 1,5
nekótované tolerance ISO 2768-mK, hrany odjehlit 0,3
rozměry v mm
E7 – zatěžovací zkouška mrznutí a tání, varianta C rev. B2
2026-11-04 návrh
