martinasobotkova5/my_data_projects/e7_frost_heave_load/3d/parts_V09_variant_C_combined/PB1_TML_PDA-PA__flush.step

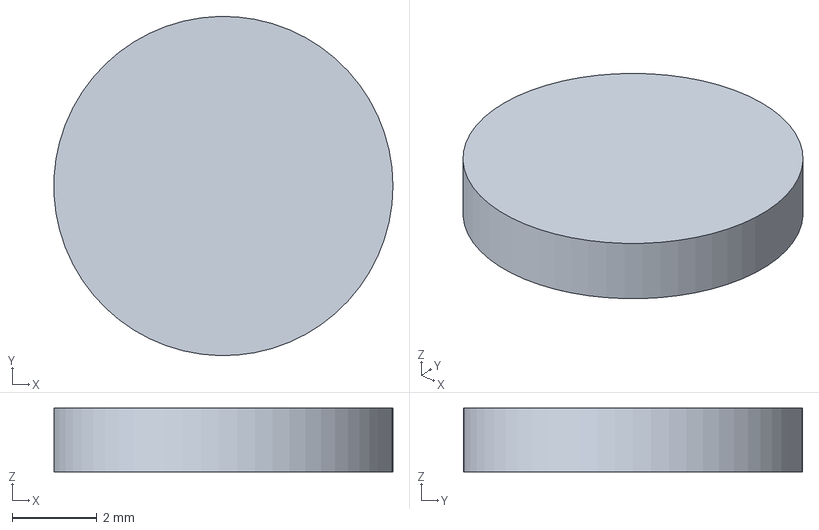
[picture p183: CAD file, 2026-10-26]
e7_frost_heave_load/3d/parts_V09_variant_C_combined/PB1_TML_PDA-PA__flush.step
7.99 x 8.00 x 1.50 mm
