martinasobotkova5/my_data_projects/e7_frost_heave_load/vyroba/vykresy/E7-P08_camera_hanger.dxf

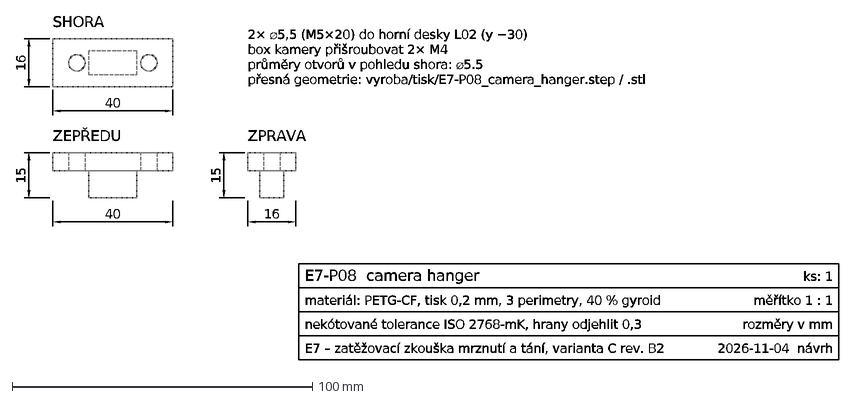
[picture p185: CAD file, 2026-11-04]
e7_frost_heave_load/vyroba/vykresy/E7-P08_camera_hanger.dxf
40
15
ZEPŘEDU
16
SHORA
ZPRAVA
2× ⌀5,5 (M5×20) do horní desky L02 (y −30)
box kamery přišroubovat 2× M4
průměry otvorů v pohledu shora: ⌀5.5
přesná geometrie: vyroba/tisk/E7-P08_camera_hanger.step / .stl
E7-P08 camera hanger
ks: 1
materiál: PETG-CF, tisk 0,2 mm, 3 perimetry, 40 % gyroid
měřítko 1 : 1
nekótované tolerance ISO 2768-mK, hrany odjehlit 0,3
rozměry v mm
E7 – zatěžovací zkouška mrznutí a tání, varianta C rev. B2
2026-11-04 návrh
