martinasobotkova5/my_data_projects/e7_frost_heave_load/3d/E7_variant_A_multiring.step

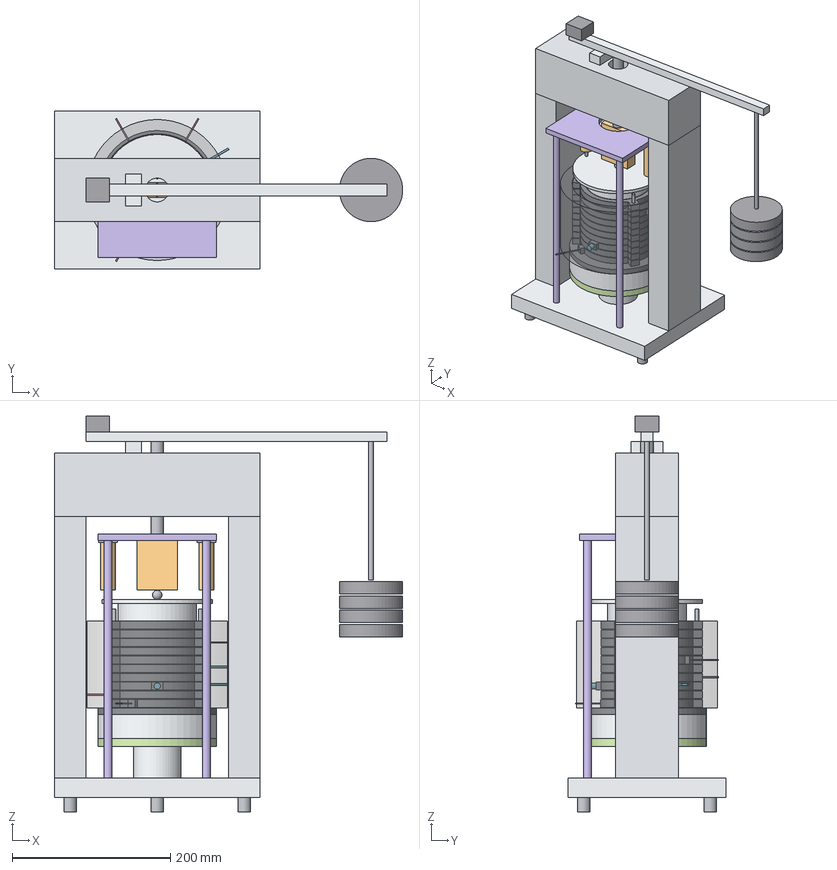
[picture p186: CAD file, 2026-10-20]
e7_frost_heave_load/3d/E7_variant_A_multiring.step
440.0 x 200.0 x 500.0 mm
base plate Al 6082
levelling foot 1
levelling foot 2
levelling foot 3
column 40x80 L
column 40x80 R
cross-beam 80x80
Al spacer (bottom)
G10 thermal break
pedestal Al
porous stone bottom
multi-ring base ring PETG-CF
ring 01 PETG-CF
PTFE washer 01
ring 02 PETG-CF
PTFE washer 02
PW3 wall pressure sensor
ring 03 PETG-CF
PTFE washer 03
ring 04 PETG-CF
PTFE washer 04
PW2 wall pressure sensor
ring 05 PETG-CF
PTFE washer 05
ring 06 PETG-CF
PTFE washer 06
PW1 wall pressure sensor
ring 07 PETG-CF
PTFE washer 07
ring 08 PETG-CF
PTFE washer 08
ring 09 PETG-CF
PTFE washer 09
ring 10 PETG-CF
PTFE washer 10
guide rod 1 (PTFE-coated)
guide rod 2 (PTFE-coated)
guide rod 3 (PTFE-coated)
latex membrane 0.3 (greased)
insulation Kaiflex 18
T1 109SS
T2 109SS
T3 109SS
T4 109SS
T5 109SS
unsaturated sand D100x100
porous stone top
piston Al
LVDT target plate
steel ball D12
Tbot 109SS
Ttop 109SS
Invar rod L
LVDT-1 DCTH400
LVDT-1 plunger
Invar rod R
LVDT-2 DCTH400
LVDT-2 plunger
Invar/Al LVDT bridge
PV1 earth pressure cell (vertical stress)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
