martinasobotkova5/my_data_projects/e7_frost_heave_load/vyroba/vykresy/E7-L02_top_plate.dxf

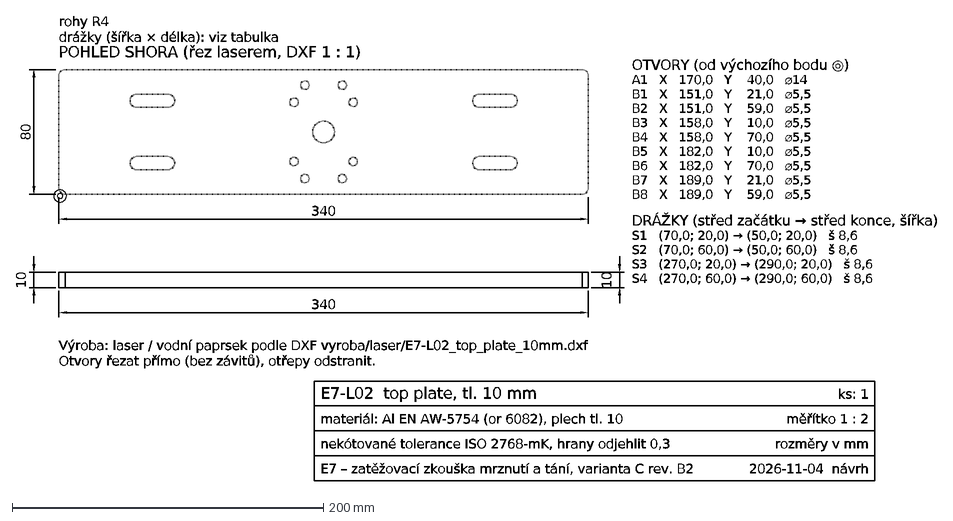
[picture p188: CAD file, 2026-11-04]
e7_frost_heave_load/vyroba/vykresy/E7-L02_top_plate.dxf
340
80
POHLED SHORA (řez laserem, DXF 1 : 1)
10
◎
rohy R4
drážky (šířka × délka): viz tabulka
OTVORY (od výchozího bodu ◎)
A1 X 170,0 Y 40,0 ⌀14
B1 X 151,0 Y 21,0 ⌀5,5
B2 X 151,0 Y 59,0 ⌀5,5
B3 X 158,0 Y 10,0 ⌀5,5
B4 X 158,0 Y 70,0 ⌀5,5
B5 X 182,0 Y 10,0 ⌀5,5
B6 X 182,0 Y 70,0 ⌀5,5
B7 X 189,0 Y 21,0 ⌀5,5
B8 X 189,0 Y 59,0 ⌀5,5
DRÁŽKY (střed začátku → střed konce, šířka)
S1 (70,0; 20,0) → (50,0; 20,0) š 8,6
S2 (70,0; 60,0) → (50,0; 60,0) š 8,6
S3 (270,0; 20,0) → (290,0; 20,0) š 8,6
S4 (270,0; 60,0) → (290,0; 60,0) š 8,6
Výroba: laser / vodní paprsek podle DXF vyroba/laser/E7-L02_top_plate_10mm.dxf
Otvory řezat přímo (bez závitů), otřepy odstranit.
E7-L02 top plate, tl. 10 mm
ks: 1
materiál: Al EN AW-5754 (or 6082), plech tl. 10
měřítko 1 : 2
nekótované tolerance ISO 2768-mK, hrany odjehlit 0,3
rozměry v mm
E7 – zatěžovací zkouška mrznutí a tání, varianta C rev. B2
2026-11-04 návrh
