martinasobotkova5/my_data_projects/e7_frost_heave_load/3d/parts_V03_variant_A_frame/levelling_foot_1.step

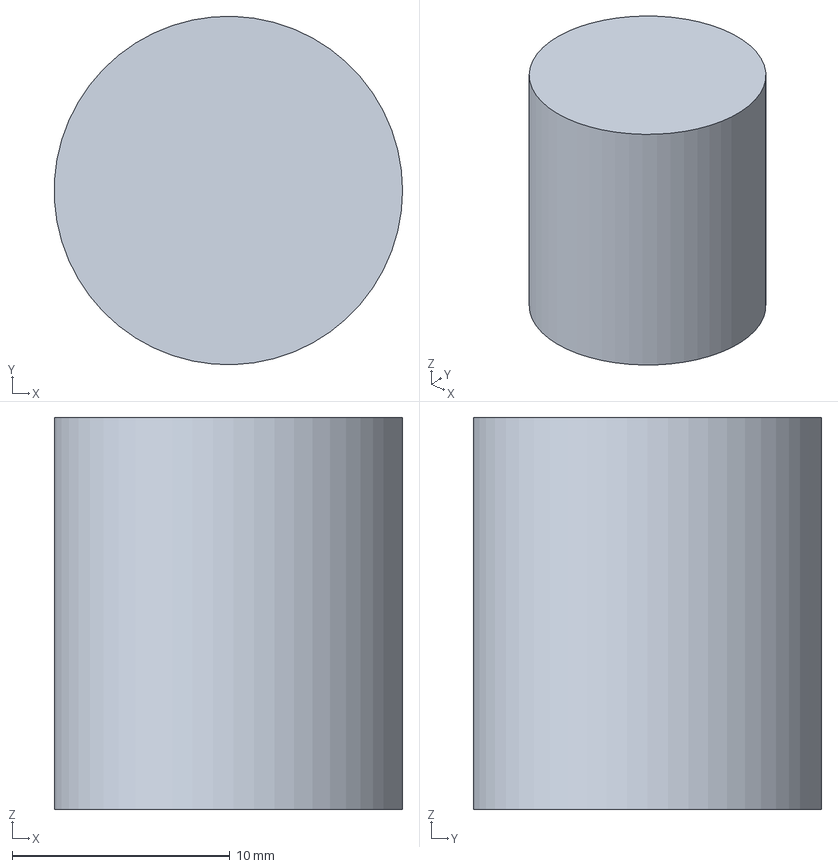
[picture p189: CAD file, 2026-10-26]
e7_frost_heave_load/3d/parts_V03_variant_A_frame/levelling_foot_1.step
16.0 x 16.0 x 18.0 mm
