martinasobotkova5/my_data_projects/(list of files, cad)

Other CAD files:
e7_frost_heave_load/3d/parts_V01_variant_C/L05_piston_bottom.step
e7_frost_heave_load/3d/parts_V01_variant_C/L06_steel_disc_4_1_kg.step
e7_frost_heave_load/vyroba/laser/E7-L03_carrier_10mm.step
e7_frost_heave_load/sdileni/vyroba/laser/E7-L04_piston_top_10mm.step
e7_frost_heave_load/vyroba/laser/E7-L06_disc_1kg_12mm.step
e7_frost_heave_load/3d/parts_V03_variant_A_frame/cell_body_PETG_D160__Column_one_body_version_1.step
e7_frost_heave_load/sdileni/vyroba/laser/E7-L07_disc_0.5kg_6mm.step
e7_frost_heave_load/sdileni/vyroba/tisk/E7-P04_post_foot.step
e7_frost_heave_load/3d/E7_V08_freezer_layout.step
e7_frost_heave_load/3d/parts_V01_variant_C/M_TDR_CS645_rod_2.step
e7_frost_heave_load/sdileni/vyroba/tisk/E7-P02_lvdt_arm.step
e7_frost_heave_load/sdileni/vyroba/tisk/E7-P10_screed.step
e7_frost_heave_load/3d/parts_V01_variant_C/P04_post_foot__print.step
e7_frost_heave_load/3d/parts_V03_variant_A_frame/M_TDR_CS645_rod_1.step
e7_frost_heave_load/sdileni/vyroba/tisk/E7-P01_bearing_housing.step
e7_frost_heave_load/vyroba/tisk/E7-P11_parking_fork.stl
e7_frost_heave_load/vyroba/tisk/E7-P03_target_arm.step
e7_frost_heave_load/3d/parts_V01_variant_C/L06_steel_disc_3_1_kg.step
e7_frost_heave_load/3d/parts_V03_variant_A_frame/M_TDR_CS645_rod_3.step
e7_frost_heave_load/vyroba/tisk/E7-P08_camera_hanger.step
e7_frost_heave_load/3d/parts_V01_variant_C/L03_carrier_Al_D140x10.step
e7_frost_heave_load/3d/parts_V03_variant_A_frame/column_40x80_R.step
e7_frost_heave_load/3d/parts_V06_variant_B_open/M_Pt100_metal_part.step
e7_frost_heave_load/3d/parts_V01_variant_C/angle_bracket_40_base_R-1.step
e7_frost_heave_load/3d/parts_V03_variant_A_frame/M_TDR_CS645_head.step
e7_frost_heave_load/3d/parts_V06_variant_B_open/M_TDR_CS645_rod_1.step
e7_frost_heave_load/3d/E7_variant_B.step
e7_frost_heave_load/3d/parts_V03_variant_A_frame/M_TDR_CS645_rod_2.step
e7_frost_heave_load/3d/parts_V01_variant_C/levelling_foot_M8_R-1.step
e7_frost_heave_load/3d/parts_V03_variant_A_frame/PV1_cable.step
e7_frost_heave_load/3d/parts_V09_variant_C_combined/PV1_TML_PDA-PA_on_D20_disc.step
e7_frost_heave_load/3d/E7_variant_A_min.step
e7_frost_heave_load/3d/parts_V01_variant_C/G10_pad_D20x40_1.step
e7_frost_heave_load/3d/parts_V01_variant_C/G10_pad_D20x40_3.step
e7_frost_heave_load/3d/parts_V03_variant_A_frame/M_optical_fibre.step
e7_frost_heave_load/3d/parts_V06_variant_B_open/M_TDR_CS645_rod_2.step
e7_frost_heave_load/3d/parts_V01_variant_C/angle_bracket_40_base_L-1.step
e7_frost_heave_load/3d/parts_V03_variant_A_frame/PB1_TML_PDA-PA__flush.step
e7_frost_heave_load/3d/parts_V01_variant_C/P03_target_arm__print.step
e7_frost_heave_load/3d/E7_V01_variant_C.stl
e7_frost_heave_load/3d/E7_V02_variant_A_tie_rods.stl
e7_frost_heave_load/3d/E7_V03_cell.step
e7_frost_heave_load/3d/E7_V03_cell.stl
e7_frost_heave_load/3d/E7_V04_cell.stl
e7_frost_heave_load/3d/E7_V05_freezer_layout.step
e7_frost_heave_load/3d/E7_V05_freezer_layout.stl
e7_frost_heave_load/3d/E7_V06_variant_B_open.stl
e7_frost_heave_load/3d/E7_V08_freezer_layout.stl
e7_frost_heave_load/3d/E7_V09_variant_C_combined.stl
e7_frost_heave_load/3d/E7_cell.step
e7_frost_heave_load/3d/E7_cell.stl
e7_frost_heave_load/3d/E7_freezer_layout.step
e7_frost_heave_load/3d/E7_freezer_layout.stl
e7_frost_heave_load/3d/E7_multiring_cell.stl
e7_frost_heave_load/3d/E7_variant_A.stl
e7_frost_heave_load/3d/E7_variant_A2_spring.stl
e7_frost_heave_load/3d/E7_variant_A_frame.step
e7_frost_heave_load/3d/E7_variant_A_frame.stl
e7_frost_heave_load/3d/E7_variant_A_min.stl
e7_frost_heave_load/3d/E7_variant_A_multiring.stl
e7_frost_heave_load/3d/E7_variant_B.stl
e7_frost_heave_load/3d/archiv/A_frame.step
e7_frost_heave_load/3d/archiv/A_tie_rods.step
e7_frost_heave_load/3d/archiv/B_anchors.step
e7_frost_heave_load/3d/archiv/B_open.step
e7_frost_heave_load/3d/parts_V01_variant_C/160_x130.step
e7_frost_heave_load/3d/parts_V01_variant_C/16in.step
e7_frost_heave_load/3d/parts_V01_variant_C/Al_base_plate_260x200x25.step
e7_frost_heave_load/3d/parts_V01_variant_C/Al_base_plate_340x260x25.step
e7_frost_heave_load/3d/parts_V01_variant_C/Invar_36_post_D16_x357.step
e7_frost_heave_load/3d/parts_V01_variant_C/Invar_36_post_D16_x406.step
e7_frost_heave_load/3d/parts_V01_variant_C/Invar_arm_to_the_LVDT.step
e7_frost_heave_load/3d/parts_V01_variant_C/Invar_arm_with_camera_target.step
e7_frost_heave_load/3d/parts_V01_variant_C/L01_base_plate_Al_340x260x10__laser.step
e7_frost_heave_load/3d/parts_V01_variant_C/L02_top_plate_Al_340x80x10__laser.step
e7_frost_heave_load/3d/parts_V01_variant_C/L03_carrier_Al_D120x10.step
e7_frost_heave_load/3d/parts_V01_variant_C/L04_piston_top__ball_seat.step
e7_frost_heave_load/3d/parts_V01_variant_C/L06_steel_disc_1_1_kg.step
e7_frost_heave_load/3d/parts_V01_variant_C/L06_steel_disc_2_1_kg.step
e7_frost_heave_load/3d/parts_V01_variant_C/LVDT_RDP_DCTH400AG.step
e7_frost_heave_load/3d/parts_V01_variant_C/LVDT_plunger.step
e7_frost_heave_load/3d/parts_V01_variant_C/M_Pt100_cable.step
e7_frost_heave_load/3d/parts_V01_variant_C/M_Pt100_metal_part.step
e7_frost_heave_load/3d/parts_V01_variant_C/M_TDR_CS645_head.step
e7_frost_heave_load/3d/parts_V01_variant_C/M_TDR_CS645_rod_1.step
e7_frost_heave_load/3d/parts_V01_variant_C/M_TDR_CS645_rod_3.step
e7_frost_heave_load/3d/parts_V01_variant_C/P01_bearing_housing__print.step
e7_frost_heave_load/3d/parts_V01_variant_C/P01_bearing_housing__print__hangs.step
e7_frost_heave_load/3d/parts_V01_variant_C/P02_LVDT_arm__print.step
e7_frost_heave_load/3d/parts_V01_variant_C/P05_laser_holder__print.step
e7_frost_heave_load/3d/parts_V01_variant_C/P06_camera_box__RPi_HQ___6_mm_lens___RPi_5.step
e7_frost_heave_load/3d/parts_V01_variant_C/P08_camera_hanger__print.step
e7_frost_heave_load/3d/parts_V01_variant_C/P08_camera_mount__print.step
e7_frost_heave_load/3d/parts_V01_variant_C/T01_column_40x80_slot_8_x306_L.step
e7_frost_heave_load/3d/parts_V01_variant_C/T02_base_rail_40x40_x260_L.step
e7_frost_heave_load/3d/parts_V01_variant_C/T02_base_rail_40x40_x260_R.step
e7_frost_heave_load/3d/parts_V01_variant_C/T02_base_rail_40x40_x320_L.step
e7_frost_heave_load/3d/parts_V01_variant_C/T02_base_rail_40x40_x320_R.step
e7_frost_heave_load/3d/parts_V01_variant_C/T03_base_cross_bar_40x80_x260.step
e7_frost_heave_load/3d/parts_V01_variant_C/T04_top_beam_40x80_x340__hole_D14.step
e7_frost_heave_load/3d/parts_V01_variant_C/XPS_slab_D240x40_under_the_cell.step
e7_frost_heave_load/3d/parts_V01_variant_C/angle_bracket_40_base_L_1.step
e7_frost_heave_load/3d/parts_V01_variant_C/angle_bracket_40_base_R_1.step
e7_frost_heave_load/3d/parts_V01_variant_C/angle_bracket_40_slot_8_Lb-1.step
e7_frost_heave_load/3d/parts_V01_variant_C/angle_bracket_40_slot_8_Lb_1.step
e7_frost_heave_load/3d/parts_V01_variant_C/angle_bracket_40_slot_8_Lt_20.step
e7_frost_heave_load/3d/parts_V01_variant_C/angle_bracket_40_slot_8_Rb-1.step
e7_frost_heave_load/3d/parts_V01_variant_C/angle_bracket_40_slot_8_Rb_1.step
e7_frost_heave_load/3d/parts_V01_variant_C/angle_bracket_40_slot_8_Rt-20.step
e7_frost_heave_load/3d/parts_V01_variant_C/angle_bracket_40_slot_8_Rt_20.step
e7_frost_heave_load/3d/parts_V01_variant_C/camera_box__RPi_HQ___6_mm_lens___RPi_5.step
e7_frost_heave_load/3d/parts_V01_variant_C/camera_bracket.step
e7_frost_heave_load/3d/parts_V01_variant_C/camera_target_10x10.step
e7_frost_heave_load/3d/parts_V01_variant_C/carrier_plate_Al_D120x8.step
e7_frost_heave_load/3d/parts_V01_variant_C/cell_PETG_D240x200_one_piece__rev._B__core_Column_one_body_version_1.step
e7_frost_heave_load/3d/parts_V01_variant_C/cell_body_PETG_D160__Column_one_body_version_1.step
e7_frost_heave_load/3d/parts_V01_variant_C/column_40x80_slot_8_x326_L.step
e7_frost_heave_load/3d/parts_V01_variant_C/column_40x80_slot_8_x326_R.step
e7_frost_heave_load/3d/parts_V01_variant_C/column_40x80_x326_L.step
e7_frost_heave_load/3d/parts_V01_variant_C/column_40x80_x326_R.step
e7_frost_heave_load/3d/parts_V01_variant_C/cross-beam_80x80.step
e7_frost_heave_load/3d/parts_V01_variant_C/cross-beam_80x80_x340.step
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
