martinasobotkova5/my_data_projects/e6_frozen_infiltration/vykresy/E6-V12_bench_setup.png

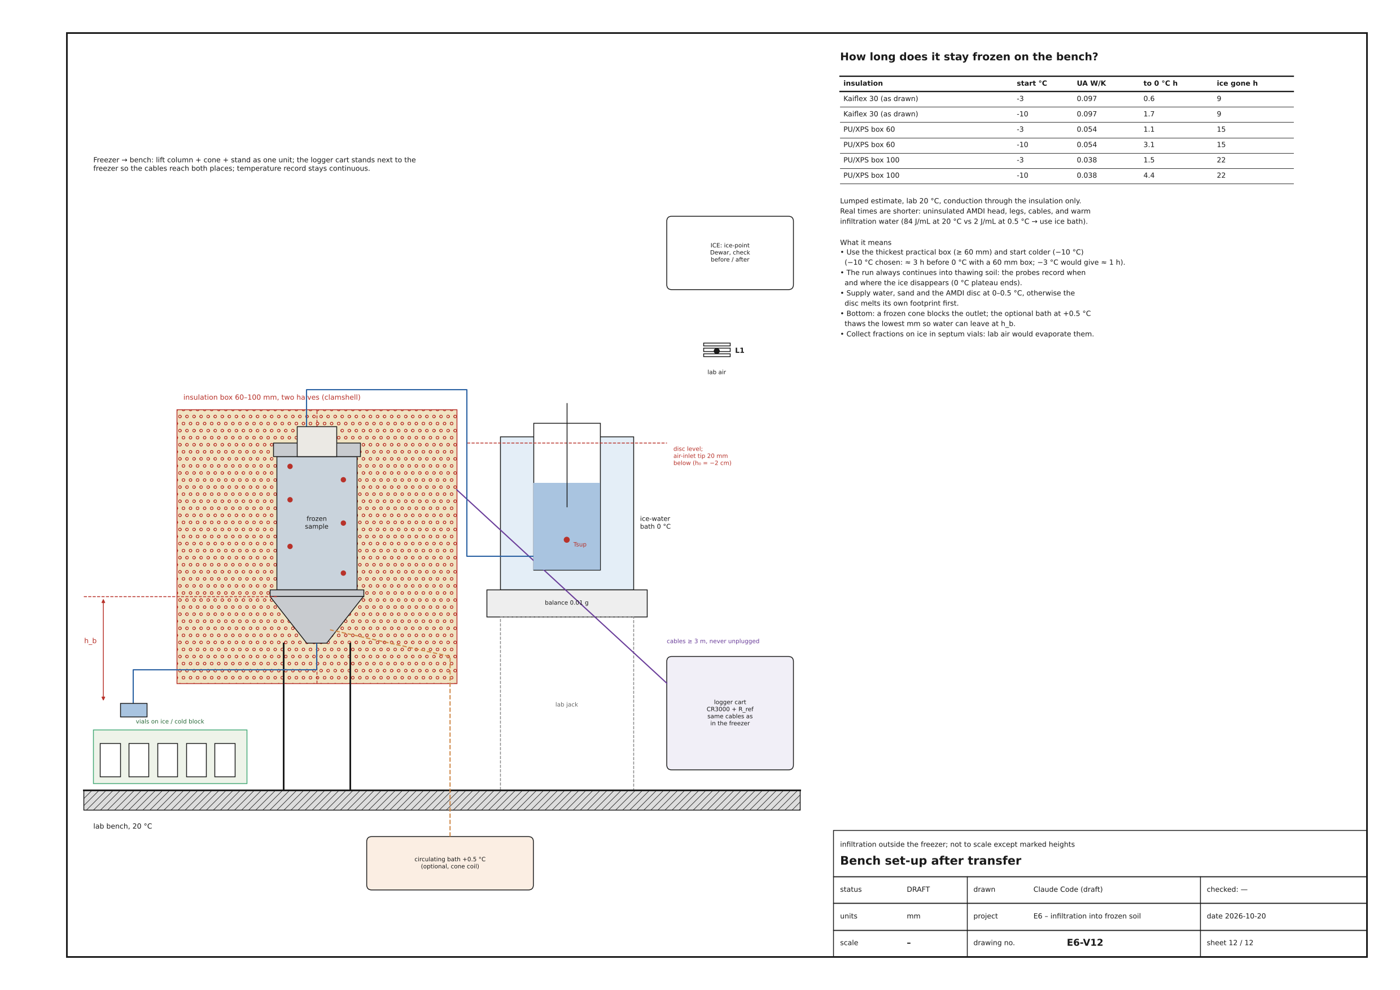
e6_frozen_infiltration/vykresy/E6-V12_bench_setup.png
