martinasobotkova5/my_data_projects/e6_frozen_infiltration/vykresy/E6_drawings.pdf

## Parts list

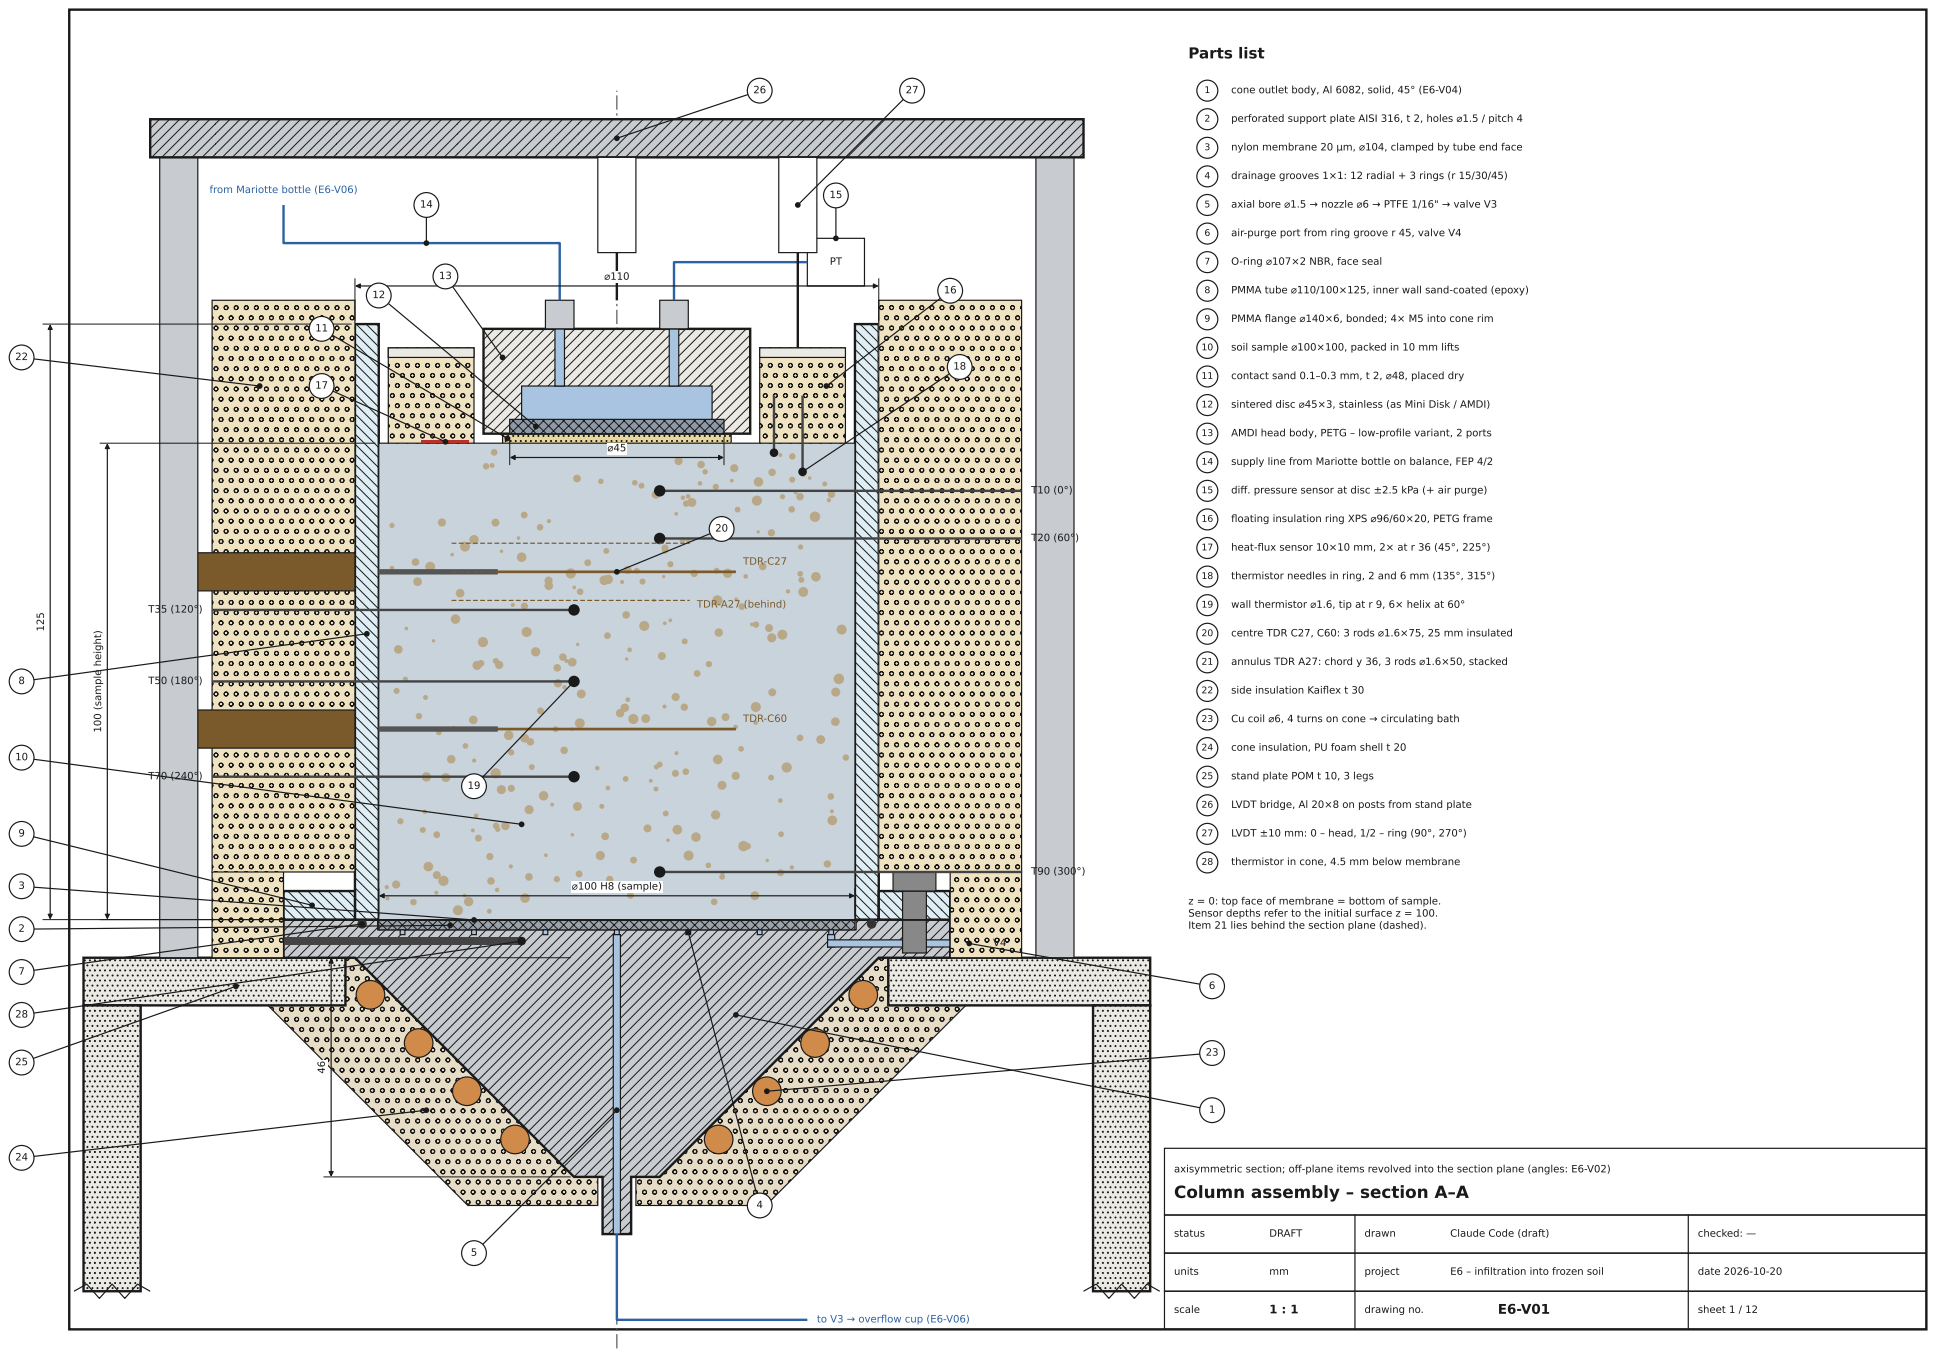
[picture p194: page 1]
scale; drawing no.; sheet 1 / 12; units; project; E6 – infiltration into frozen soil; date 2026-10-20; status; DRAFT; drawn; Claude Code (draft); checked: —; cone outlet body, Al 6082, solid, 45° (E6-V04); perforated support plate AISI 316, t 2, holes ⌀1.5 / pitch 4; nylon membrane 20 µm, ⌀104, clamped by tube end face; drainage grooves 1×1: 12 radial + 3 rings (r 15/30/45); axial bore ⌀1.5 → nozzle ⌀6 → PTFE 1/16" → valve V3; air-purge port from ring groove r 45, valve V4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

from Mariotte bottle (E6-V06)

z = 0: top face of membrane = bottom of sample.
Sensor depths refer to the initial surface z = 100.
Item 21 lies behind the section plane (dashed).

axisymmetric section; off-plane items revolved into the section plane (angles: E6-V02)
Column assembly – section A–A

to V3 → overflow cup (E6-V06)

## Sensor schedule

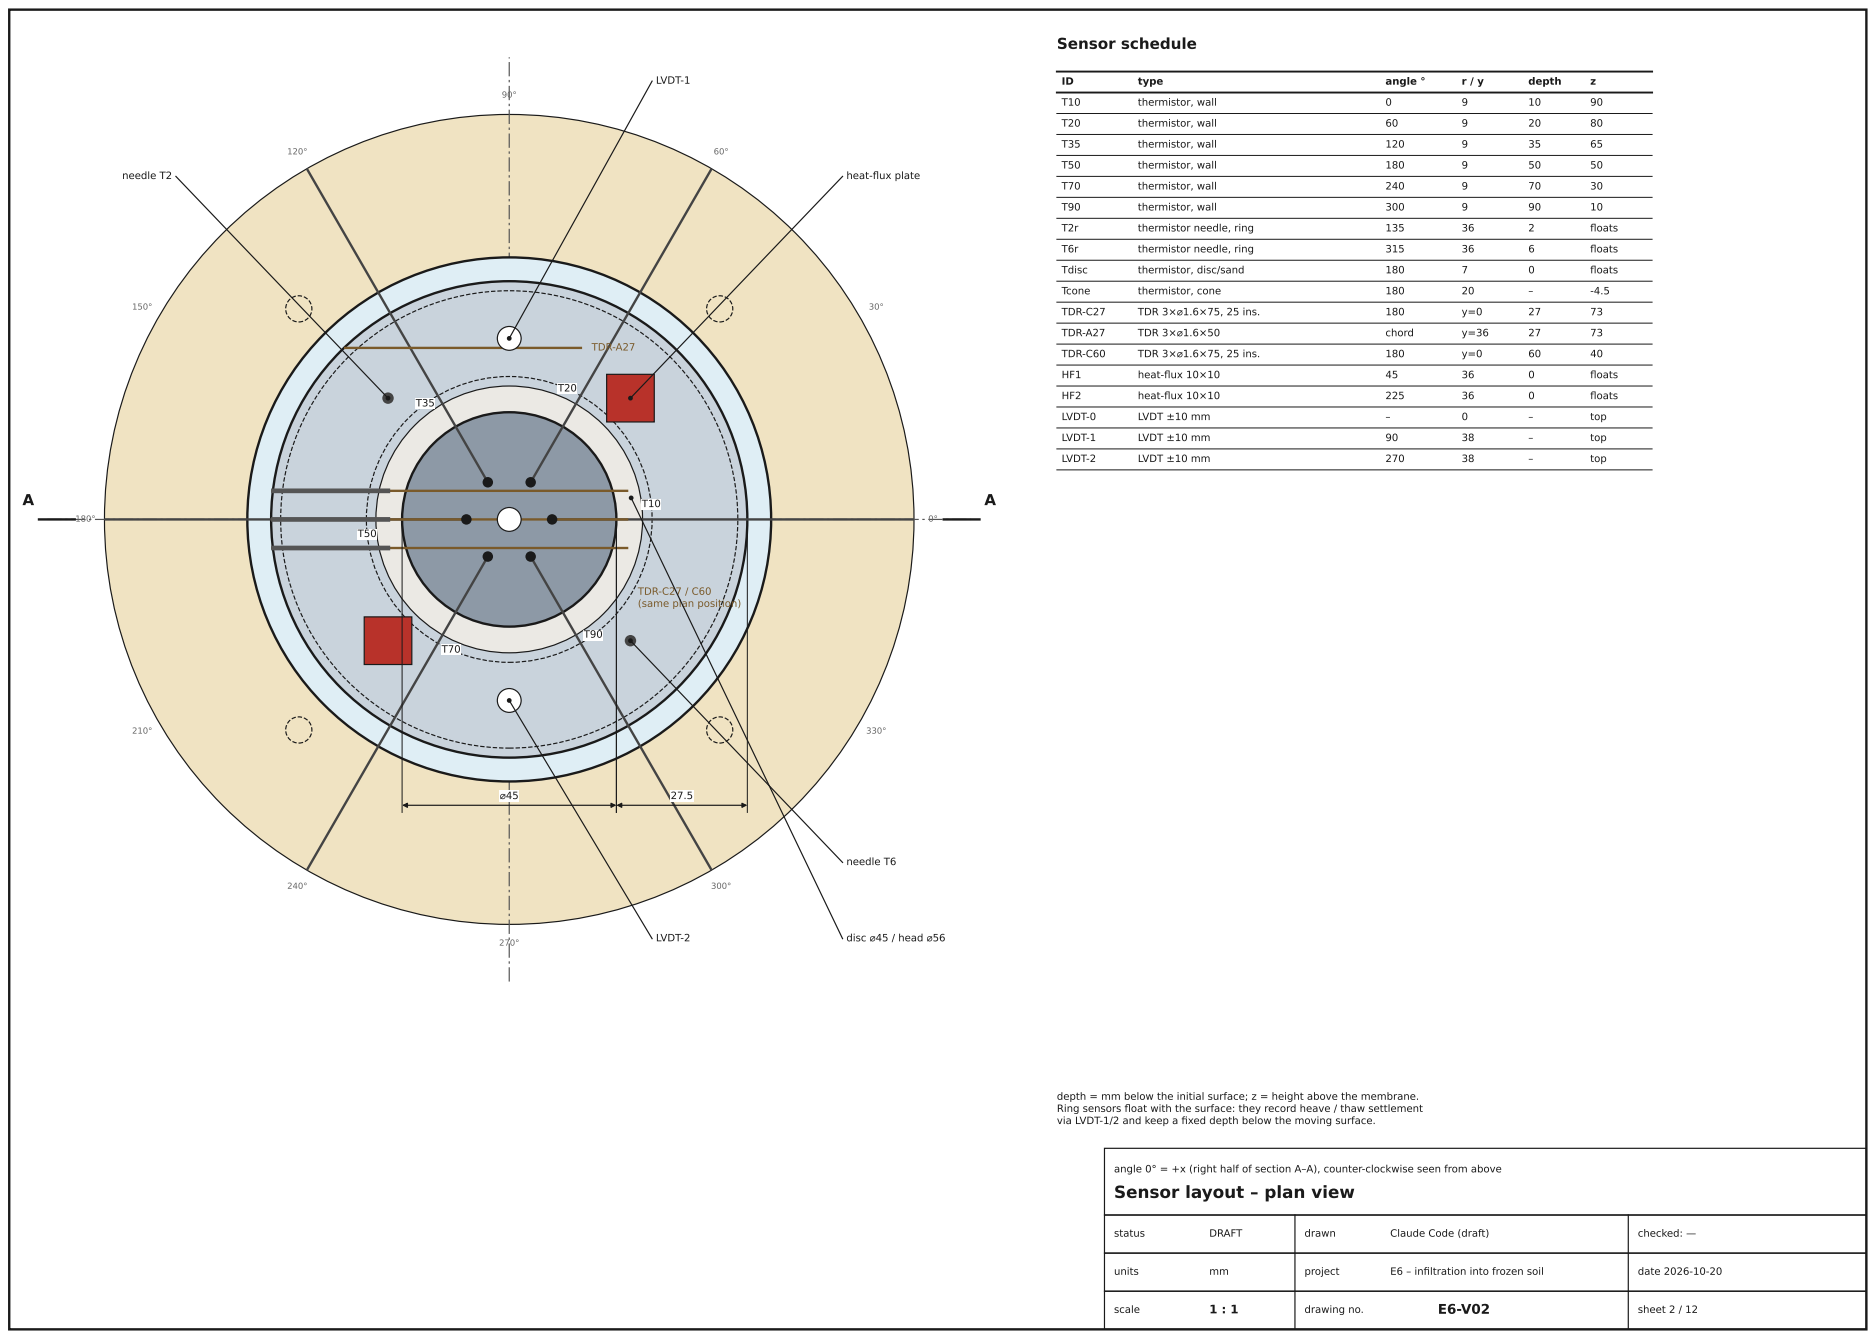
[picture p195: page 2]
scale; drawing no.; sheet 2 / 12; status; DRAFT; drawn; Claude Code (draft); checked: —; type; angle °; depth; thermistor, wall; thermistor needle, ring; floats; Tdisc; thermistor, disc/sand; Tcone; thermistor, cone; TDR-C27; TDR 3×⌀1.6×75, 25 ins.; TDR-A27; TDR 3×⌀1.6×50; chord; TDR-C60; heat-flux 10×10; LVDT-0; LVDT ±10 mm; top; LVDT-1; LVDT-2; needle T2; heat-flux plate; needle T6; disc ⌀45 / head ⌀56

TDR-C27 / C60
(same plan position)

depth = mm below the initial surface; z = height above the membrane.
Ring sensors float with the surface: they record heave / thaw settlement
via LVDT-1/2 and keep a fixed depth below the moving surface.

angle 0° = +x (right half of section A–A), counter-clockwise seen from above
Sensor layout – plan view

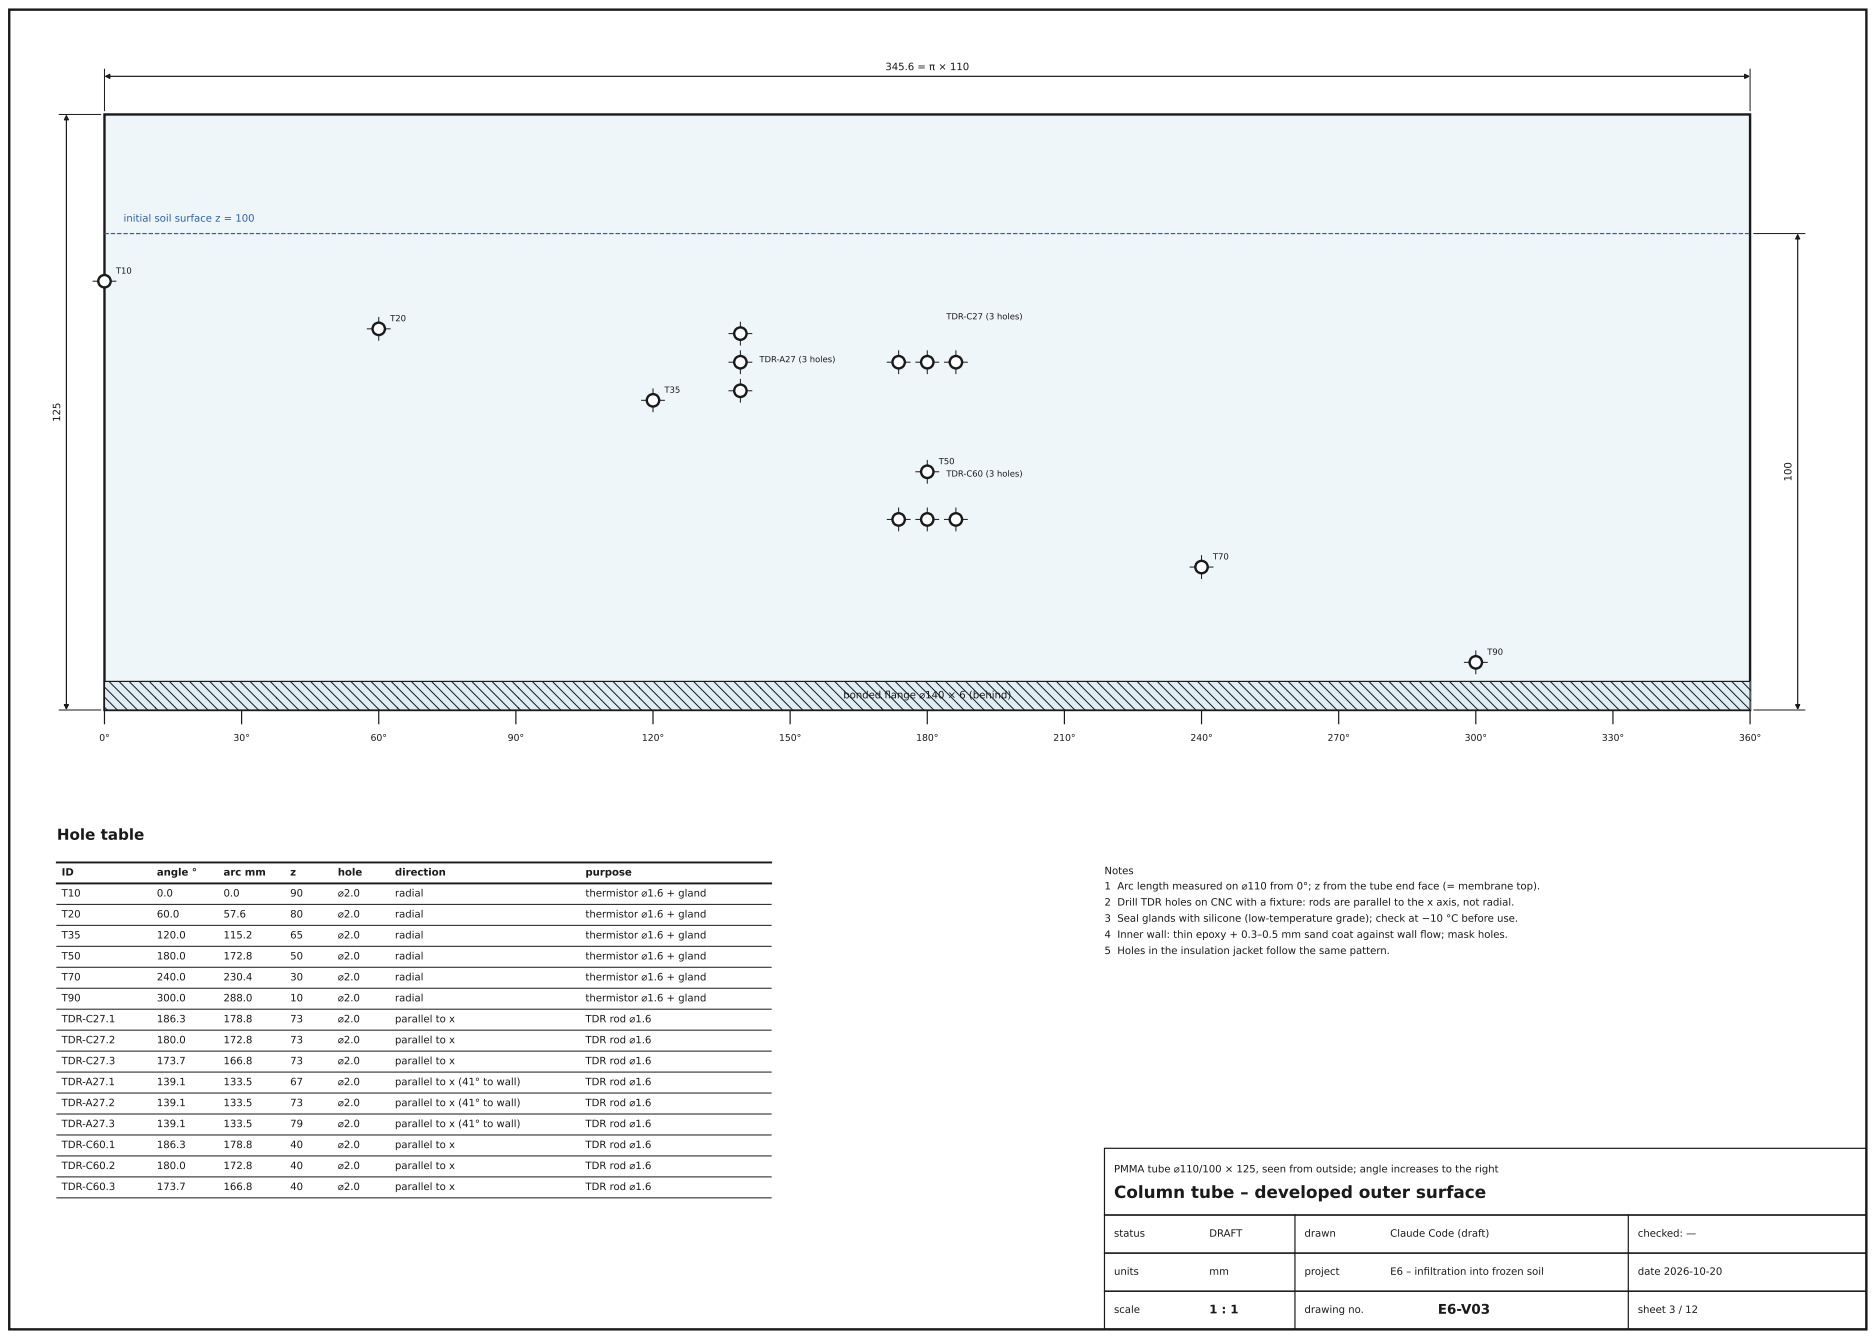
[picture p196: page 3]
scale; drawing no.; sheet 3 / 12; status; DRAFT; drawn; Claude Code (draft); checked: —; Hole table; angle °; arc mm; hole; direction; purpose; radial; thermistor ⌀1.6 + gland; TDR-C27.1; parallel to x; TDR rod ⌀1.6; TDR-C27.2; TDR-C27.3; TDR-A27.1; parallel to x (41° to wall); TDR-A27.2; TDR-A27.3; TDR-C60.1; TDR-C60.2; TDR-C60.3; TDR-C27 (3 holes); TDR-A27 (3 holes); TDR-C60 (3 holes)

initial soil surface z = 100

bonded flange ⌀140 × 6 (behind)

Notes
1 Arc length measured on ⌀110 from 0°; z from the tube end face (= membrane top).
2 Drill TDR holes on CNC with a fixture: rods are parallel to the x axis, not radial.
3 Seal glands with silicone (low-temperature grade); check at −10 °C before use.
4 Inner wall: thin epoxy + 0.3–0.5 mm sand coat against wall flow; mask holes.

5 Holes in the insulation jacket follow the same pattern.

PMMA tube ⌀110/100 × 125, seen from outside; angle increases to the right
Column tube – developed outer surface

SECTION B–B 1 : 1 | VIEW C – top face (membrane removed) 1 : 2

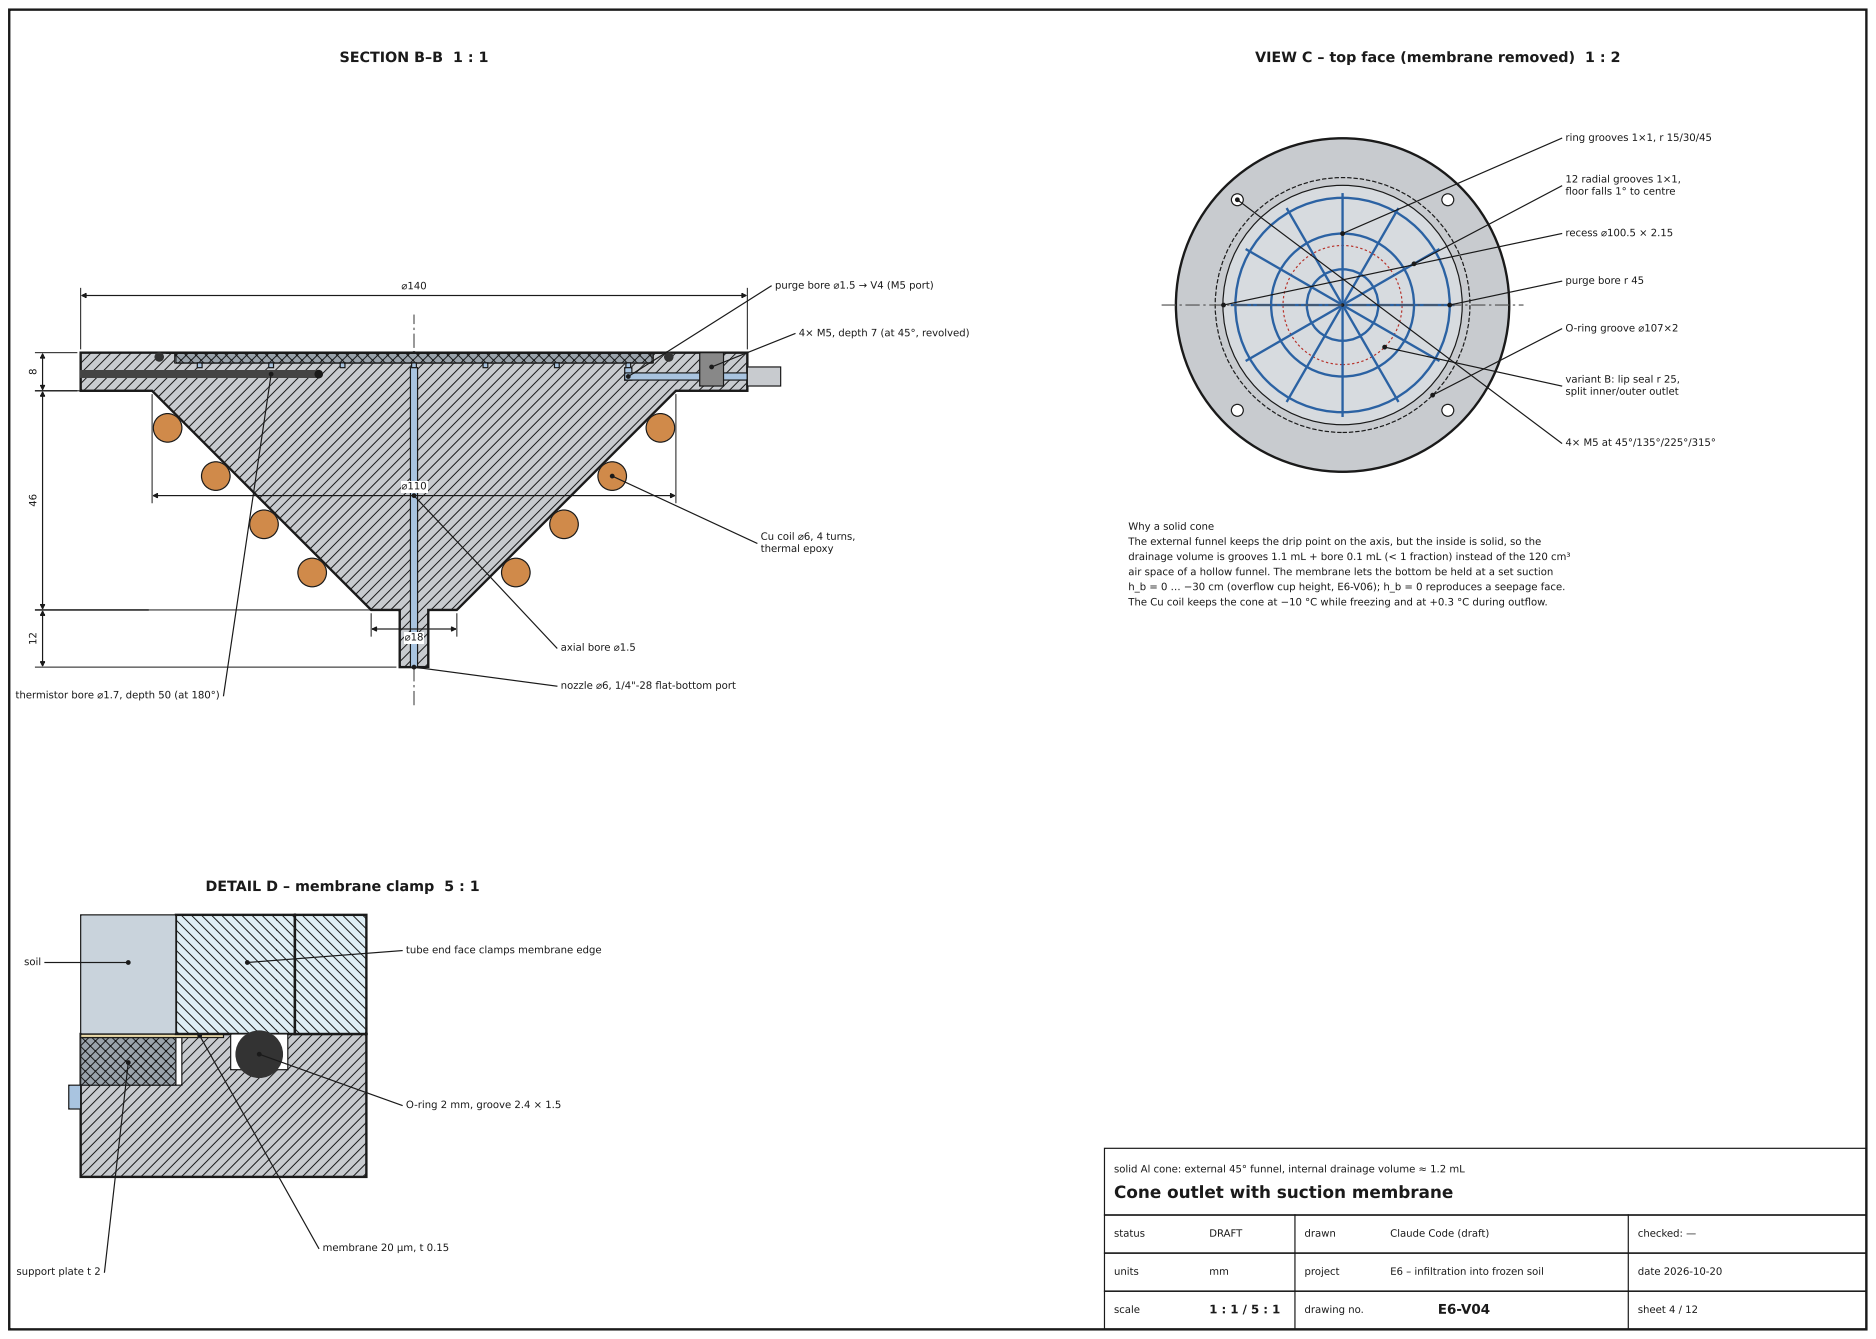
[picture p197: page 4]
scale; drawing no.; sheet 4 / 12; status; DRAFT; drawn; Claude Code (draft); checked: —; axial bore ⌀1.5; ring grooves 1×1, r 15/30/45; recess ⌀100.5 × 2.15; purge bore r 45; O-ring groove ⌀107×2; support plate t 2; membrane 20 µm, t 0.15; soil

12 radial grooves 1×1,
floor falls 1° to centre

purge bore ⌀1.5 → V4 (M5 port)

4× M5, depth 7 (at 45°, revolved)

variant B: lip seal r 25,
split inner/outer outlet

Cu coil ⌀6, 4 turns,
thermal epoxy

Why a solid cone
The external funnel keeps the drip point on the axis, but the inside is solid, so the
drainage volume is grooves 1.1 mL + bore 0.1 mL (< 1 fraction) instead of the 120 cm³
air space of a hollow funnel. The membrane lets the bottom be held at a set suction
h_b = 0 … −30 cm (overflow cup height, E6-V06); h_b = 0 reproduces a seepage face.
The Cu coil keeps the cone at −10 °C while freezing and at +0.3 °C during outflow.

nozzle ⌀6, 1/4"-28 flat-bottom port

thermistor bore ⌀1.7, depth 50 (at 180°)

DETAIL D – membrane clamp 5 : 1

tube end face clamps membrane edge

O-ring 2 mm, groove 2.4 × 1.5

solid Al cone: external 45° funnel, internal drainage volume ≈ 1.2 mL
Cone outlet with suction membrane

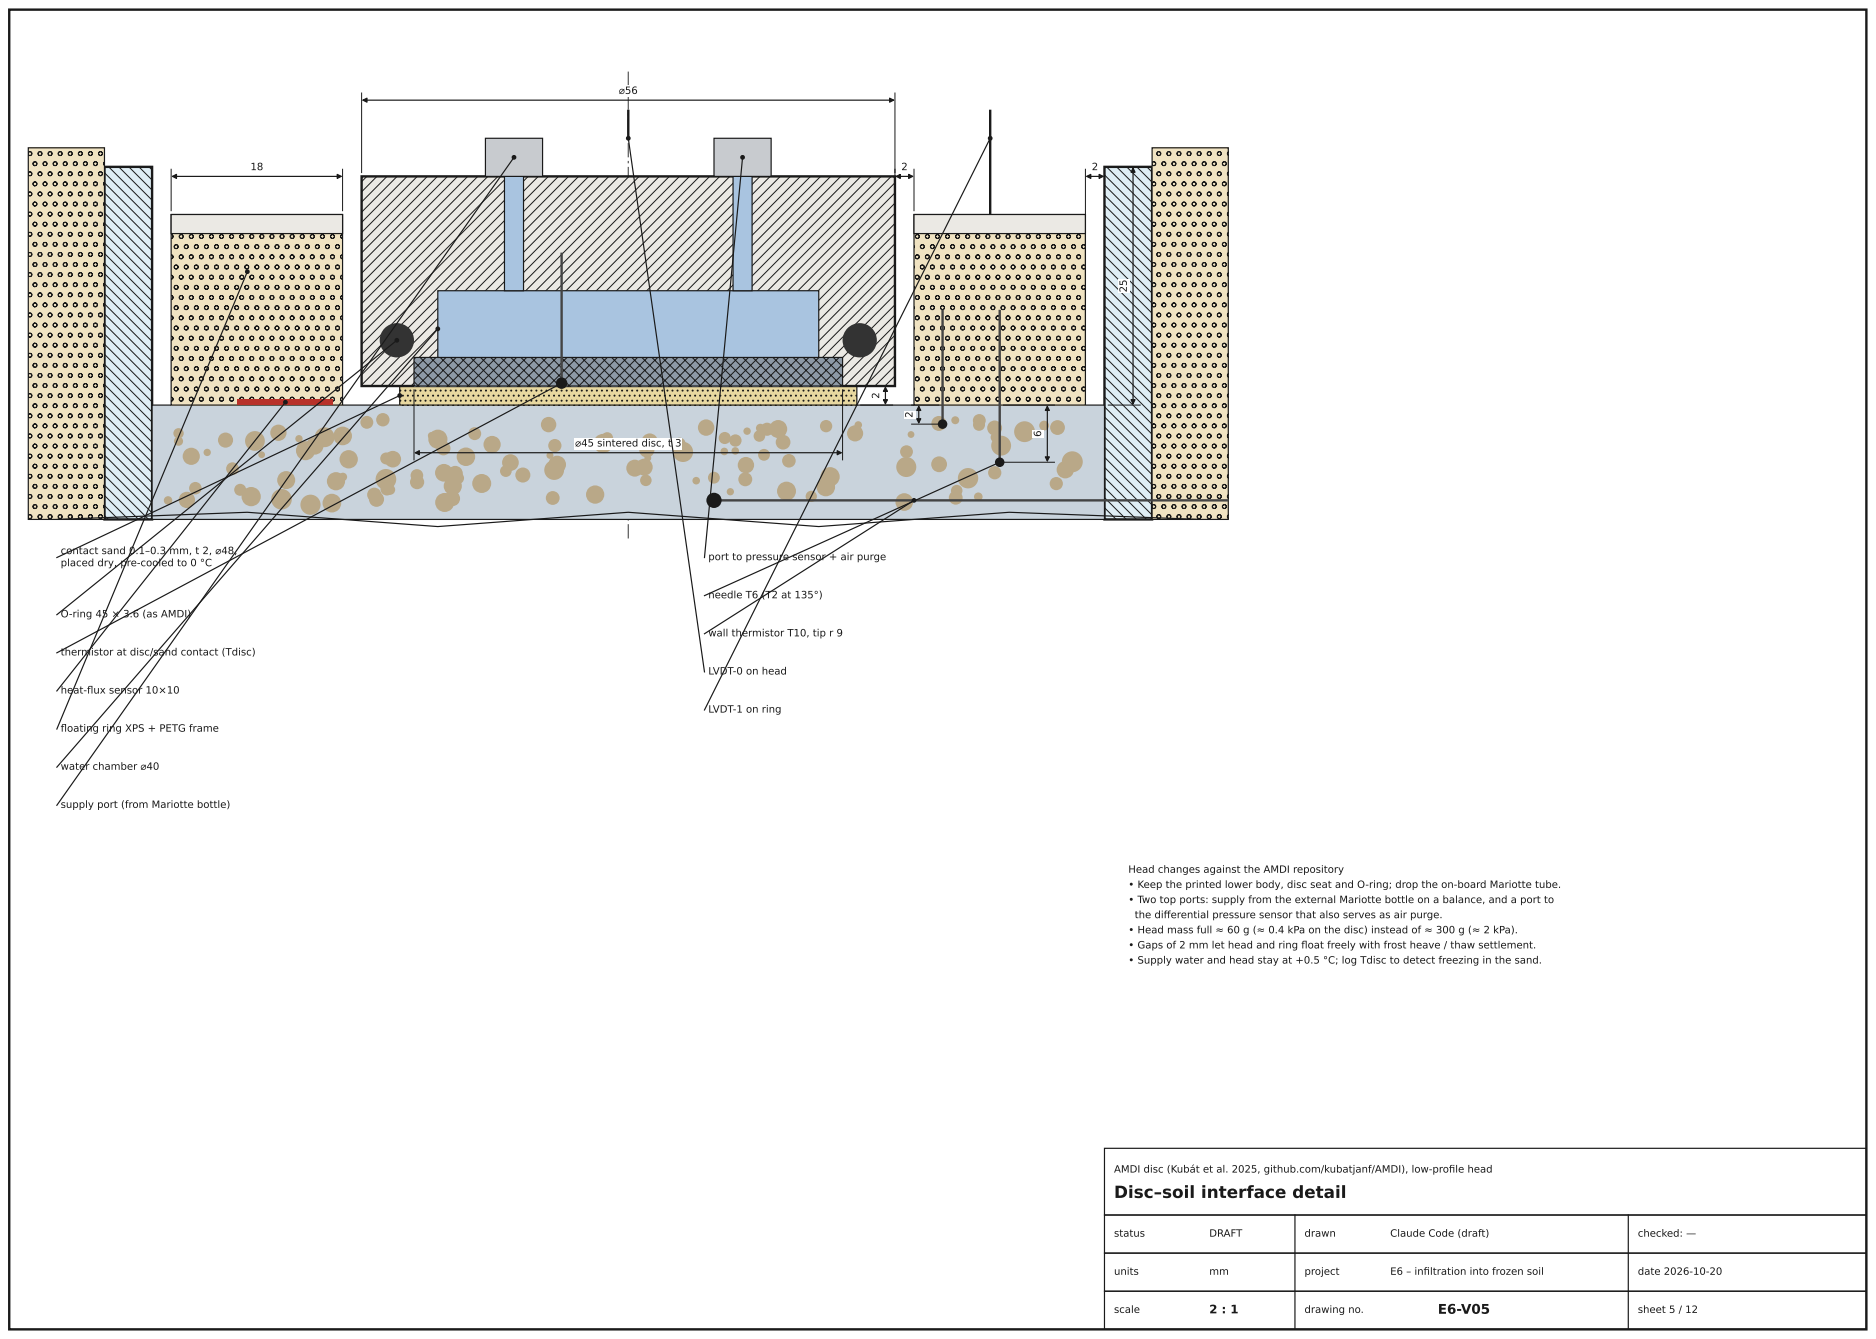
[picture p198: page 5]
scale; drawing no.; sheet 5 / 12; status; DRAFT; drawn; Claude Code (draft); checked: —; ⌀45 sintered disc, t 3; water chamber ⌀40; needle T6 (T2 at 135°)

contact sand 0.1–0.3 mm, t 2, ⌀48,
placed dry, pre-cooled to 0 °C

port to pressure sensor + air purge

O-ring 45 × 3.6 (as AMDI)

wall thermistor T10, tip r 9

thermistor at disc/sand contact (Tdisc)

LVDT-0 on head

heat-flux sensor 10×10

LVDT-1 on ring

floating ring XPS + PETG frame

supply port (from Mariotte bottle)

Head changes against the AMDI repository
• Keep the printed lower body, disc seat and O-ring; drop the on-board Mariotte tube.
• Two top ports: supply from the external Mariotte bottle on a balance, and a port to
the differential pressure sensor that also serves as air purge.
• Head mass full ≈ 60 g (≈ 0.4 kPa on the disc) instead of ≈ 300 g (≈ 2 kPa).
• Gaps of 2 mm let head and ring float freely with frost heave / thaw settlement.
• Supply water and head stay at +0.5 °C; log Tdisc to detect freezing in the sand.

AMDI disc (Kubát et al. 2025, github.com/kubatjanf/AMDI), low-profile head
Disc–soil interface detail

## Valves and boundary conditions

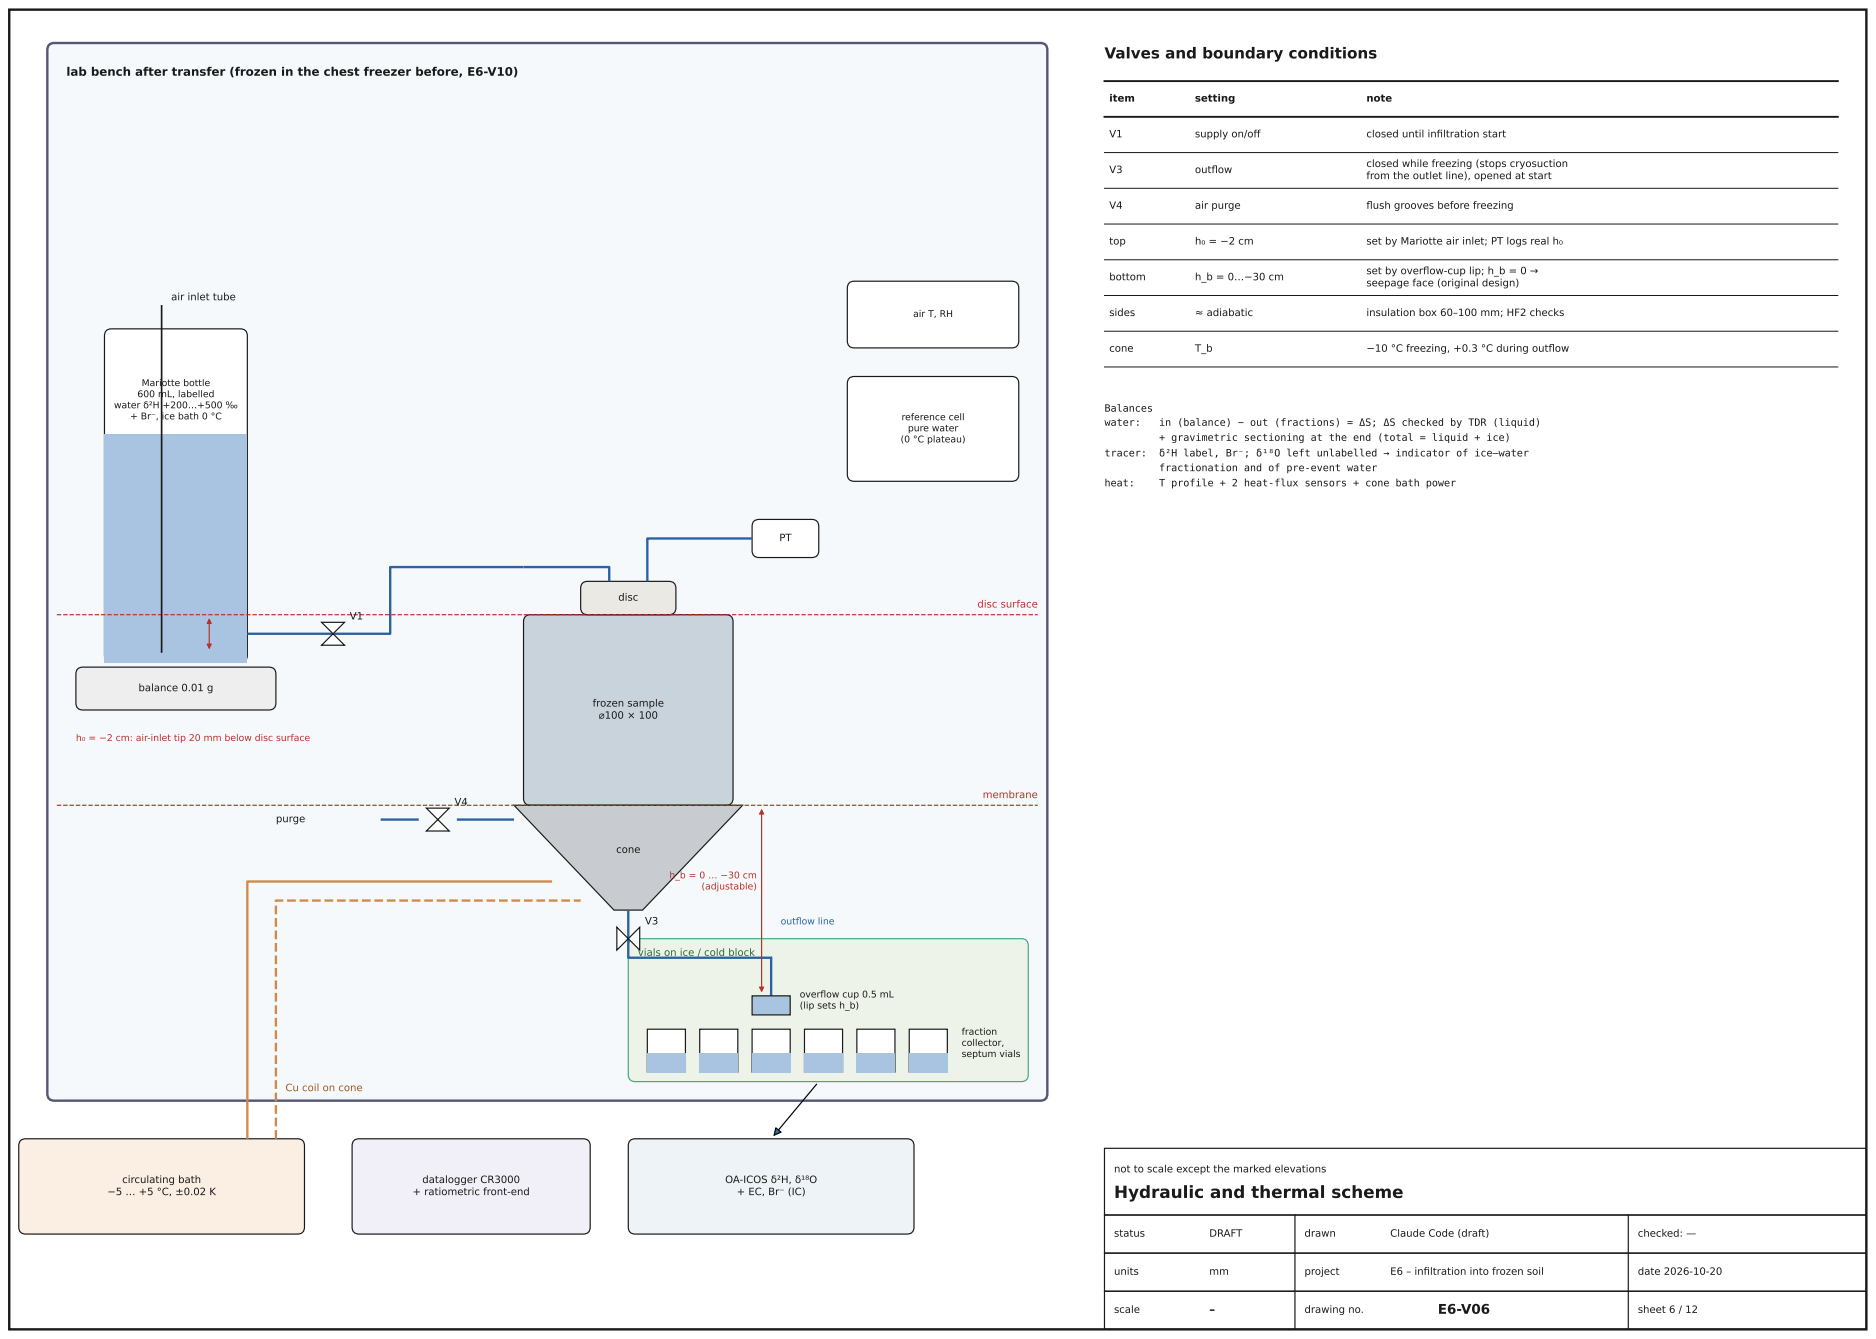
[picture p199: page 6]
scale; drawing no.; sheet 6 / 12; status; DRAFT; drawn; Claude Code (draft); checked: —; balance 0.01 g; disc; disc surface; membrane; outflow line; purge; fraction collector, septum vials; (adjustable); circulating bath −5 … +5 °C, ±0.02 K; reference cell pure water (0 °C plateau); air T, RH; item; setting; note; supply on/off; closed until infiltration start; outflow; air purge; flush grooves before freezing; top; set by Mariotte air inlet; PT logs real h₀; bottom; set by overflow-cup lip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

lab bench after transfer (frozen in the chest freezer before, E6-V10)

closed while freezing (stops cryosuction
from the outlet line), opened at start

seepage face (original design)

air inlet tube

+ gravimetric sectioning at the end (total = liquid + ice)

tracer: δ²H label, Br⁻; δ¹⁸O left unlabelled → indicator of ice–water

fractionation and of pre-event water

h₀ = −2 cm: air-inlet tip 20 mm below disc surface

vials on ice / cold block

overflow cup 0.5 mL
(lip sets h_b)

Cu coil on cone

not to scale except the marked elevations
Hydraulic and thermal scheme

datalogger CR3000
+ ratiometric front-end

OA-ICOS δ²H, δ¹⁸O

scale | – | drawing no. | E6-V07 | sheet 7 / 12
status | DRAFT | drawn | Claude Code (draft) | checked: —

# Run protocol – freeze in freezer, infiltrate on bench

times indicative; bench phase from a lumped heat balance (E6-V12, vypocty.md §8)

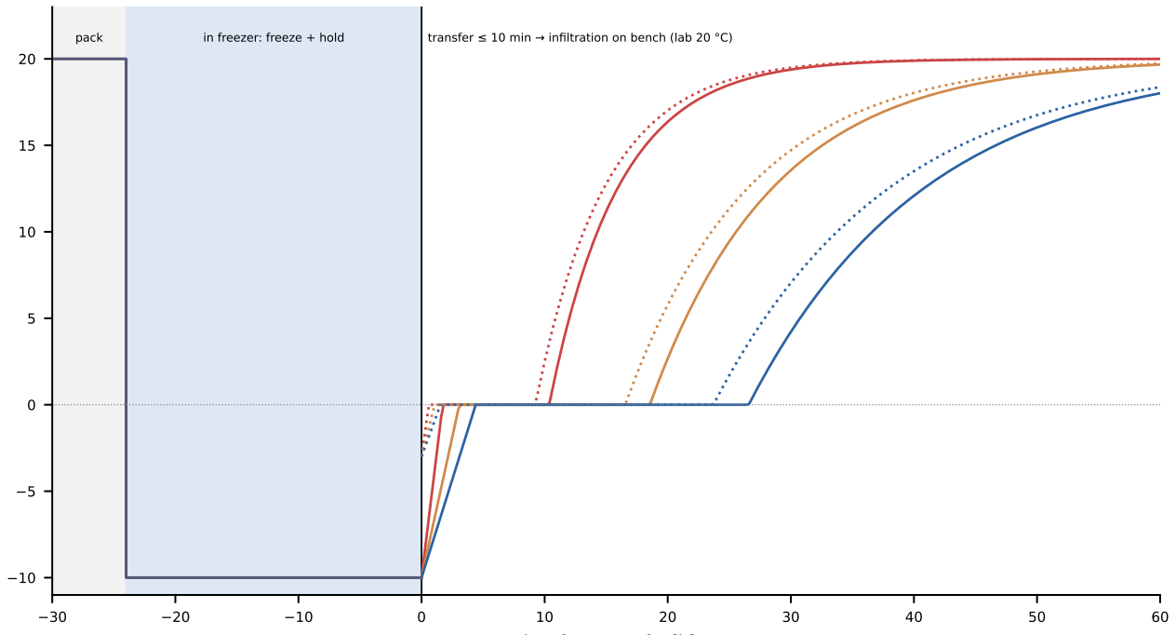
[picture p200: figure]

The 0 °C plateau is the time with ice in the pores. Breakthrough of the label takes 44–111 h, so every run covers infiltration into frozen soil, its thawing, and flow through thawed soil.

step | where | action | go / no-go
1 | lab | pack Ø100×100 in 10 mm lifts to θ ≈ 0.30 with background water;
mount holder on cone, all probes in, V3 closed, flush V4 | probes read, TDR ok
2 | freezer | freezer −10 °C, sides + cone insulated → freezing from the top
through the Al plate; logger running through the collar | front passes T90
3 | freezer | hold at −10 °C ≥ 24 h (controller: constant −10 °C,
not the ±10 °C cycle program) | all T within ±0.05 K
4 | prep

ice-water bath for Mariotte bottle and contact sand; collector rack
on ice; insulation box open on the bench next to the freezer | Tsup ≤ 0.5 °C
5 | transfer | lift column + cone + stand as one unit, cables stay connected;
close box; write transfer start / end time | ≤ 10 min
6 | bench | dry pre-cooled sand + AMDI; open V1 and V3; collect 2–5 mL
fractions in septum vials on ice | Tdisc logged
7 | end | ≥ 1.5 PV out or 120 h; close V1, V3; section in 10 mm slices: gravimetric θ, δ²H, Br⁻
balance ±2 %

### time from transfer [h]

### mean sample T [°C]

pack | in freezer: freeze + hold | transfer ≤ 10 min → infiltration on bench (lab 20 °C)

freezer set-point −10 °C
Kaiflex 30 (as drawn), start -10 °C
Kaiflex 30 (as drawn), start -3 °C (for comparison)

PU/XPS box 60, start -10 °C
PU/XPS box 60, start -3 °C (for comparison) PU/XPS box 100, start -10 °C
PU/XPS box 100, start -3 °C (for comparison)

scale | – | drawing no. | E6-V08 | sheet 8 / 12
status | DRAFT | drawn | Claude Code (draft) | checked: —

# Thermometry – chest freezer layout

temperature channels inside and outside the freezer; not to scale collar: XPS 50 mm + plywood skin, between body and lid; cable glands G1–G4 in the collar shielded PTFE cables, no connectors on the cold side

## Temperature channels

ID | location | in/out
T10 | soil, wall probe, depth 10 mm, r 9 | in
T20 | soil, wall probe, depth 20 mm, r 9 | in
T35 | soil, wall probe, depth 35 mm, r 9 | in
T50 | soil, wall probe, depth 50 mm, r 9 | in
T70 | soil, wall probe, depth 70 mm, r 9 | in

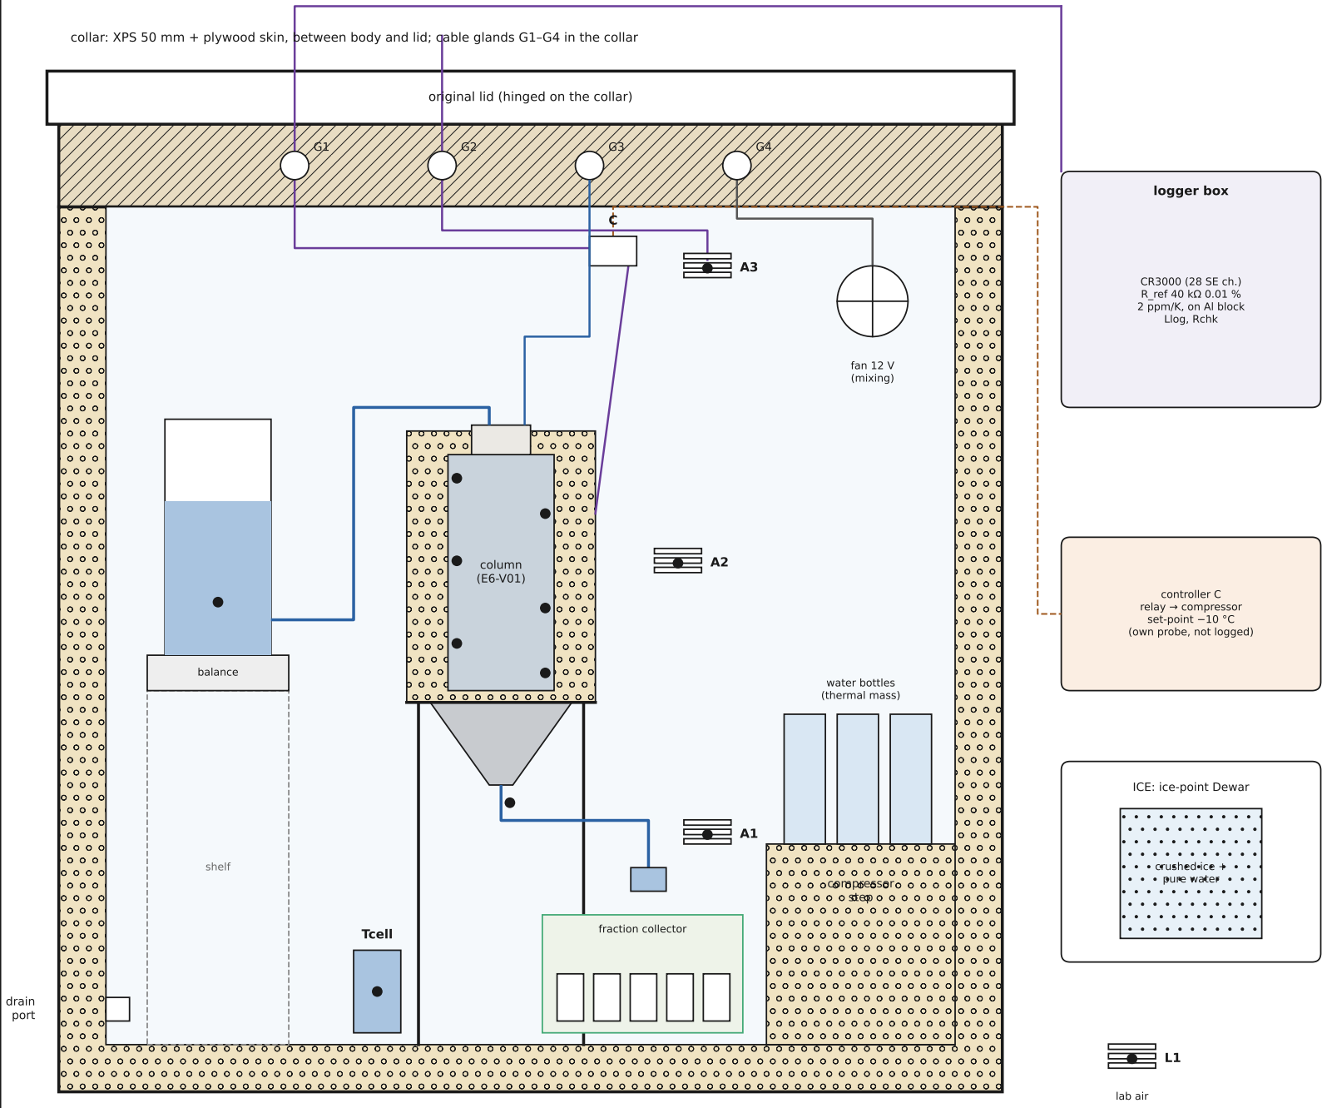
[picture p201: figure]
compressor step; original lid (hinged on the collar); drain port; column (E6-V01); balance; shelf; Tcell; water bottles (thermal mass); fan 12 V (mixing); logger box; CR3000 (28 SE ch.) R_ref 40 kΩ 0.01 %; 2 ppm/K, on Al block Llog, Rchk; controller C relay → compressor set-point −10 °C; (own probe, not logged); ICE: ice-point Dewar; lab air; fraction collector; crushed ice + pure water

T90 | soil, wall probe, depth 90 mm, r 9 | in
T2r | soil, ring needle, 2 mm below surface | in
T6r | soil, ring needle, 6 mm below surface | in
Tdisc | disc / contact sand | in
Tcone | cone body under membrane | in
Tsup | Mariotte bottle water | in
Tout | outflow at nozzle | in
A1 | freezer air, floor level, shielded | in
A2 | freezer air, column mid-height | in
A3 | freezer air, under lid | in
Tcell | reference cell, 50 mL pure water | in
L1 | lab air at freezer, shielded | out
Llog | logger enclosure, at R_ref | out
ICE | ice-point Dewar (spare probe) | out
Rchk | fixed 40 kΩ resistor (no NTC) | out

Rules
- Never drill the freezer walls (refrigerant lines inside); use the collar.
- One logger, one R_ref, one set of cables for calibration and runs.
- Logger stays outside at room temperature; log Llog next to R_ref.
- Excitation 0.5 V for ~50 ms per reading → self-heating ≈ 1.4 mK.
- Check ICE (0.000 °C) before and after each run; drift > 3 mK → recalibrate.
- Tcell shows the 0 °C freezing plateau of pure water during freezing:

an in-situ check of the whole chain at the most important temperature.
- Fan + water bottles damp the compressor cycling (typ. ±2 K → < ±0.3 K

at A2); the column insulation damps it further.

## PROBE P1 (wall probe, tip at r 9) 2 : 1

## HALF-BRIDGE (ratiometric)

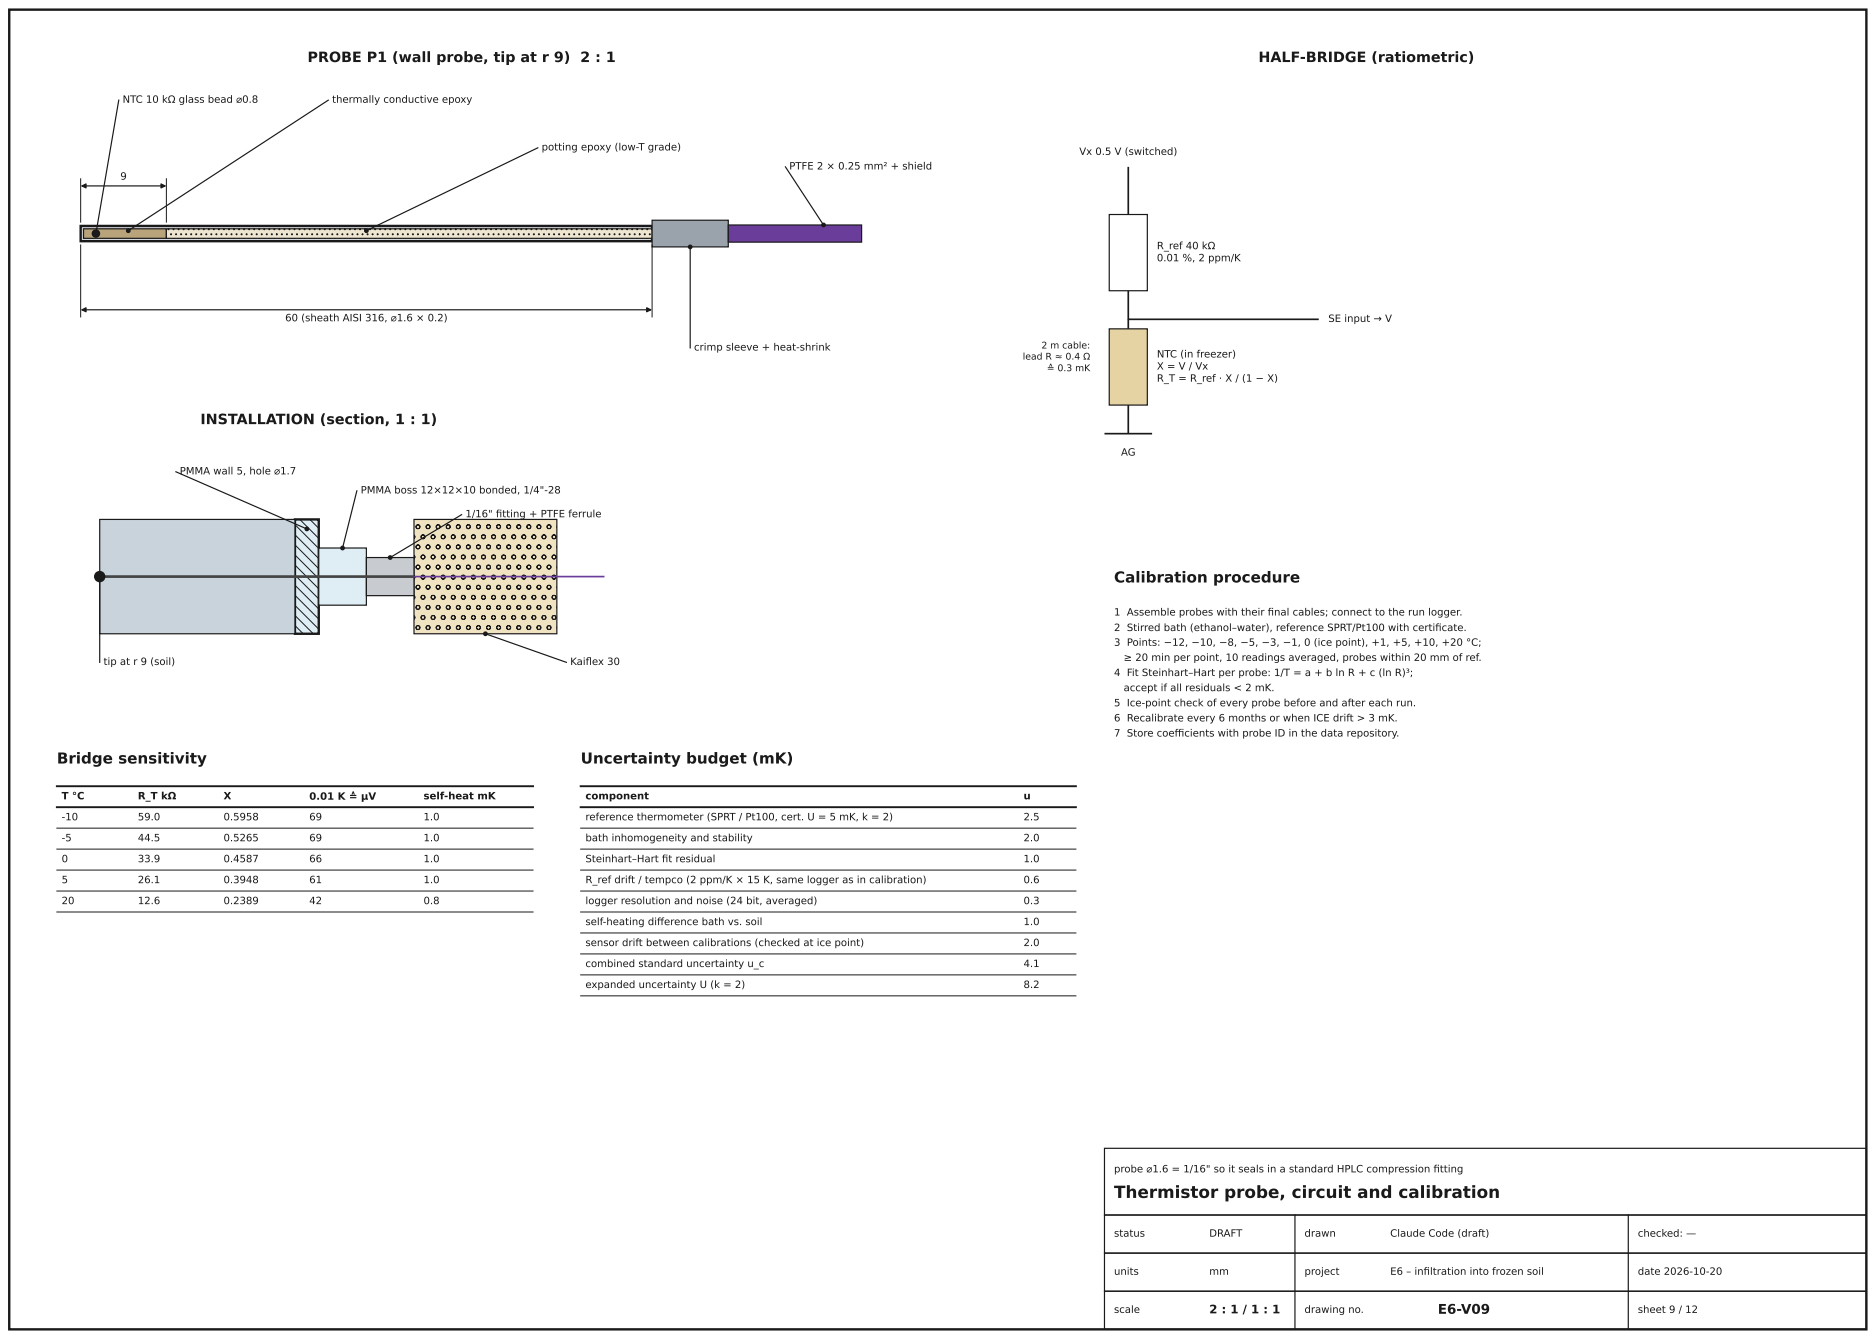
[picture p202: page 9]
scale; drawing no.; sheet 9 / 12; status; DRAFT; drawn; Claude Code (draft); checked: —; INSTALLATION (section, 1 : 1); Bridge sensitivity; self-heat mK; component; reference thermometer (SPRT / Pt100, cert. U = 5 mK, k = 2); bath inhomogeneity and stability; Steinhart–Hart fit residual; R_ref drift / tempco (2 ppm/K × 15 K, same logger as in calibration); logger resolution and noise (24 bit, averaged); self-heating difference bath vs. soil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

potting epoxy (low-T grade)

PTFE 2 × 0.25 mm² + shield

crimp sleeve + heat-shrink

PMMA wall 5, hole ⌀1.7

PMMA boss 12×12×10 bonded, 1/4"-28

1/16" fitting + PTFE ferrule

1 Assemble probes with their final cables; connect to the run logger.
2 Stirred bath (ethanol–water), reference SPRT/Pt100 with certificate.
3 Points: −12, −10, −8, −5, −3, −1, 0 (ice point), +1, +5, +10, +20 °C;
≥ 20 min per point, 10 readings averaged, probes within 20 mm of ref.
4 Fit Steinhart–Hart per probe: 1/T = a + b ln R + c (ln R)³;

accept if all residuals < 2 mK.
5 Ice-point check of every probe before and after each run.
6 Recalibrate every 6 months or when ICE drift > 3 mK.
7 Store coefficients with probe ID in the data repository.

Uncertainty budget (mK)

probe ⌀1.6 = 1/16" so it seals in a standard HPLC compression fitting
Thermistor probe, circuit and calibration

scale | 1 : 5 | drawing no. | E6-V10 | sheet 10 / 12
status | DRAFT | drawn | Claude Code (draft) | checked: —

# As-built chest freezer – realistic layout

dimensions marked ≈ are estimated from photos and must be measured

## Seen in the photos

1 Chest freezer, programmable controller (program Set A: 24 h +10 °C, then 192 h steps −10 / +10 °C, linear). Controller clock shows 29.02.2000.

2 Heavy frost on the walls; cables run under the lid seal.
3 Stainless tray ≈ 530 × 340 on a black insulation mat.
4 Sample in a clear printed PETG holder, ⌀100 inside, wide top flange.

It stands directly on the tray (no outlet).
5 Al plate ≈ ⌀112 × 20 on top, centre hole ≈ ⌀26, recess ≈ ⌀60.

6 Two thermistor wires pushed vertically into the sand from the top.
7 Two heat-flux sensors taped with duct tape: on the Al plate, on the tray. 8 Black cable + blue tube enter the holder at the side (TDR? – confirm).

## Changes (red)

A Raise the sample on the cone outlet + stand ≈ 150 mm; the collector sits beside it on the tray, overflow cup sets h_b (default −5 cm).

B Side insulation sleeve 30 mm around the holder (no radial freezing).
C Al plate: open the hole to ⌀64 so the AMDI disc reaches the soil and

the plate stays as a cold annular top boundary.
D Cable collar with glands → lid seals, less frost, less sublimation.

E Defrost before each run; set the controller clock (time base for data). F Mariotte bottle on balance + platform; air inlet 20 mm below the disc. G Temperature sensors as in E6-V11 (+ A1–A3, Tcell, controller probe C).

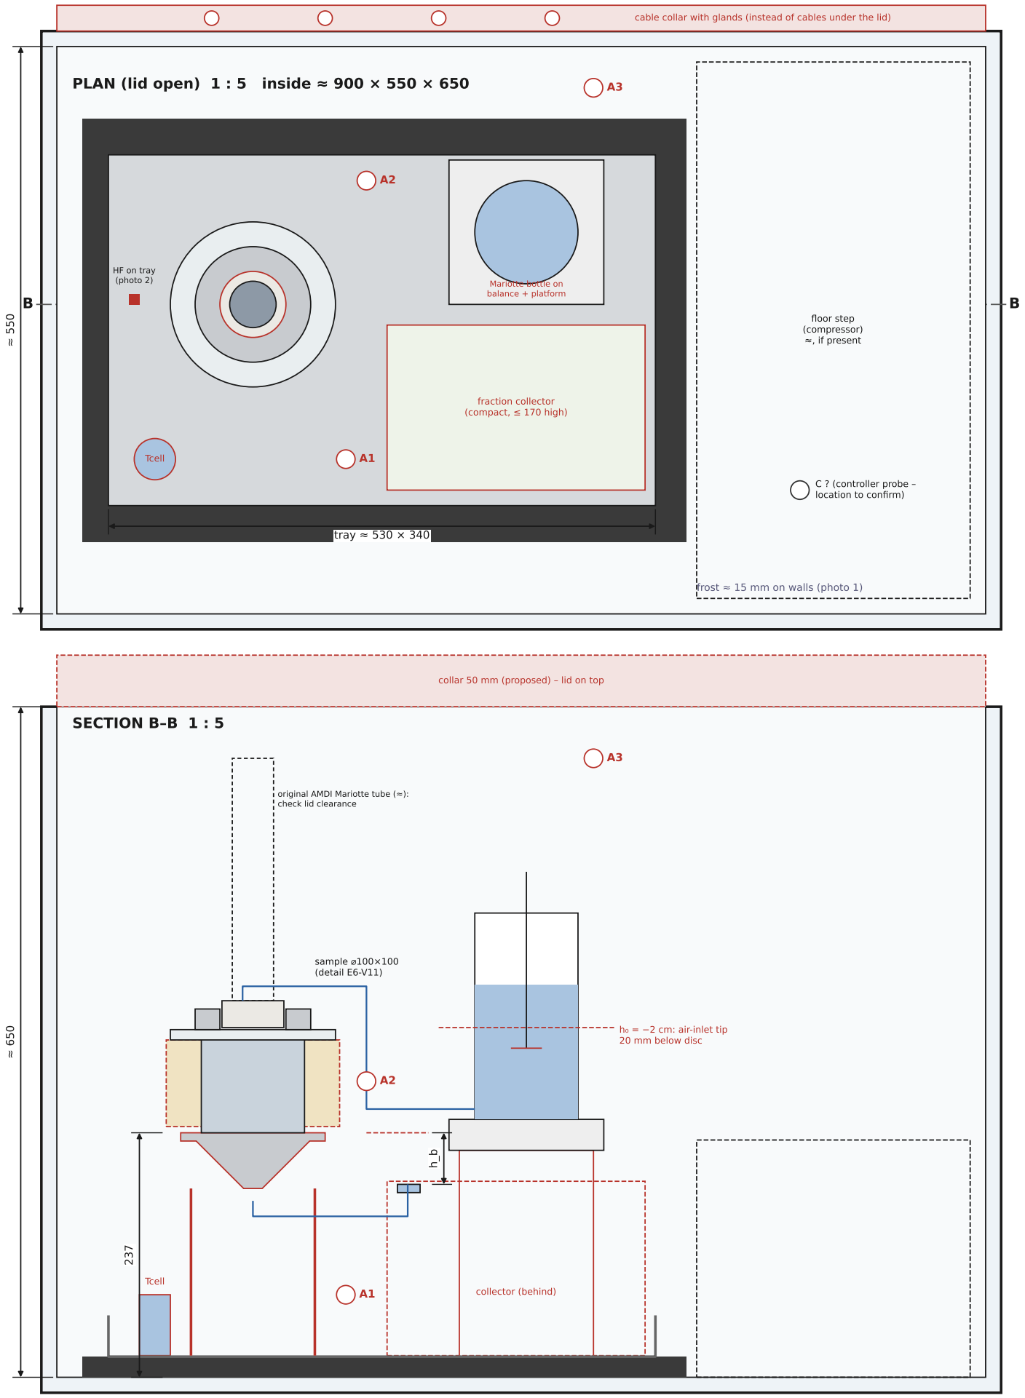
[picture p203: figure]
frost ≈ 15 mm on walls (photo 1); floor step; (compressor) ≈, if present; fraction collector (compact, ≤ 170 high); HF on tray (photo 2); C ? (controller probe – location to confirm); Tcell; tray ≈ 530 × 340; SECTION B–B 1 : 5; original AMDI Mariotte tube (≈):; check lid clearance; h₀ = −2 cm: air-inlet tip; 20 mm below disc; collector (behind); collar 50 mm (proposed) – lid on top; sample ⌀100×100; (detail E6-V11); Mariotte bottle on balance + platform

## PLAN (lid open) 1 : 5 inside ≈ 900 × 550 × 650

cable collar with glands (instead of cables under the lid)

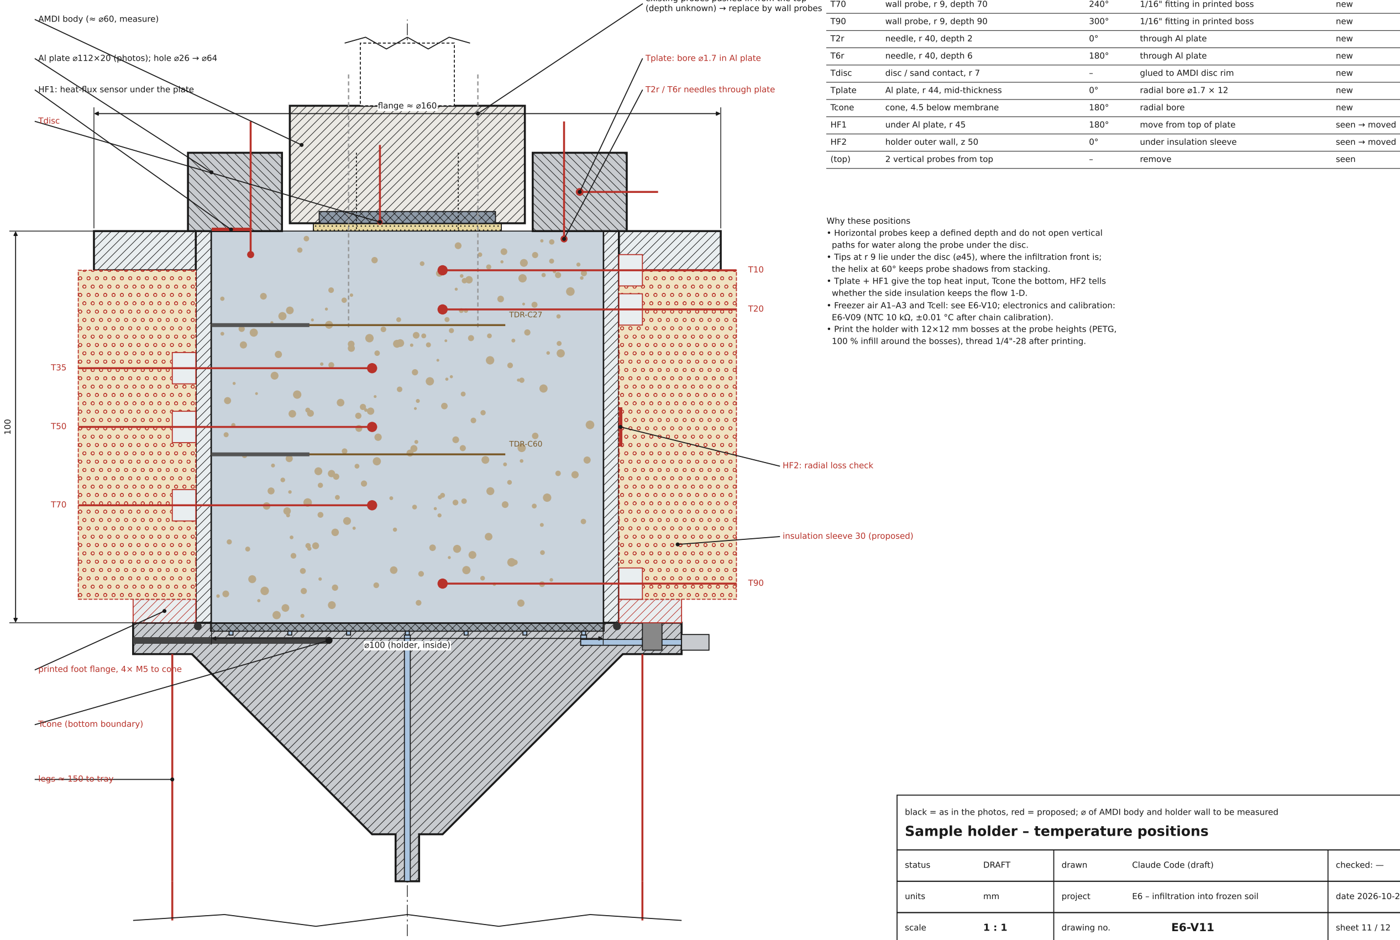
[picture p204: figure]
scale; drawing no.; sheet 11 / 12; status; DRAFT; drawn; Claude Code (draft); checked: —; Sample holder – temperature positions; needle, r 40, depth 2; through Al plate; new; needle, r 40, depth 6; Tplate; Al plate, r 44, mid-thickness; radial bore ⌀1.7 × 12; Tcone; cone, 4.5 below membrane; radial bore; under Al plate, r 45; move from top of plate; seen → moved; holder outer wall, z 50; under insulation sleeve; (top); 2 vertical probes from top; remove; seen; Why these positions; TDR-C27; TDR-C60; ⌀100 (holder, inside); flange; AMDI body (≈ ⌀60, measure)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

black = as in the photos, red = proposed; ⌀ of AMDI body and holder wall to be measured

## Temperature positions

ID | position | angle | mounting | status
T10 | wall probe, r 9, depth 10 | 0° | 1/16" fitting in printed boss | new
T20 | wall probe, r 9, depth 20 | 60° | 1/16" fitting in printed boss | new
T35 | wall probe, r 9, depth 35 | 120° | 1/16" fitting in printed boss | new
T50 | wall probe, r 9, depth 50 | 180° | 1/16" fitting in printed boss | new
T70 | wall probe, r 9, depth 70 | 240° | 1/16" fitting in printed boss | new
T90 | wall probe, r 9, depth 90 | 300° | 1/16" fitting in printed boss | new
Tdisc | disc / sand contact, r 7 | – | glued to AMDI disc rim | new
- Horizontal probes keep a defined depth and do not open vertical

paths for water along the probe under the disc.
- Tips at r 9 lie under the disc (⌀45), where the infiltration front is;

the helix at 60° keeps probe shadows from stacking.
- Tplate + HF1 give the top heat input, Tcone the bottom, HF2 tells whether the side insulation keeps the flow 1-D.
- Freezer air A1–A3 and Tcell: see E6-V10; electronics and calibration: E6-V09 (NTC 10 kΩ, ±0.01 °C after chain calibration).
- Print the holder with 12×12 mm bosses at the probe heights (PETG, 100 % infill around the bosses), thread 1/4"-28 after printing.

existing probes pushed in from the top (depth unknown) → replace by wall probes

Al plate ⌀112×20 (photos); hole ⌀26 → ⌀64

scale | – | drawing no. | E6-V12 | sheet 12 / 12
status | DRAFT | drawn | Claude Code (draft) | checked: —

# Bench set-up after transfer

infiltration outside the freezer; not to scale except marked heights

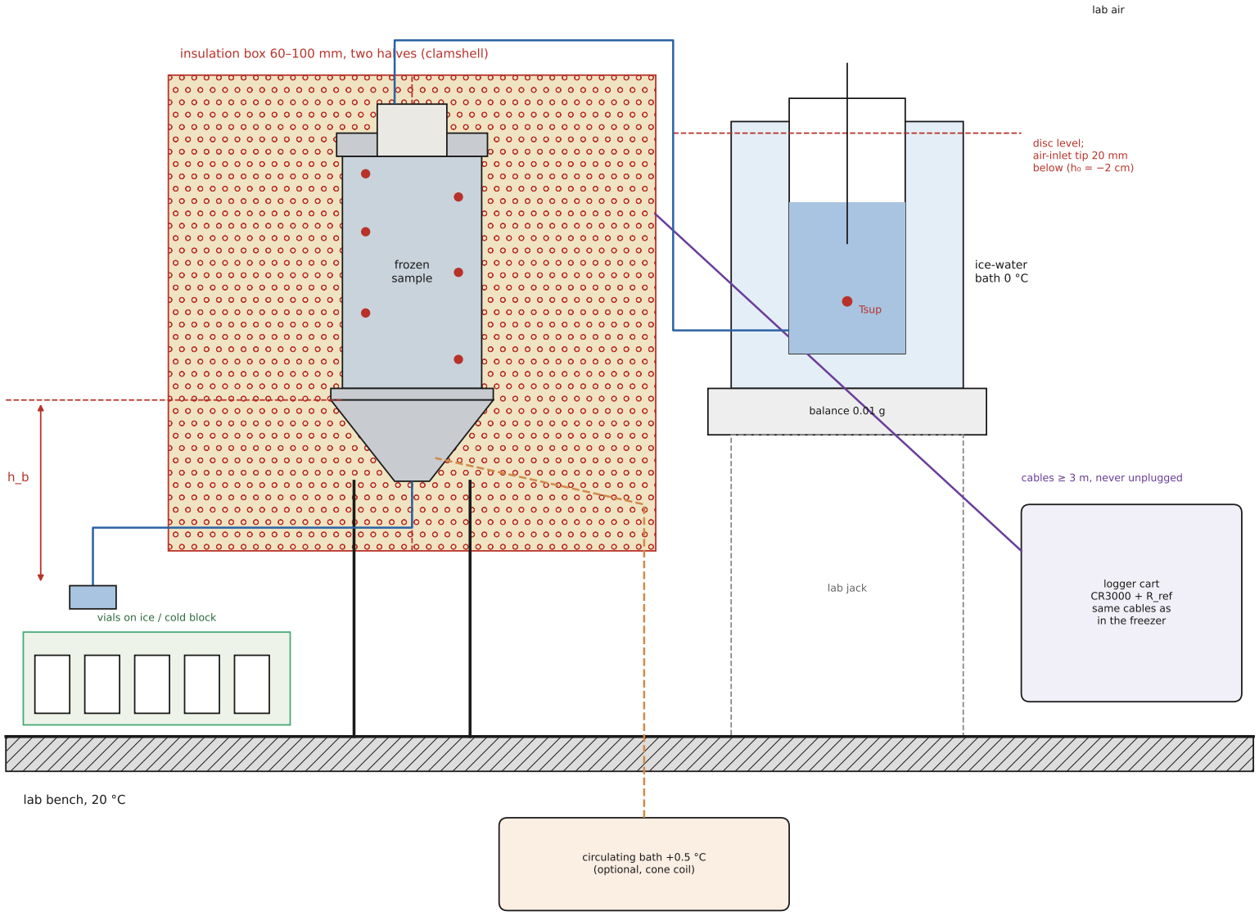
[picture p205: figure]
lab bench, 20 °C; ice-water bath 0 °C; balance 0.01 g; lab jack; disc level; air-inlet tip 20 mm below (h₀ = −2 cm); Tsup; vials on ice / cold block; circulating bath +0.5 °C (optional, cone coil); logger cart CR3000 + R_ref same cables as in the freezer; cables ≥ 3 m, never unplugged; lab air; frozen sample

insulation box 60–100 mm, two halves (clamshell)

L1

ICE: ice-point
Dewar, check
before / after

Freezer → bench: lift column + cone + stand as one unit; the logger cart stands next to the

freezer so the cables reach both places; temperature record stays continuous.

## How long does it stay frozen on the bench?

insulation | start °C | UA W/K | to 0 °C h | ice gone h
Kaiflex 30 (as drawn) | -3 | 0.097 | 0.6 | 9
Kaiflex 30 (as drawn) | -10 | 0.097 | 1.7 | 9
PU/XPS box 60 | -3 | 0.054 | 1.1 | 15
PU/XPS box 60 | -10 | 0.054 | 3.1 | 15
PU/XPS box 100 | -3 | 0.038 | 1.5 | 22
PU/XPS box 100 | -10 | 0.038 | 4.4 | 22

Lumped estimate, lab 20 °C, conduction through the insulation only.
Real times are shorter: uninsulated AMDI head, legs, cables, and warm infiltration water (84 J/mL at 20 °C vs 2 J/mL at 0.5 °C → use ice bath).

What it means
- Use the thickest practical box (≥ 60 mm) and start colder (−10 °C)
(−10 °C chosen: ≈ 3 h before 0 °C with a 60 mm box; −3 °C would give ≈ 1 h).
- The run always continues into thawing soil: the probes record when

and where the ice disappears (0 °C plateau ends).
- Supply water, sand and the AMDI disc at 0–0.5 °C, otherwise the
disc melts its own footprint first.
- Bottom: a frozen cone blocks the outlet; the optional bath at +0.5 °C

thaws the lowest mm so water can leave at h_b.
- Collect fractions on ice in septum vials: lab air would evaporate them.
