martinasobotkova5/my_data_projects/e7_frost_heave_load/vyroba/vykresy/E7_vyrobni_vykresy.pdf

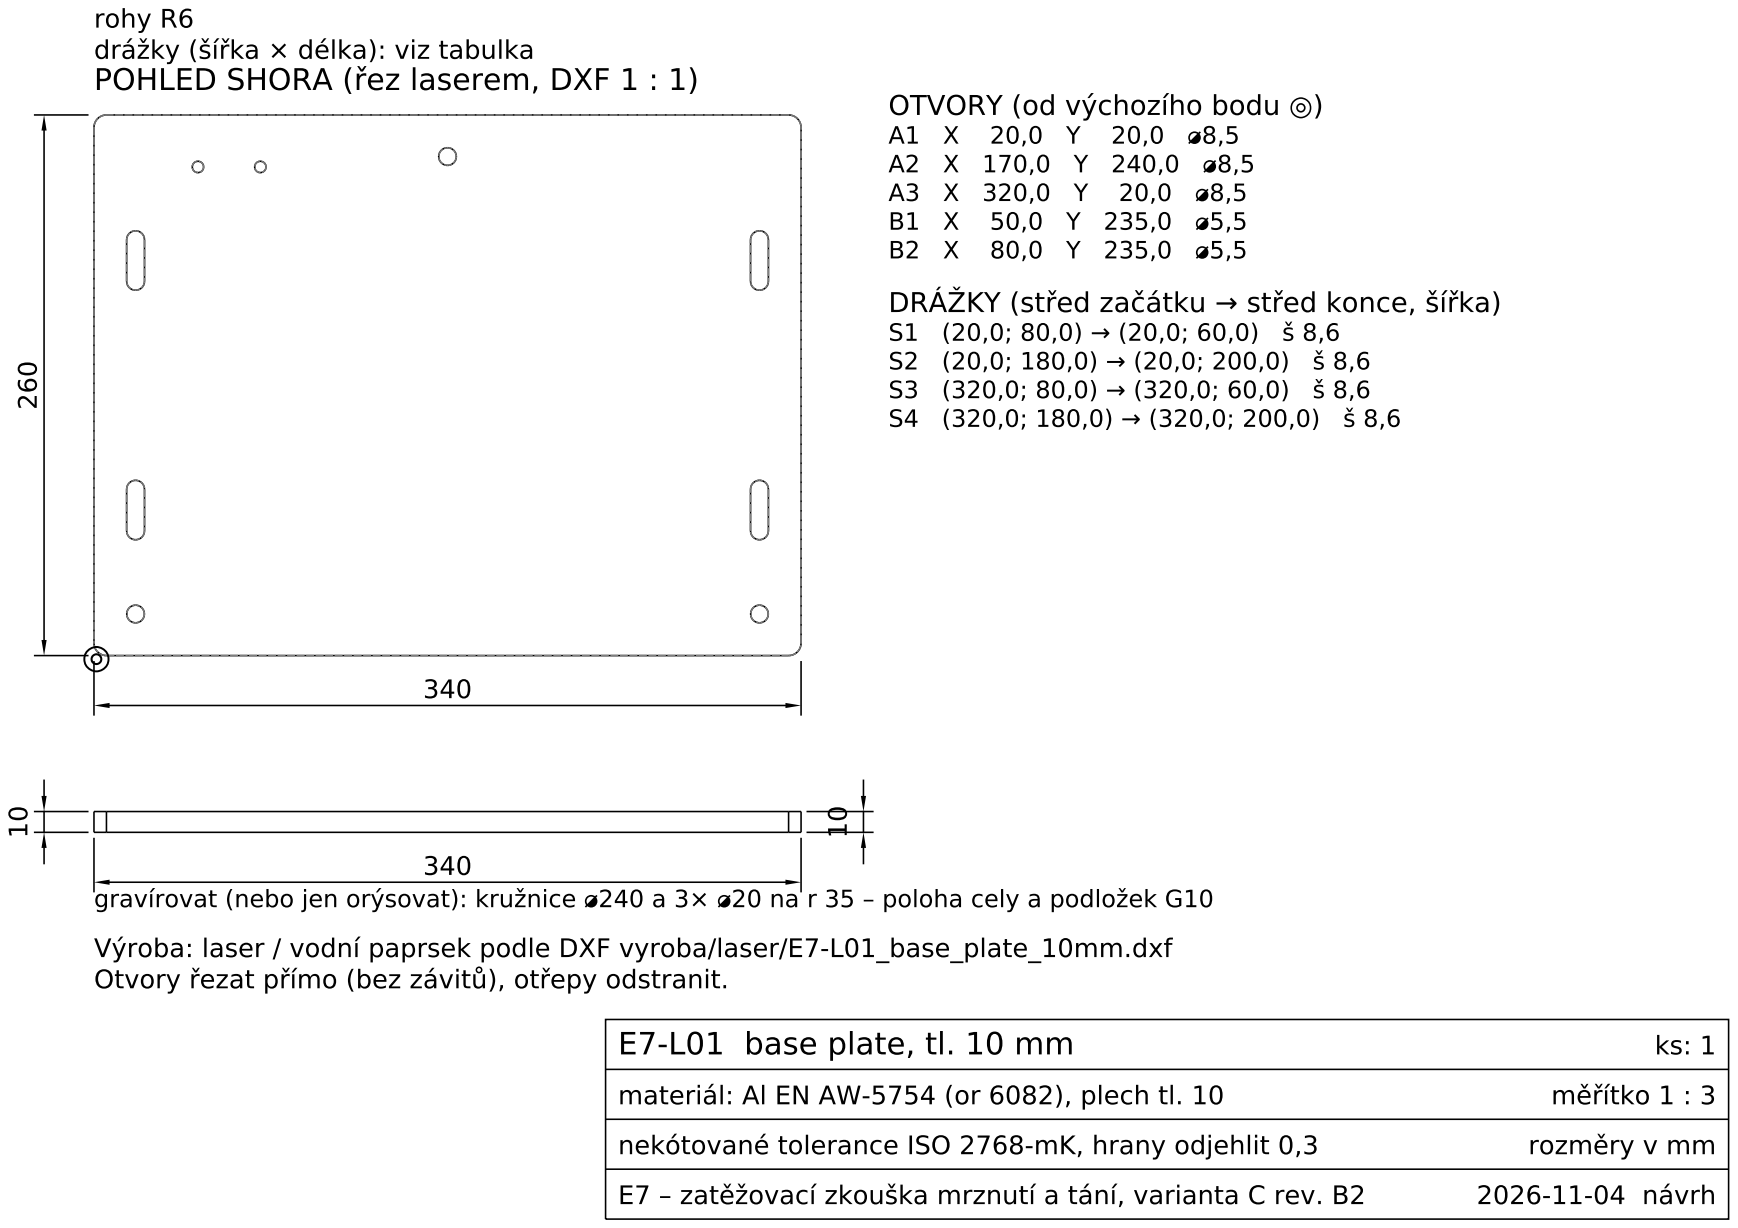
[picture p207: page 1]

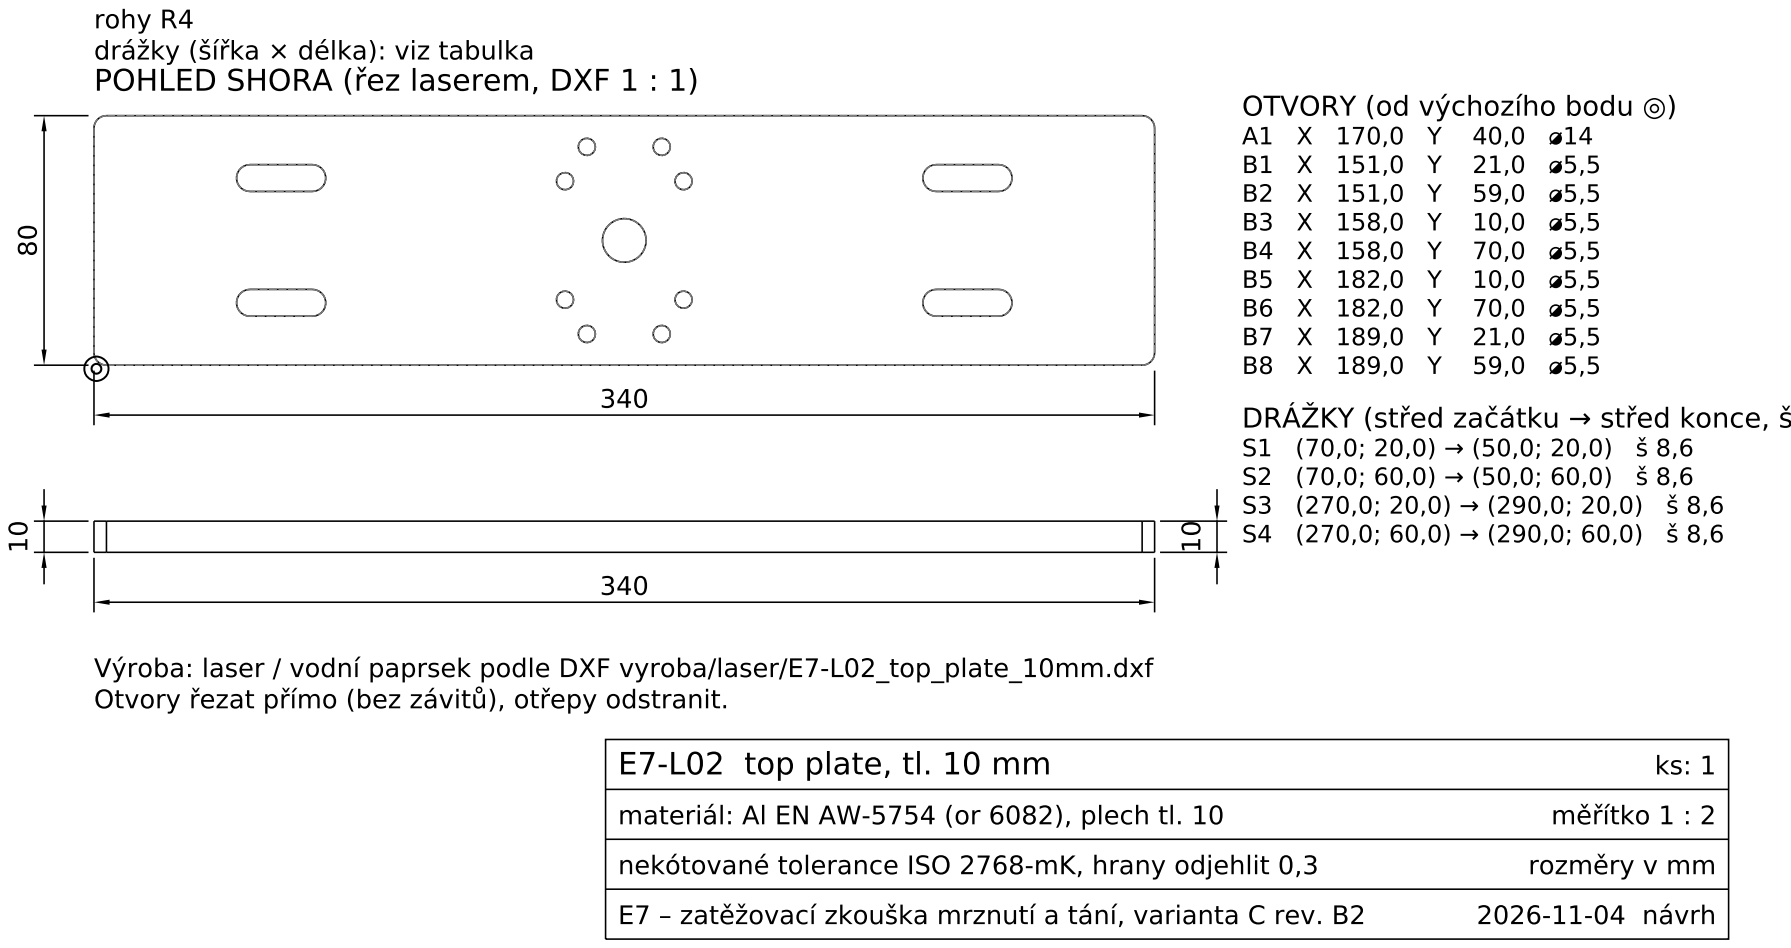
[picture p208: page 2]

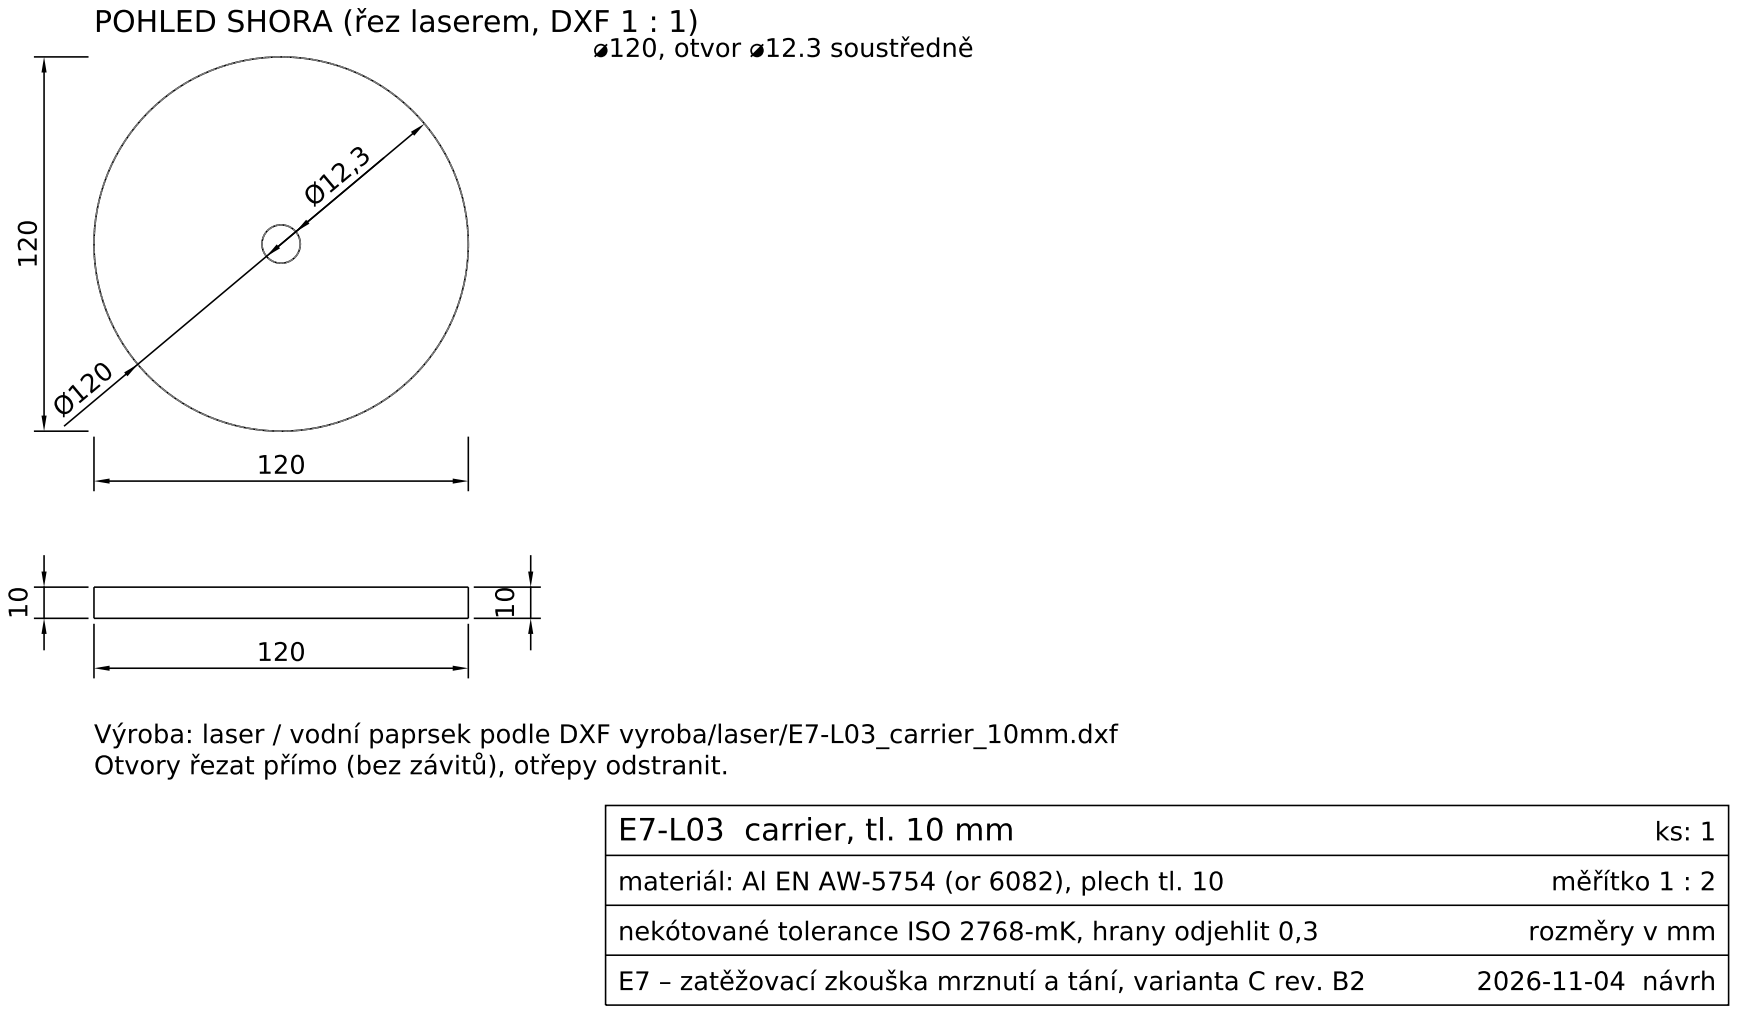
[picture p209: page 3]

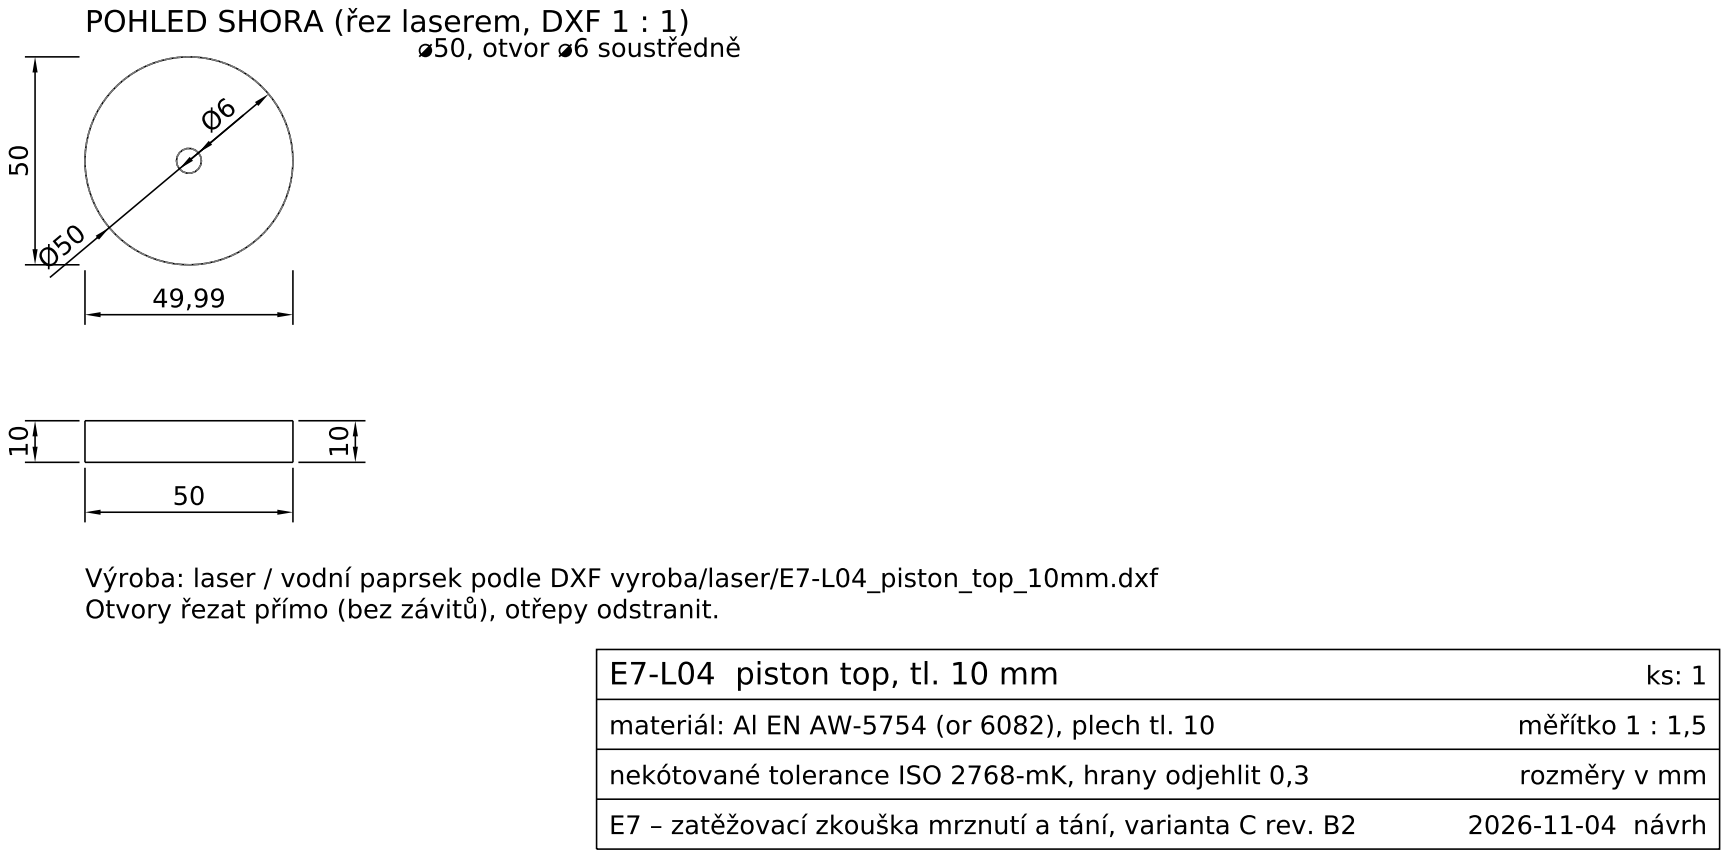
[picture p210: page 4]

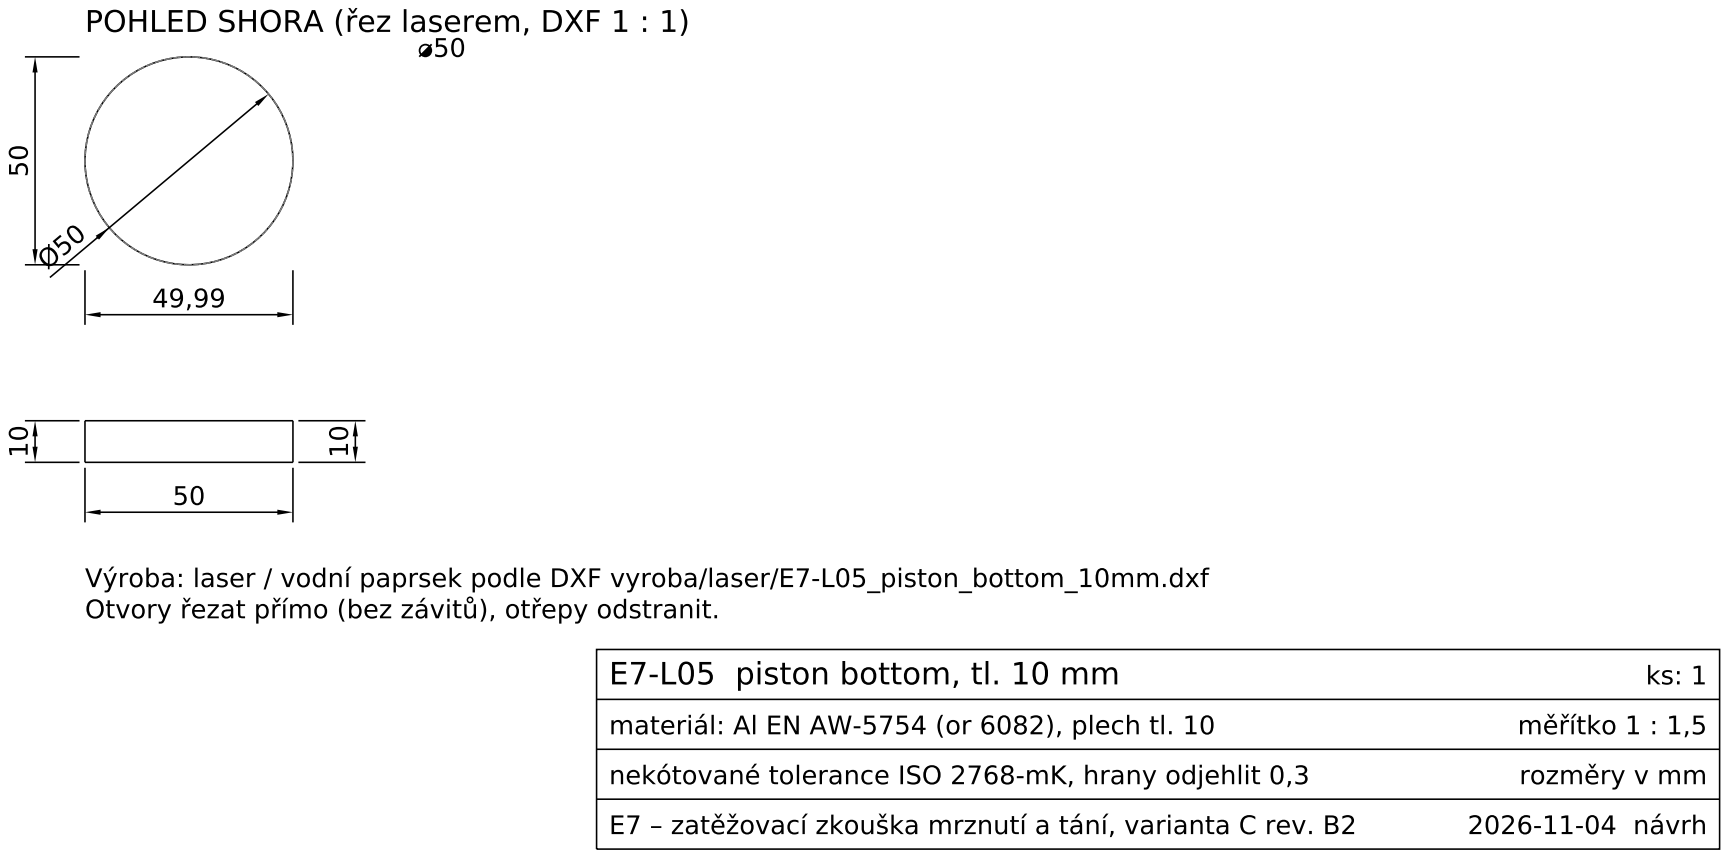
[picture p211: page 5]

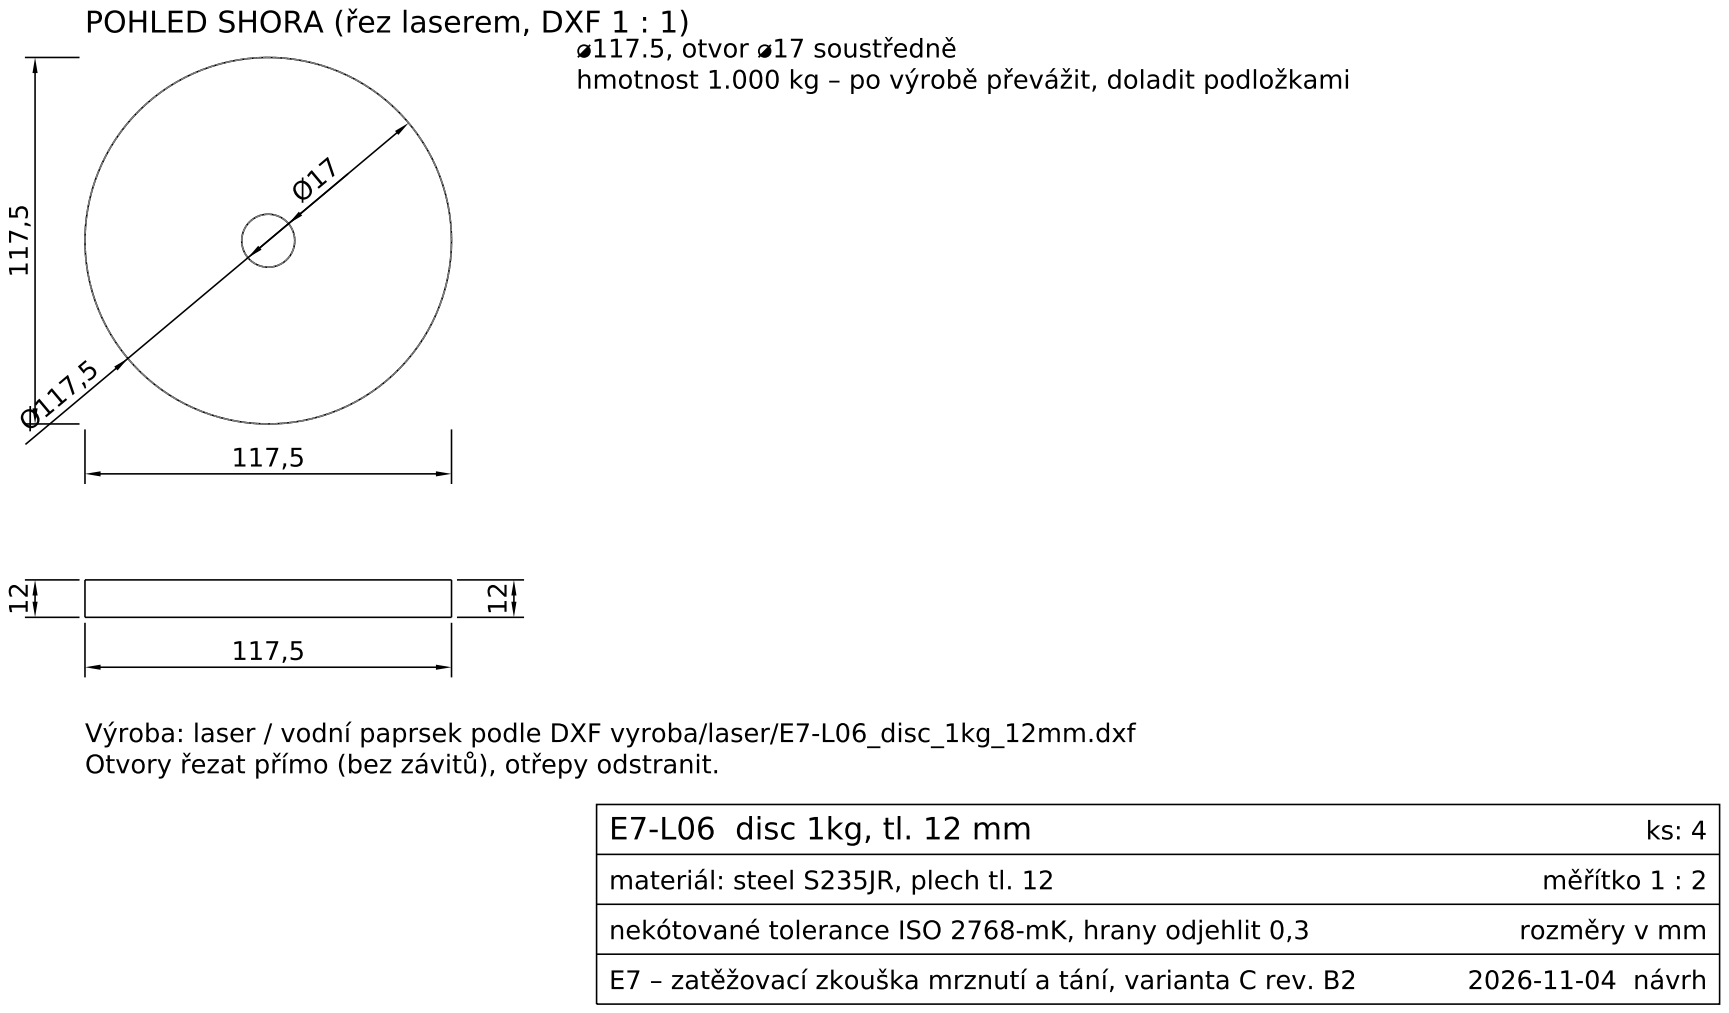
[picture p212: page 6]

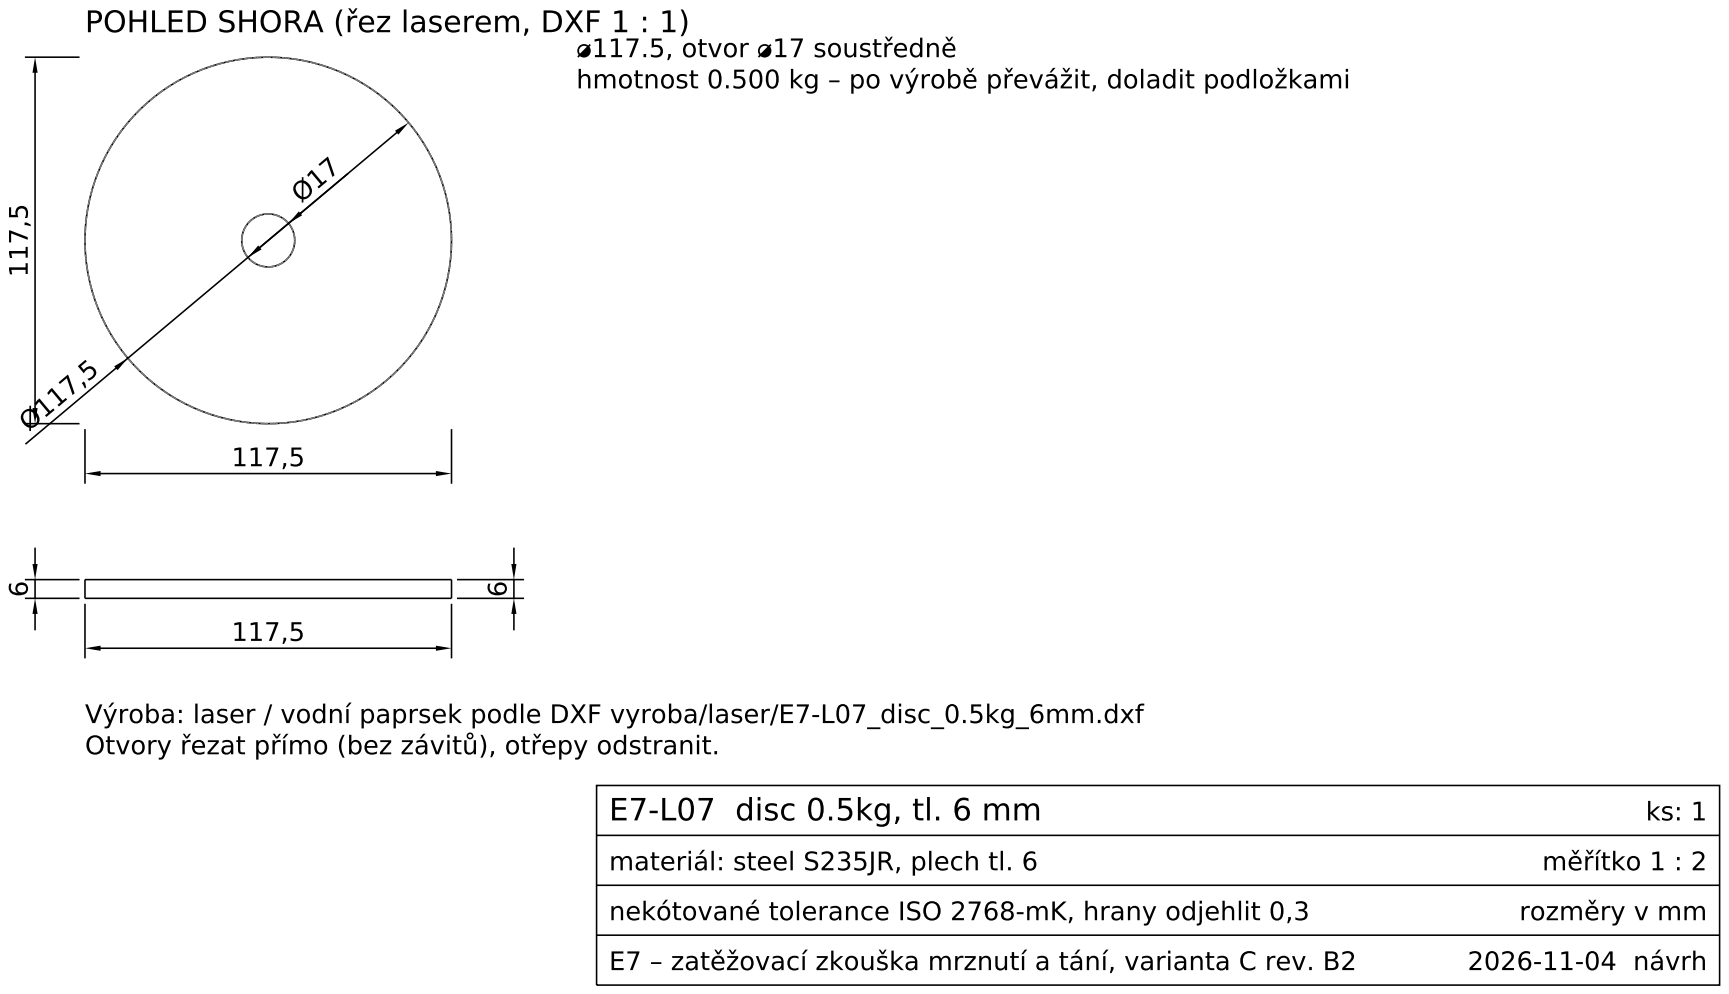
[picture p213: page 7]

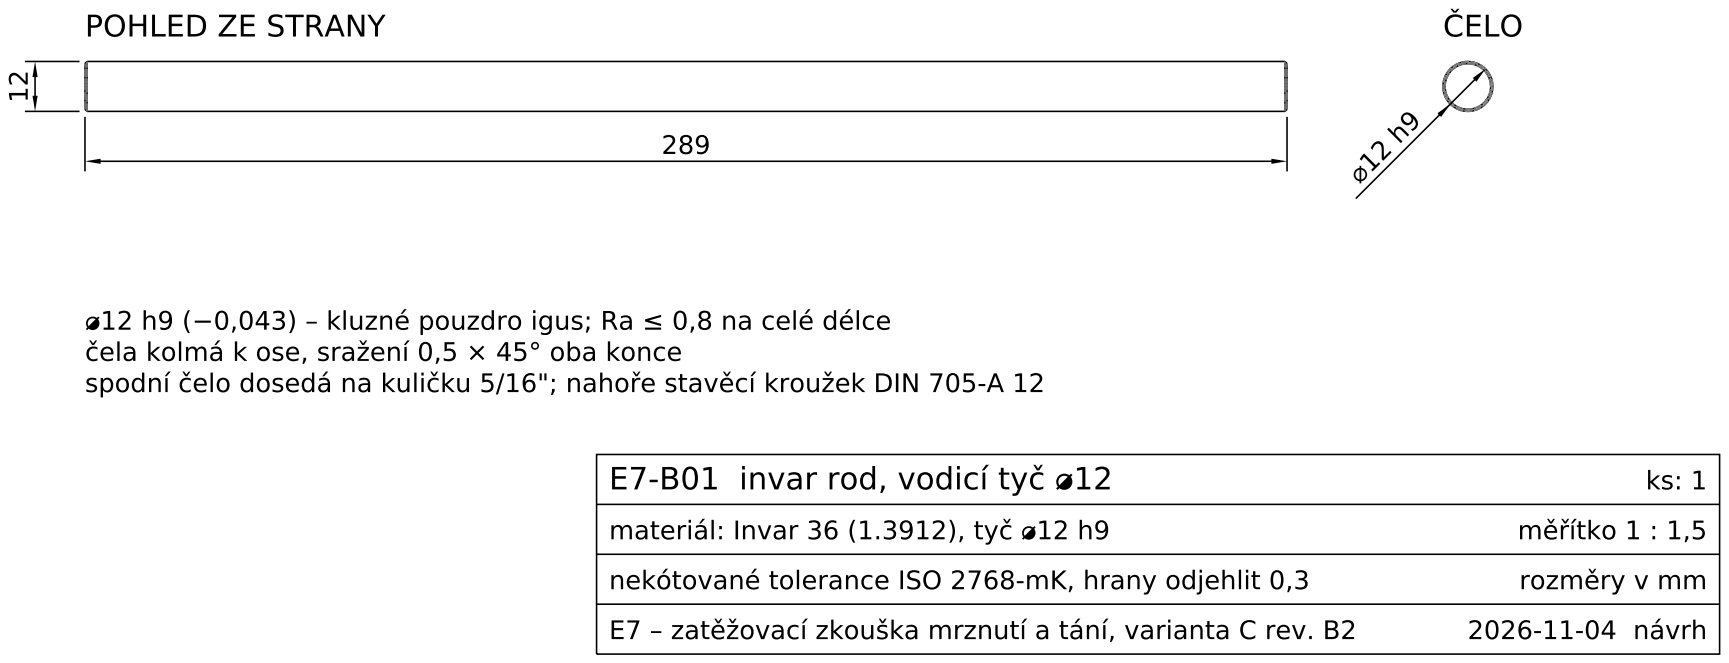
[picture p214: page 8]

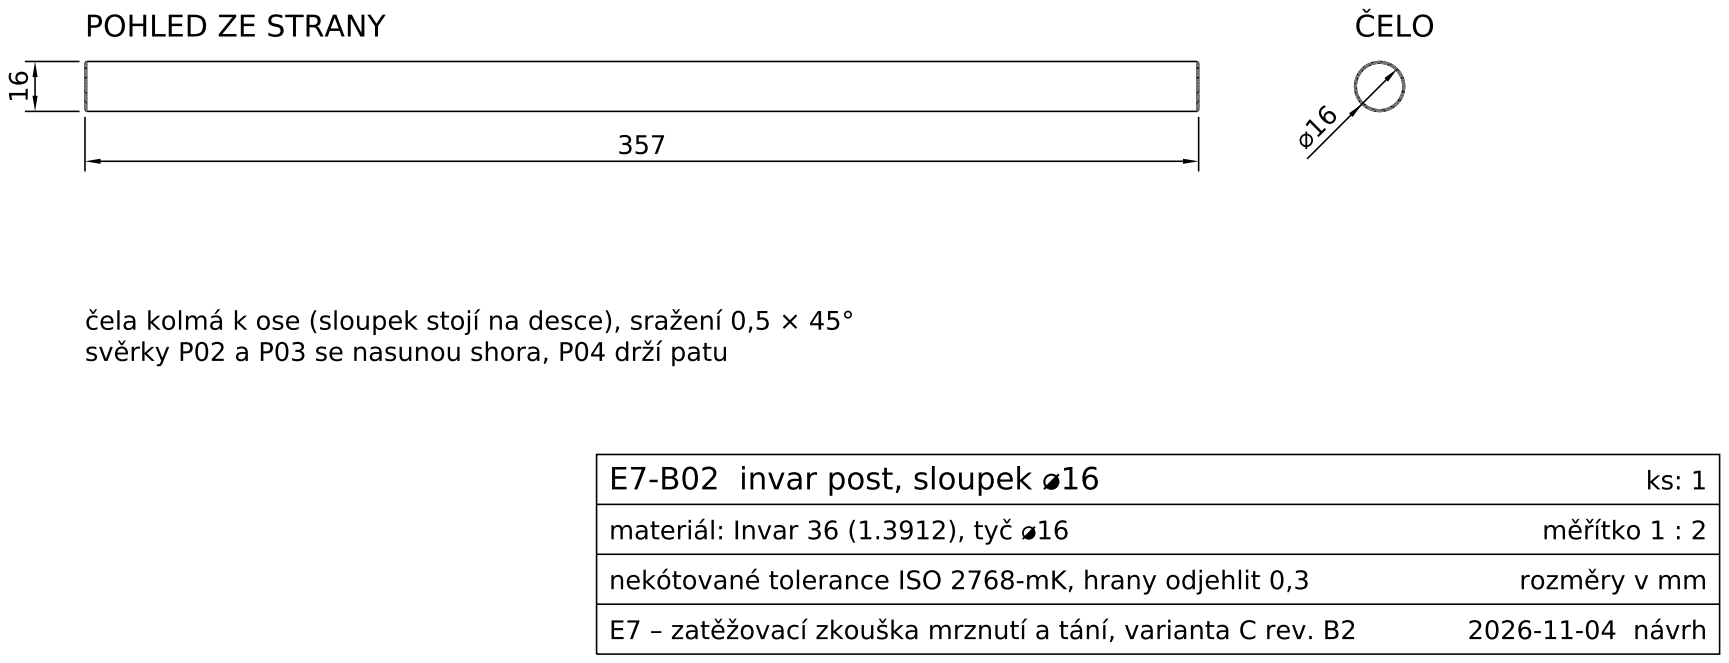
[picture p215: page 9]

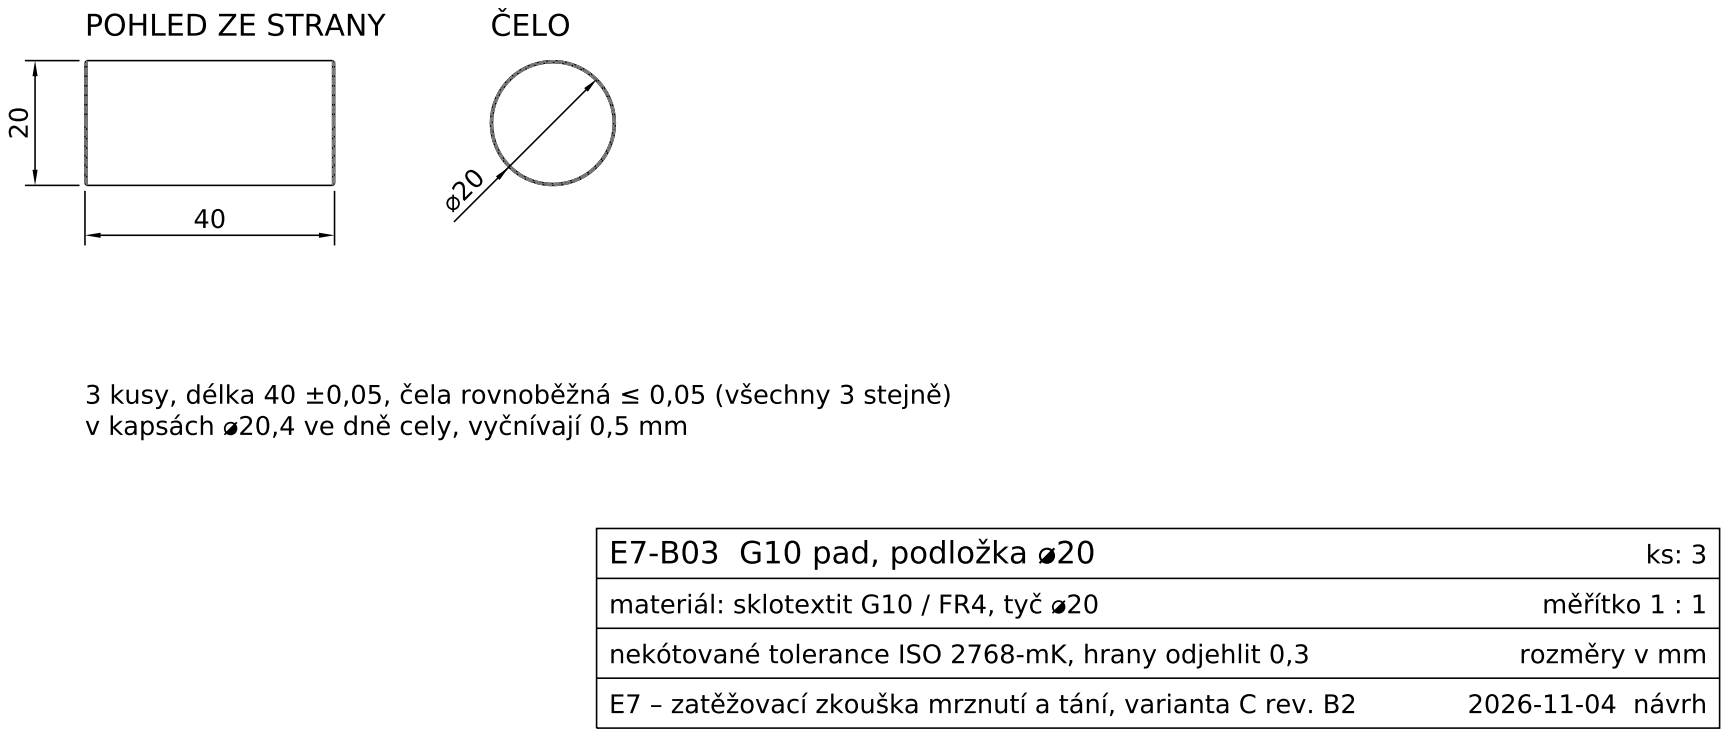
[picture p216: page 10]

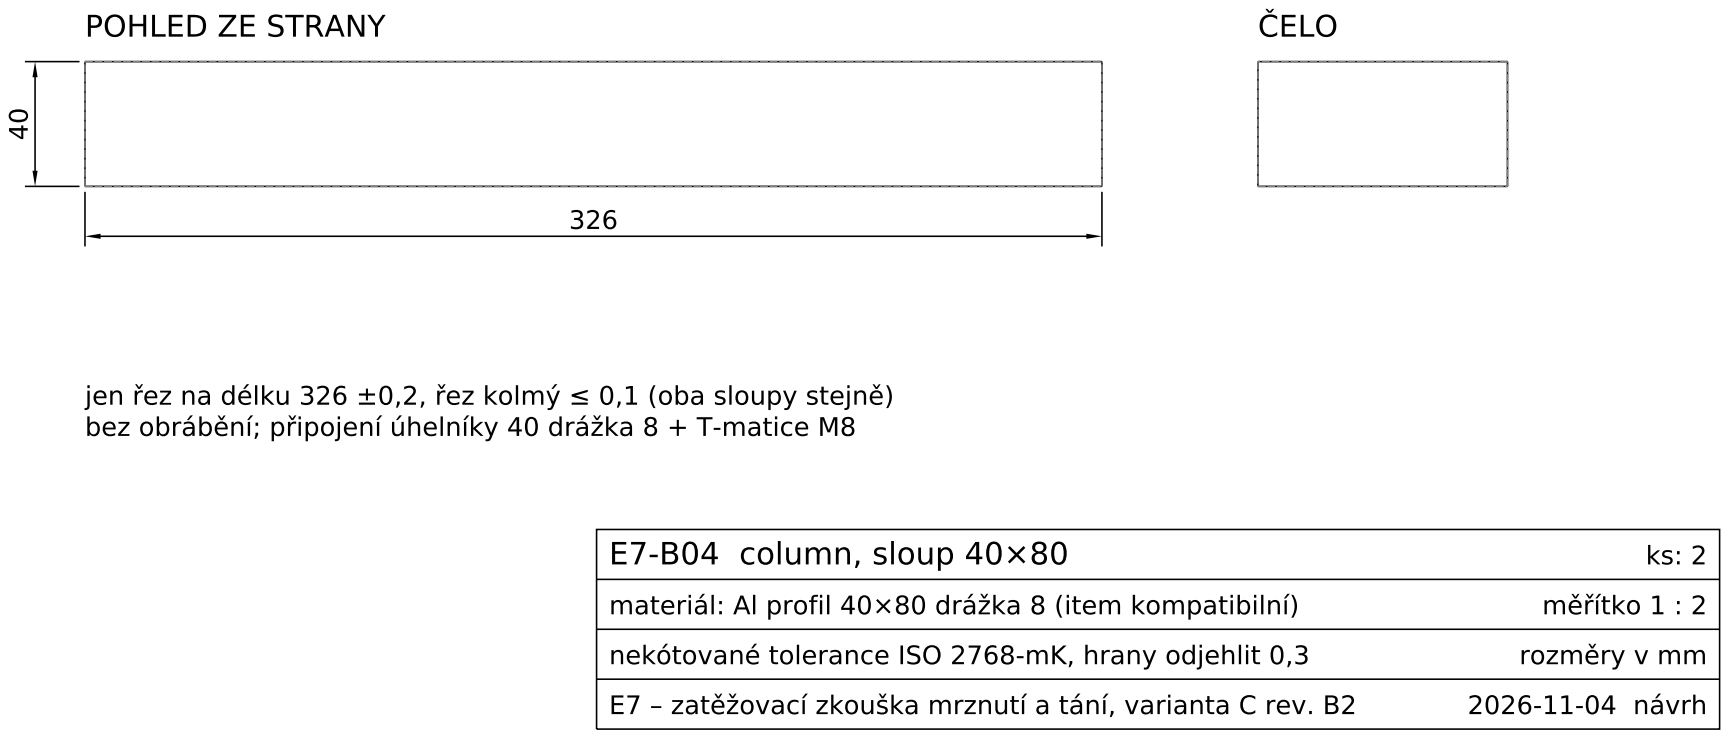
[picture p217: page 11]

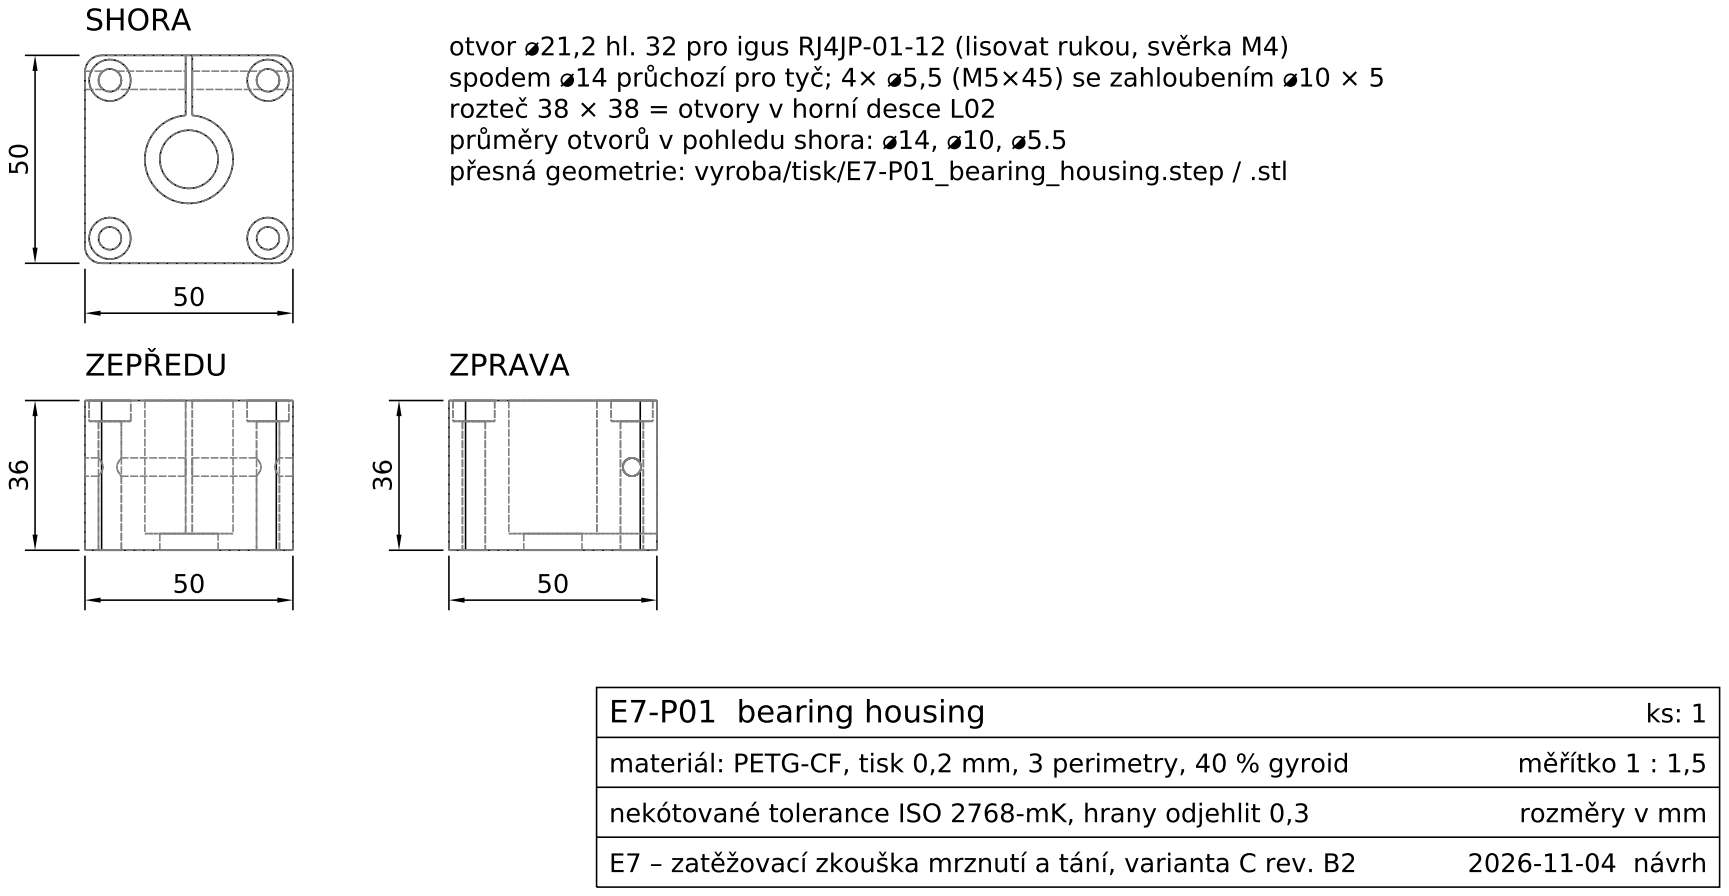
[picture p218: page 12]

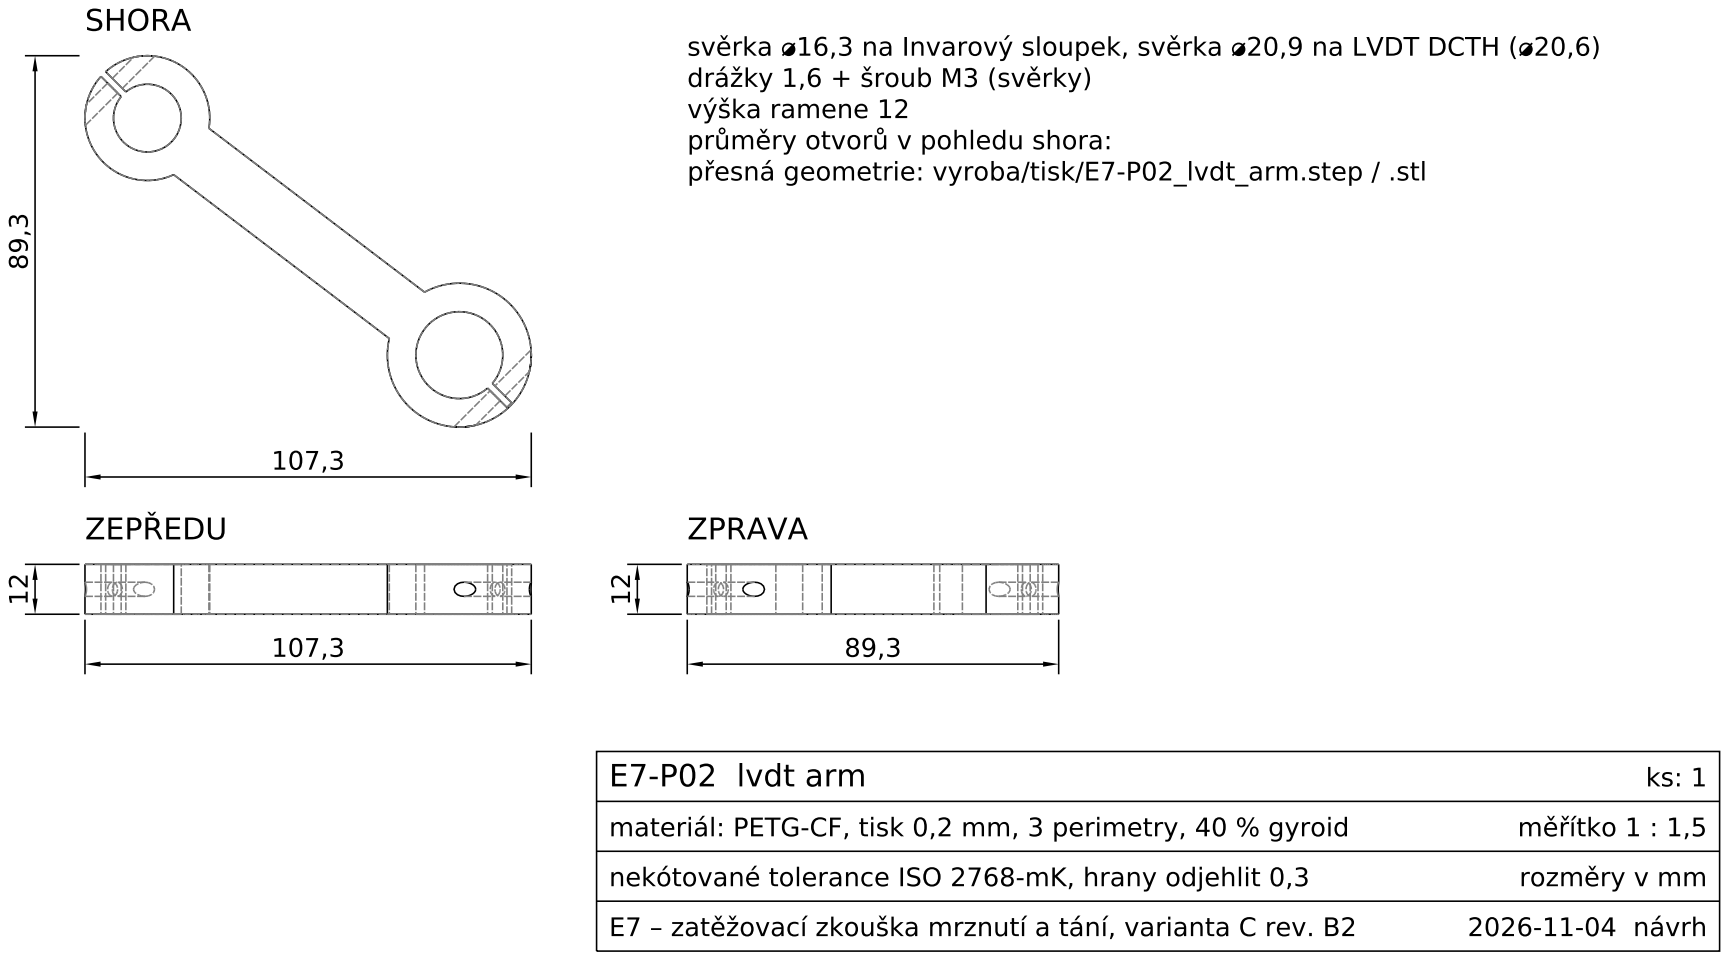
[picture p219: page 13]

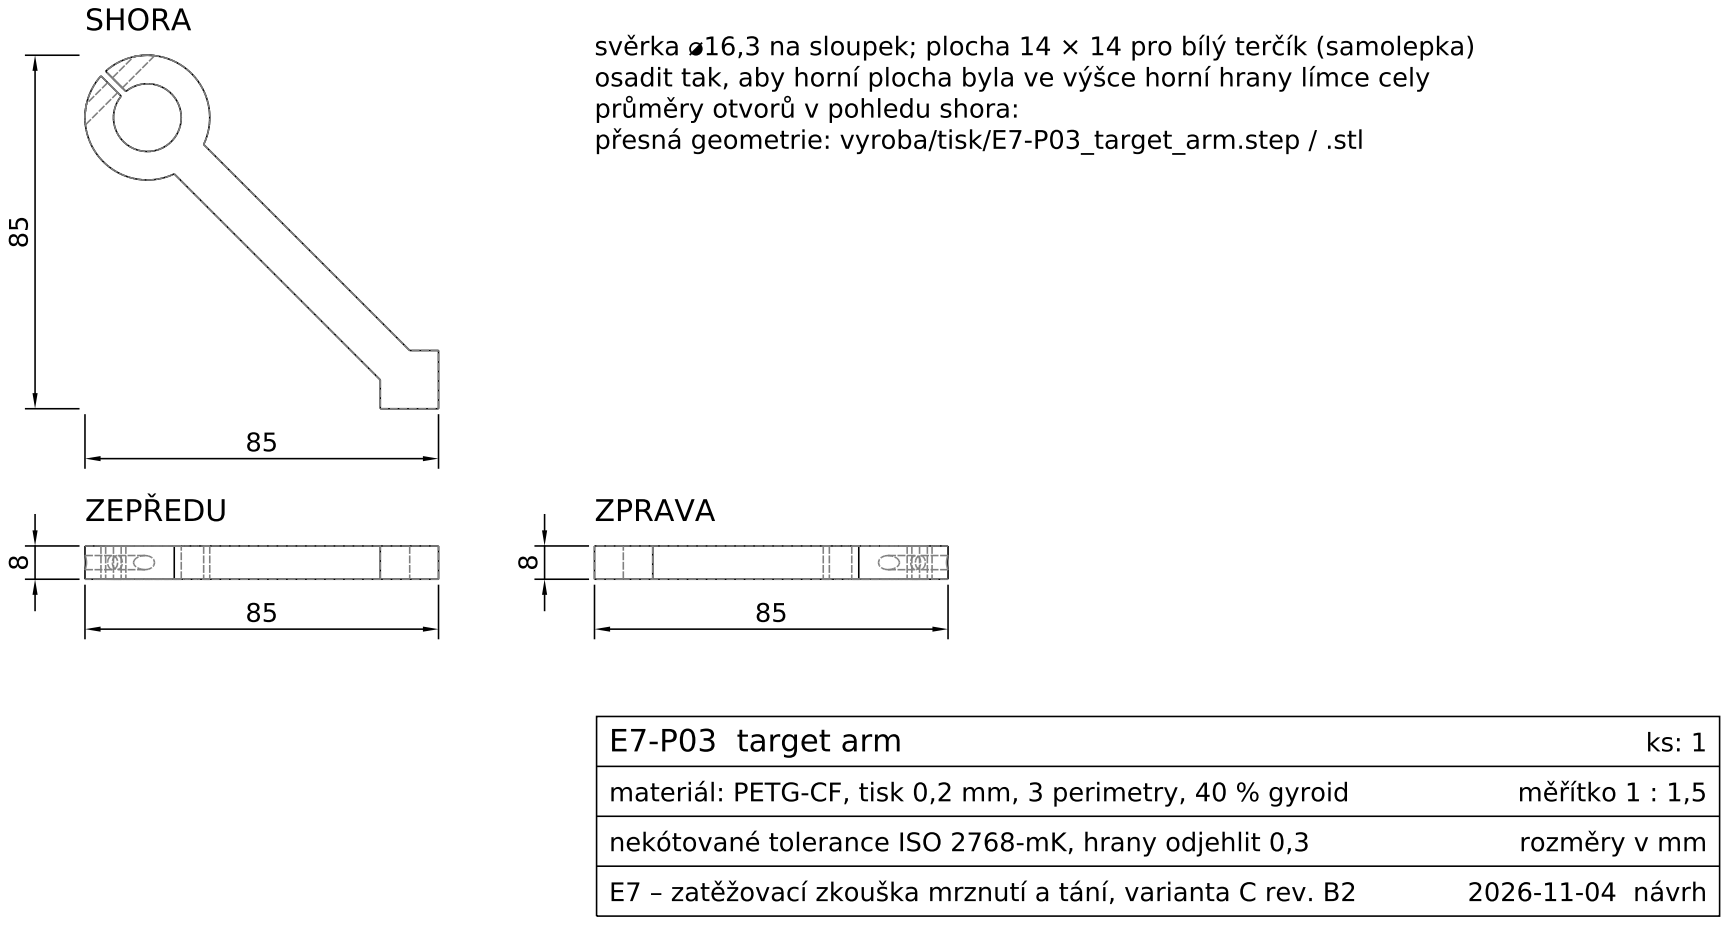
[picture p220: page 14]

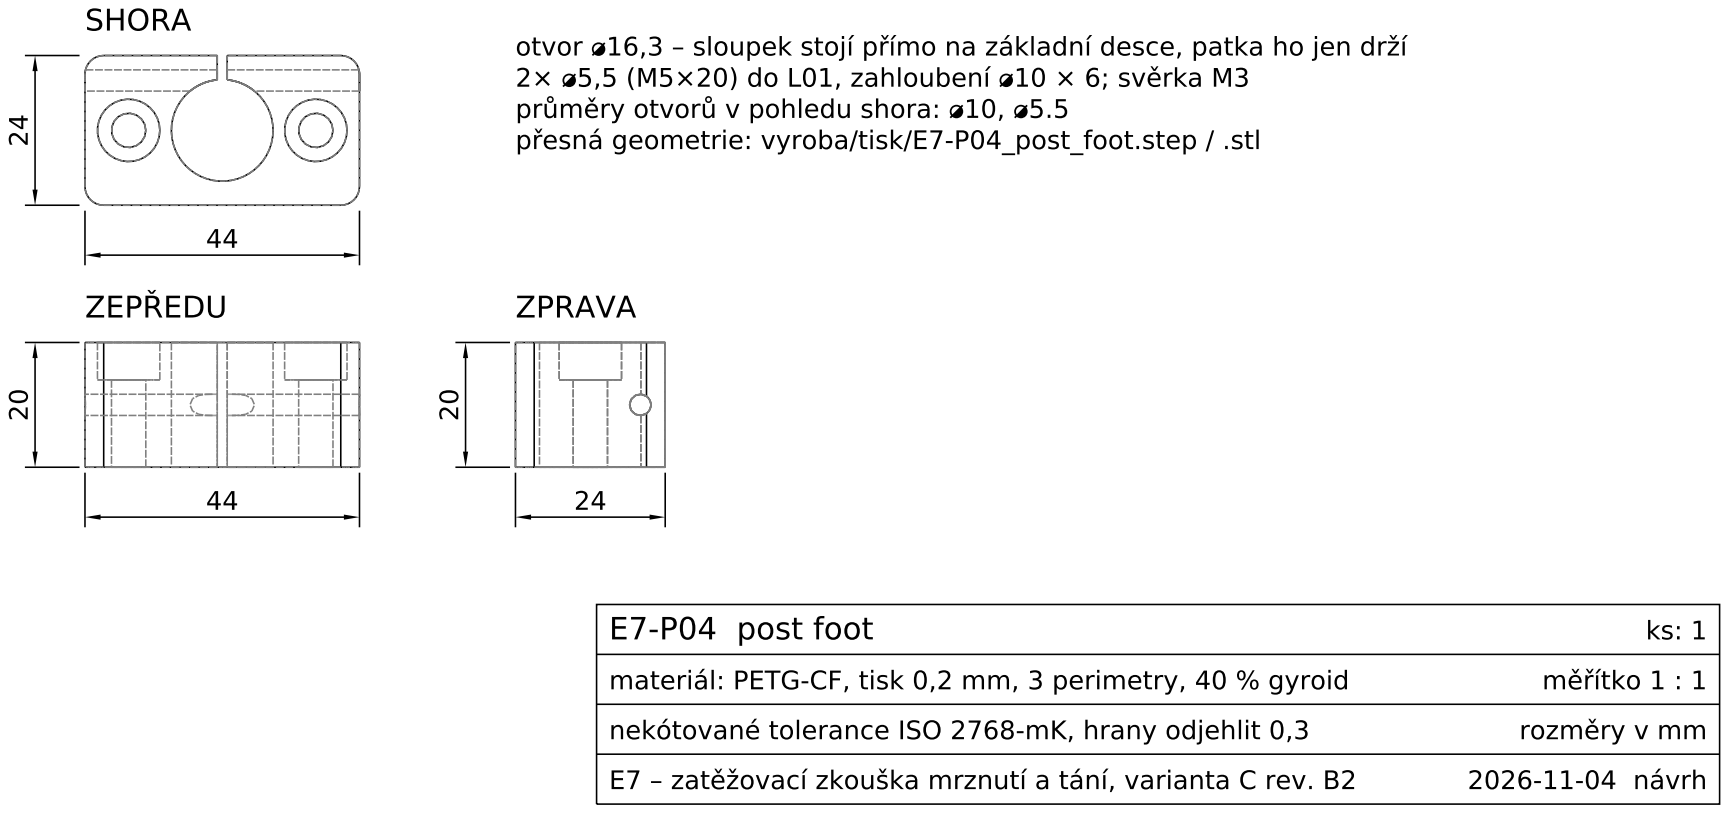
[picture p221: page 15]

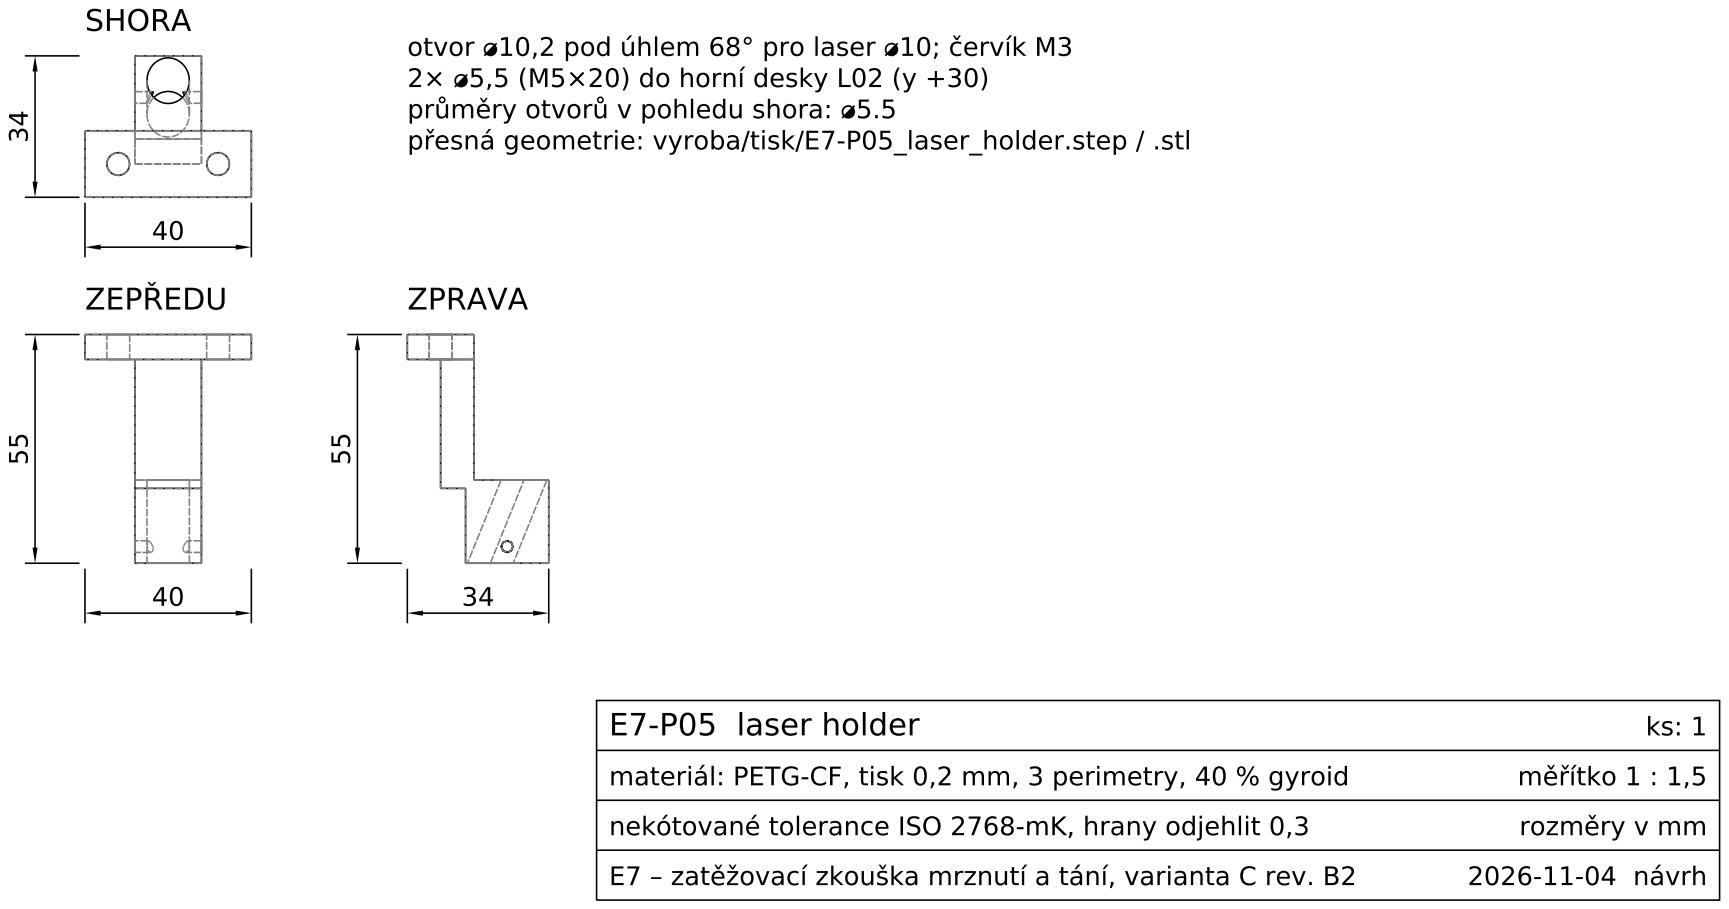
[picture p222: page 16]

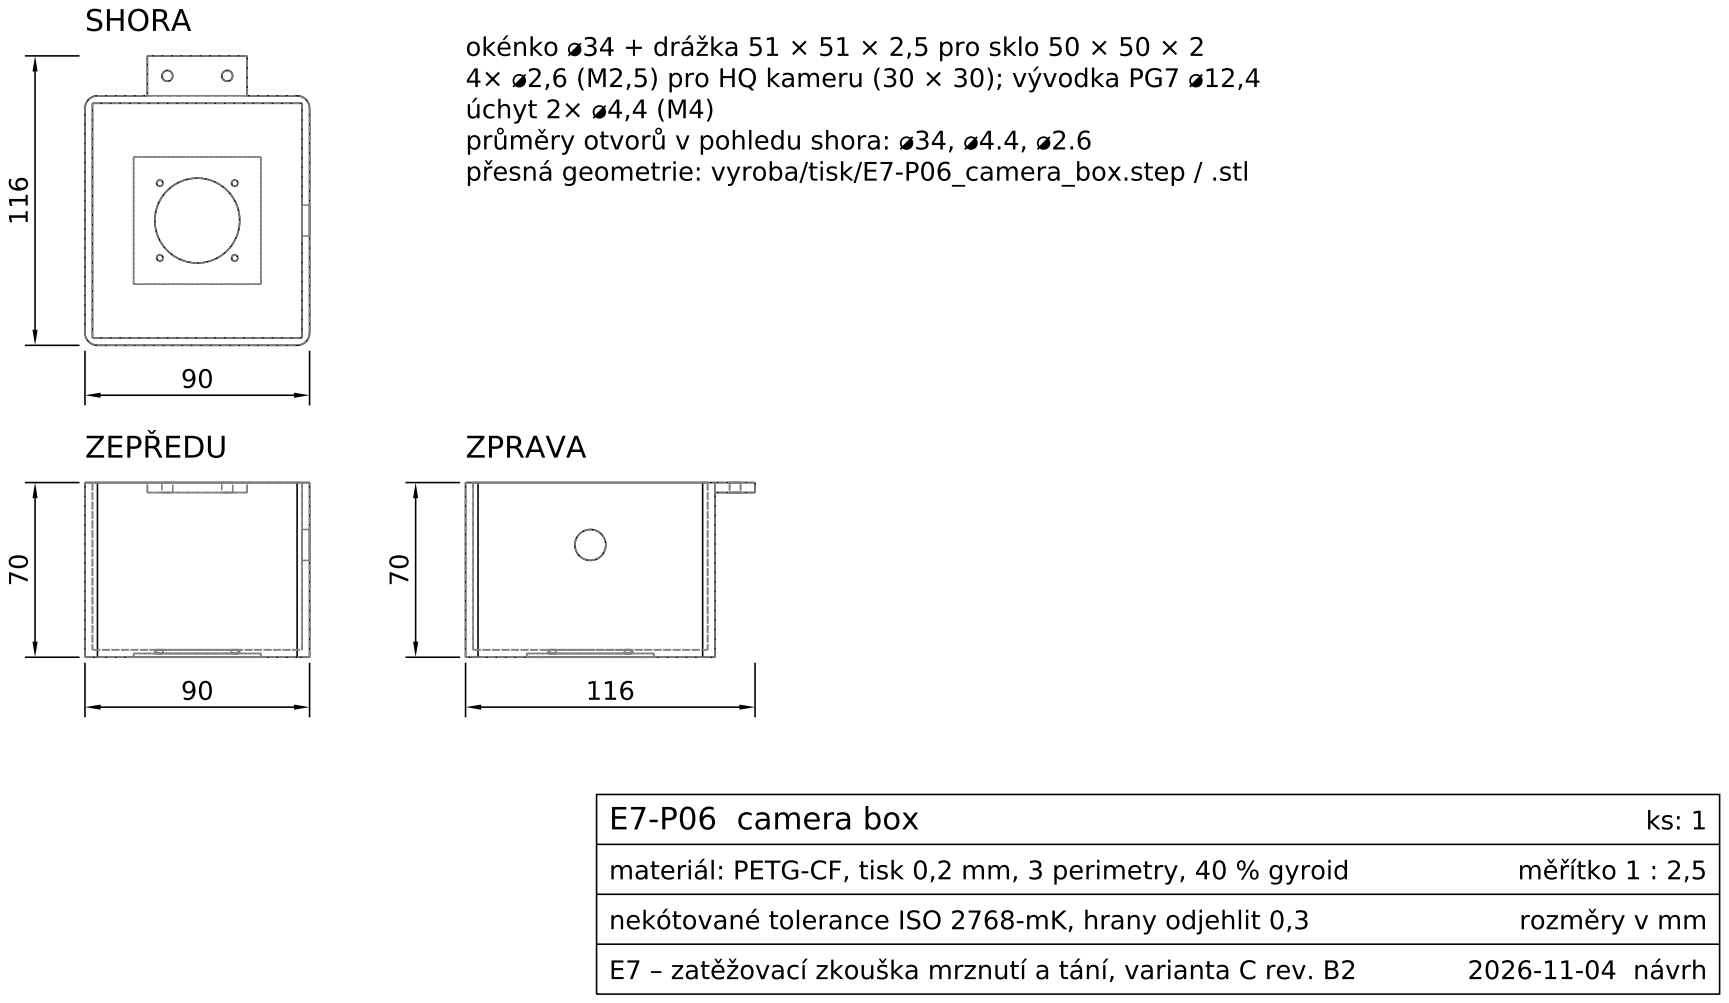
[picture p223: page 17]

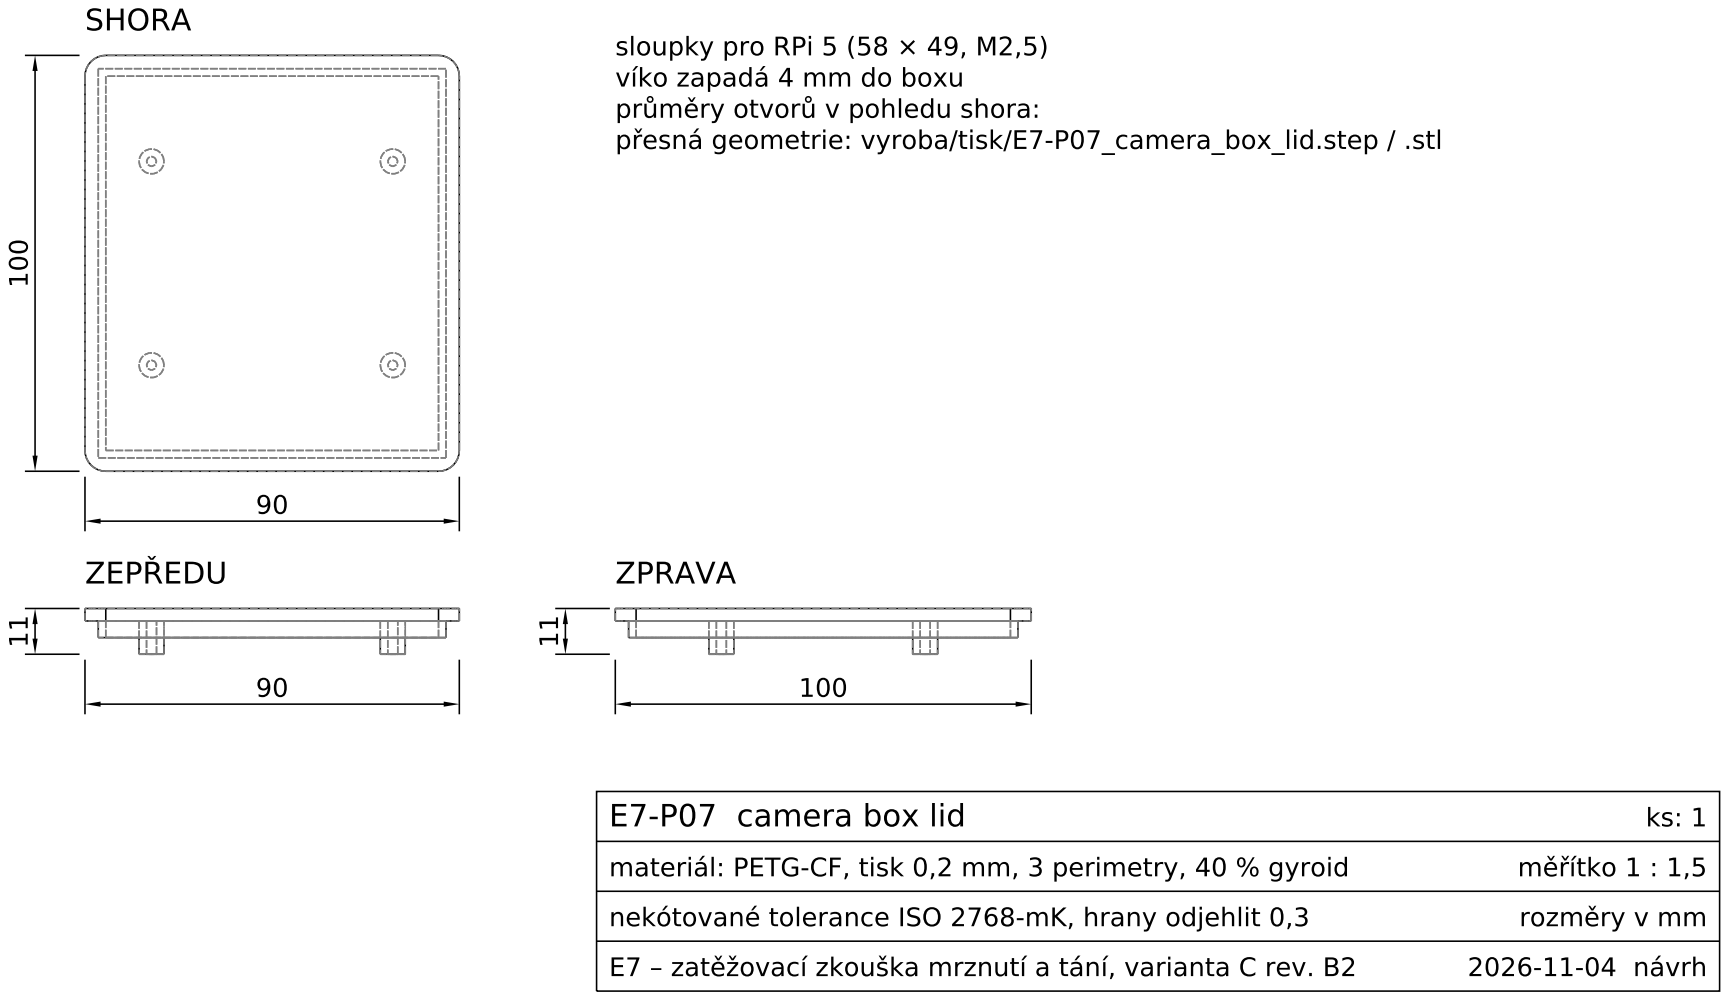
[picture p224: page 18]

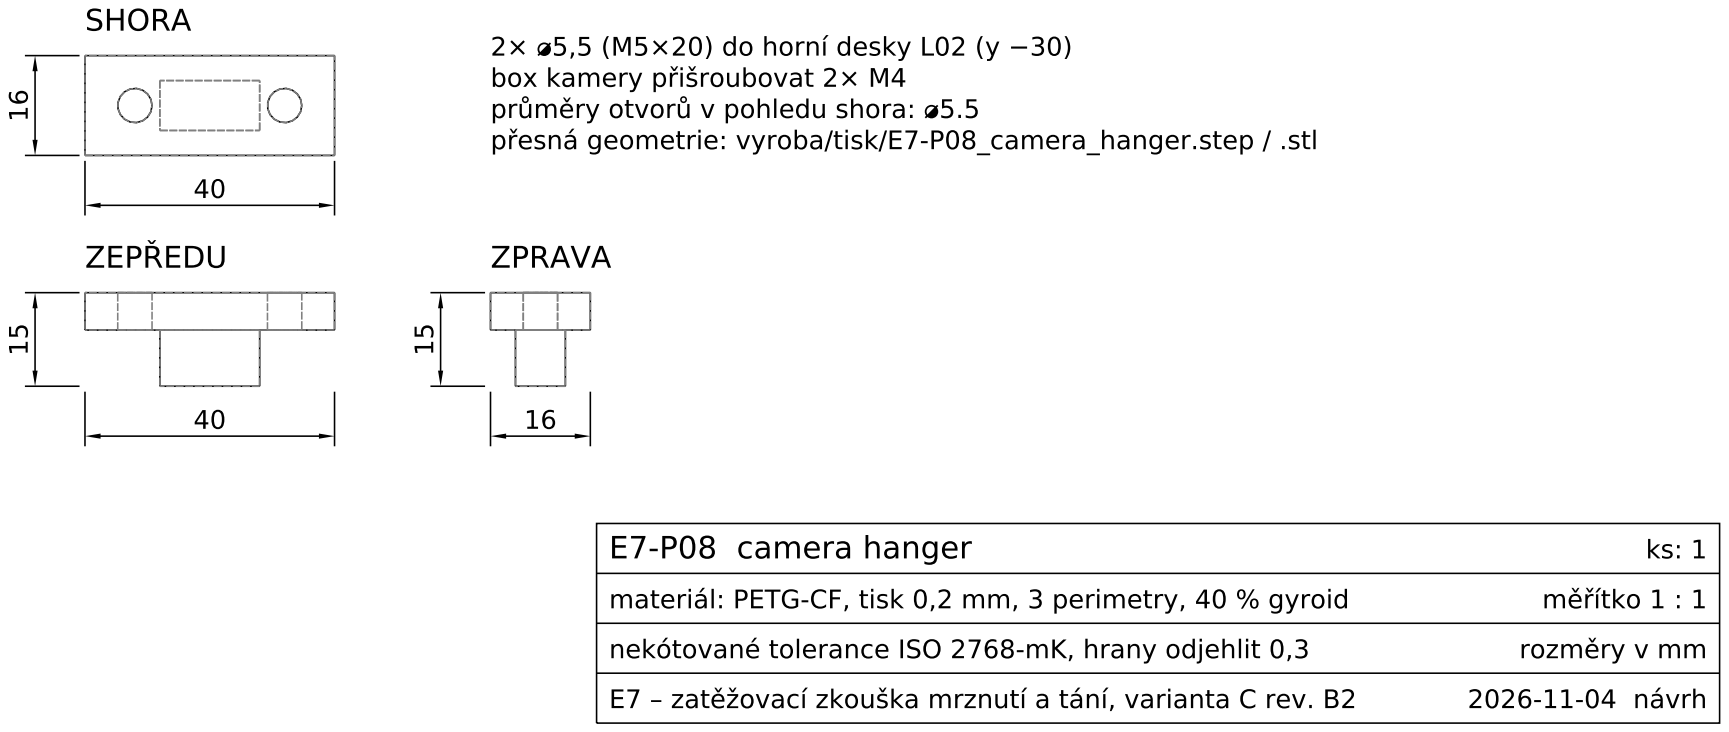
[picture p225: page 19]
