martinasobotkova5/my_data_projects/e7_frost_heave_load/sdileni/vyroba/vykresy/E7_vyrobni_vykresy.pdf

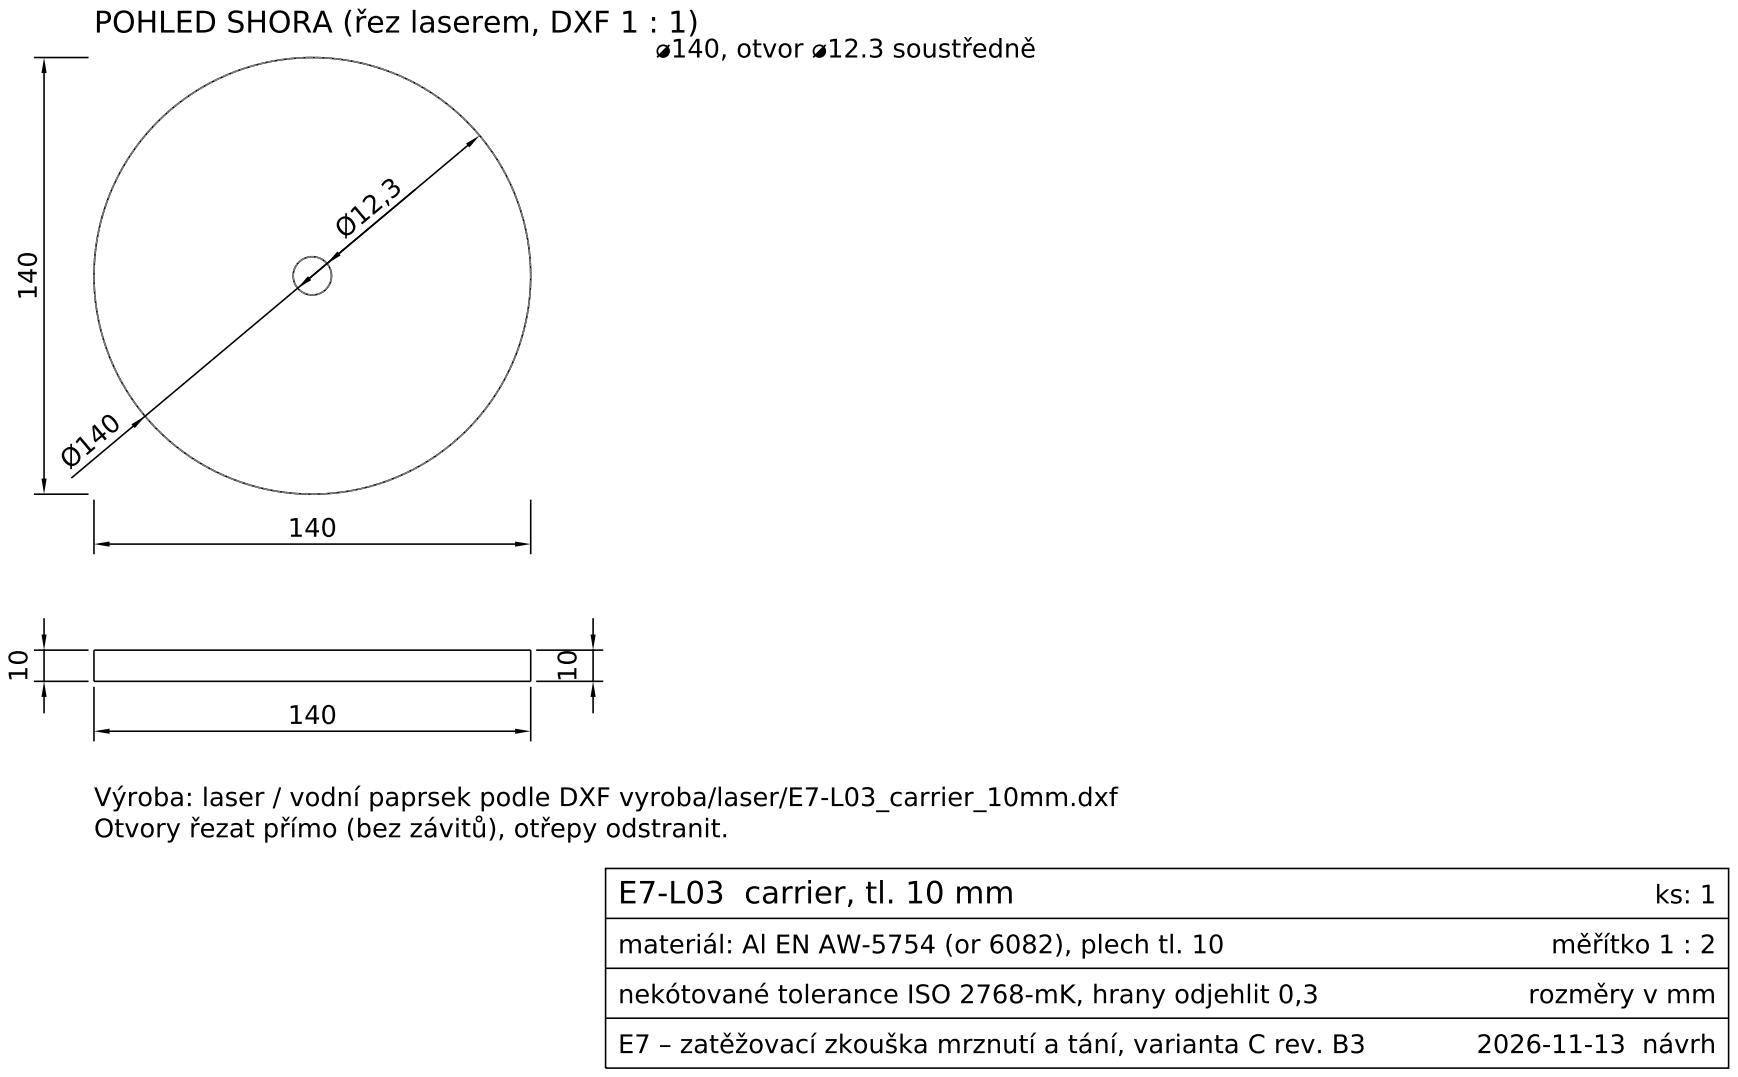
[picture p226: page 1]

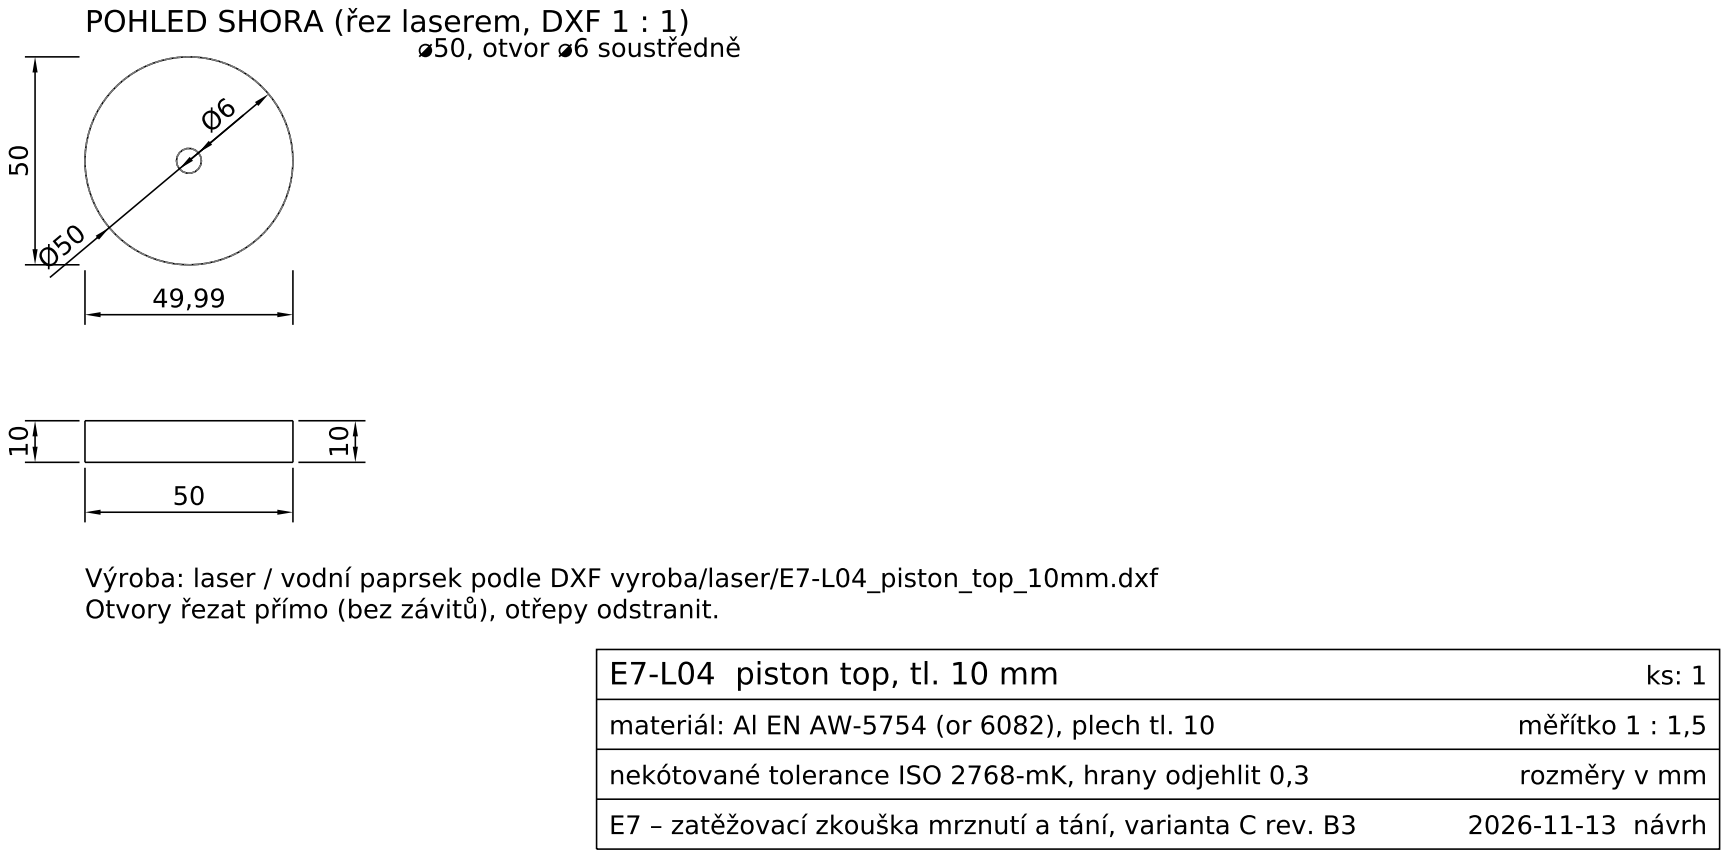
[picture p227: page 2]

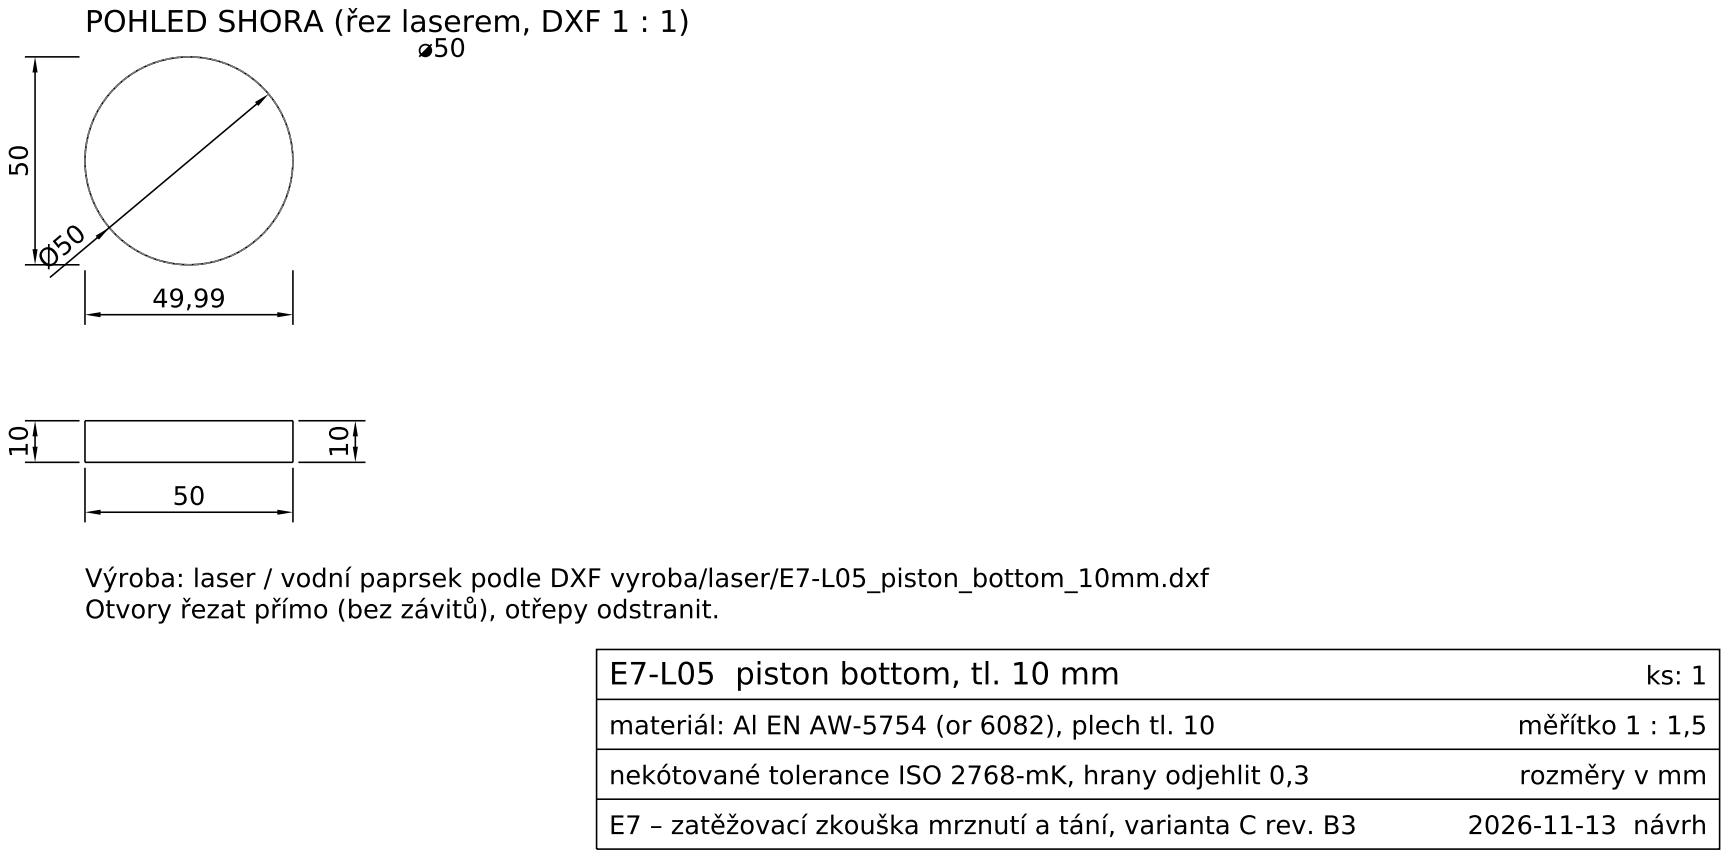
[picture p228: page 3]

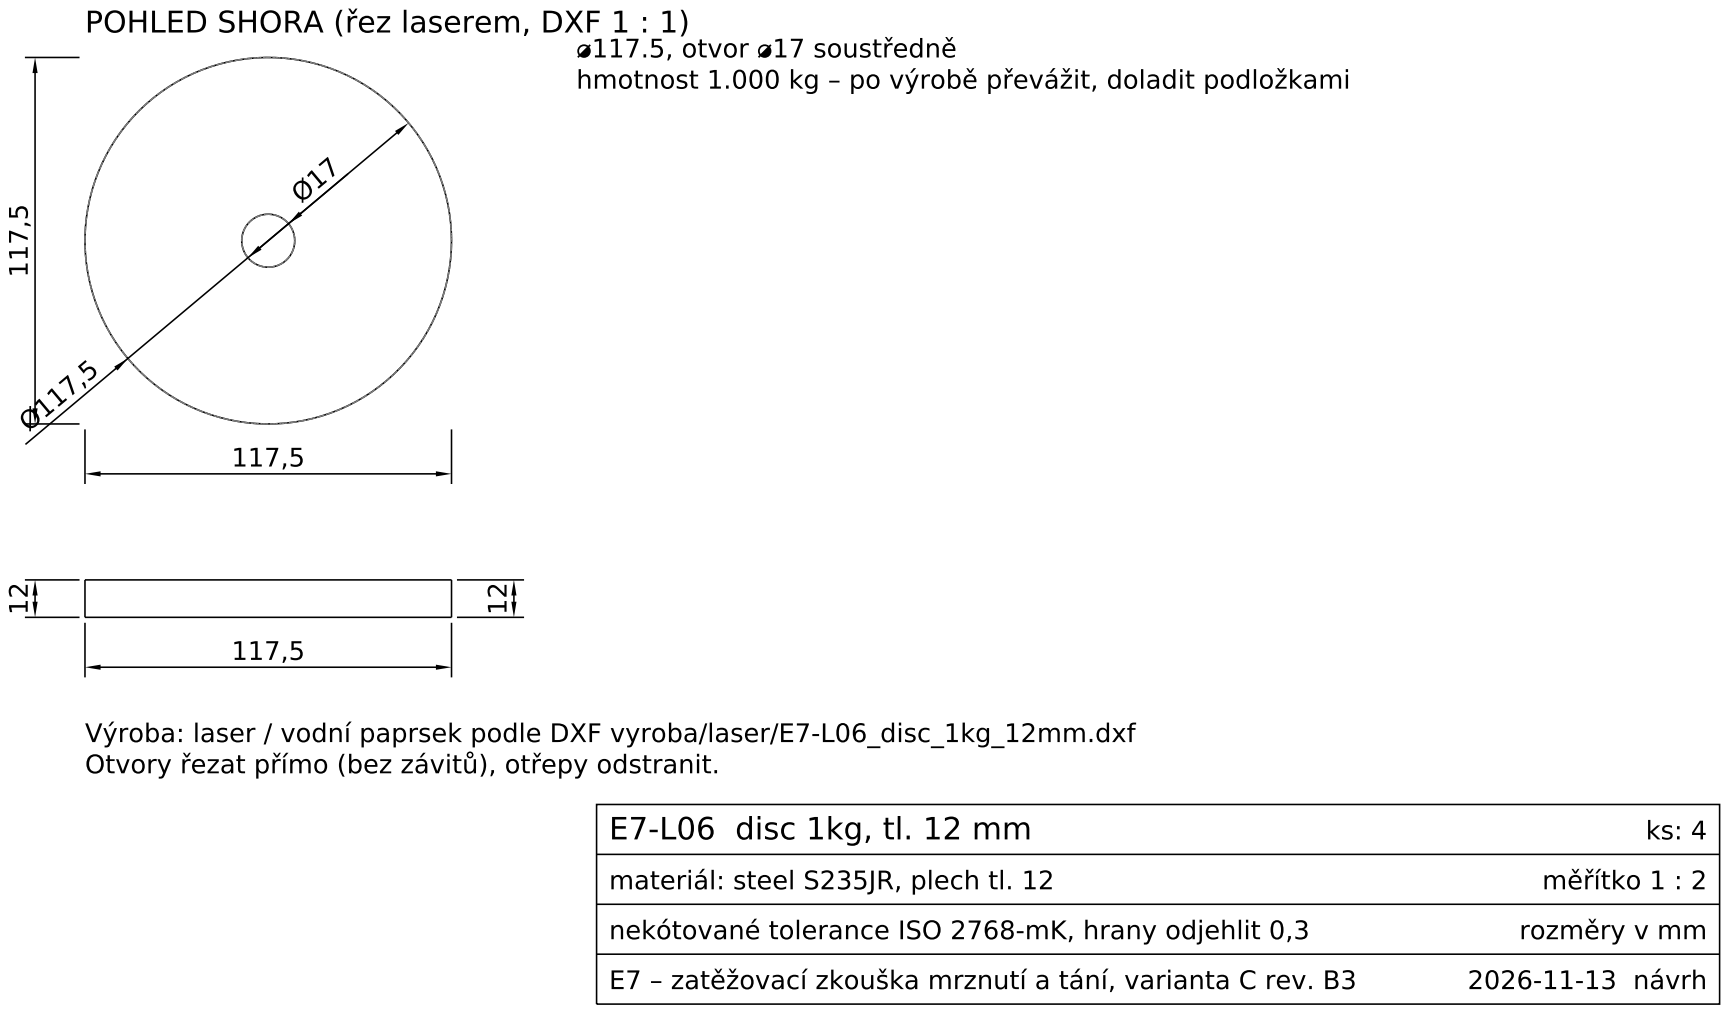
[picture p229: page 4]

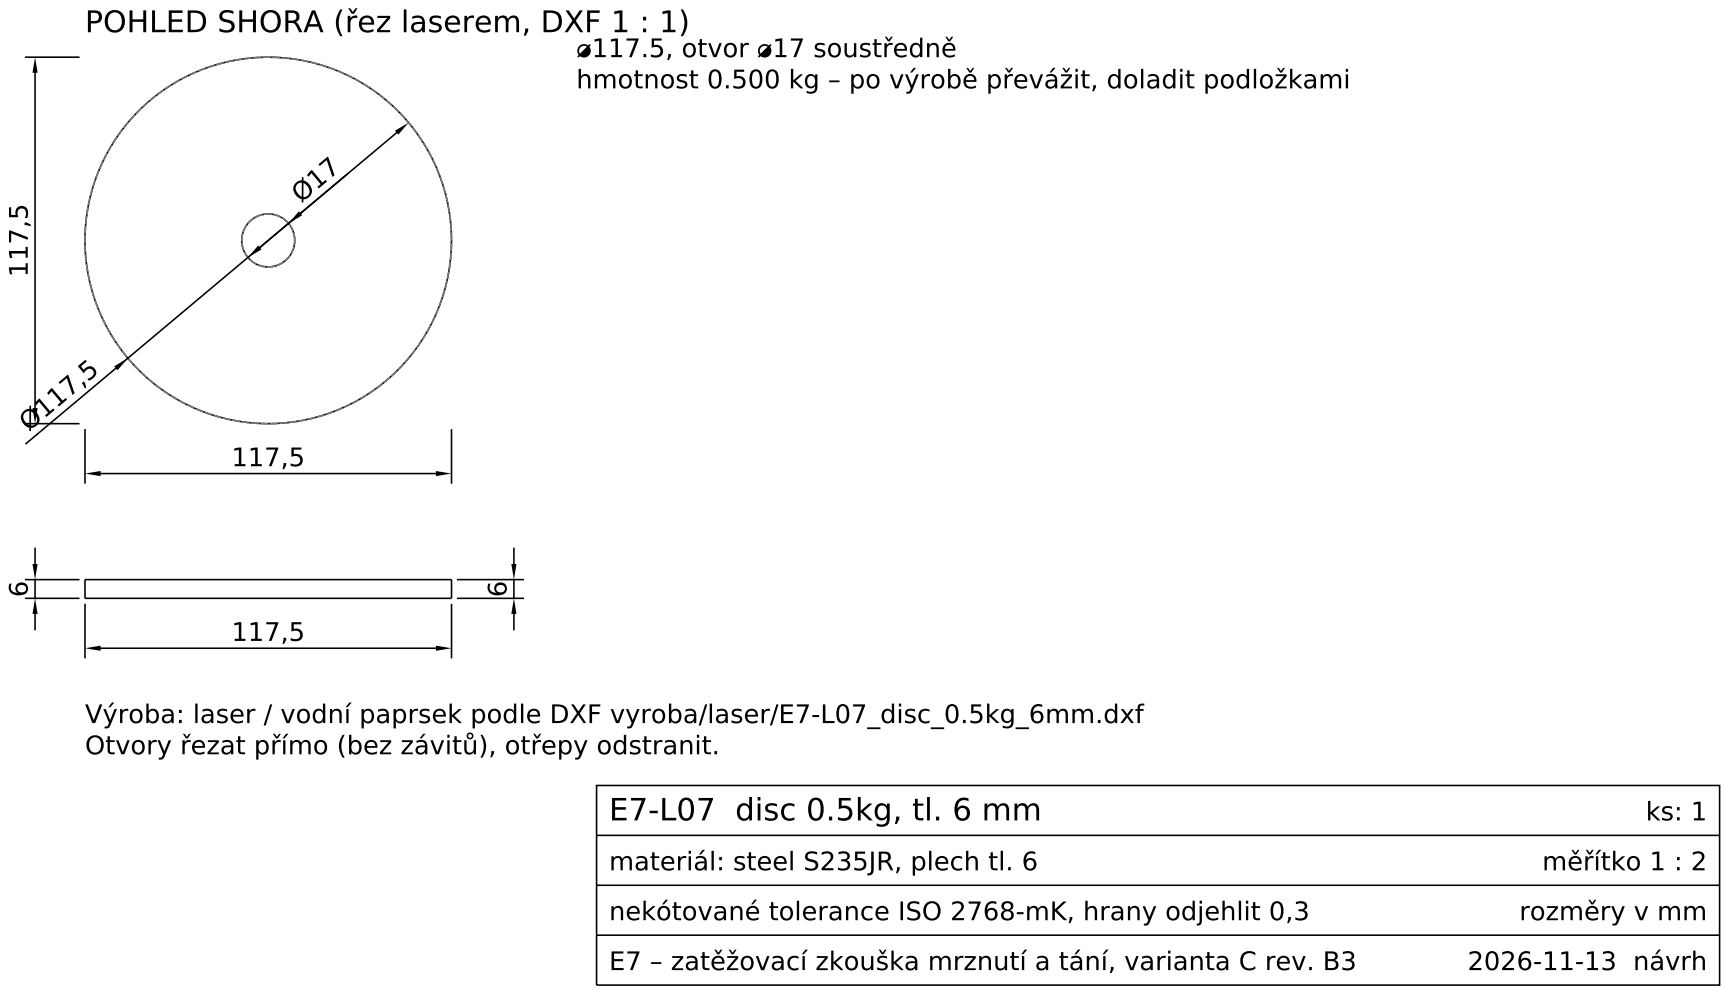
[picture p230: page 5]

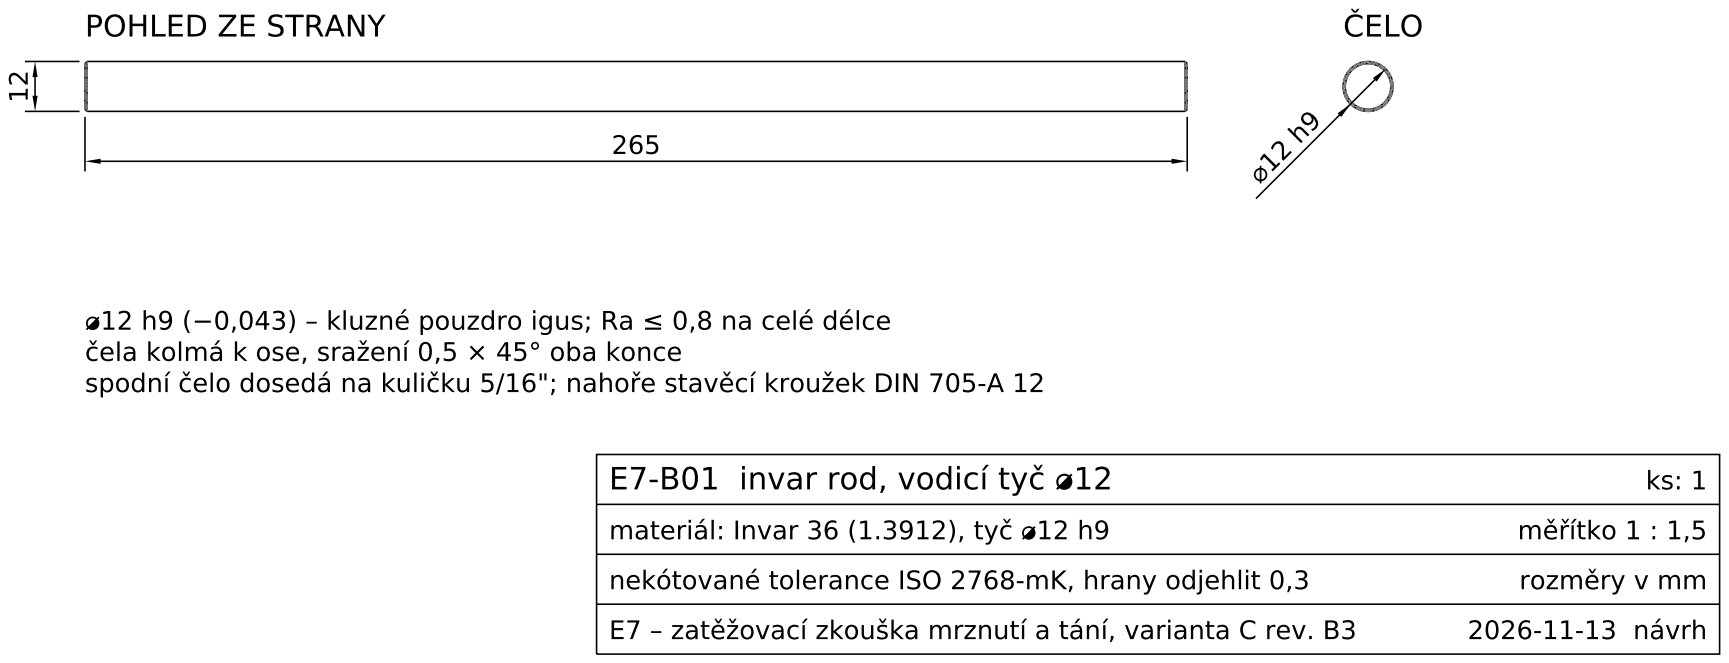
[picture p231: page 6]

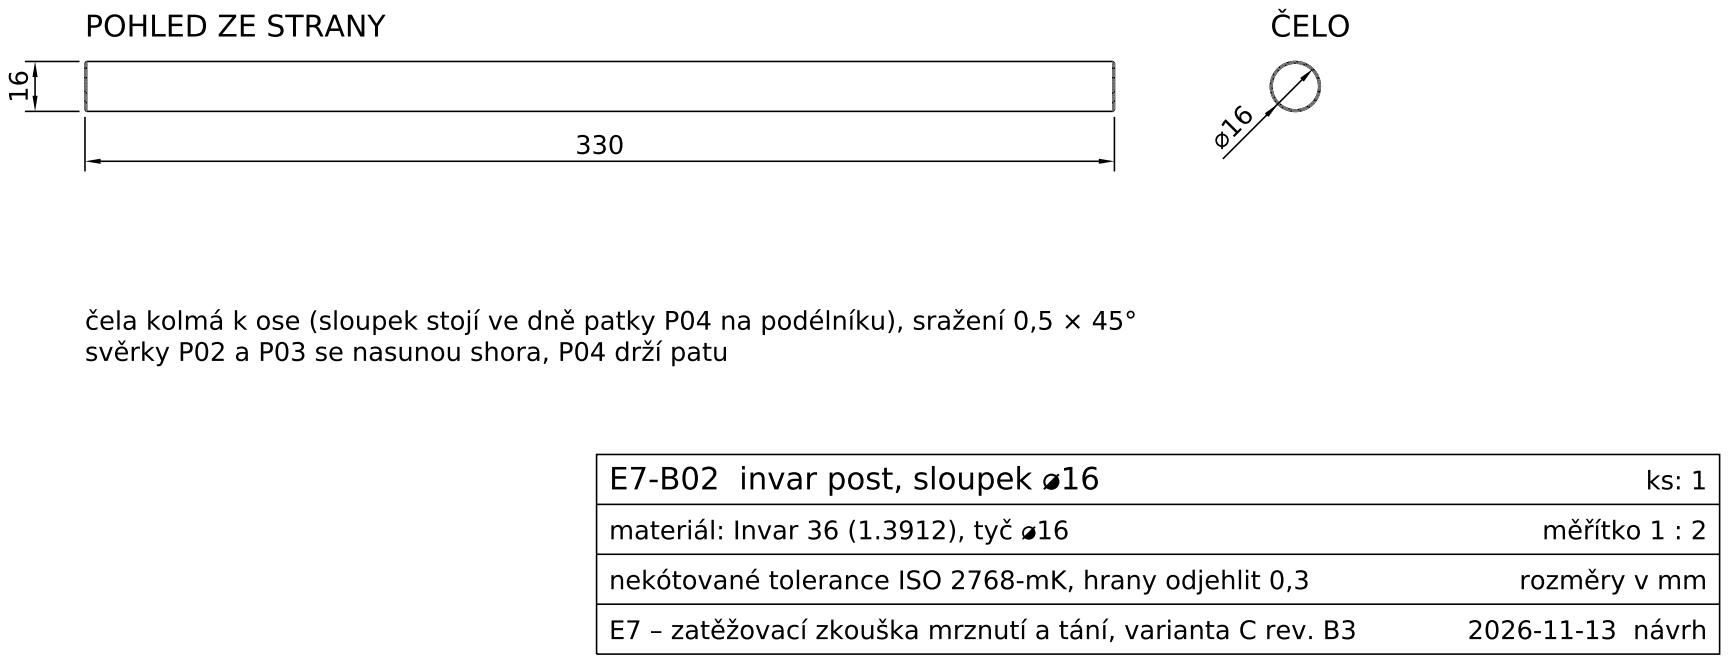
[picture p232: page 7]

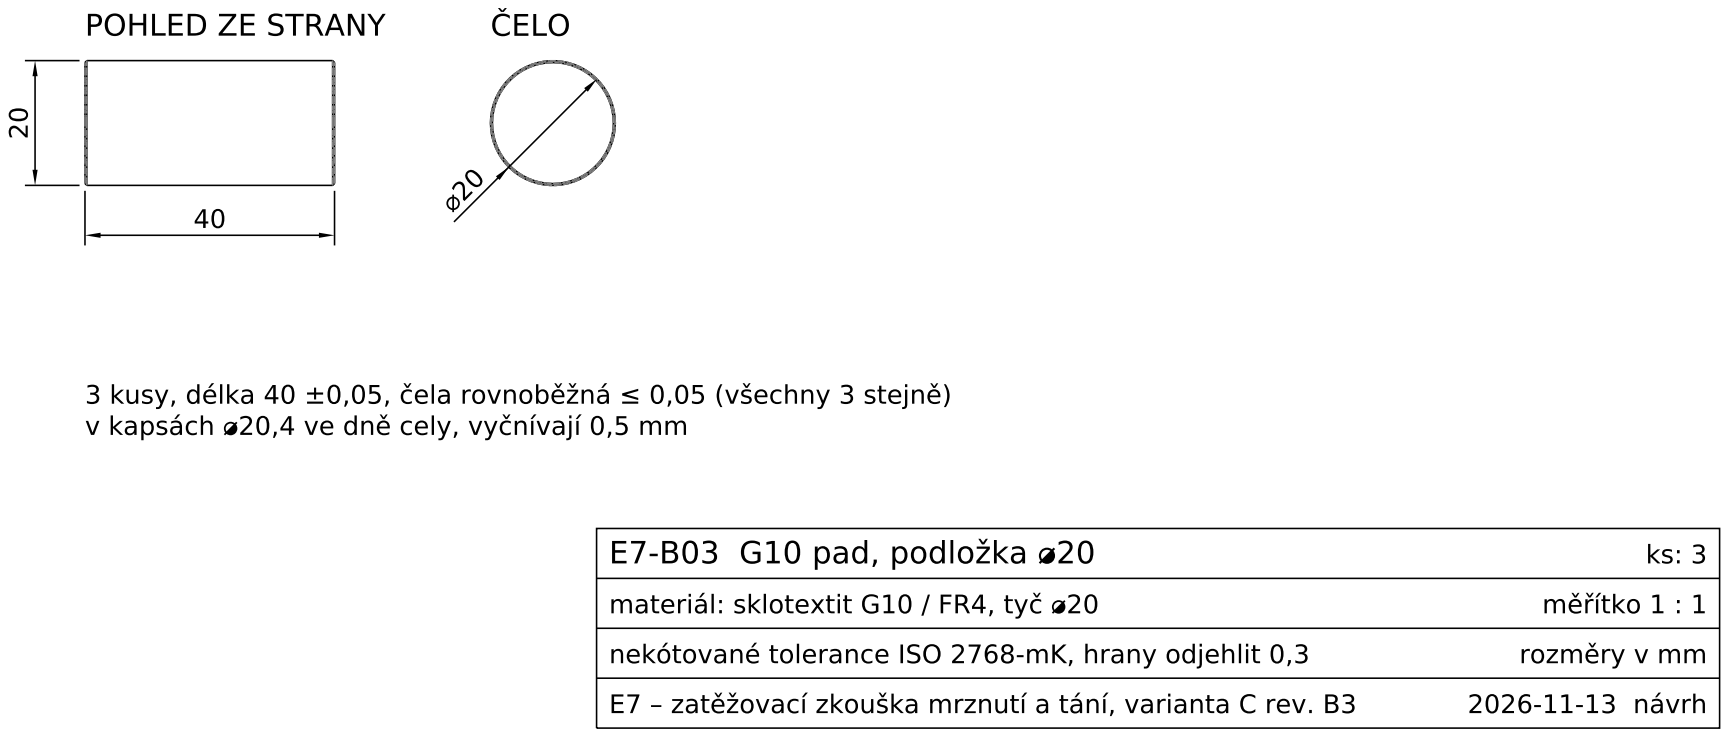
[picture p233: page 8]

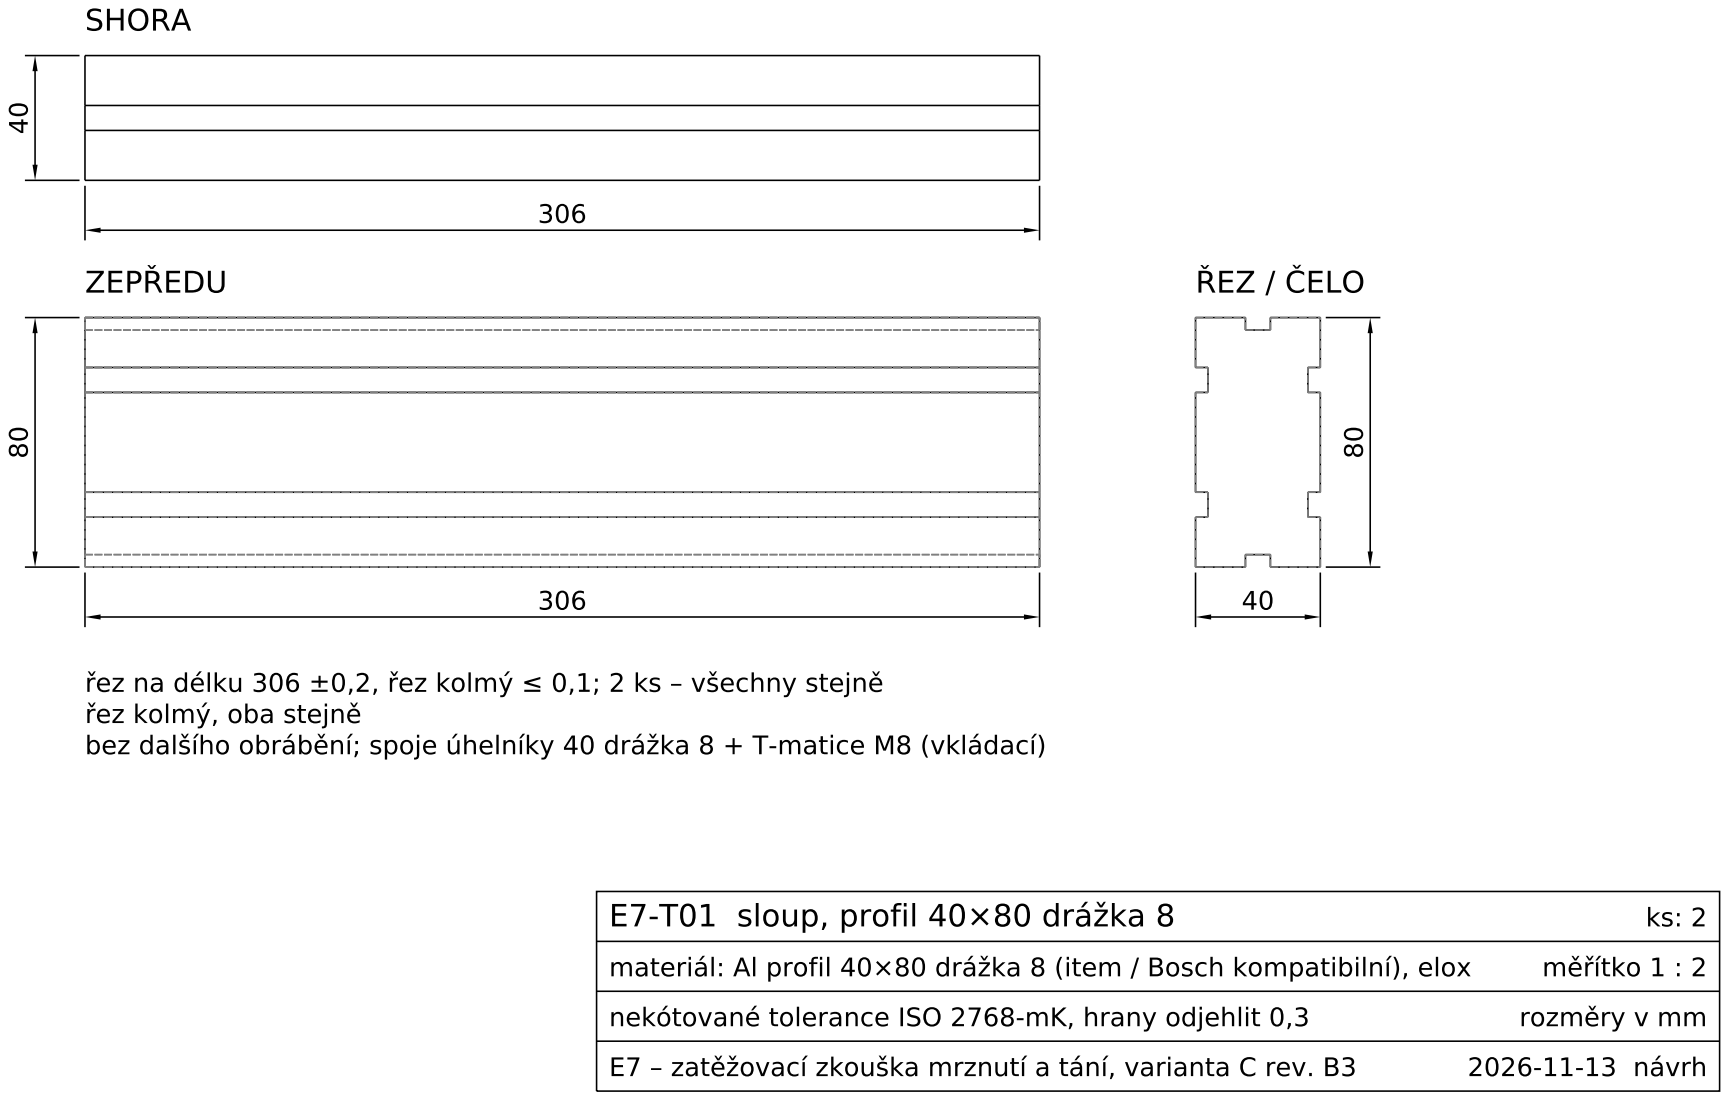
[picture p234: page 9]

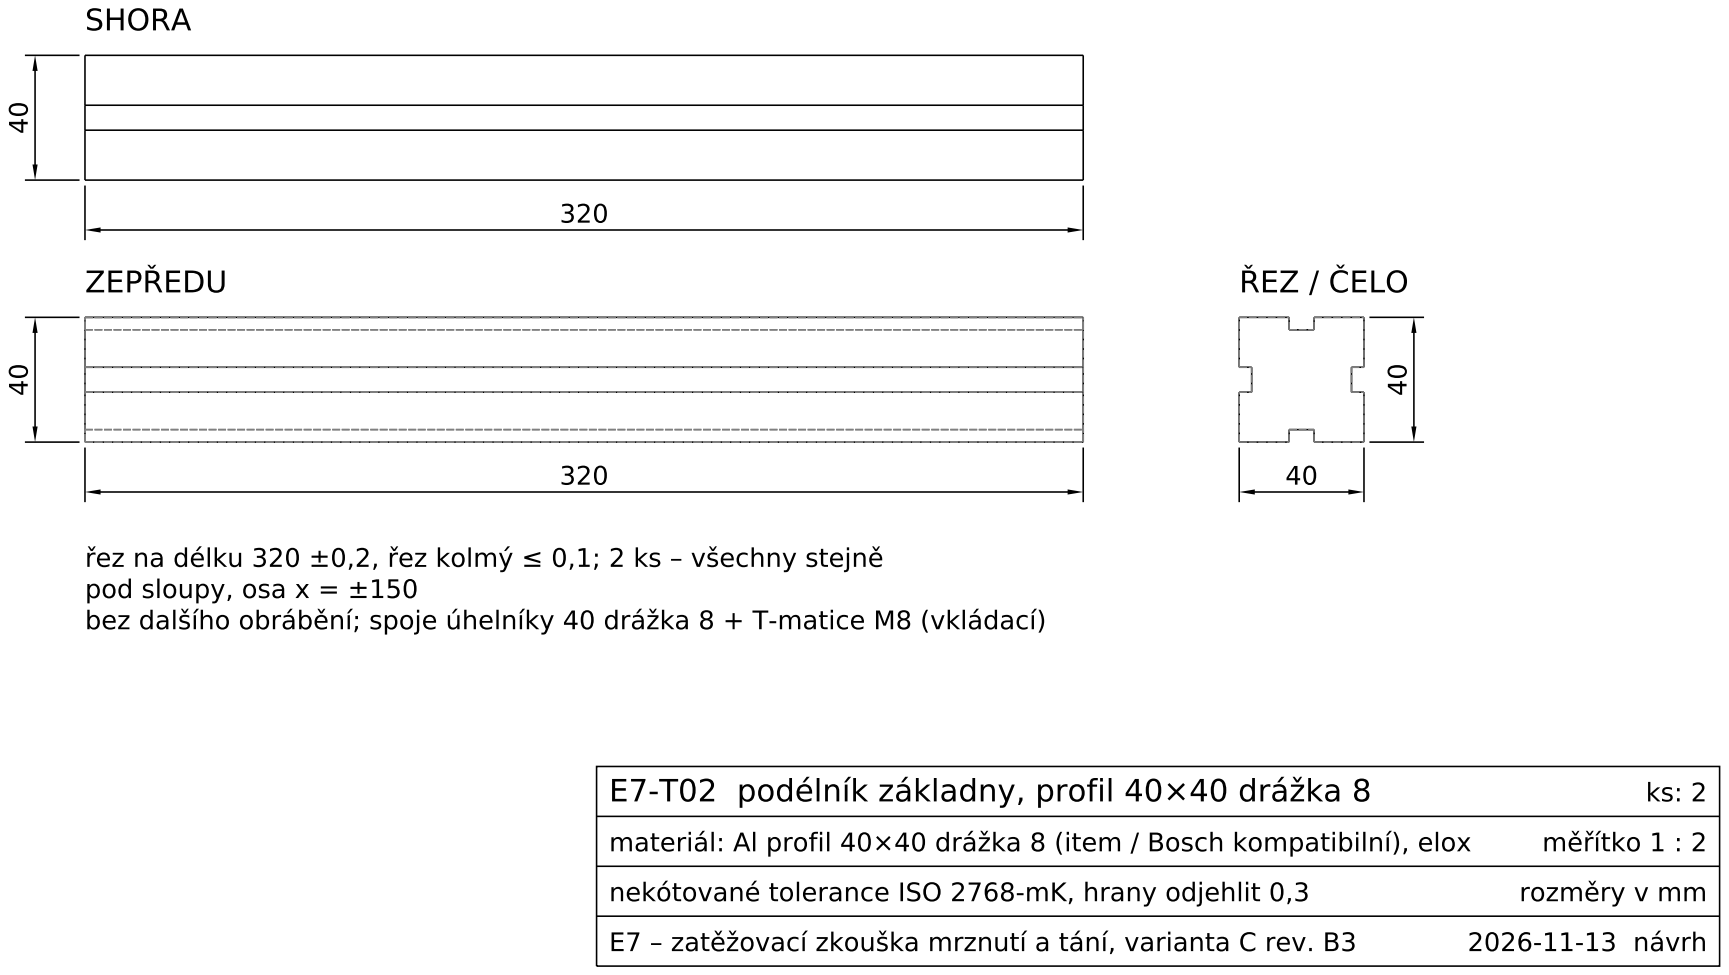
[picture p235: page 10]

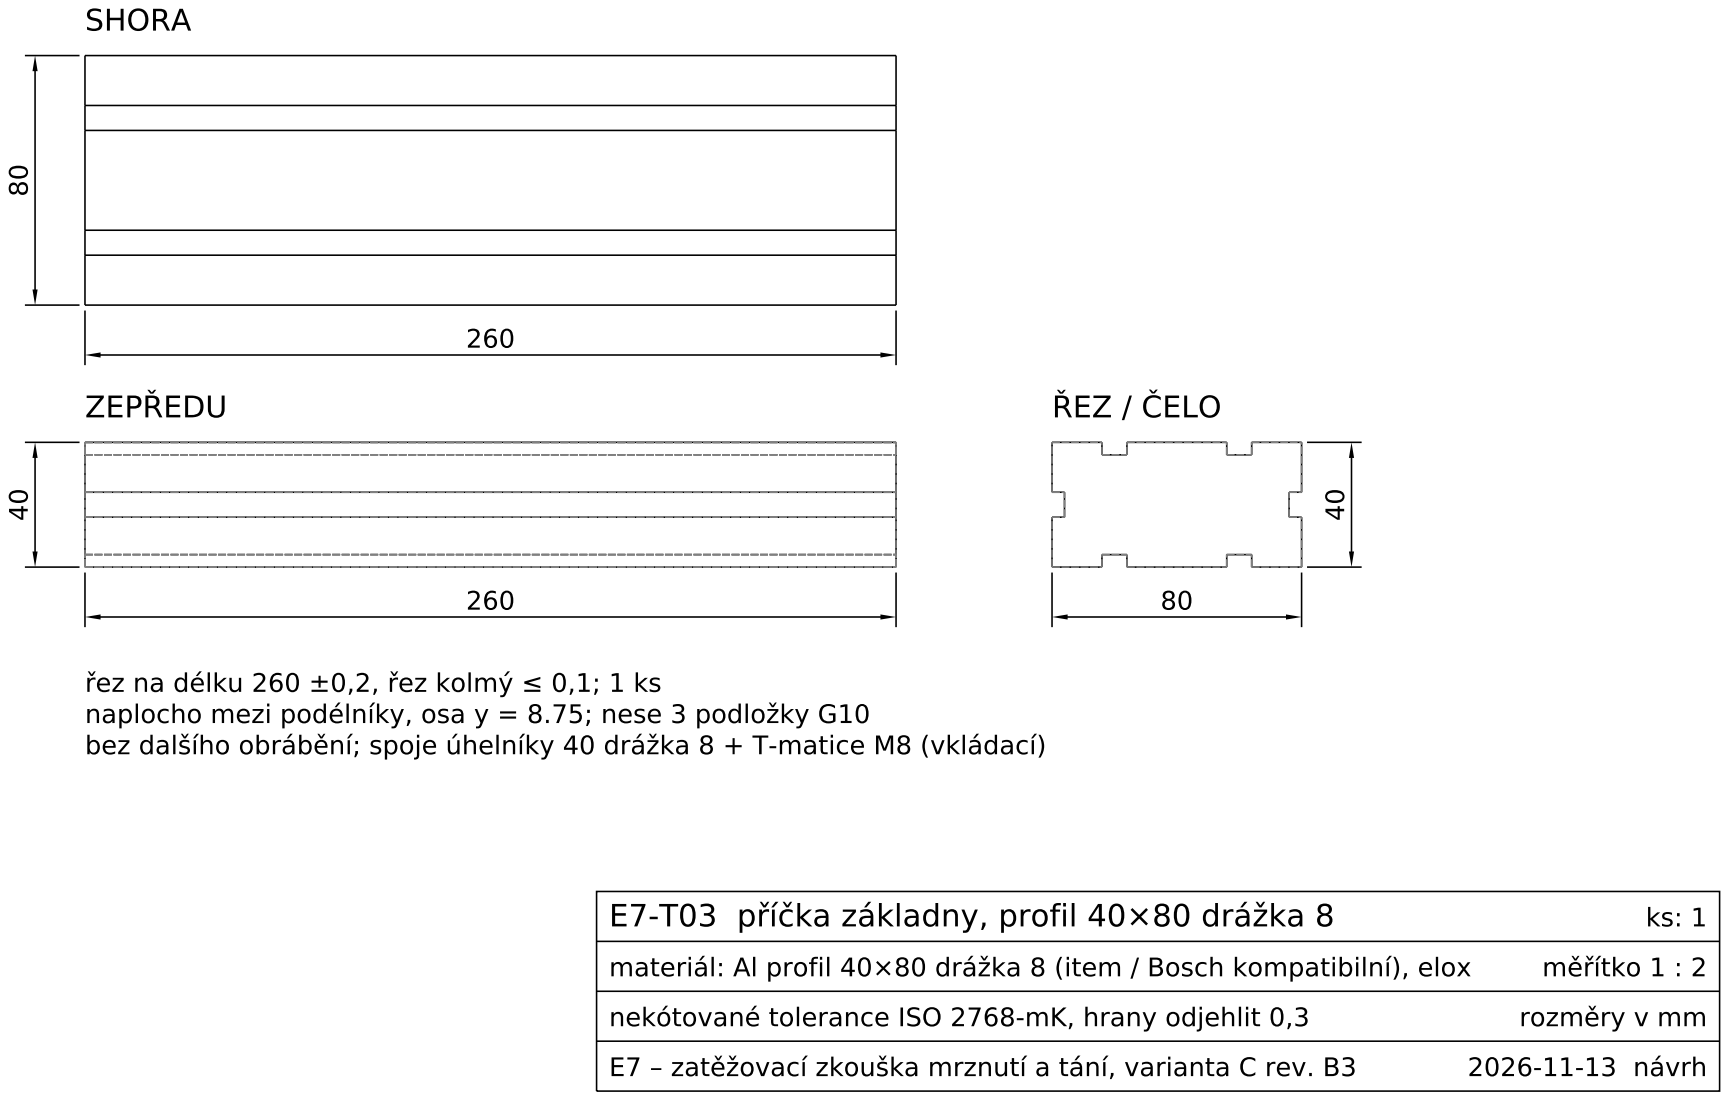
[picture p236: page 11]

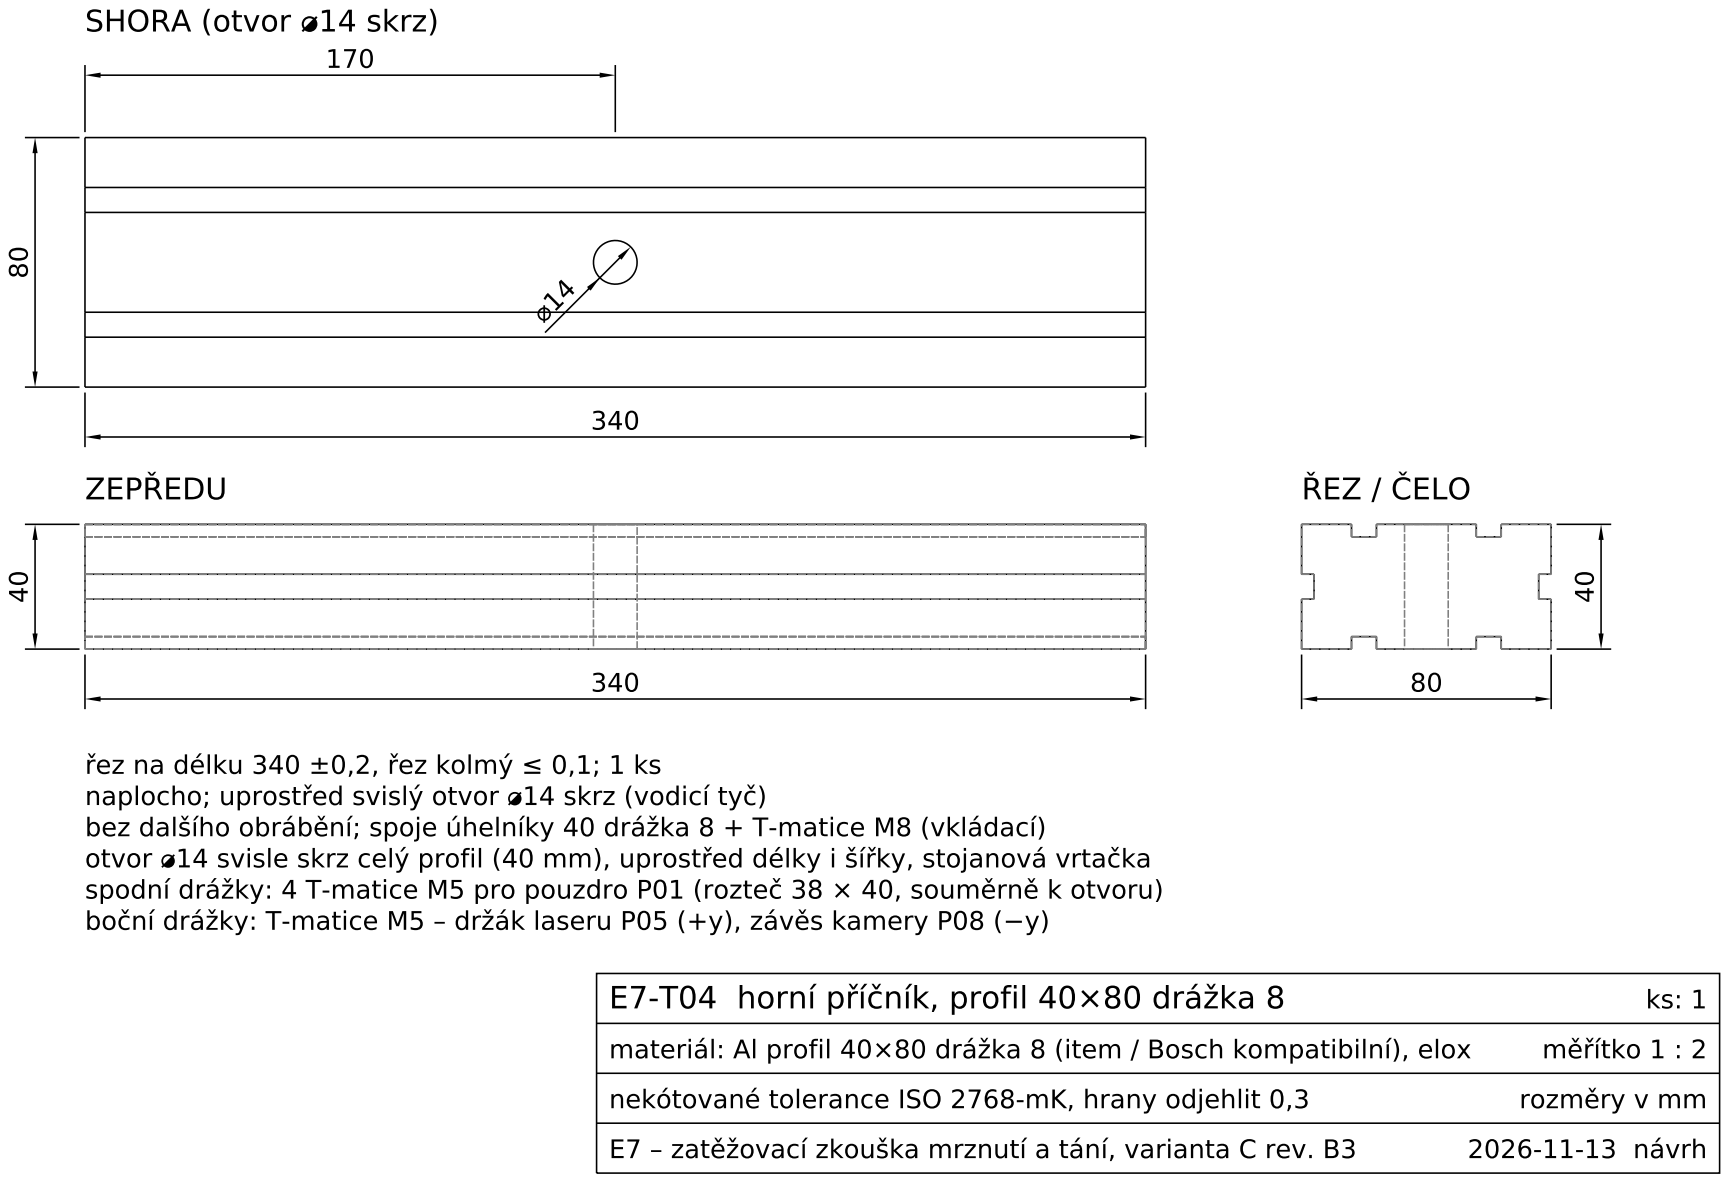
[picture p237: page 12]

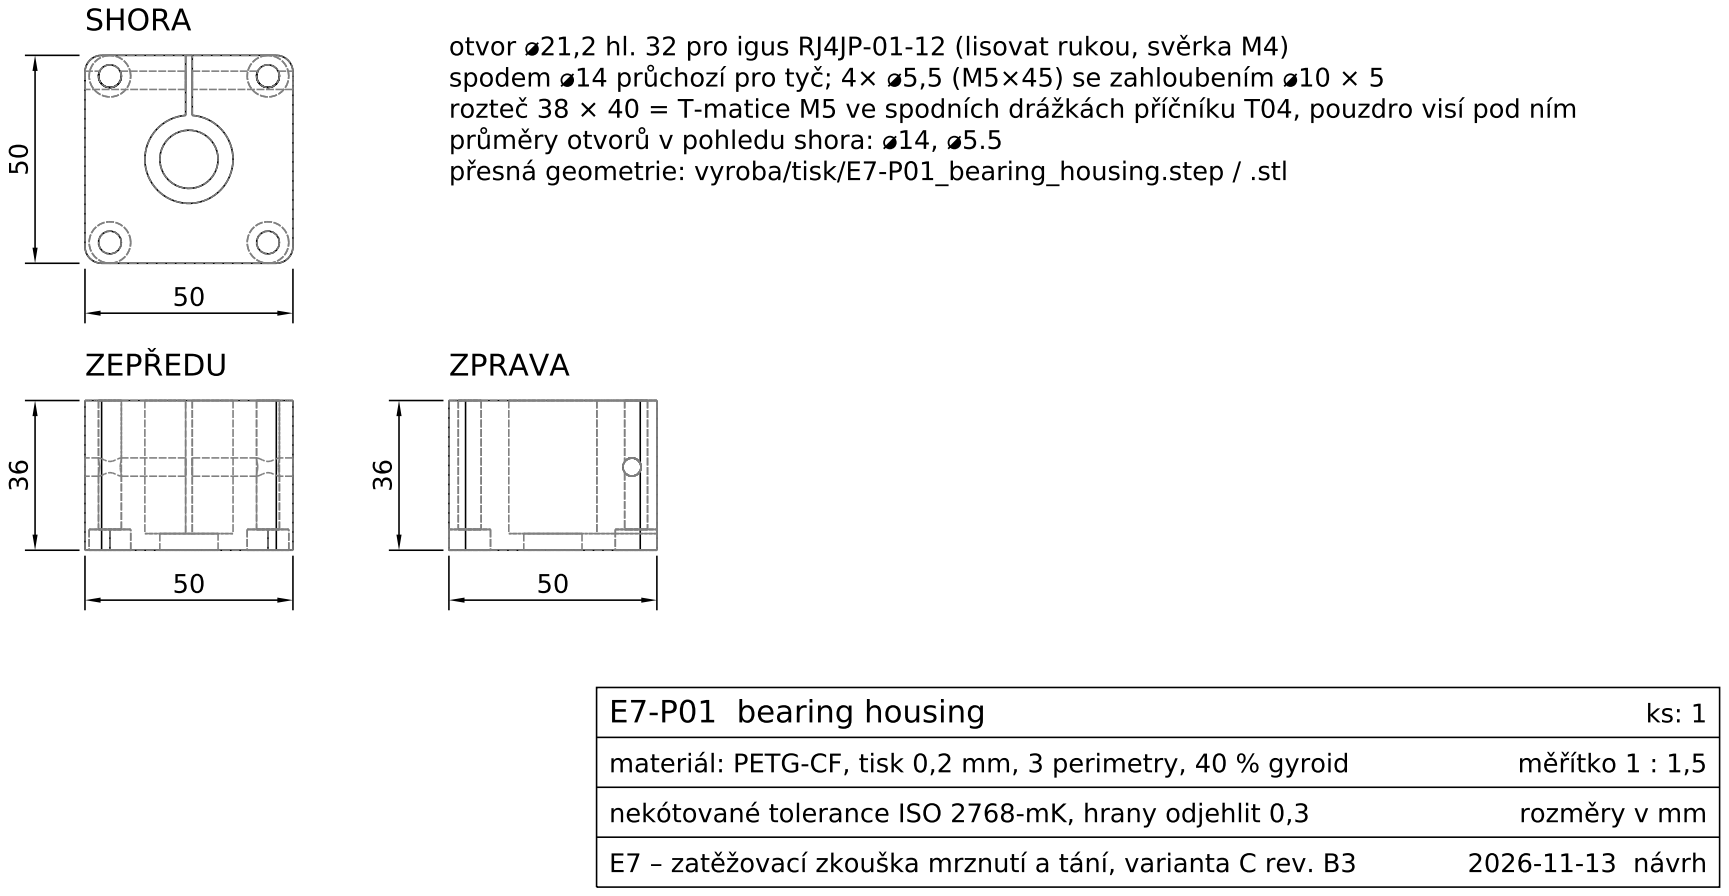
[picture p238: page 13]

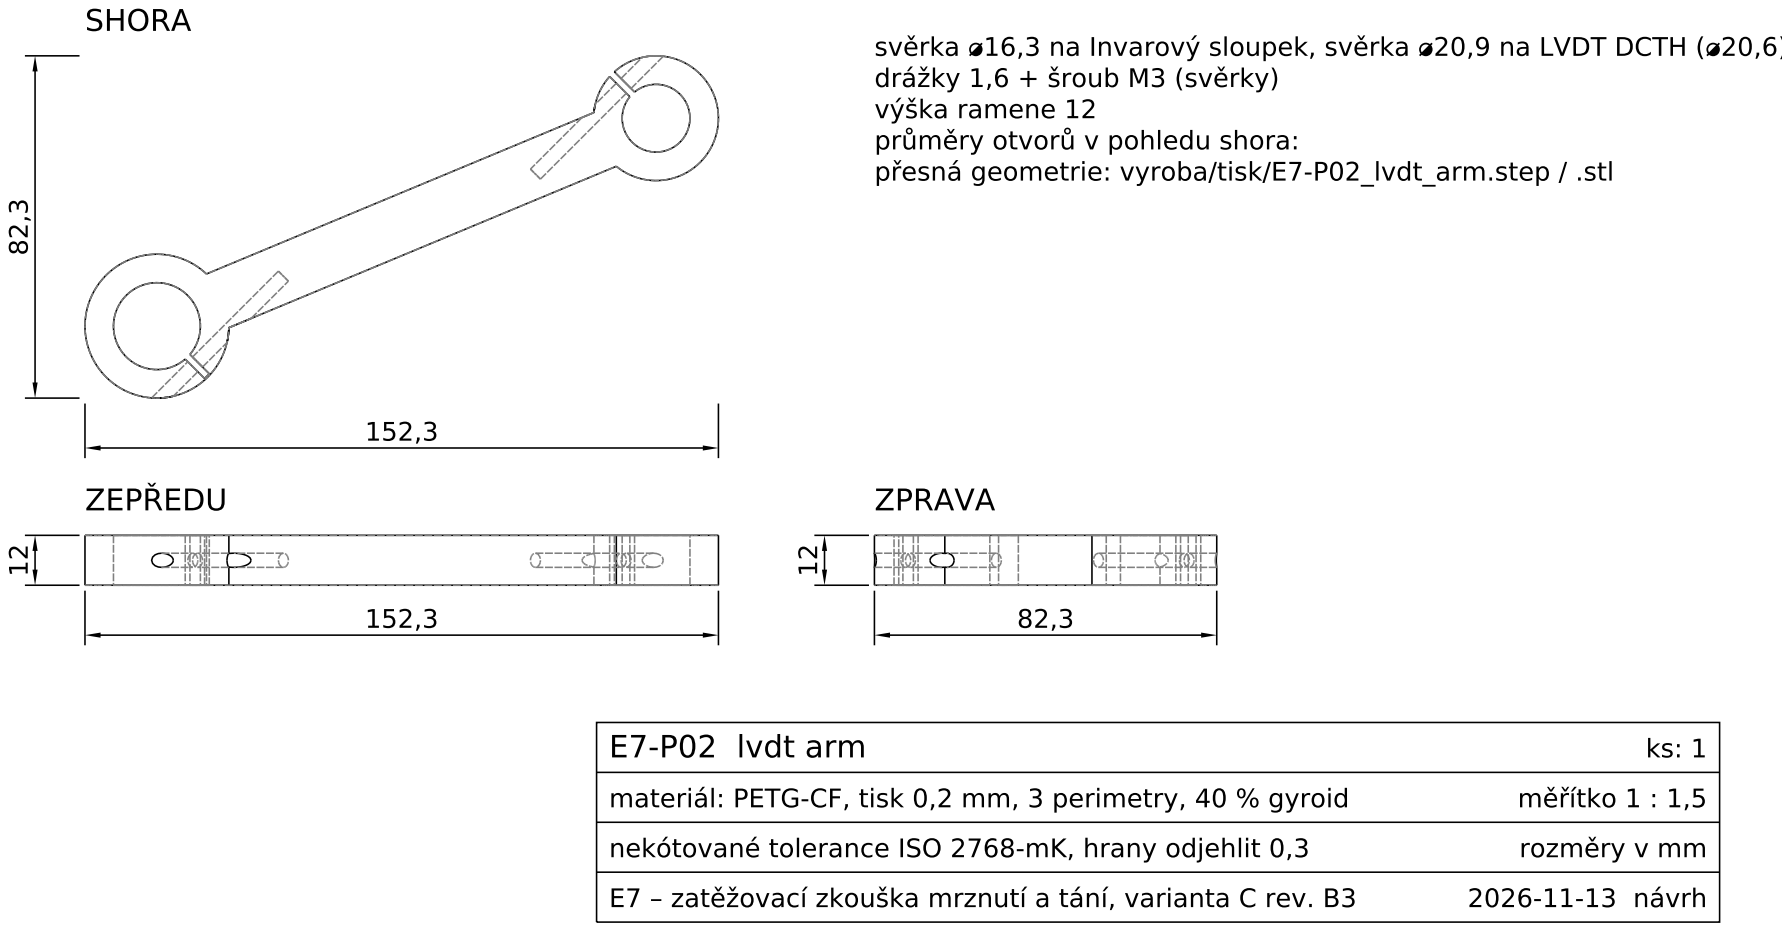
[picture p239: page 14]

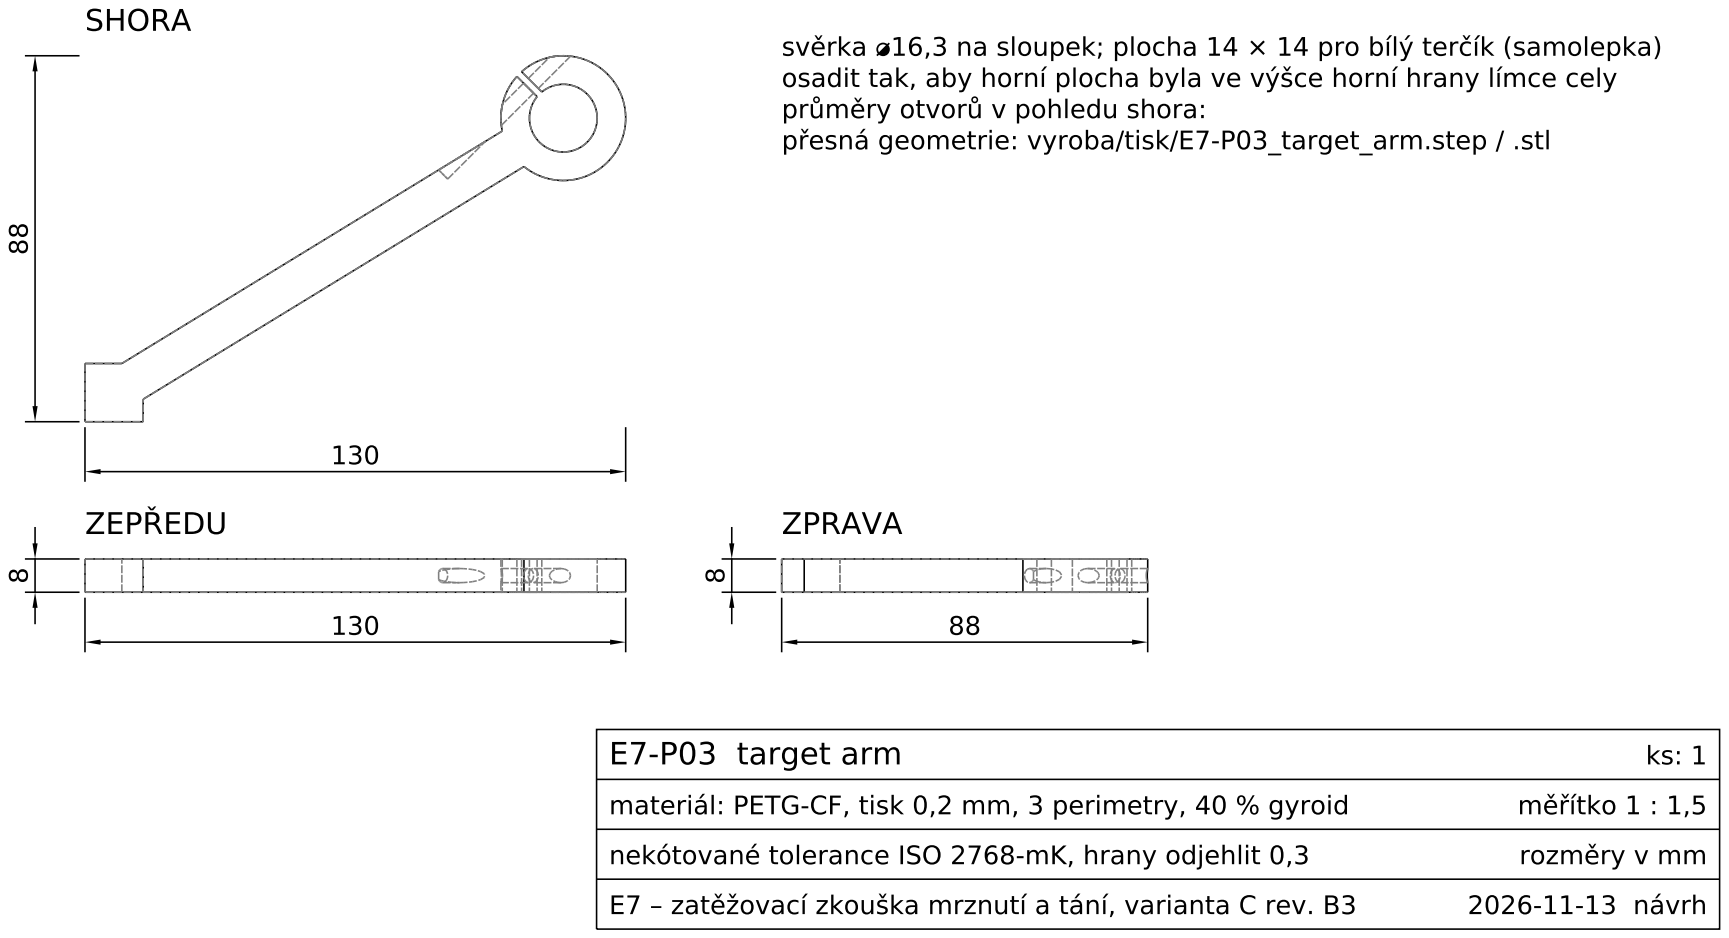
[picture p240: page 15]

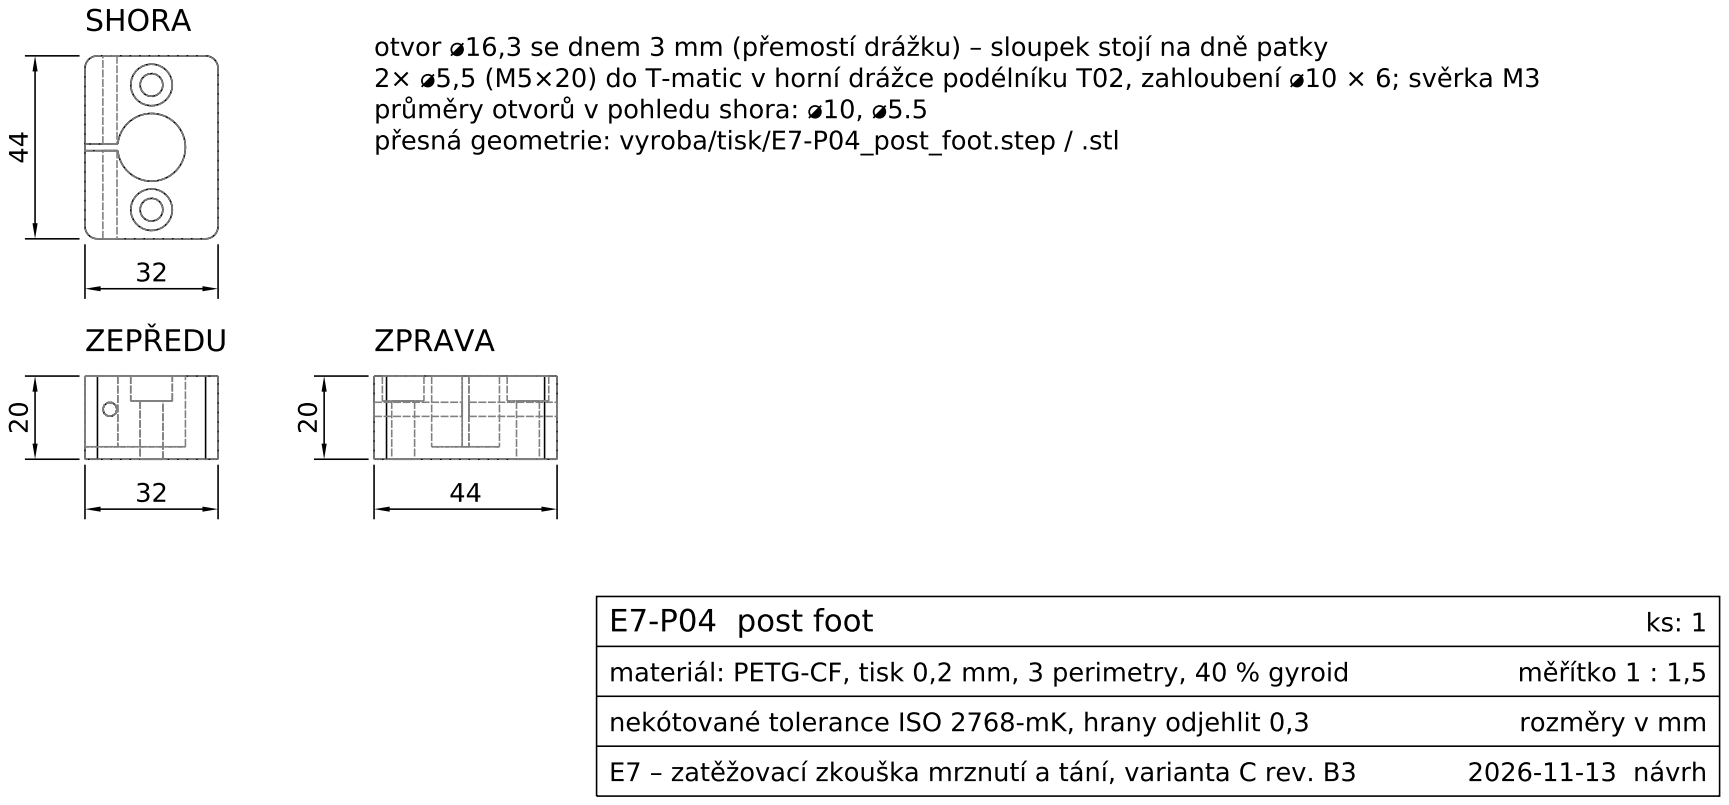
[picture p241: page 16]

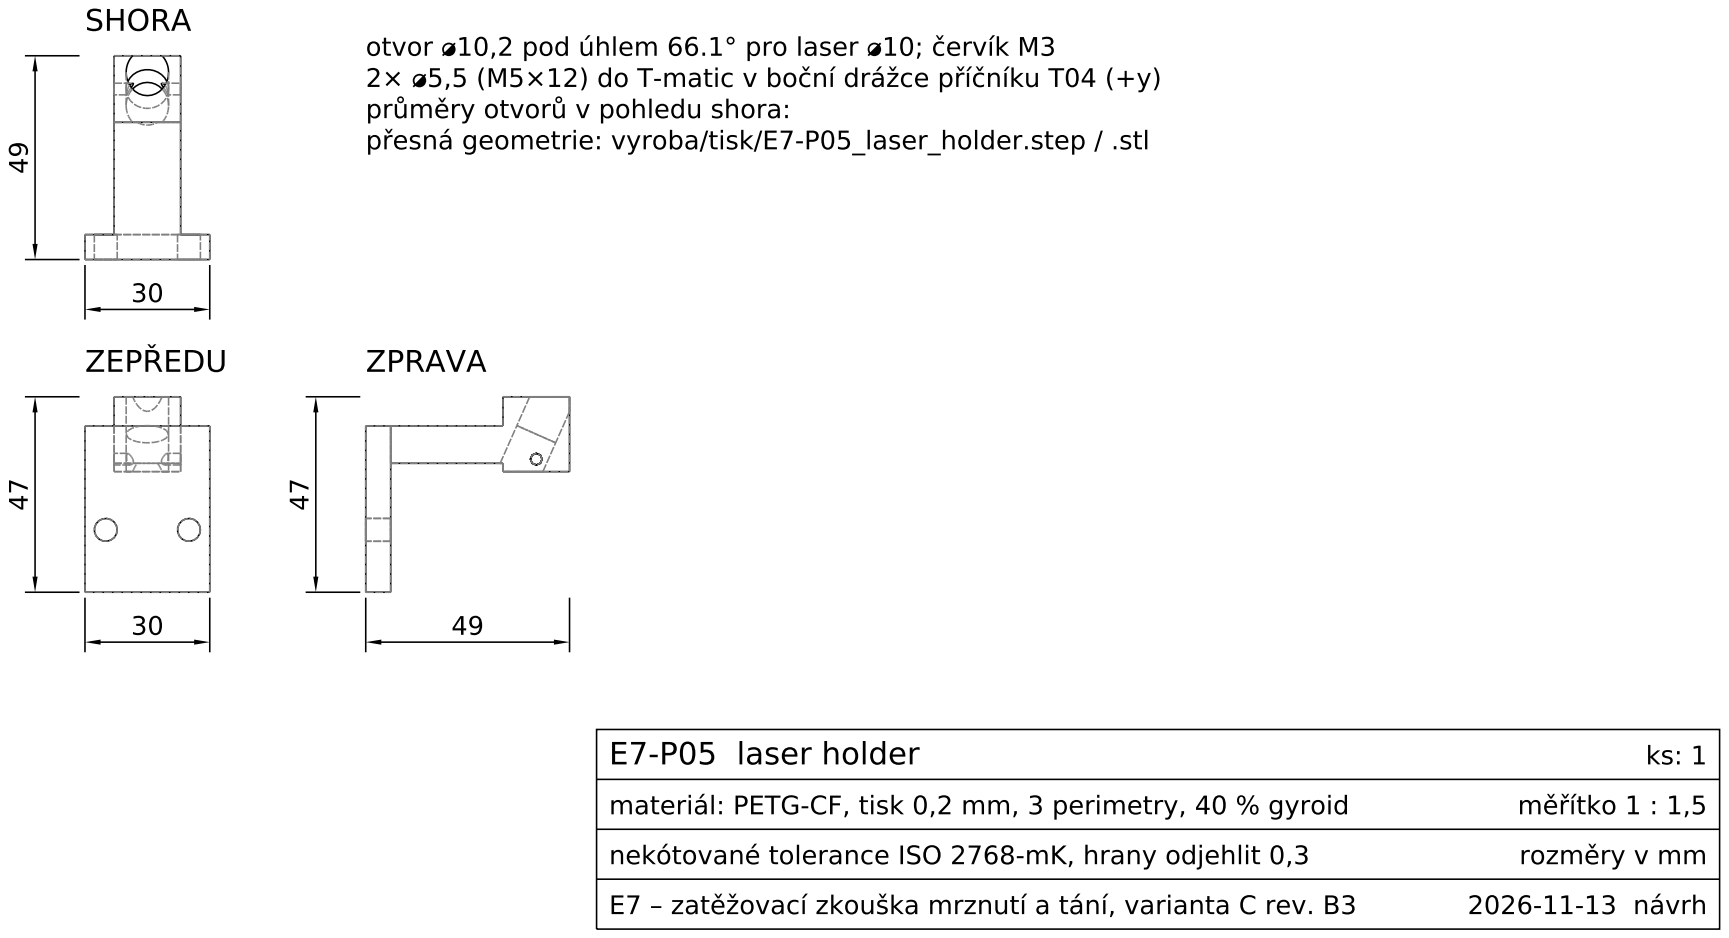
[picture p242: page 17]

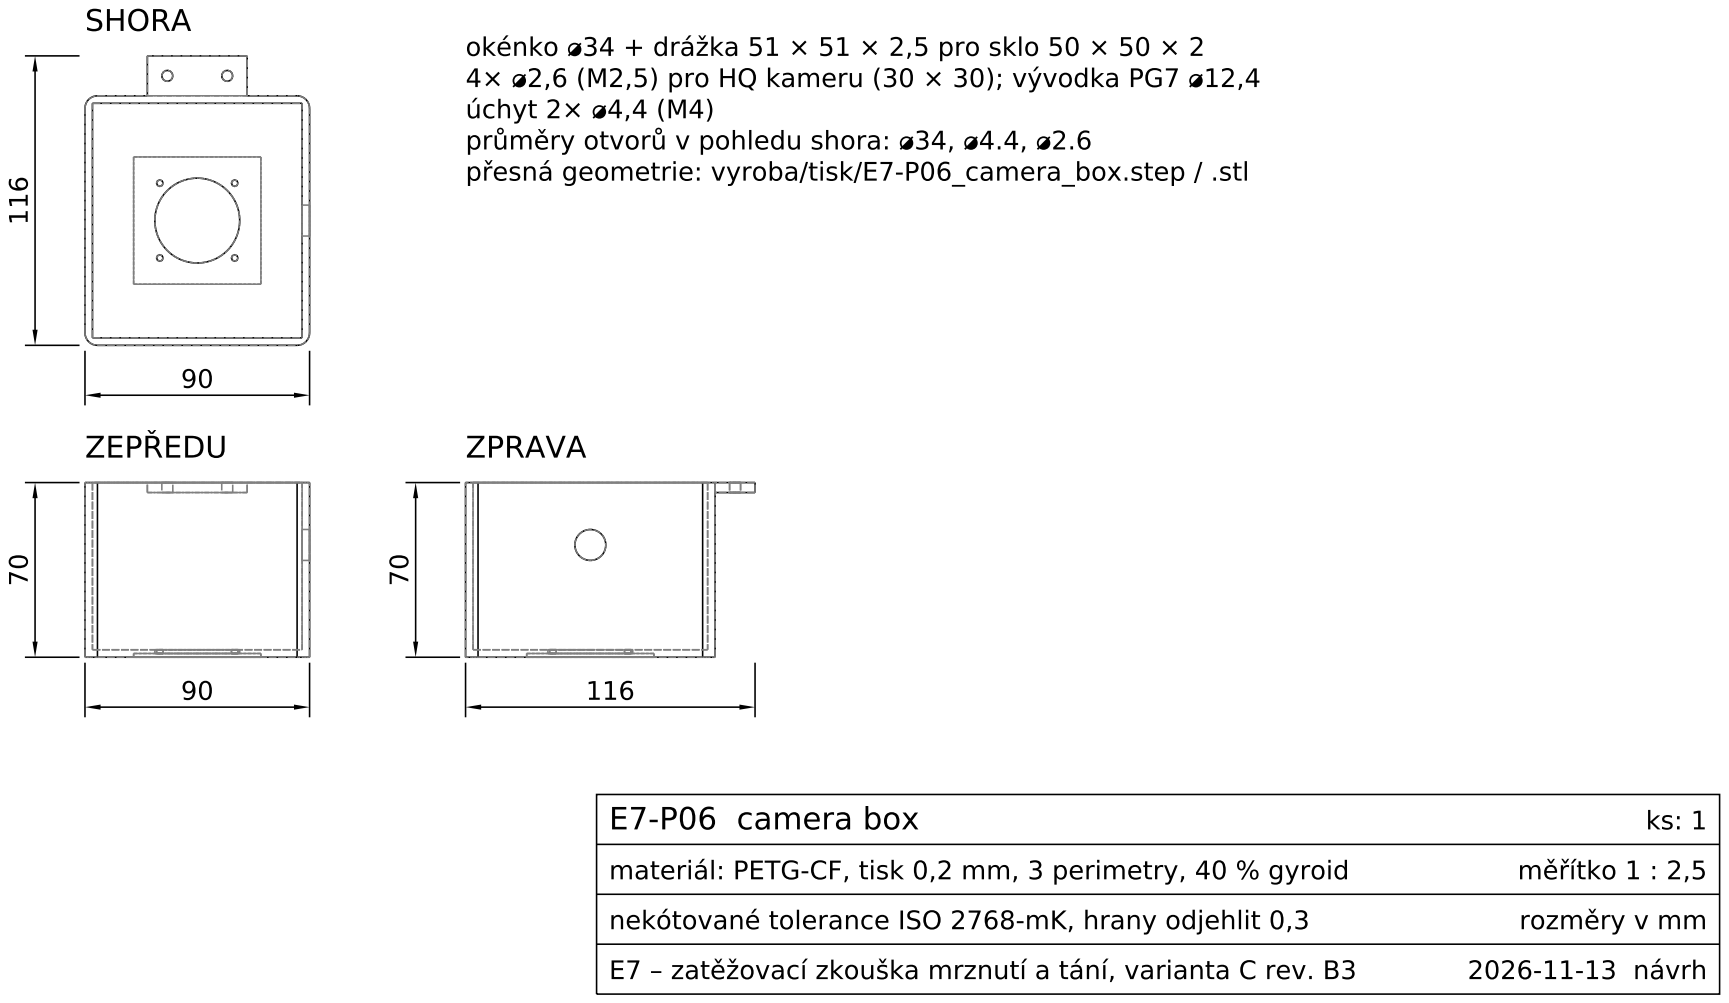
[picture p243: page 18]

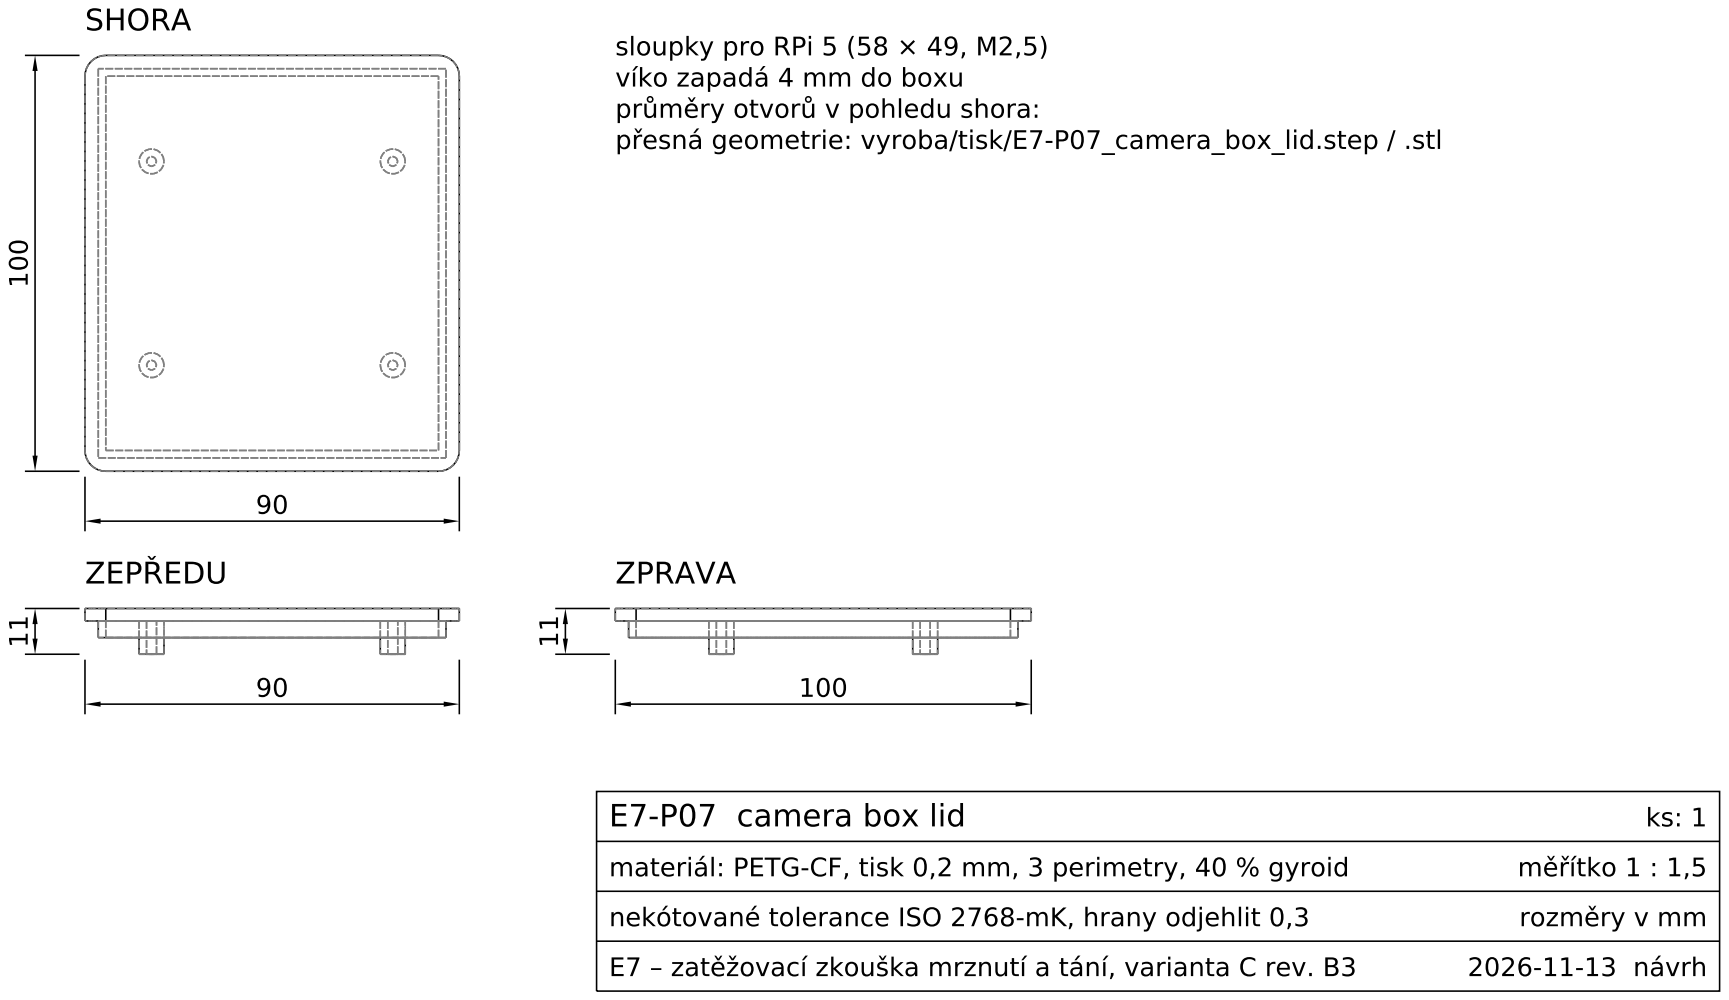
[picture p244: page 19]

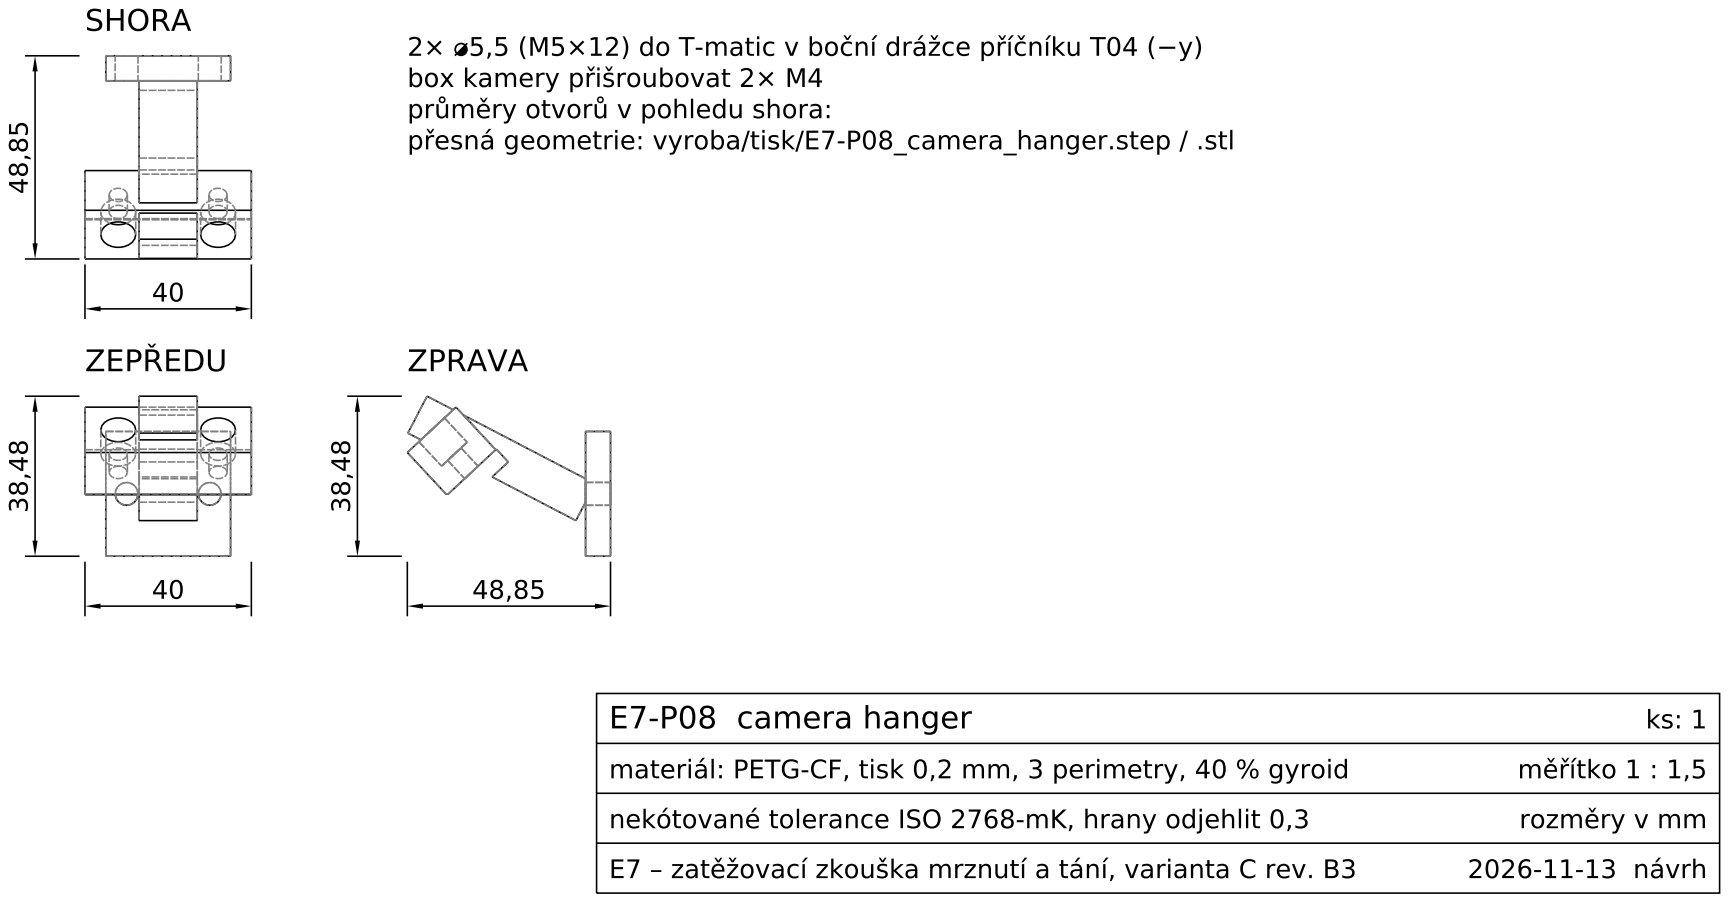
[picture p245: page 20]

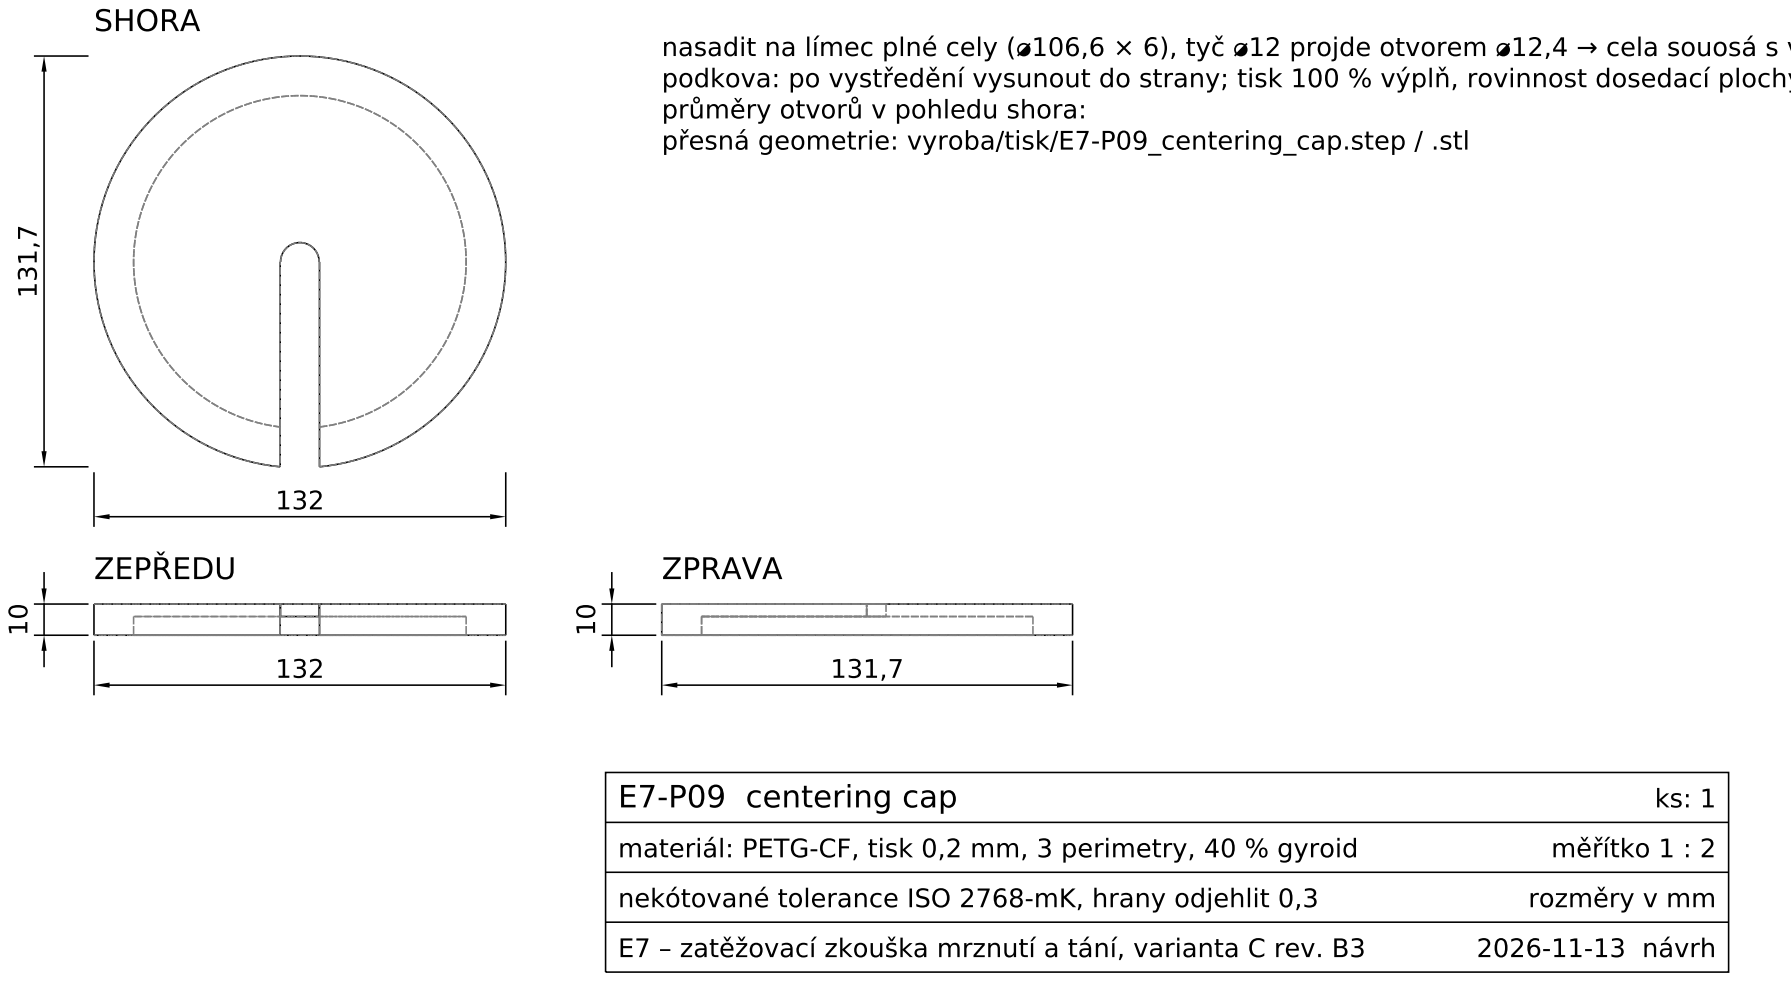
[picture p246: page 21]

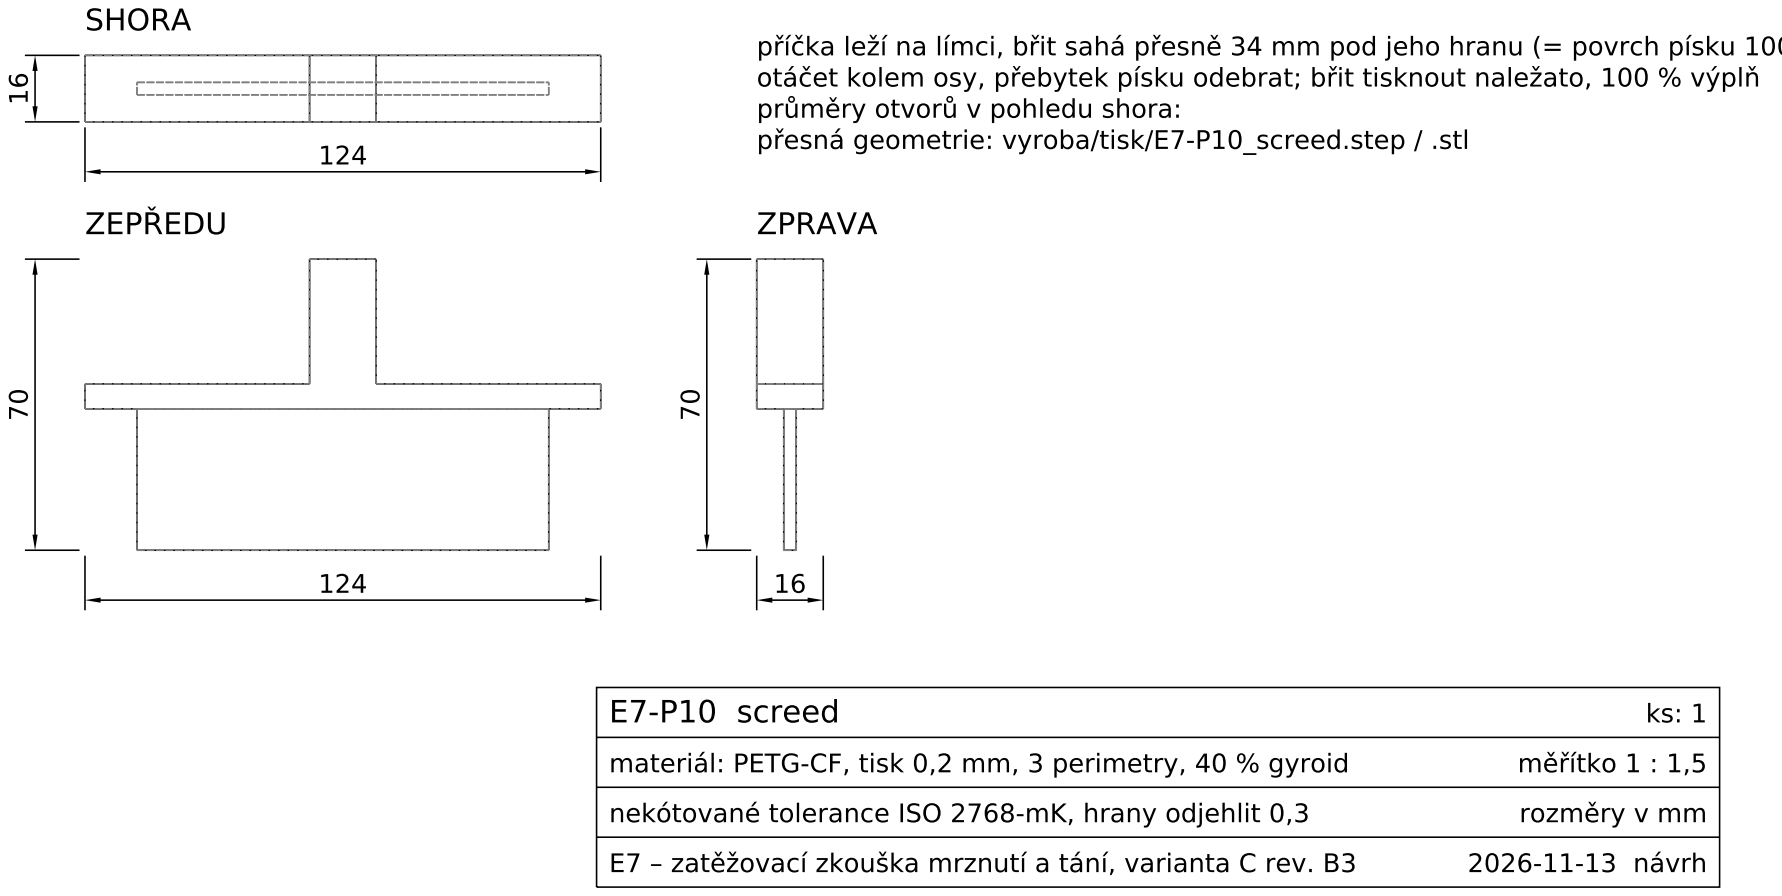
[picture p247: page 22]

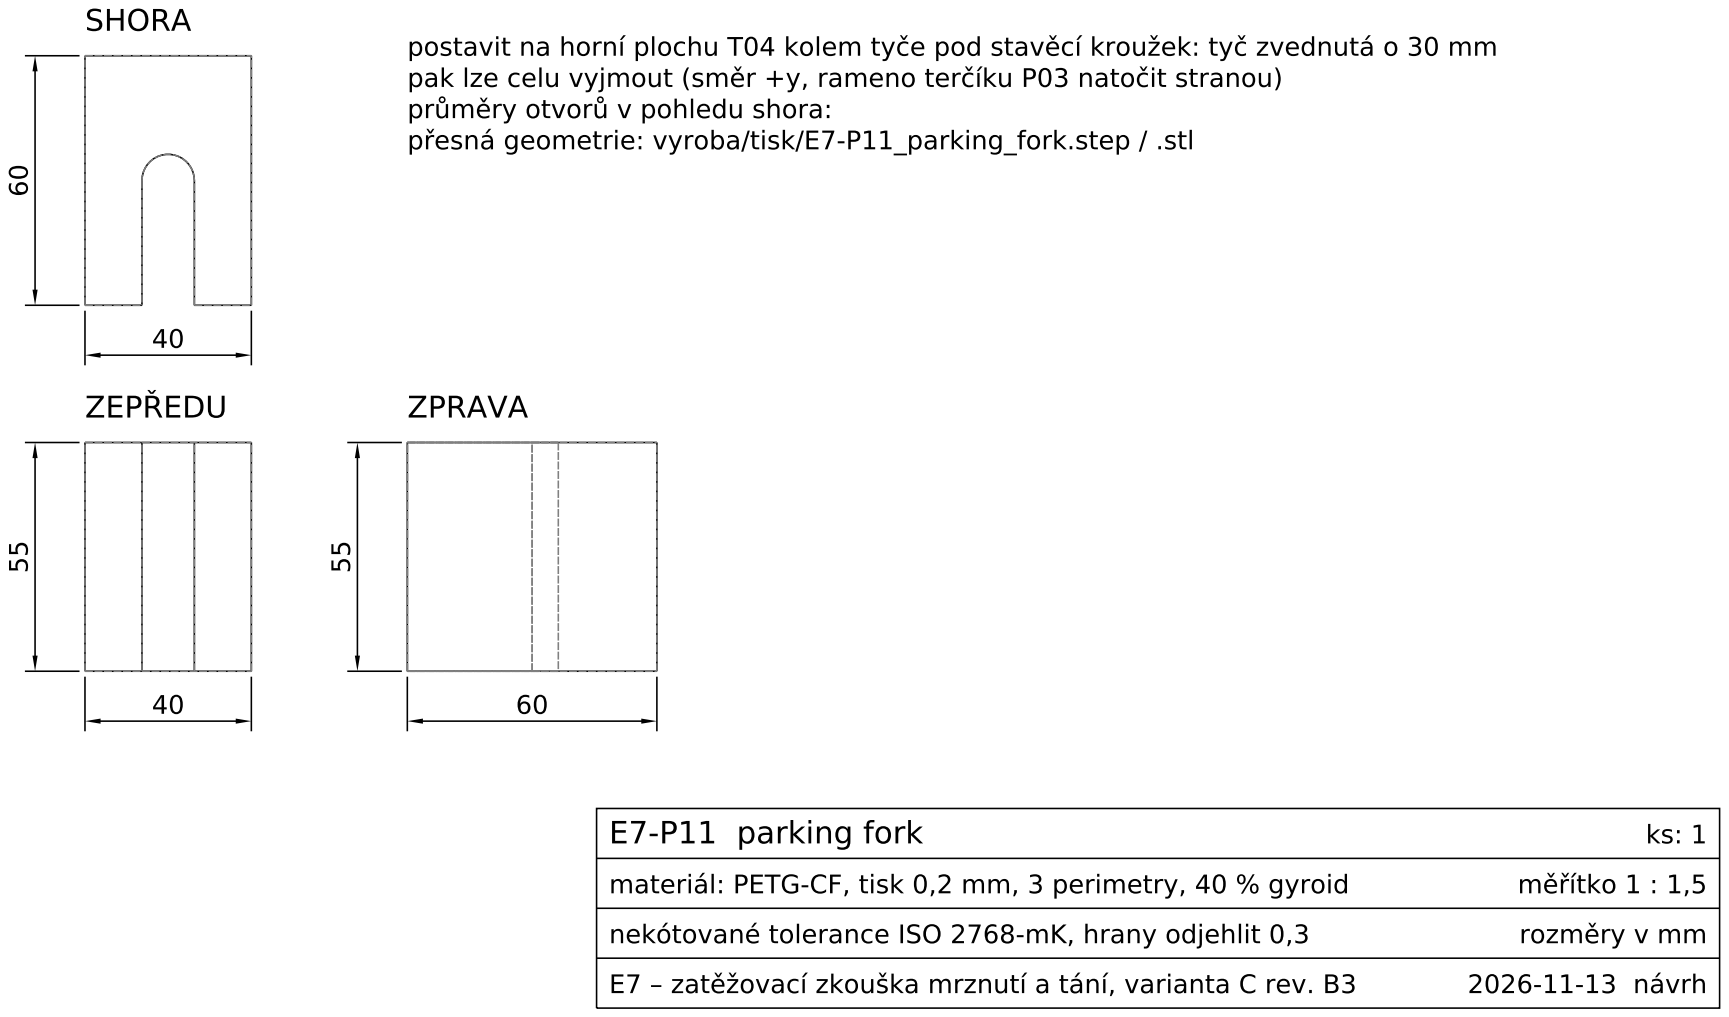
[picture p248: page 23]
