martinasobotkova5/my_data_projects/(commit log)

2026-10-20 Add freezer thermometry design (0.01 °C NTC chain) to E6
    Two new drawings: temperature channels inside and outside a chest
    freezer with a cable collar, and the 1/16" thermistor probe with
    half-bridge circuit, calibration procedure and uncertainty budget.
    Calculations now include bridge sensitivity, self-heating and how fast
    the column warms if infiltration runs outside the freezer.
    Claude-Session: https://claude.ai/code/session_01PcfasqUKmGmfoz8oRsafh3
2026-10-20 Add as-built freezer layout and holder sensor positions from photos
    Two new drawings: the actual chest freezer set-up (tray, printed holder,
    Al top plate, controller) with the proposed changes in red, and the
    sample holder at 1:1 with every temperature, TDR and heat-flux
    position. Estimated dimensions are marked and listed for measurement.
    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
2026-10-20 Switch E6 protocol to freeze-in-freezer, infiltrate-on-bench
    The sample is frozen in the chest freezer and infiltrated after removal.
    Protocol sheet V07 is rewritten for this workflow with a lumped estimate
    of how the sample warms on the bench for three insulation options, and
    new sheet V12 shows the bench set-up (insulation box, Mariotte bottle in
    an ice bath, outflow to vials on ice, logger cart with uninterrupted
    cables).
    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
2026-10-20 Set E6 freezing temperature to −10 °C
    The freezer will run at a constant −10 °C. Initial temperature, unfrozen
    water content, thermistor reference resistor (40 kΩ) and calibration
    range (−12 … +20 °C) follow. The protocol plot now shows −10 °C with −3 °C
    only for comparison, and the bench warming estimate includes the heat
    released by refreezing infiltration water.
    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
2026-10-20 Add E7 freeze–thaw loading test design (constant load / constant height)
    New experiment: Ø100 × 100 mm sample in a 3D-printed PETG-CF cell inside
    an aluminium-profile frame in the chest freezer. Two variants: constant
    load via a 1:10 lever with dead weights, and constant height with top
    and bottom compression load cells. Includes calculations (forces, frame
    stiffness, thermal artefact, cell stresses, load cell range), five A3
    drawings and a literature-based recommendation on load cells and on the
    PETG-CF cell.
    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
2026-10-20 E7: simplified English schemes, compact frames and freezer layout
    Variant schemes A and B are redrawn as simplified, labelled schematics
    with sensor tags. Frames are shortened (330 mm columns, 260 × 200 base)
    so both rigs fit side by side on the tray in the E6 chest freezer, and
    a new sheet shows the layout with the CR1000 outside. Sensor models are
    placeholders until the vendor search is done.
    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
2026-10-20 E7: concrete sensor selection and CR1000 channel plan
    Sensor options from several makers for the 2 kN and 20 kN load cells,
    DC-LVDTs and thermistor probes, filtered for operation at −10 °C, with a
    recommended pick per measurement. New sheet E7-V05 lists the options
    and the CR1000 + AM16/32B wiring for both rigs; the simplified schemes
    show the picked models.
    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
2026-10-20 E7: 3D STEP models of both variants for Onshape
    CadQuery script builds named, coloured STEP assemblies of variant A,
    variant B and both rigs in the chest freezer from params.py, plus STL
    files and shaded PNG previews.
    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
2026-10-20 E7: multi-ring cell in the 3D model
    Ten PETG-CF rings with PTFE washers slide on three guide rods inside a
    greased latex membrane, with thermistor bosses on the rings nearest the
    target depths. Exported alone and as variant A with the multi-ring cell;
    the freezer layout now uses it for rig A.
    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
2026-10-20 E7 variant A: unsaturated sand with surcharge and internal pressure sensors
    Variant A now holds unsaturated sand in the multi-ring cell under a
    constant lever surcharge and measures stresses inside the sample: two
    embedded cells for vertical stress, one for radial stress and three
    wall sensors for lateral stress. Updated in the 2D scheme (with an
    enlarged detail) and in the 3D model, including a cutaway render.
    Sensor models for the pressure cells are still to be filled in.
    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
2026-10-20 E7 variant A: pressure sensor selection (TML PDA-PA) and wiring
    Embedded cells reduced to two small discs (vertical, radial) plus a
    flush base sensor and three wall sensors, following the literature on
    inclusion and arching in small samples. Pressure bridges go through a
    second AM16/32B in 4×16 mode with 2 V excitation; channel plan, sheets
    V01/V05, 3D model and README updated.
    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
2026-10-20 E7: variant A2 – constant surcharge by a pre-compressed spring (no lever)
    Same sand, multi-ring cell and pressure sensors as variant A, but the
    lever is replaced by an ISO 10243 die spring set by a fine-thread screw
    and checked by the load cell. Adds spring sizing to the calculations,
    sheet E7-V07 with a comparison of surcharge methods, a 3D STEP model
    and README section 10.
    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
2026-10-20 E7: remove the lever – variant A uses the spring surcharge only
    The lever-and-weights loading is dropped everywhere. Variant A is now the
    spring-loaded rig (380 mm columns) with unsaturated sand, the multi-ring
    cell and the internal pressure sensors; the separate A2 sheet and 3D
    files are merged into variant A. Freezer layout, frame sheet,
    calculations, 3D models and README are updated accordingly.
    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
2026-10-20 E7: variant A with dead-weight surcharge up to 25 kPa
    Replace spring + load cell with steel discs on a guided carrier plate,
    light 40x40 frame, LVDTs at ±y; update drawings, 3D, calculations, README.
    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
2026-10-20 E7: variant B redesigned – same sand sample without load, heave and layer strain
    Free-core LVDTs on a light top plate (S1–S3) and on settlement anchors at
    25/50/75 mm (E1–E3), Invar stand instead of the loaded frame, no load cells.
    Updated drawings V02–V06, 3D model + section render, calculations, sensors, README.
    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
2026-10-20 E7: solid 3D-printed PETG-CF cell instead of the multi-ring cell (both variants)
    One-piece cell with PTFE liner + grease, printed bosses for thermistors and
    PW holders, Kaiflex 25; wall-friction (Janssen) check added to calculations.
    Updated drawings V01–V03, 3D models (E7_cell replaces E7_multiring_cell), README.
    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
2026-10-20 E7: point M – TDR, Pt100 and optical (FBG) sensor co-located in both variants
    One printed wall boss at depth 54 mm / 108°: 3-rod mini TDR (40 mm), Pt100 1/10 DIN
    and FBG side by side (±12 mm). Thermistor tips moved to r 40. Drawings (detail M),
    3D models, CR1000 plan (TDR200 on SDM, Pt100 via 4WPB100), calculations, README.
    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
2026-10-21 E7: variant A-min – maximally simplified variant A with sensor types and prices
    No frame (discs on a threaded rod in the piston, guided by the cell), 2 pressure
    cells, 2 thermistors + air, point M, 1 LVDT, no multiplexers. New sheet E7-V07,
    3D model, stability and cost section in calculations, README price table.
    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
2026-10-21 E7: A-min with a fixed lid instead of dead weight; own TDR/temperature/fibre not priced
    Steel lid on 3 stainless M10 tie rods, piston seated by a centre screw M16x1.5 and
    locked – the sample cannot move. Stiffness and thermal check in vypocty §9,
    PDA-PA 500 kPa, updated sheet V07, 3D model and README price table.
    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
2026-10-21 E7: variant A-frame – fixed piston held by an Al profile frame
    Same sample, cell and sensors as A-min; 2 columns 40x80 + cross-beam 80x80,
    screw M16x1.5, Al spacer with POM-C thermal-compensation insert. New sheet E7-V08,
    3D model, stiffness/thermal/cost section (vypocty §10) and README section 1b.
    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
2026-10-21 E7: larger fonts on sheet E7-V08 (A-frame)
    Font sizes raised from 7/6 pt to 9.5/8.5 pt on V08 via a temporary override;
    table font now follows the current size; layout adjusted.
    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
2026-10-21 E7 variant A: printed cell per drawing Column_one_body_version_1, larger fonts
    Cell body D160 x 130 with collar D106 to 160, cavity D100, bottom 26, side port
    13 wide (67.5-94.5); point M per the sketch: CS645 through the port, optical fibre,
    vertical Pt100. PV1 moved to depth 75, no G10/Kaiflex, tie rods at r 92, POM 8 mm.
    New sheet E7-V09, larger fonts on V07/V08, 3D models, calculations §11, README 1c.
    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
2026-10-21 E7 variant B: printed cell D160 and point M as in variant A
    B now uses the Column_one_body cell on a 20 mm Al plate, CS645 + fibre + vertical
    Pt100 at point M; anchors moved to 150/30/210 deg and surface LVDTs to 0/120/240 deg
    to clear the TDR rods (3D clash check); wall pressure cells dropped; Invar posts 196 mm,
    reference error ~40 um/20 K. Sheet E7-V02 redrawn with larger fonts, 3D, README.
    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
2026-10-21 E7: variant B-open – simplest setup with an open sand surface
    Printed cell on a 220 mm Al plate, point M with existing sensors, one free-core LVDT
    on a 30 mm target with an Invar post; no lid, plate, anchors or bridge.
    New sheet E7-V10, calculations §12 (load, reference error, drying), README 5a.
    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
2026-10-21 E7 B-open: camera instead of LVDT and Invar post
    Marker on a rod from a 30 mm surface target, two reference marks on the collar rim,
    Raspberry Pi HQ camera in a heated box on the base plate. Sheet E7-V10 redrawn,
    calculations §13 (resolution, rim thermal motion, cost), README 5a incl. DIC option.
    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
2026-10-21 E7 drawings: remove the outer black sheet frame
    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
2026-10-21 E7 B-open: nothing on the sand – camera from above + 45° line laser
    Laser triangulation of the whole surface profile, collar rim as in-image reference.
    Sheet E7-V10 redrawn, calculations §13 and README 5a updated.
    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
2026-10-21 E7: CS645 head fills the side port, rods centred in it (depths 36/45/54)
    The head was drawn 4 mm above the top rod, i.e. above the port; the sketch's 66 mm is
    the top of the port/head, not the top rod. Fixed in V07–V10, 3D model and README.
    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
2026-10-21 E7 drawings: one consistent set V01–V08 for the current design
    New V01 overview (A fixed / B open), V07 sensors + CR1000 channel plan (existing CS645,
    Pt100, fibre; PV1/PB1, LVDT; camera + laser), V08 freezer layout with both rigs.
    Obsolete sheets (dead-weight A, old cell, old frame) removed, the rest renumbered;
    rig drawings factored into draw_a_frame/draw_b_open; README references updated.
    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
2026-10-21 E7 3D: models matching sheets V02–V08, B-open model, per-part STEP for Onshape
    New variant_b_open (camera box, arm, line laser), freezer layout with A-frame + B-open,
    per-part STEP export for V03 and V06, files renamed E7_V0x_*, obsolete 3D removed,
    README §9 with Onshape import and drawing steps.
    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
2026-10-21 E7 3D: spacer and POM part names from parameters
    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
2026-10-23 E7: CAD drawing (DXF) of the printed cell with all dimensions
    src/cad_cell.py writes cad/E7_V04_cell.dxf: section along the TDR axis, plan and
    port view with real DXF dimension entities, layers for outline/dims/sensors,
    A3 frame + title block at 1:1.5; PDF/PNG preview.
    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
2026-10-23 E7 cell DXF: black dimensions, ISO text sizes (3.5 mm dims, 5 mm headings on A3)
    Dimension/text/outline layers in true black, dim colours ByLayer, line weights,
    decimal comma; label positions adjusted so nothing overlaps.
    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
2026-10-26 E7: variant C – A frame + B camera combined, constant dead weight on a partial piston
    Frame only guides (LM12UU bushing) a dead weight on a 50 mm partial piston that moves
    freely up and down with the surface; free annulus around it; camera + 45° line laser
    measure heave of the loaded and the free surface in one image. Sheet E7-V09, 3D model
    + parts, calculations §14, README 1d.
    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
2026-10-26 E7 V09: unframed labels and larger font (11.5/10.5 pt), shorter label texts
    TAG_BOX switch for leader labels; title block font capped so larger sheet fonts
    do not overflow it; left labels moved clear of the height dimension.
    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
2026-10-26 E7: drawing set redone for variant C with deformation measurement (1) + (2) only
    New vykresy_c.py: V01 rig C, V02 measurement (camera + 11-line laser for a height map
    of the whole surface, LVDT on the load, evaluation, procedure), V03 cell with point M,
    V04 sensors/CR1000/costs, V05 freezer layout. No pressure cells; Pt100 moved off the
    laser lines. Earlier A/B sheets and 3D models moved to archiv/. README and calcs updated.
    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
2026-10-26 E7: animated 3D model of freezing and thawing (variant C) with axisymmetric heat-conduction simulation
    src/sim_thaw.py computes temperature, ice fraction and in-situ heave for
    the sample in the printed cell with the partial Al piston; web/E7_thaw_3d.html
    (three.js) shows the section, the partly visible surface around the piston,
    the 0 °C front, laser lines, camera view and temperature/heave charts.
    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
2026-10-26 E7 variant C: concrete sensors, manufacturers, prices and suppliers (nakup_cidel.md, sheet V04)
    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
2026-10-27 E7 variant C rev. B per measurement review: insulated cell, Invar LVDT post and guide rod, 68° laser, RPi in camera box
    - sim_thaw.py: XPS sleeve/base, freeze pattern, rig thermal drift (LVDT Al vs Invar, camera rim vs Invar target)
    - drawings V01–V05, STEP/STL, 3D model with drift chart and heave scenarios updated
    - purchase lists (EN/CZ), calculations §15, one-page review E7_review.html/.pdf, offline package
    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
2026-10-27 E7 rev. B: cell printed in one piece D240x200 with integral low-infill insulation (replaces XPS)
    - core Column_one_body_version_1 + 40 mm gyroid wall and base, 3 G10 pads in base pockets (r 35)
    - V01/V03/V05, DXF cell drawing, STEP/STL, 3D model, simulation (lambda 0.06), review, purchase lists updated
    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
2026-10-27 E7 rev. B: Pt100 from the port side, centred directly on top of the top CS645 rod (surface left free)
    Drawings V01–V03, DXF (section, plan, port view with Pt100 hole), STEP, simulation point M and 3D model updated.
    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
2026-10-27 E7 rev. B2: orderable rig without machining – laser-cut plates/weights (DXF), printed brackets (STL), order list by Czech shops
    - buildparts.py: laser parts L01–L07 (DXF+STEP), printed parts P01–P08 (STL+STEP), levels and cut lengths
    - top plate + printed bearing housing replace the 80x80 beam; base plate 10 mm with slots; piston from 2 laser discs
    - collision-checked assembly in model3d; sheet V06 (parts for manufacture); objednavka.md (shops, quantities, assembly)
    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
2026-11-04 E7 order list: Czech companies / representatives for camera, laser and LVDT
    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
2026-11-09 E7 rev. B3: whole frame from T-slot profiles (slot 8)
    - base: 2 rails 40x40 + cross bar 40x80 under the G10 pads; columns 40x80;
    top beam 40x80 with one D14 hole, bearing housing hangs below it
    - laser-cut base/top plates L01/L02 dropped; T01-T04 production drawings
    - camera mount trimmed to clear the camera box (no collisions, 56 parts)
    - drawings V01, V02, V05, V06, order list, docs, 3D page and package updated
    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
2026-11-09 E7: sample Sr = 0.5, Pt100 tip 30 mm from the wall, recommended suppliers
    - params: SR_TARGET 0.5, POROSITY 0.38 (theta 0.19); Pt100 axis +3.5 over the top
    TDR rod and tip 30 mm from the wall confirmed
    - thaw model rerun: 95 % frozen in 15 h, thaw 15 h (24 h + 24 h cycle still fits),
    heave upper bound 1.7 mm, drift residuals unchanged (LVDT <= 6 um, camera <= 3 um)
    - review, overview, calculations (sections 15, 16), purchase lists and drawings updated
    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
2026-11-09 E7 order list: Czech suppliers for Invar, igus, laser and LVDT
    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
2026-11-09 E7: laser inquiries for TME and Picotronic
    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
2026-11-09 E7: e-mail addresses for the laser inquiries
    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
2026-11-09 E7: laser inquiry for LASER COMPONENTS (manufacturer of FLEXPOINT)
    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
2026-11-09 E7: frame statics (rails 320, feet ±140), CR850 channel plan, sample aids P09-P11, test procedure, frame inquiry (ENPRAG)
    - vypocty §17: stresses < 10 MPa, deflections µm; tipping governs -> rails 320 mm, feet ±140
    - vypocty §18 + V04: CR850 (C1-C4): photo trigger on C4, LVDT differential, supplies always on
    - P09 centering cap, P10 screed, P11 parking fork; cell removed towards +y (checked in 3D)
    - postup_zkousky.md: risks and procedure (compaction outside the rig, sensors inserted after
    compaction, witness dish instead of weighing the cell each cycle)
    - poptavka_ramu.md: cut list T01-T04 + all fasteners for ENPRAG (Praha)
    Clau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
2026-11-09 E7: CR850 + AM16/32B multiplexer channel plan
    - MUX RES on C4, CLK on VX1 (C1-C3 stay SDM for the TDR); RPi photos on NTP clock
    - MUX channels: Tair, air at surface, cell base and wall, Invar post, beams (drift
    correction), optional 4-probe temperature profile in the sand
    - V04, vypocty §18, order list (NTC thermistors), procedure, review updated
    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
2026-11-13 E7: laser geometry from the Picotronic quote (DOE253: 3.1 deg / 31 deg fan)
    - laser moved beside the top beam: 81 mm from the axis, 183 mm above the sand,
    66 deg, 200 mm to the surface -> lines 111 mm long, 11.9 mm apart over the whole D100
    - holder P05 redesigned (block outside the carrier radius); no collisions
    - recommended DOE253-635-5-6(10x24): 5 mW, adjustable focus (quote A2627918)
    - V01, V02, vypocty §19, order and purchase lists, review, overview updated
    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
2026-11-13 E7: laser wiring (RPi 5 V, MOSFET on GPIO17), cable routing and focusing
    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
2026-11-13 E7: literature notes – deformation of soil cylinders during freezing and thawing
    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
